Lucian-ming/smart-fans/artifacts/mechanical_joint_review.md

# 实物模块—PCB—三件罩壳联合审计

**结论：不能确认现有完整罩壳能容纳并正常连接全部清单实物；当前仅裸板/局部几何合格，禁止把它作为满载装配通过或直接量产依据。** 本次只读生产源与产物，新增审计脚本/数据/本报告，没有修改两生成器。2026-11-04。

## 1. 证据与复算边界

- 实物依据：[用户清单](<../docs/hardware/user_modules.md>)，不是凭网络同名模块补齐尺寸。已读关联[引脚表](<../docs/hardware/pinmap.md>)、[BOM](<../docs/hardware/bom.md>)、[旧外壳文档](<../docs/mechanical/casing-design.md>)、[旧装配规范](<../mechanical/drawings/assembly_spec.md>)。
- 当前真值：[PCB生成器](<../tools/build_perfect_revB_v3.py>)、[机械生成器](<../tools/build_authentic_smartfan_cad.py>)、[实际PCB](<../hardware/kicad/fan_ctrl_revB.kicad_pcb>)及三个最新STL。未导入/执行生产生成器。
- [只读审计脚本](<audit_mechanical_joint.py>)通过sexpdata解析实际PCB全部47器件并断言其坐标与生成器一致；trimesh独立读取三件STL、射线净空及支架旋转半径。已成功运行，exit 0仅表示审计计算完成，**不是装配PASS**。[完整数值及SHA256](<mechanical_joint_review_data.json>)。
- 坐标均为壳体装配坐标：PCB局部坐标+（2,2），主板底Z6.5、顶Z8.1。STL下壳Z0..9、盖Z8.1..32；支架仍局部坐标Z0..24，没有定义其在整机上的刚体变换。
- [下壳](<../mechanical/stl/print/SmartFan_Piece1_Base_Enclosure.stl>)24.369847394cm³、[盖](<../mechanical/stl/print/SmartFan_Piece3_Removable_Lid.stl>)27.979158745cm³、[支架](<../mechanical/stl/print/SmartFan_Piece2_Fan_Gimbal_Bracket.stl>)16.621909456cm³，合计68.970915595cm³；均水密。**拓扑和材积不证明内部实物配合。**

## 2. 已确认的规格/设计矛盾（优先解决）

1. **TB6612供电与资产清单不一致**：清单写VM12V、VCC5V，而实际J_TB_R pin1=+5V，pin2=+3.3V；C_VM也在+5V。它可能是另一套低压130方案，但不能声称满足用户当前12V描述。先确认电机铭牌和驱动板型号，不能仅依据“130”推定额定电压。
2. **连续舵机不等于位置舵机**：清单明确MG90S 360°连续旋转、PWM控制速度；旧引脚表却宣称0°~90°位置扫风。当前没有位置反馈、限位或滑环证据；依定时正反转不能保证长期角度边界，可能绞线。必须选择位置型或补反馈/限位方案。
3. **12025备选不适用当前支架**：当前只有20.4×15.4的130腔、3mm出轴孔、84×30支架，没有12025四孔框架。旧六件规范中的12025支架不属于当前三件，不能混用。
4. **USB不在后壳开口附近**：BluePill双排座中心(49.5,42)，按53.3×22.8居中名义包络，板Y15.35..68.65、X38.1..60.9。后板缘距内后壁13.75mm；后USB孔中心(49.5,1,8)，高范围Z4.75..11.25。主板顶已Z8.1，上面还有排母、子板、USB座。没有连接器相对板缘位置、堆叠高度、USB延长线/面板座证据，不能把该孔称为可插拔的真实USB通道。
5. **舵机与BluePill投影重叠**：舵机槽X37.9..61.1、Y28.7..41.3，几乎完全覆盖上述BluePill板宽，Y也在其板上。只有上下分层可能避碰；当前未给舵机安装耳→底部/轴顶及BluePill最高元件Z，故不能确认无干涉。槽切到Z24只是切削体，不是舵机只下探到24的证据。
6. **按钮15mm高度没有确定装配基准**：要求直插排母的子模块PCB底一般高于主板顶，不能无依据令其等于Z8.1。当前1.35mm露出仅是在模块底恰好Z8.1且竖直轴、孔中心这一条件下成立。

## 3. 插座、模块包络与净空逐项

|模块|有依据的尺寸/实际接口（壳坐标）|判定及缺少证据|
|---|---|---|
|BluePill|清单约53.3×22.8；2×20针，pitch2.54、排距15.24；实际座X41.88/57.12，Y42中心，沿Y跨48.26|针距/排距符合清单，但板边到首针、USB位置和堆叠高度未知。条件居中前角(60.9,68.65)盖内面Z22.428146，相对母板顶只剩14.328146mm给排母+子板+最高件；后部净高21.9mm。舵机重叠优先核查。|
|ASR-PRO|清单30×28×2.9、2×7P；实际座X72.88/88.12、Y27.5，排距15.24，沿Y针跨度15.24|清单未提供排距和首针到板边，30×28不证明15.24排距正确。若长边沿X居中则X65.5..95.5、距右内壁仅1.9mm；若沿Y则不同。中心盖内面Z30，名义净高21.9；2.9是否含最高元件/针头未知。SPK/MIC插座在右侧，须检查线插头与子板叠层。|
|PAJ7620|清单20×15、5针2.54；J_GESTURE中心(18,76)，1..5=3V3/GND/SCL/SDA/INT；窗中心也(18,76)|电气次序符合清单（以编号为序，不证明实物正反方向）。排针通常在模块边，不等于光学透镜中心；尚无针排→镜头偏移。只有20×15平面轮廓不足以证明镜头正对孔或不被壁遮光；没有支撑/固定点。|
|DHT11|3针，实际(17.5,57)，3V3/DATA/GND|尺寸/高度未知；该点盖内Z27.860630，净高19.760630。壳未为其设置专门通风/热隔离结构，封壳内部测温不等于环境温度；与降压/电机热源耦合需验证。|
|OLED|仅0.96英寸和4针，没有模块外形/玻璃/针排相对有效显示区尺寸；座(80.5,57)，GND/3V3/SCL/SDA|实际窗中心(80.5,64)，投影相差Y7mm；不能据同名尺寸认定有效区对正。需要模块定位支架、连线与安装角，详见下一节。|
|EC11|清单只有5P次序；座(73,84.5)，GND/3V3/SW/B/A；孔中心(73,88)|电气次序符合清单，轴与针排须实际Y偏移3.5mm才按中心投影对准；模块宽高、轴长/径、螺纹肩、螺母、旋钮帽均未知。|
|KEY1/2|用户只提供模块底→帽顶15mm；座(36/51.5,84.5)，GND/SIG/3V3；孔(36/51.5,86)|需要帽中心距排针1.5mm的实际偏移、帽径、行程和模块高度基准。清单允许2P/3P，但主板是3P，不能任意插2P而不核对顺序。|
|TB6612|仅双8P；实际X9.88/25.12、Y38，排距15.24、针跨度17.78|清单未给模块外形和排距；“SparkFun/CJMCU”注释不能证明用户变体一致。需实物针序/机械图，并解决5V/12V矛盾。|
|喇叭/咪头|8Ω2W不等于外形；SPK1(92,16.5)，MIC1(92,22)|咪头孔在(92,88)，不是插座正上方，必须线接并固定；无咪头支架。喇叭无腔体尺寸、固定仓和专用导音口，不能核容纳或声学性能。|
|NTC/DS18B20备选|清单写兼容3P|当前未见专用该位号插座；J_DHT11是数字DATA和3V3/GND，不能自动认作NTC模拟输入。选定后核针序/电路/固件。|

### DC与线插拔

- DC1实际封装原点(17,10)，后壁圆孔中心X17、Z10、直径8.2；**X一致不证明接口轴高一致**。PCB用手写3个圆焊盘，且“标准模型引用”没有模型实际装配尺寸证据；须核DC-005实际脚位、轴高、插头肩部外径、伸出/缩入量。
- XH插座SPK1/MIC1中心仅相距5.5mm；针排各跨2.54，最近相邻针间2.96mm。塑壳宽、锁扣和拔插手指空间未建模，不能依据焊盘不碰就判插座不碰。MOTO1与SERVO1等同理。BOM的SERVO弯针与footprint Vertical亦未自洽。
- 盖闭合后模块垂直拔出路径会被盖阻挡，这通常允许“先拆盖再拔模块”，但仍须验证已插线、线束弯曲半径、盖提起行程、四颗长螺钉工具通道；现有裸板扫掠不能覆盖这些。
- 两排母仅用标准PinHeader模型引用、原点/居中针排也不同于标准库的首针原点习惯；不能用当前3D引用当完整实物封装。没有可复用的精确实物STEP装配。

## 4. 25°坡面与竖直安装不是同一种方向

- 主坡外面z=31−tan25°(y−55)，2mm为法向厚度。OLED窗中心Z26.803231；EC11孔中心Z15.611847；孔沿13.731074mm是塑料孔沿，不是OLED模块到旋钮帽的距离。
- OLED窗按坡面法向切削，若显示模块水平直插，显示面并不平行窗面；若显示板跟随25°坡面，直排针无法无转接直接垂直插母板。必须选择倾斜安装支架+软线/转接，或提供弯针详细几何。窗口宽28、面内高16.5不代表任意0.96英寸模块全外形能穿过。
- EC11孔轴按坡面法向倾斜25°，而水平子板上的旋钮轴可能竖直。穿过法向2mm壁时斜孔上下边横向漂移约2sin25°=0.845mm，不能只拿孔9mm与轴径比较；轴、套筒、螺母面和旋钮下缘必须做实体干涉。其竖直轴若正好穿外面中心，内层中心投影并不相同。
- 按钮孔已改竖直、局部坡面中心Z21.75。假设帽顶水平Z23.1，仅孔中心露出1.35；对半径r的平帽，其两侧露出范围为1.35±r·tan25°。例如**仅用于说明、不是实物尺寸**若r=3.5mm，范围约−0.282..2.982mm，不能宣称整帽都露出1.2..1.5mm。必须给帽径、肩部、行程与想采用的露出量定义。

## 5. 支架与旋转运动包络

- 独立读取支架网格，以十字槽中心局部(42,15)为假设转轴：打印件本体全转最大半径44.598206mm、回转直径89.196412mm。若（仍是假设）轴恰在顶槽中心(49.5,35)，360°XY包络为X4.901794..94.098206、Y−9.598206..79.598206；会越过壳后缘约9.60mm。**越过投影不直接等于碰撞**，须结合真实轴顶Z与壳、USB/DC插线位置。
- MG90S输出轴通常不应无证据假定在壳体几何中心，当前未给轴偏心、舵盘厚度、齿数/花键与锁螺钉；没有支架整机Z与角度变换，故无法做真实旋转碰撞测试。
- 上述半径只含打印件，不含电机、扇叶、护网、导线和旋钮。未给扇叶直径、轴伸出和旋转平面，不可宣称安全无干涉；也没有手指防护罩与动态载荷验证。
- 当前电机仓截面20.4×15.4、切削深25，出轴中心局部(42,27,15)、孔3mm；“130”只是系列外形称呼，不证明端盖、接线片、轴长相符。十字槽残底0.5mm、无强度定级，且电机夹持/止退方案未完成。

## 6. 最少需要用户补充的六组问题

可用**实物正反/侧面带尺照片 + 商家准确链接**一次性答复；无需逐个手抄全部尺寸。只有链接而变体不明仍需量关键尺寸。

1. **最终动力方案**：到底130还是12025？电机额定电压、机身和轴伸出、扇叶直径/护网尺寸；MG90S是可定位角度型还是已确认360连续型，是否接受更换位置型或增加反馈？
2. **所有直插子板的实际针排基准**：BluePill、ASR-PRO、TB6612的准确型号/正反面针序、板长宽、排距、首针距板边；母座型号/插合后子板底到主板顶高度（一次侧面照片可覆盖多个）。ASR的2.9mm是否为全高？
3. **OLED、EC11、PAJ的正侧面**：针排到屏有效区中心/编码器轴/光学镜头中心的XY偏移；模块外形和最高件；OLED希望贴25°坡面还是水平直插；EC11轴径/轴长、螺纹肩与旋钮帽直径/高。
4. **两个按钮**：2P还是3P及针序，模块长宽、帽直径/中心到针排距离、行程；15mm的两测量端点照片，插好后模块底实际Z。确认露出要求针对中心还是全帽最低边。
5. **声学和环境模块**：喇叭腔体长宽高/出线口、咪头直径长与安装方式、DHT11模块尺寸；是否允许外壳增加通风/导音和固定结构。NTC/DS18B20是否真的本次装入？
6. **外部连接与舵机基准**：USB型号/插头外壳尺寸、是否接受面板延长线；DC座准确实物；MG90S安装耳孔距、耳平面到底/轴顶、输出轴相对壳的位置、舵盘形状与外径。线束插头和余量可用插好后的照片标注。

## 7. 后续工程门禁（非本次修改授权）

先冻结实物变体和安装方向 → 建真实模块/插合连接器包络及安装基准 → 修正母座位置/电源方案和机械固定点 → 满载闭盖碰撞、装入/拔出扫掠、舵机全工作角运动与线束扫掠 → 再重新检查70cm³、最小壁厚/强度、PCB电气DRC和实物样装。不能用继续缩壳或假设典型尺寸来跳过尺寸确认。

旧文档仍描述双件66.61cm³、OLED Y60/EC11 Y86或六件12025方案，与当前三件不一致；BOM尾部还残留“All Parts Stocked”而顶部否认已验证现货。应在下一次获授权修改时同步纠正，不作为本次装配证据。
