Lucian-ming/smart-fans/docs/02-architecture.md

# 系统架构

> 版本：v0.5（电脑 12025 机箱风扇 + MG90S 舵机 + ASR-PRO 免唤醒语音 + PAJ7620 手势 + EC11 连续调速 + 蓝板主控） · 2026-11-03

---

## 1. 总体电气框图

```
                       ┌─────────────────────────────────────────┐
                       │          12V 2A DC 供电适配器            │
                       └───────────────────┬─────────────────────┘
                                           │ 12V
                 ┌─────────────────────────┴────────────────────────┐
                 │ 12V                                              │ 12V (持续供电)
                 ▼                                                  ▼
     ┌───────────────────────┐                         ┌─────────────────────────┐
     │ XL1509-5.0 贴片 DCDC   │                         │ 12025 电脑机箱风扇      │
     │ 12V → 5V @ 2.0A 峰值  │                         │ (Pin1: GND, Pin2: 12V)  │
     └───────────┬───────────┘                         └────────────▲────────────┘
                 │ 5V                                               │
         ┌───────┴───────────────────────┐                          │
         ▼                               ▼                          │
┌──────────────────┐           ┌──────────────────┐                 │
│ ASR-PRO 离线语音  │           │ AMS1117-3.3 LDO  │                 │
│ + 8Ω 2W 腔体扬声器│           │ 5V → 3.3V @ 1.0A │                 │
└────────┬─────────┘           └─────────┬────────┘                 │
         │ UART2 (115200)                │ 3.3V                     │
         │                               ├──────────────────────────┼──────────────┐
         ▼                               ▼                          ▼              ▼
┌──────────────────────────────────────────────────────────────────────────────────┐
│                   STM32F103C8T6 最小系统核心板（蓝板插座形式）                    │
│                                                                                  │
│   PA0 (TIM2_CH1)  ──▶ 25.0 kHz 高频静音 PWM (Pin4: 控制 0%~100% 占空比)           │
│   PA8 (TIM1_CH1)  ◀── FG 测速脉冲输入捕获 (Pin3: 4.7k 上拉，测量真实 RPM / 堵转) │
│   PA1 (GPIO_OD)   ◀─▶ DS18B20 单总线数字测温 (4.7k 上拉)                          │
│   PB8 (TIM4_CH3)  ──▶ MG90S 舵机 50Hz PWM 控制 (45° / 90° 自动扫风与平滑摆动)    │
│   PB6 (I2C1_SCL)  ──▶ 0.96" OLED (0x3C) + PAJ7620U2 手势模块 (0x73)              │
│   PB7 (I2C1_SDA)  ◀─▶ 共用 I2C1 硬件总线 (板载 4.7kΩ 上拉)                       │
│   PA4 (EXTI4)     ◀── PAJ7620U2 中断信号 (低电平触发唤醒)                        │
│   PA6 / PA7       ◀── EC11 旋转编码器 A/B 相 (TIM3 硬件正交解码，无级调速)       │
│   PB12 (GPIO)     ◀── 旋钮中键按压：电源开关 (Power On/Off)                      │
│   PB13 (GPIO)     ◀── 独立按键 1：模式切换（手动无级 ↔ 自动温控）                │
│   PB15 (GPIO)     ◀── 独立按键 2：摇头控制（停止 / 45° 扫风 / 90° 扫风）         │
│   PB0  (GPIO)     ◀── 独立按键 3：辅助功能（提示音静音 / 定时关机）              │
│   PB14 (GPIO)     ──▶ 蜂鸣器驱动 (S8050 NPN 放大，短嘀确认与连续故障报警)        │
│   PA9 / PA10      ◀─▶ 调试串口 USART1 (115200 日志打印与上位机)                  │
└──────────────────────────────────────────────────────────────────────────────────┘
```

---

## 2. 软件运行模式与状态转移机

```
                        ┌──────────────┐
       ┌───────────────▶│     IDLE     │◀──────────────┐
       │                │  (关机休眠)   │               │
       │  关机手势/按键  └──────┬───────┘ 关机指令/手势 │
       │                        │                       │
       │           开机指令/手势/│旋钮按压               │
       │                        ▼                       │
       │                ┌──────────────┐                │
       │        ┌──────▶│    MANUAL    │◀──────┐        │
       │        │       │  (手动无级)  │       │        │
       │        │       └──────┬───────┘       │        │
       │  切手动 │              │ 切自动        │ 切手动 │
       │  指令/按键            ▼ 指令/按键     │ 指令/按键
       │        │       ┌──────────────┐       │        │
       │        └───────│  AUTO_TEMP   │───────┘        │
       │                │  (智能温控)  │                │
       │                └──────┬───────┘                │
       │                       │                        │
       │                       │ FG 连续 3s 无脉冲      │
       │                       ▼ (堵转故障)              │
       │                ┌──────────────┐                │
       └────────────────┤    FAULT     ├────────────────┘
                        │ (停机断电告警)│
                        └──────────────┘
```

### 微光时钟防烧屏状态机：
- 在 `MANUAL` 或 `AUTO_TEMP` 下正常运行：
  - 界面显示：当前温度、PWM%、FG 实时转速、工作模式、摇头状态；
  - 计时器检测到持续 30 秒无任何用户操作（旋钮、按键、手势、语音），自动进入 **微光时钟模式**：
    - 调用 SSD1306 `SetContrast(0x05)` 调至最低对比度微光；
    - 屏幕刷新频率降为 1 Hz，仅居中显示大数字时钟与环境温度；
  - 一旦触发任何操作（手势/语音/按键），在 20ms 内恢复全功能高亮仪表盘。
