Lucian-ming/smart-fans/docs/hardware/pinmap.md

# 引脚分配与外设映射表 (Rev B4)

> 版本：v4.0（STM32F103 蓝板主控 + TB6612FNG 130直流电机驱动 + MG90S 舵机 + ASR-PRO 免唤醒语音 + PAJ7620 手势 + EC11 编码器 + 2 个带帽大按键 + 0.96" OLED + DHT11 温湿度）
> 主板规格：**95.0 × 95.0 mm（R=3.0 mm 圆角，85.0 × 85.0 mm M3 安装孔距，嘉立创免费券合规）**
> 主控方案：**STM32F103C8T6 最小系统核心板（双排 2.54 排母直插，USB 朝北/后）**
> 外设分配原则：**定时器零冲突，硬件正交编码器 (TIM3)、舵机 50Hz PWM (TIM4)、130 电机 25kHz PWM (TIM2)、ASR-PRO 语音 (USART2)、I2C1 总线 (PB6/PB7) 各占独立硬件资源，零插接短路风险**。

---

## 1. 完整引脚分配映射表

| 功能模块 | 信号标识 | 核心板引脚 | 硬件复用特性 | 方向 | 电气特征与外围电路说明 |
| :--- | :--- | :--- | :--- | :--- | :--- |
| **130 电机调速** | `TB_PWMA` | **PA0** | TIM2_CH1 | 输出 | 25.0 kHz 高频静音 PWM 驱动 TB6612 PWMA 引脚 |
| **130 电机转向 1** | `TB_AIN1` | **PA1** | GPIO | 输出 | 控制电机正反转/制动 |
| **130 电机转向 2** | `TB_AIN2` | **PA5** | GPIO | 输出 | 控制电机正反转/制动 |
| **TB6612 使能** | `TB_STBY` | **PB0** | GPIO | 输出 | 高电平工作，板载 10kΩ 下拉电阻保证上电静止 |
| **左右摇头舵机** | `SERVO_PWM` | **PB8** | TIM4_CH3 | 输出 | 50 Hz 伺服舵机脉冲（0.5~2.5ms 占空比） |
| **OLED/手势时钟** | `I2C1_SCL` | **PB6** | I2C1_SCL | 输出 | 0.96" OLED (0x3C) 与 PAJ7620U2 (0x73) 共用，板载 4.7kΩ 上拉 |
| **OLED/手势数据** | `I2C1_SDA` | **PB7** | I2C1_SDA | 双向 | 共用 I2C1 总线，板载 4.7kΩ 上拉至 3.3V |
| **手势中断检测** | `GEST_INT` | **PA4** | EXTI4 (GPIO) | 输入 | PAJ7620U2 开漏中断输入，下降沿触发 |
| **EC11 旋转编码器** | `ENC_A` | **PA6** | TIM3_CH1 | 输入 | 硬件正交编码器模式 A 相 |
| **EC11 旋转编码器** | `ENC_B` | **PA7** | TIM3_CH2 | 输入 | 硬件正交编码器模式 B 相 |
| **旋钮按键(已弃用)** | `ENC_SW` | **PB12** | - | 留空 | Rev B4 采用无按键 5 脚编码器，PB12 严格未启用且悬空 |
| **大按键 1（电源）** | `KEY1_SIG` | **PB13** | GPIO (Pull-Up)| 输入 | 独立大按键 1：风扇启停 / 唤醒 |
| **大按键 2（摇头/模式）** | `KEY2_SIG` | **PB14** | GPIO (Pull-Up)| 输入 | 独立大按键 2：短按控制摇头，长按切换模式（手动/自动温控） |
| **有源蜂鸣器驱动** | `BUZZER_CTRL`| **PB15** | GPIO | 输出 | 经 1kΩ 限流电阻驱动 2N3904 NPN 三极管，并联 1N4148 续流保护 |
| **DHT11 温湿度** | `DHT11_DATA` | **PB9** | GPIO (OD) | 双向 | DHT11 单总线数据通信，板载 4.7kΩ 上拉至 3.3V |
| **离线语音发送** | `VOICE_TX` | **PA2** | USART2_TX | 输出 | 发送控制应答给 ASR-PRO 触发语音播报 (115200 8N1) |
| **离线语音接收** | `VOICE_RX` | **PA3** | USART2_RX | 输入 | 接收 ASR-PRO 识别到的免唤醒词条字符串 (115200 8N1) |
| **调试串口 TX** | `DEBUG_TX` | **PA9** | USART1_TX | 输出 | 固件调试日志打印 (115200 8N1) |
| **调试串口 RX** | `DEBUG_RX` | **PA10** | USART1_RX | 输入 | 串口命令交互 |
| **板载心跳 LED** | `LED_STATUS` | **PC13** | GPIO | 输出 | 蓝板板载 LED，低电平点亮，系统运行心跳指示 |

---

## 2. 定时器与外设分配无冲突审查

- **TIM2 (通用定时器)**：专职于 `PA0` 产生 **25.0 kHz** 标准高频 PWM 驱动 130 电机，无音频啸叫。
- **TIM3 (通用定时器)**：专职于硬件正交编码器解码模式 (`PA6`/`PA7`)，硬件自动增减计数器，旋钮调速零延迟。
- **TIM4 (通用定时器)**：专职于 `PB8` 产生 **50 Hz (周期 20ms)** 标准脉冲，驱动 MG90S 舵机 0°~90° 平滑扫风。
- **I2C1**：`PB6`/`PB7` 挂载 OLED (`0x3C`) 与 PAJ7620U2 (`0x73`)，从机地址完全隔离，板载独立 4.7kΩ 上拉电阻。
- **USART2**：专职于 `PA2`/`PA3` 与 ASR-PRO 离线语音芯片全双工通信。
