Lucian-ming/smart-fans/docs/hardware/power-budget.md

# 功耗预算与 200 元成本控制方案

> 版本：v0.4（12V 4-Pin 电脑机箱风扇 + MG90S 舵机 + ASR-PRO 2W 语音播报 + 蓝板主控）
> 报销限额：**≤ 200.00 元人民币**（本案测算总物料与加工成本约为 150 ~ 160 元）

---

## 1. 电气功耗预算表（最严苛工况）

各电压域负载与瞬态峰值分析（确保降压电路温升适度、不跌落复位）：

### 12 V 域（外部输入适配器 12V / 2A）
| 负载单元 | 额定工作电流 | 启动/峰值电流 | 说明 |
| :--- | :--- | :--- | :--- |
| 12025 PWM 机箱风扇 | 0.20 A | 0.45 A（启转瞬态） | 12V 标称约 2.4W，PWM 25kHz 调速，直接取自 12V 稳压总线 |
| XL1509-5.0 降压输入 | 0.28 A | 0.65 A（舵机+喇叭齐发） | 按 82% 转换效率由 5V 域折算至 12V 侧 |
| **12V 域总计** | **~0.48 A** | **~1.10 A** | **选用 12V 2A（24W）适配器，具备近 1 倍功率余量** |

### 5 V 域（由 XL1509-5.0 开关稳压提供，最大能力 2.0A）
| 负载单元 | 典型工作电流 | 瞬态峰值电流 | 说明 |
| :--- | :--- | :--- | :--- |
| ASR-PRO 语音核心板 | 30 mA | 60 mA | 内部离线 NPU 算力功耗 |
| 8Ω 2W 腔体扬声器 | 150 mA | 450 mA | 播放高分贝应答语音时的瞬态脉冲，需配 220µF 储能电解 |
| MG90S 金属齿轮舵机 | 100 mA | 350 mA | 左右往复摆动与转向负载峰值 |
| AMS1117-3.3 输入 | 70 mA | 90 mA | 供应 3.3V 逻辑域 |
| **5V 域总计** | **~0.35 A** | **~0.95 A** | **XL1509 额定 2A 连续能力完全胜任，温升 < 25℃** |

### 3.3 V 域（由 AMS1117-3.3 SOT-223 提供，额定 800mA ~ 1A）
| 负载单元 | 典型工作电流 | 瞬态峰值电流 | 说明 |
| :--- | :--- | :--- | :--- |
| STM32 核心板 @72MHz | 36 mA | 45 mA | 核心时钟与各定时器全开 |
| 0.96" I2C OLED | 18 mA | 25 mA | 128×64 满屏白色点阵 |
| PAJ7620U2 手势传感器 | 10 mA | 15 mA | 红外发射管与光学引擎工作 |
| DS18B20 温度传感器 | 1.0 mA | 1.5 mA | 12 位温度转换时 |
| 蜂鸣器驱动基极 | 3 mA | 5 mA | S8050 基极偏置限流 |
| **3.3V 域总计** | **~68 mA** | **~92 mA** | **AMS1117 压差 1.7V，功耗仅 0.15W，SOT-223 几乎无温升** |

---

## 2. 200 元预算分配与采购核算清单

| 类别 | 采购项目 | 规格型号 / 推荐渠道 | 数量 | 预估单价 (元) | 报销分类依据 |
| :--- | :--- | :--- | :--- | :--- | :--- |
| **电子主板** | STM32 蓝板核心板 | STM32F103C8T6（淘宝/立创） | 1 块 | 9.00 | 主控套件 |
| **电子主板** | PCB 定制打样 | 嘉立创双层板（每月免费券抵扣） | 5 片 | 0.00（含运费约 10） | PCB 板卡加工 |
| **板载器件** | 贴片 DCDC + LDO | XL1509-5.0 + AMS1117 + 电感二极管 | 1 套 | 6.00 | 电子元件 |
| **板载器件** | 接插件与阻容 | DC005、4P 风扇座、排母、EC11 旋钮 | 1 套 | 8.50 | 电子元件 |
| **核心模块** | 离线语音套件 | ASR-PRO 模块 + 8Ω 2W 腔体小喇叭 | 1 套 | 16.00 | 传感器/语音模块 |
| **核心模块** | 手势识别小板 | PAJ7620U2 原相红外手势模块 | 1 块 | 18.00 | 传感器模块 |
| **核心模块** | OLED 液晶屏 | 0.96 寸 I2C 12864 蓝光/白光屏 | 1 块 | 8.50 | 显示器件 |
| **核心模块** | 数字温度传感器 | DS18B20 直插 TO-92（或引出探头） | 1 只 | 2.50 | 传感器器件 |
| **执行机构** | 电脑机箱风扇 | 12025 12V 4-Pin PWM 风扇（利民/工控）| 1 个 | 18.00 | 风扇电机 |
| **执行机构** | 摆头舵机 | MG90S 金属齿轮 9g 舵机 | 1 个 | 11.00 | 机械执行器 |
| **外设电源** | 供电适配器 | 12V 2A DC 5.5×2.1 电源适配器 | 1 个 | 13.00 | 配套电源 |
| **外壳加工** | 3D 外壳代打 | 嘉立创三维猴 / 淘宝代打（8000 树脂/PETG）| 1 套 | 40.00 | 结构件外协 |
| **螺丝辅料** | 装配螺丝螺母 | M3×30（固定风扇）+ M2 自攻螺丝包 | 1 套 | 4.00 | 机械五金 |
| **总计预估** | — | — | — | **~156.50 元** | **总费用在 200 元内有约 43 元结余** |
