Lucian-ming/smart-fans/docs/hardware/user_modules.md

# 用户实物模块与传感器资产清单 (User Hardware & Sensor Inventory)

> **记录时间**：2026-11-04  
> **文档说明**：本文档专门用于归档与跟踪用户明确持有、已购及指定的实物模块、传感器与人机交互部件。底板 PCB、3D 外壳及固件引脚分配均以此清单规格为物理与电气基准。

---

## 一、传感器模块 (Sensors)

| 序号 | 传感器名称 | 具体型号 / 规格 | 物理尺寸 / 引脚定义 | 接口类型与电气特性 | 作用与装配要求 |
| :---: | :--- | :--- | :--- | :--- | :--- |
| **1** | **手势识别传感器** | **PAJ7620 / PAJ7620U2** 红外手势模块 | **20 × 15 mm**<br>5-Pin (2.54mm 排针直插):<br>`VCC, GND, SCL, SDA, INT` | I2C 通信 (`0x73`)<br>+ 外部下降沿中断 (`PA4`)，3.3V 供电 | 识别 9 种非接触光学手势（上下调速、左右摇头、推拉开关）；传感器镜头需探出 3D 外壳仰角面板，不可遮挡 |
| **2** | **温湿度传感器** | **DHT11** 温湿度传感器模块 | 3-Pin (2.54mm 排针直插):<br>`VCC, DATA, GND` | 单总线通信 (`PB9`)，板载 4.7kΩ 上拉电阻，3.3V/5V 供电 | 采集环境温度与湿度，支撑智能闭环温控（自动启停/变速）；置于主板独立插座，感知外部气温 |
| **3** | **备用温度传感器** | **热敏电阻传感器 (NTC) / DS18B20** | 3-Pin 兼容直插焊盘 | 单总线 / 模拟量接口 | 作为温控备选方案记录在案 |
| **4** | **旋钮传感器/输入** | **EC11** 360° 旋转编码器 | 5-Pin (2.54mm 接口):<br>`GND, 3V3, SW, B, A` | 正交编码器 A/B 相 (`PA6/PA7` TIM3 硬件解码) + 中键开关 (`PB12`) | 顺时针/逆时针无级平滑风速调节（0%~100% PWM）；轴体穿出外壳面板，配合铝合金旋钮帽 |

---

## 二、人机交互与控制核心模块 (HMI & Core Modules)

| 序号 | 模块名称 | 具体型号 / 规格 | 物理尺寸 / 引脚定义 | 接口类型与供电 | 作用与装配要求 |
| :---: | :--- | :--- | :--- | :--- | :--- |
| **5** | **主控核心板** | **STM32F103C8T6 最小系统板 (BluePill 蓝板)** | 标称约 53.3 × 22.8 mm<br>双排 20P ($2 \times 20\text{P}$，间距 2.54mm，排间距 15.24mm) | 直插主板双排母；双 3.3V/5V/GND 电源冗余通道 | 整机主控中枢，USB-C/Micro 接口朝后，免去 QFP48 密脚手工焊接 |
| **6** | **显示屏幕** | **0.96 寸 I2C OLED 显示屏** | 4-Pin (2.54mm 弯针/直插):<br>`GND, VCC, SCL, SDA` | I2C 通信 (`0x3C`)，与 PAJ7620 共用 PB6/PB7 总线，3.3V 供电 | 分辨率 128×64，实时显示温度、转速、挡位、摇头状态与微光时钟；屏幕窗口露出于外壳 25° 仰角面板 |
| **7** | **离线语音识别板** | **ASR-PRO 核心开发板 (带喇叭咪头款)** | **30 × 28 × 2.9 mm**<br>双排 7P（共 14 针脚，间距 2.54mm） | UART 串口全双工通信 (`USART2`, `PA2/PA3`)；5V 供电 | 离线免唤醒语音识别词条直接响应，外接扬声器播报应答；板载直插母座固定 |
| **8** | **扬声器与咪头** | **8Ω 2W 腔体扬声器 + 高敏驻极体咪头** | 喇叭 XH2.54-2P 插头<br>咪头 XH2.54-2P 插头 | 语音模块专用音频推挽输出 / 差分偏置输入 | 语音指令采集与语音播报播放 |
| **9** | **独立控制大按键** | **带帽轻触大按键 (KEY1 / KEY2)** | 3-Pin / 2-Pin 直插排母 | GPIO 下拉按压输入 (`PB13`, `PB14`)，低电平有效 | KEY1 为风扇总电源启停；KEY2 短按控制摇头、长按切换模式；键帽贯穿前面板开孔 |

---

## 三、执行机构与电机驱动 (Actuators & Drivers)

| 序号 | 模块名称 | 具体型号 / 规格 | 物理接口 / 引脚定义 | 电气特性 | 作用说明 |
| :---: | :--- | :--- | :--- | :--- | :--- |
| **10** | **电机驱动模块** | **TB6612FNG 双路直流驱动模块** | 双排 8P 直插排母 (16 针脚):<br>控制排 (PWMA, AIN1, AIN2, STBY 等)<br>动力排 (VM, VCC, GND, AO1, AO2 等) | VM 供电接 12V 动力轨，5V 逻辑供电；高频 25.0kHz PWM 静音驱动 (`PA0`) | 驱动 130 直流吹风电机，具备硬件正反转与制动能力 |
| **11** | **摇头伺服机构** | **MG90S 金属齿轮舵机 (360° 连续旋转款)** | 3-Pin 防呆插针 (2.54mm):<br>`GND, +5V, PWM` | 50 Hz 伺服脉冲 (`PB8` TIM4_CH3)；注意 360° 舵机通过 PWM 占空比控制正反转速度与方向 | 带动风扇风头做左右扫风摆动 |
| **12** | **主风扇动力源** | **130 直流微型电机 (或 12025 机箱风扇)** | XH2.54-2P 压线母端 / 4-Pin 接口 | 12V 动力直驱 | 吹风风道主动力源 |

---

## 四、关联映射与代码索引

- **硬件引脚对应表**：[pinmap.md](file:///d:/smart_fans/docs/hardware/pinmap.md)
- **立创物料采购与母座料号**：[bom.md](file:///d:/smart_fans/docs/hardware/bom.md)
- **固件底层宏定义**：[pins.h](file:///d:/smart_fans/firmware/src/config/pins.h)
- **PCB 母座直插封装**：[fan_ctrl_revB.kicad_pcb](file:///d:/smart_fans/hardware/kicad/fan_ctrl_revB.kicad_pcb)
