Lucian-ming/smart-fans/docs/mechanical/casing-design.md

# 智能风扇 3D 外壳与机械结构设计方案 (Mechanical & Casing Design)

> 版本：Rev B4 · 日期：2026-11-04
> 目标工件：**立式桌面台扇**（底座 + 25° 舒适仰角前面板 + MG90S 舵机摆头立柱 + 130 直流电机扇叶支架）
> 成本控制：**严格限制总重量在 85 ~ 100g 以内**，确保嘉立创三维猴 / 淘宝 3D 打印（8000 树脂/PETG）满足 **≤70.00 cm³ 免费打样券** 或代打费用在 **35 ~ 42 元** 之间，严守 200 元总预算红线。

---

## 一、机械整体装配架构 (Exploded View Concept)

```
                     ┌───────────────────────────────┐
                     │   130 直流电机 + 3叶/4叶扇叶   │  (轴径 2.0 mm)
                     └───────────────┬───────────────┘
                                     │ 紧配合压入
                                     ▼
                     ┌───────────────────────────────┐
                     │ Piece 2: 130电机云台支架      │  (84×30×24 mm, 实测 23.13 cm³)
                     └───────────────┬───────────────┘
                                     │ 底部压配 MG90S 舵盘十字槽 (左右 0°~90° 自动摆头)
                                     ▼
                     ┌───────────────────────────────┐
                     │ MG90S 金属齿轮 9g 舵机        │
                     └───────────────┬───────────────┘
                                     │ 嵌入式安装并锁固于顶板沉槽
 ┌───────────────────────────────────┴───────────────────────────────────┐
 │ Piece 1: 底座主壳体 (99 mm × 99 mm × 32 mm，实测 43.48 cm³)           │
 │                                                                       │
 │ • 内部底面：4 根 M3 铜柱/自攻定位柱 (对齐 85×85 mm PCB 的 4 孔)         │
 │ • 内部净高：30.0 mm (地板 2.0 mm + 柱高 4.5 mm + PCB 1.6 mm + 22 mm)  │
 │ • 后侧开孔：DC-005 电源插孔 (φ8.2 mm) + Micro-USB 调试口 (11×6.5 mm)   │
 │ • 顶板结构：MG90S 舵机安装槽 (23.2×12.6 mm) + 走线穿线口 + 固定螺丝孔  │
 │ • 前置面板：25° 舒适操作仰角 (有效采光及交互面积 > 5,800 mm²)          │
 │    - 0.96" OLED 视口开窗 (28.0 mm × 16.5 mm, 中心 X=80.5, Y=60.0)    │
 │    - PAJ7620U2 手势传感器圆孔 (φ10.0 mm, 中心 X=18.0, Y=76.0)        │
 │    - KEY1 电源微动按键孔 (φ7.0 mm, 中心 X=36.0, Y=86.0)               │
 │    - KEY2 摇头/模式按键孔 (φ7.0 mm, 中心 X=51.5, Y=86.0)              │
 │    - EC11 旋转编码器轴孔 (φ9.0 mm, 中心 X=73.0, Y=86.0)              │
 │    - 麦克风拾音微孔 (φ2.5 mm, 中心 X=92.0, Y=88.0)                   │
 └───────────────────────────────────┬───────────────────────────────────┘
                                     │ 4x M3×8 沉头自攻螺丝紧固
                                     ▼
                     ┌───────────────────────────────┐
                     │ 95.0 × 95.0 mm Rev B4 主控板   │  (安装孔中心距严格 85.0 mm)
                     └───────────────────────────────┘
```

---

## 二、关键配合尺寸与设计参数（精确对齐 PCB Rev B4）

### 1. PCB 安装孔与底座配合
- **主板外形**：95.0 mm × 95.0 mm（倒圆角 R=3.0 mm，嘉立创免费券 ≤100×100mm 合规）；
- **底座外形尺寸**：99.0 mm × 99.0 mm × 32.0 mm（严格满足三维猴 ≤100×100×100mm 免费券）；
- **底座内腔尺寸**：95.8 mm × 95.8 mm × 30.0 mm（单边留 0.40 mm 装配容差，PCB 顺畅滑入且不晃动）；
- **4 根定位支撑柱坐标**（中心距严格匹配 **85.0 mm × 85.0 mm**，对齐 PCB 四孔）：
  - 支撑柱中心坐标：`(7.0, 7.0)`, `(92.0, 7.0)`, `(7.0, 92.0)`, `(92.0, 92.0)`；
  - 螺柱外径：φ6.4 mm，高度 4.5 mm（将 PCB 垫高，避让背面过孔与引脚焊点）；
  - 螺孔内径：φ2.6 mm（适配 M3 自攻螺丝紧固）。

### 2. 25° 舒适仰角前面板开孔定位
底座前端采用 25° 斜切面（倾斜面总面积 5,836.8 mm²），所有切削圆柱体法向量严格设置为 `[-25.0, 0, 0]`，确保在倾斜面板上切出**正圆形开孔**（无 22mm 倾斜长槽）：
- **0.96" OLED 观察窗**：
  - 显示视口尺寸：`28.0 mm (W) × 16.5 mm (H)`，中心坐标 `(80.5, 60.0)`；
  - 与 PCB 上的 OLED 插座 (`Y=55.0 mm`) 空间投影完全对齐；
  - 与下方的 EC11 编码器开孔 (`Y=86.0 mm`) 保持 **17.35 mm 实体塑料隔离壁**，杜绝孔位贯通合并。
- **PAJ7620U2 手势光学开孔**：
  - 孔径：`φ10.0 mm` 圆形通孔，中心坐标 `(18.0, 76.0)`，正对手势感应芯片透镜。
- **独立大按键开孔**：
  - 2 个圆形按键通孔：`φ7.0 mm`，分别对应 KEY1（中心 `(36.0, 86.0)`，电源启停）与 KEY2（中心 `(51.5, 86.0)`，摇头/长按切模式）。
- **EC11 旋转编码器开孔**：
  - 穿轴孔径：`φ9.0 mm` 圆孔，中心坐标 `(73.0, 86.0)`，旋钮轴转动顺畅无干涉。
- **驻极体麦克风孔**：
  - 孔径：`φ2.5 mm`，中心坐标 `(92.0, 88.0)`，正对语音识别模块驻极体拾音咪头。

### 3. 动力与摇头机构
- **MG90S 舵机固定**：
  - 顶板腔体尺寸：`23.2 mm × 12.6 mm × 12.0 mm`，中心 `(49.5, 35.0)`，带 `10.0 × 5.0 mm` 走线槽与 2 颗 M2.5 螺丝孔（孔距 28mm）；
- **130 电机与扇叶支架 (Piece 2)**：
  - 外形尺寸：`84.0 mm × 30.0 mm × 24.0 mm`；
  - 130 直流电机安装仓：`20.4 mm × 15.4 mm × 25.0 mm` + φ3.0 mm 出轴孔；
  - 底部压配 MG90S 舵盘十字槽（`18.0 × 4.8 mm` 与 `4.8 × 18.0 mm` 十字相交，深 3.5 mm）。

---

## 三、三维猴免费券极致优化（双件实测数据）

| 零件编号 | 零件名称 | 核心设计规格 | 实测体积 (cm³) | Bounding Box (mm) | 判定 |
| :--- | :--- | :--- | :---: | :---: | :---: |
| **Piece 1** | 底座主壳体 | 99×99×32mm，内腔 95.8×95.8×30，85mm 孔距柱，25° 斜面板含 6 独立正圆孔 | **43.48** | 99.0 × 99.0 × 32.0 | ✅ PASS (≤100) |
| **Piece 2** | 云台与电机架 | 84×30×24mm，130 电机仓，底部十字舵盘槽，气动减重翅 | **23.13** | 84.0 × 30.0 × 24.0 | ✅ PASS (≤100) |
| **合计** | **双件打印套装** | **水密 2-Manifold，0 bad edges，0 normal flips** | **66.61** | **严格 ≤ 70.00 cm³** | ✅ **免费券 0 元兑现** |

> [!TIP]
> 双件合并体积为 **66.61 cm³**（严格低于 70.00 cm³ 嘉立创免费打样券额度上限），直接上传 `D:\下载\SmartFan_Sanweihou_3D_Print_Kit_2026-11-04.zip` 即可免费打样，完美守住 200 元整机预算红线！
