Lucian-ming/smart-fans/artifacts/report_pack/pack/00_先读我.md

# 智能风扇项目 · 电子工艺实习总结报告素材包

> 生成日期：2026-11-11　│　对应工程：`D:\smart_fans`　│　模板：`电子工艺实习总结报告模板.docx`

---

## 一、这个包是什么

按学院模板的五节结构，把项目里**已经存在、可核对**的成果整理成可直接摘抄的文字、表格和图片；同时把**没有做的事**单独标出来，避免报告写出无法自证的结论。

包内所有数字都能在工程里找到出处（文件路径见 `06_源文件索引.md`）。

**一句话现状：**
设计链（需求 → 选型 → 原理图 → PCB → Gerber → BOM → 下单 → 固件 → 外壳 STL → 独立审计）已经闭环到"可制造文件"级别；**实物焊装、通电实测、实物照片尚未完成**；开题报告中的**无线手势遥控端未实现**。

---

## 二、材料分级（每个章节文件都用这个标记）

| 标记 | 含义 | 报告里怎么写 |
|---|---|---|
| **A** | 有文件、有数据、可复算 | 直接写，可给数字，可标"经检查/经核对" |
| **B** | 设计值、计算值、条件仿真、厂商资料 | 必须写"设计值/仿真值/按手册"，不能写成实测 |
| **C** | 尚未完成 | 只能写"计划/下一步/受条件限制未完成" |

---

## 三、关键数字速查

| 项目 | 数值 | 级别 |
|---|---|---|
| 主控 | STM32F103C8T6 最小系统板（蓝板），72MHz，64KB Flash / 20KB SRAM | A |
| 固件规模 | 5,283 行；`smart_fan.bin` 35,948 B（Flash 54.8%）；RAM 3,504 B（17.5%）；46 项断言通过 | A |
| 主板 | 95×95 mm，双层，R3 圆角，M3 孔距 85×85 mm；48 元件 / 173 焊盘 / 2,729 段走线 / 81 过孔 | A |
| 供电 | 单 5V 输入 4.75–5.25V；F1 3A 快断；AO4409 P-MOS 防反接；AMS1117-3.3（实购 TLV1117LV33） | A |
| 执行 | TB6612FNG 驱动 130 直流电机；MG90S 360° 连续舵机摇头 | A |
| 交互 | 2 只按键 + EC11 编码器 + PAJ7620 手势（9 种）+ ASR-PRO 离线语音（20+ 命令词） | A |
| 调速 | 手动 40% 起调、±10%/步；自动 5 段（<24℃ 停 / 24–26℃ 30% / 26–28℃ 50% / 28–30℃ 75% / >30℃ 100%） | A |
| 摇头 | 50Hz PWM，1500µs 停，1.3–1.7ms 调速；档位半周期 2.4 / 2.2 / 2.0 / 1.8 / 1.5 s | A（角度为时间近似，未标定，B/C） |
| 显示 | 0.96″ OLED 128×64，I2C 0x3C；待机 10 s 熄屏 | A |
| 外壳 | 下壳 99×99×9 + 可拆盖 99×99×23.9 + 支架 84×30×24，25° 斜面，合计 68.97 cm³ | A（装配未闭环，C） |
| 成本 | 立创订单 SO2611058255（2026-11-05）：订单总额 **146.69 元**（商品 157.69，运费 9.00） | A |
| 设计检查 | KiCad 10.0.7 ERC 0 违规；DRC 0 违规 / 0 未连接 / 0 原理图一致性差异；Gerber 独立审计通过 | A |

---

## 四、文件树

```
00_先读我.md                     ← 本文件
01_模板对照与写作指引.md          ← 哪一节用哪些素材、建议字数
02_口径与风险清单.md              ← 14 条必须统一的口径（写之前先看）
03_报告正文素材/
   1_题目任务与技术指标.md
   2_元器件测试.md
   3-1_工作原理.md
   3-2_原理图与仿真.md
   3-3_电路印制板图.md
   4-1_实验过程及图片说明.md
   4-2_知识学习进程.md
   4-3_调试方法.md
   4-4_产品操作说明.md
   4-5_芯片介绍及典型应用.md
   5_总结建议体会.md
04_表格数据/
   BOM_44项.csv / 表3-1_引脚分配.csv / 表1-1_技术指标对照.csv
   表4-3_分块上电检查.csv / 表4-6_调试命令.csv
   元件测试记录表.csv（空表）/ 功能测试记录表.csv（空表）
   报告表格.xlsx（多工作表，可直接插表）
05_图片素材/  fig01–fig09 + 图注索引.md
06_源文件索引/  README.md + BOM + Gerber + KiCad 源文件
```

---

## 五、建议使用顺序

1. **先读 `02_口径与风险清单.md`**，把 14 条口径跟队友对齐（尤其 12V/5V、无线指标、外壳装配）。
2. 按 `01_模板对照与写作指引.md` 的分节映射，从 `03_报告正文素材/` 复制段落。
3. 图从 `05_图片素材/` 取，图注直接抄 `图注索引.md`。
4. 表从 `04_表格数据/报告表格.xlsx` 取，格式统一成三线表。
5. 交付前对照 `02` 里的"不要写"清单做一遍自查。

---

## 六、三条铁律

1. **不写没有做过的实测**：本包没有万用表读数、示波器波形、实物照片；凡"实测/测得"必须等真做完再写。
2. **不引用 12V 旧资料当现行方案**：`hardware/SIMULATION_REPORT.md`、`hardware/SCHEMATIC_DESIGN.md`、`docs/assembly/soldering-guide.md`、`docs/hardware/power-budget.md` 都是 12V 时代文件；只能作为"方案演进"素材，不能作为最终电路依据。
3. **不声称无线指标达成**：开题的第④条（3 m / 100 条 / 95%）在当前单板方案中没有对应实现，只能写"未实现/后续工作"。
