Lucian-ming/smart-fans/artifacts/report_pack/pack/01_模板对照与写作指引.md

# 模板对照与写作指引

模板文件：`电子工艺实习总结报告模板.docx`（A4，上下页边距 2.54 cm、左右 1.9 cm）
结构：**封面** + **一个 9 行 1 列表格**，表格即五节正文大纲。

---

## 一、封面

| 项 | 内容 |
|---|---|
| 标题 | 电子工艺实习总结报告（模板已设 22pt 粗体居中，不改） |
| 学院 | 电气自动化与信息工程学院 |
| 专业 | （按实际填） |
| 题目名称 | 电子工艺实习 |
| 班级 / 学号 / 姓名 | 按实际填 |
| 日期 | 2026 年 11 月 |

> 报告正文的"题目"（第 1 节）建议写：**基于离线语音与手势交互的温控智能风扇设计**。这与开题报告一致，也与实际实现的主线一致（无线部分见 `02_口径与风险清单.md` 第 2 条）。

---

## 二、五节映射表

| 模板节 | 本包文件 | 建议字数 | 必备图/表 | 完成度 |
|---|---|---|---|---|
| 1 自主实习题目、任务要求、技术指标 | `03_报告正文素材/1_题目任务与技术指标.md` | 800–1200 | 表 1-1 指标对照、表 1-2 方案调整 | 可写 |
| 2 元器件测试 | `2_元器件测试.md` + `04/元件测试记录表.csv` | 800–1500 | 表 2-1 测试判据、表 2-2 已核对项 | 部分（需补实测） |
| 3 项目设计内容 1 工作原理 | `3-1_工作原理.md` | 1500–2500 | 图 1 系统框图、图 2 电源拓扑、图 3 状态机、表 3-1 温控曲线 | 可写 |
| 3 项目设计内容 2 电路原理图与仿真图 | `3-2_原理图与仿真.md` | 1000–1800 | 图 9 原理图、图 4 条件仿真 | 可写（仿真为条件仿真） |
| 3 项目设计内容 3 电路印制板图 | `3-3_印制板设计.md` | 800–1500 | 图 7 布局、图 8 3D、表 3-2 板参数 | 可写 |
| 4 焊装、测试分析及产品操作说明 1 实验过程及图片说明（≥3 图） | `4-1_实验过程及图片说明.md` | 1000–2000 | 图 5 外壳、图 6 面板、图 8 3D + **补拍照片** | 需补拍 |
| 4 …2 项目相关知识学习进程 | `4-2_知识学习进程.md` | 800–1500 | 表 4-1 知识点 | 可写 |
| 4 …3 调试方法 | `4-3_调试方法.md` | 1000–1800 | 表 4-2 故障树、表 4-3 CLI 命令 | 可写（未实机验证） |
| 4 …4 产品操作说明 | `4-4_产品操作说明.md` | 800–1200 | 表 4-4 语音口令、表 4-5 手势 | 可写 |
| 4 …5 相关芯片介绍及典型应用图 | `4-5_芯片介绍与典型应用.md` | 1500–2500 | 表 4-6 芯片清单 + datasheet 典型图 | 可写 |
| 5 总结、建议、体会 | `5_总结建议体会.md` | 800–1200 | — | 可写 |

---

## 三、排版建议

- **图**：宽 12–14 cm 居中；图注在图下，格式"图 1 智能风扇系统总体框图"，正文必须提到"如图 1 所示"。
- **表**：三线表；表题在表上，"表 1-1 技术指标对照"。
- **编号**：按节编号（图 1、图 2 …），不要与模板节号混用。
- **代码/命令**：用等宽字体，不贴长代码；只贴关键片段（状态机、温控曲线、I2C 解锁）。
- **页数**：这类报告常见 12–20 页；设计内容（第 3 节）应占一半以上。

---

## 四、图文对应关系（避免图文不符）

| 要说明的事 | 用哪张图 | 说明重点 |
|---|---|---|
| 系统怎么组成 | 图 1 | 四条交互路径 + 两条电源轨 |
| 电怎么走 | 图 2 | 5V 单输入、保险、防反接、LDO、跳帽隔离 |
| 软件怎么跑 | 图 3 | 四状态、六类事件 |
| 为什么这样选参数 | 图 4 | 供电最低 4.15V、I2C 上升时间随电容/上拉变化 |
| 外壳长什么样 | 图 5、图 6 | 三件、25° 斜面、开孔位置 |
| PCB 长什么样 | 图 7、图 8 | 95×95、分区、接口位置 |
| 电路怎么连 | 图 9 | 网络标号式原理图（阅读方式见 3-2 第 2 节） |

---

## 五、最容易被追问的三处，提前准备

1. **"为什么开题是两块 ESP32 无线，报告只有一块板？"**
   → 见 `02` 第 2 条，正面写"方案调整 + 未完成项"，不要含糊。
2. **"摇头角度怎么保证 0–90°？"**
   → 连续舵机无位置反馈，只能是"时间近似 + 回中软刹车"；写清限制，别写"精确 90°"。
3. **"实测数据呢？"**
   → 如果确实没测，就在第 2、4 节写"测试方案与判据已制定，实测受仪器条件限制尚未完成"，并给出计划。**不要编数**。
