Lucian-ming/smart-fans/artifacts/report_pack/pack/03_报告正文素材/1_题目任务与技术指标.md

# 1 自主实习题目、任务要求、技术指标

> 本节完成度：**可写**（指标状态需按表如实标注）

## 1.1 自主实习题目

**基于离线语音与手势交互的温控智能风扇设计**

设计一台立式桌面智能风扇：以 STM32F103C8T6 为主控，支持按键、旋转编码器、手势、离线语音四种交互方式；根据环境温度自动调速；舵机带动机头往复扫风；OLED 显示温度、档位、模式与状态；整机由 3D 打印外壳承载，单 5V 供电。

## 1.2 任务要求

1. 完成需求分析、方案选型与系统框图，给出供电、主控、执行、交互、显示的完整方案。
2. 完成原理图设计与 PCB 设计，输出 Gerber、BOM、坐标文件，板级检查（ERC/DRC/制造审计）通过。
3. 完成嵌入式固件：状态机、调速、温控、扫风、显示、按键/编码器/手势/语音驱动与调试命令。
4. 完成外壳结构设计与 3D 打印文件，控制材料体积在打印券限额内。
5. 完成元器件采购、焊接、分块上电与整机联调（受条件限制，实物环节尚未完成，见第 4 节）。
6. 撰写总结报告，给出测试数据、问题分析与改进方向。

## 1.3 技术指标

**表 1-1 技术指标与完成状态对照**

| 序号 | 指标（开题） | 设计/实现值 | 状态 | 依据 |
|---|---|---|---|---|
| ① | 三种以上控制方式，支持启停/三档/摇头/模式 | 四种：按键、EC11、手势、离线语音；启停、无级调速（10%/步）、摇头、手动/自动双模式 | **达成**（无线手势除外） | 固件 `fan_fsm.c` / `main.c` |
| ② | 离线语音 ≥6 条，1 m 内每条 20 次识别率 ≥90% | 20+ 命令词、双唤醒词；识别率未实测 | **功能达成，指标未测** | `firmware/asr_pro/` |
| ③ | 手势 ≥4 种，识别率 ≥90%，有防重复 | 9 种映射，200 ms 防重复；识别率未实测 | **功能达成，指标未测** | `paj7620.c` |
| ④ | 3 m 内 100 条指令正确率 ≥95%，状态回传与去重 | 无无线链路 | **未实现** | — |
| ⑤ | 识别到动作 ≤1 s | 语音/手势→动作链路为事件驱动，设计目标 <200 ms；未实测 | **未实测** | 主循环 20 ms 节拍 |
| ⑥ | ≥3 个温度区间回差调速，手动可保持 | 5 段：<24℃ 停、24–26℃ 30%、26–28℃ 50%、28–30℃ 75%、>30℃ 100%；手动调速强制退出自动 | **达成**（设计） | `fan_fsm_update_auto_temp()` |
| ⑦ | OLED 显示温度/档位/模式/状态，连续 1 h 不死机 | OLED 显示已实现；1 h 老化未做 | **部分** | `ssd1306.c` |
| ⑧ | 两端原理图/PCB/焊装/程序/测试/报告 | 单端原理图、PCB、固件、审计完成；焊装与实测未完成 | **部分** | 本包 |

> 写报告时的口径：①②③⑥ 写"实现"，④ 写"未实现（方案调整，见 1.4）"，⑤⑦⑧ 写"部分完成/待实测"。不要笼统写"全部达标"。

## 1.4 方案调整说明（开题 → 实现）

**表 1-2 方案调整对照**

| 项目 | 开题方案 | 最终方案 | 调整原因 |
|---|---|---|---|
| 架构 | 手势遥控端 + 风扇执行端，双 ESP32-C3，ESP-NOW | 单块 STM32F103 主板，手势传感器上板 | 单板即可覆盖语音+手势+按键三类交互；避免无线配对、重发、去重带来的调试风险与工期 |
| 风扇 | 12025 4-Pin PWM 风扇（25 kHz + FG 测速） | 130 直流电机 + TB6612FNG | 手头器件与成本；4-Pin 风扇的 FG 堵转检测需额外捕获与判据 |
| 测温 | DS18B20 | DHT11（温度+湿度） | 器件到货情况；单总线协议相近 |
| 扫风 | SG90 位置舵机 0–90° | MG90S 360° 连续舵机 + 定时换向 | 手头舵机为连续旋转型；用时间近似扇面并加回中软刹车 |
| 电源 | 12V 输入 + XL1509 降压 + AMS1117 | 单 5V 输入 + AO4409 防反接 + AMS1117/TLV1117 | 去掉一级降压，减少失效点；风扇、舵机、语音模块本身均为 5V 器件 |
| 交互 | 语音 + 无线手势 + 按键 | 语音 + 板载手势 + 按键 + 编码器 | 见架构行 |

> 这段建议配一张"方案演进"小表或时间线，老师通常很看重"为什么改"。

## 1.5 成本

**表 1-3 成本构成（立创订单 SO2611058255，2026-11-05）**

| 项 | 金额 |
|---|---|
| 商品金额 | 157.69 元 |
| 运费 | 9.00 元 |
| **订单总额** | **146.69 元**（另有店铺优惠抵扣，详见订单 PDF） |
| 预算 | 180 元（可报销上限 200 元） |

说明：订单覆盖阻容、芯片、二极管/三极管、蜂鸣器、接插件、电机座等 24 行商品；Phoenix 输入端子、保险丝座、部分排母/跳帽与 3D 打印材料未计入，实际成本略高于订单金额。

## 1.6 本节可直接用的开头段

> 本次自主实习的题目是"基于离线语音与手势交互的温控智能风扇设计"。选择该题目的出发点是：风扇是典型的小型机电一体化产品，既包含电源、驱动、传感、人机交互等硬件内容，又包含状态机、闭环控制、通信协议等软件内容，适合作为电子工艺实习的综合载体。设计目标是做出"能演示、能拆解、能讲清原理"的桌面样机，因此在方案上优先保证单板可靠性与可调试性，最终形成以 STM32F103 为核心、单 5V 供电、四种交互方式并存的整机方案。
