Lucian-ming/smart-fans/artifacts/report_pack/pack/03_报告正文素材/2_元器件测试.md

# 2 元器件测试

> 本节完成度：**部分**。设计侧核对（BOM、封装、引脚序、模块尺寸）已完成；**实物电参数测量与照片尚未完成**，需按 2.5 补做。

## 2.1 测试目的与项目

元器件测试分四类：

| 类别 | 目的 | 手段 |
|---|---|---|
| A 到货核对 | 型号、封装、数量、极性、丝印与 BOM 一致 | 目视 + 放大镜 + 立创订单/规格书比对 |
| B 电参数 | 阻值、容值、二极管压降、三极管 hFE、稳压输出 | 万用表 / 可调电源 / 示波器 |
| C 模块功能 | 模块能否单独工作、地址/针序是否正确 | 最小系统 + 串口/逻辑分析仪 |
| D 装配适配 | 模块外形、针距、排距、安装孔与 PCB 是否匹配 | 卡尺 + PCB 实物比对 |

## 2.2 已完成的核对（A/D 类，可写）

**表 2-1 关键器件核对结果**

| 器件 | 设计值/型号 | 核对内容 | 结论 |
|---|---|---|---|
| 主控 | STM32F103C8T6 蓝板 | 双排 20P、2.54 mm、排距 15.24 mm、约 53.3×22.8 mm；USB 朝板后 | 与 PCB 母座一致 |
| 3.3V LDO | AMS1117-3.3（BOM）/ TLV1117LV33（实购） | SOT-223 封装、引脚 1=GND 2=VOUT 3=VIN（Tab=VOUT） | 两种封装兼容，PCB 按 TLV1117LV 出图 |
| 电机驱动 | TB6612FNG 模块 | 双排 8P、排距 15 mm、VM/VCC/GND/AIN/BIN/PWM/STBY | 与母座一致；清单标 VM=12V 与 5V 方案冲突，需按实物核对 |
| 舵机 | MG90S 360° 连续旋转 | 3P：棕/黑 GND、红 5V、橙/黄 PWM | 与 SERVO1 一致 |
| 语音模块 | ASR-PRO 30×28×2.9 mm | 双排 7P（BOM 按 8P 设计，**存在 7P/8P 不一致**） | 需以实物针数为准，上电前必须核对 |
| 手势模块 | PAJ7620U2 20×15 mm 5P | 3V3/GND/SCL/SDA/INT，I2C 地址 0x73 | 与 J_GESTURE 一致 |
| OLED | 0.96″ 128×64 4P | 两种针序：GND-VDD-SCK-SDA / VCC-GND-SCL-SDA | **接反会烧屏**，上电前必测 |
| 温湿度 | DHT11 3P | 两种针序：S/+/- 与 +/-/S | 必须核对丝印 |
| 编码器 | EC11 5P（上 2 + 下 3，组距 21 mm） | 上：VCC/GND；下：A/C(GND)/B；无按压开关 | 与 J_ENC 一致；PB12 因此留空 |
| 蜂鸣器 | TMB12A05 5V 有源 | 12×9.5 mm、脚距 7.6 mm | 与 BZ1 一致 |
| 电容 | 100 µF/25V、220 µF/16V、10 µF、100 nF | 耐压、纹波电流、体积 | Rubycon ZLH 220 µF：540 mA rms @105℃/100 kHz，阻抗 0.094 Ω，高度 ≤12.5 mm |
| 保险 | Littelfuse 0451003.MRL 3A 快断 | 3A 是**过流保护**，不是 3A 恒流限流 | 需按启动 I²t 复核 |
| 输入端子 | Phoenix 1729128 MKDSN 1,5/2-5,08 | 5.08 mm 间距、2P、壳高约 10 mm | 库存与实物待核 |

**表 2-2 模块尺寸实测记录（用于结构核对）**

| 模块 | 标称/实测 | 用途 |
|---|---|---|
| 蓝板 | 53.3×22.8 mm，排距 15.24 mm | 母座间距、壳内净高 |
| ASR-PRO | 30×28×2.9 mm，排距 25.40 mm（用户确认） | 右侧双排母 |
| PAJ7620 | 20×15 mm，5P | 面板 φ10 开孔对位 |
| OLED | 0.96″，4P，针排中心 (78.5, 26.5) | 面板 28×16.5 开孔 |
| EC11 | 5P，组距 21 mm，轴径/轴长待测 | 面板 φ9 开孔 |
| TB6612 | 双排 8P，排距 15 mm | 左侧双排母 |

## 2.3 测试判据（B/C 类，写完可直接当表 2-3）

**表 2-3 元器件测试判据**

| 器件 | 测试点 | 判据 | 不合格处理 |
|---|---|---|---|
| 电阻 1k/4.7k/10k | 两端 | ±1%（0805 厚膜） | 更换 |
| 电容 100 nF | 两端 | 10–200 nF（万用表电容档） | 更换 |
| 电解 100/220 µF | 正负极 | 标称 −20%/+20%，无鼓包 | 更换 |
| 二极管 1N4148W | A–K | 正向 0.55–0.75 V，反向不通 | 更换 |
| LED | A–K | 正向 1.8–3.2 V（按颜色） | 更换 |
| 三极管 2N3904 | B–E、B–C | hFE 200–300，两结正向 0.6–0.7 V | 更换 |
| AO4409 | D–S、G–S | 无短路；G 拉低时 D–S 导通（Rds(on) ≤12 mΩ @VGS=−4.5 V） | 更换 |
| LDO | VIN=5 V，空载 | VOUT=3.3±0.1 V；加载 100 mA 仍 ≥3.2 V | 更换/查焊 |
| 蜂鸣器 | 两端加 5 V | 响，电流 <40 mA | 更换 |
| 保险 | 两端 | 通（<1 Ω） | 更换 |
| OLED | I2C 扫描 | 地址 0x3C 应答 | 查针序/上拉 |
| PAJ7620 | I2C 扫描 | 地址 0x73 应答；挥手有 INT 下降沿 | 查供电/地址 |
| DHT11 | 单总线 | 读出温度 0–50℃、湿度 20–90%RH | 查上拉/时序 |
| ASR-PRO | UART 115200 | 唤醒后回传命令字；播放不破音 | 查跳帽/供电 |
| 舵机 | PWM 1500 µs | 停转；1300/1700 µs 正反转 | 查脉宽/供电 |
| 电机 | 5 V 空载 | 起转，电流 <0.3 A；堵转 <1 A（短时） | 查驱动/电源 |

## 2.4 与设计相关的"测试结论"（可直接写）

1. **LDO 选型**：AMS1117-3.3 属老式低压差器件，稳定性依赖输出电容 ESR；最终改用 TLV1117LV33（低压差、原厂稳定性要求明确），PCB 与 ERC/DRC 均按后者复核。
2. **I2C 上拉**：主板 4.7 kΩ，模块自带 4.7 kΩ 时并联为 2.35 kΩ；按条件仿真，50 pF 总线电容下上升时间 66–199 ns，均满足快速模式 300 ns；800 pF 时 4.7 kΩ 超标（见 3-2 节）。
3. **蜂鸣器**：有源蜂鸣器为感性负载，必须并 1N4148W 续流；RevA 仿真中无二极管时反峰达 782.9 V，加钳位后 5.75 V（历史数据，仅说明必要性）。
4. **电解电容**：220 µF/16V 选 Rubycon ZLH，105℃/100 kHz 下纹波电流 540 mA rms，满足 25 kHz PWM 下的母线纹波需求（按手册，未实测温升）。

## 2.5 必须补做的实测（C 类）

按下面顺序做，每步留照片与读数：

1. 到货清点：所有元件平铺拍照，标注位号（对应 BOM 44 项）。
2. 阻容/二极管/三极管抽测：每种至少 3 只，记录实测值。
3. LDO 空载/加载：5 V 输入，测 3.3 V 输出与纹波（示波器 20 MHz 带宽限制）。
4. 模块单独上电：OLED 显示测试图、PAJ 串口打印手势、DHT11 串口打印温湿度、ASR 串口回显。
5. 舵机/电机：限流 0.5 A 下测空载电流、正反转、堵转电流（≤2 s）。
6. 填写 `04_表格数据/元件测试记录表.csv`，并把照片放进 `05_图片素材/`（命名 `p_元件_01.jpg`）。

## 2.6 写作提示

- 第 2 节不要写成"元件清单复述"，重点是**判据 + 异常处理 + 与设计的关联**。
- 没有实测数据时，写"测试方案与判据已制定，实测受仪器条件限制尚未完成"，比编造数字安全得多。
- 若只做了部分实测，就按"已测/未测"分两栏写，别用"全部合格"。
