Lucian-ming/smart-fans/artifacts/report_pack/pack/03_报告正文素材/3-2_原理图与仿真.md

# 3-2 电路原理图与仿真

> 对应模板：**三、项目设计内容 → 2、电路原理图与仿真图**（约 800–1200 字，配图 4、图 9）

## 3.2.1 原理图的组织方式

Rev B4 主板原理图共 **44 个符号、168 个引脚**（137 个导线连接 + 31 个 NC 标记），按功能分区绘制：左上电源与保护、中上主控母座、左侧电机驱动与舵机、右侧语音模块、下侧按键/编码器/传感器/显示接口。

需要提前说明一点：**本图采用"网络标号"连接方式**——每个模块的引脚旁标注网络名（如 `TB_PWMA`、`SERVO_PWM`、`I2C1_SCL`），同名标号即同一网络，而不是用长导线把各模块连起来。这样做的原因是整机网络多、跨区连接多（例如 3.3 V 要供 6 个模块），标号式比走线式更易读、更易改版，也是 KiCad 工程中常见的分层画法。**读图时按"找同名标号"的方式看即可**。

## 3.2.2 关键电路分析

### （1）输入保护

- **J_PWR**：Phoenix 1729128（MKDSN 1,5/2-5,08），5.08 mm 间距螺钉端子，允许导线 0.14–1.5 mm²，额定 10 A，远大于本机 2 A 需求；选它是因为插拔可靠、可现场接线。
- **F1**：Littelfuse 0451003.MRL，3 A 快断贴片保险丝。选 3 A 而不是 2 A，是给电机启动/堵转的浪涌留余量；它保护的是"持续过流与短路"，不是精确限流。
- **Q_PWR**：AO4409（P 沟道 MOSFET，−30 V 耐压，Rds(on) ≤12 mΩ @VGS=−4.5 V）。源极接输入、漏极接 +5 V 轨、栅极经 10 kΩ 下拉到地。正接时 VGS≈−5 V 完全导通，压降约 20–40 mV；反接时体二极管方向正确但栅极电压使沟道关断，输出被切断。相比肖特基串联方案，2 A 下少损耗约 0.7–1 W。

### （2）3.3 V 稳压

U3 原设计 AMS1117-3.3（SOT-223，1 A），实装 TLV1117LV33（同为 SOT-223、引脚兼容）。输入端 10 µF + 100 nF，输出端 10 µF + 100 nF。输出给 OLED、PAJ7620、DHT11、EC11、TB6612 的 VCC，总电流约 92 mA（峰值估算），余量充足。

> 注意：**蓝板自己的 3V3 输出保持 NC，不与母板 3.3 V 并联**，否则两路 LDO 会互相倒灌。

### （3）电机驱动

TB6612FNG 模块（双排 8P 母座）只用 A 通道：

- `PWMA` ← PA0（TIM2_CH1，25 kHz）；
- `AIN1/AIN2` ← PA1/PA5，负责正反转；
- `STBY` ← PB0，10 kΩ 下拉保证上电默认关断；
- `VM` 接 +5 V 动力轨，`VCC` 接 +3.3 V 逻辑轨；
- `AO1/AO2` → XH-2.5 电机座（MOTO1）。

**B 通道全部 NC**，为后续加第二路电机留位。电机两端**没有**并续流二极管——TB6612 内部已有续流二极管，外并反而增加结电容。

### （4）舵机接口

`SERVO1` 为 3P 排针（GND / +5 V / PWM），PWM 来自 PB8（TIM4_CH3，50 Hz，0.5–2.5 ms）。舵机是感性负载且启动电流可达 1 A，因此**直接取自 +5 V 动力轨**，不经过任何逻辑电源；同时在接头附近放 100 µF 电解吸收换向浪涌。

### （5）I2C 总线

PB6/PB7 开漏输出，主板 4.7 kΩ 上拉到 3.3 V；OLED 模块与 PAJ7620 模块自带上拉，并联后约 2.35 kΩ。总线电容估算 50–100 pF，快速模式（400 kHz）上升时间 66–300 ns，满足要求（详见 3.2.3 仿真）。

固件还实现了 **I2C 总线解锁**：从机在传输中被复位时可能把 SDA 拉低，此时主机发 9 个 SCL 脉冲直到 SDA 释放，再发 STOP——这是 I2C 设计指南推荐的标准恢复流程，实测中解决过 OLED 热插拔后总线卡死的问题。

### （6）单总线与按键

DHT11 数据线 PB9，4.7 kΩ 上拉；时序要求 µs 级，用 `delay_us.c` 的 DWT 周期计数实现。EC11 的 A/B 相接 PA6/PA7，用 TIM3 编码器模式硬件解码；C 脚接地，**5 脚 EC11 无按压开关，PB12 因此留空**（代码里保留了 KNOB_MODE 分支，但硬件未装）。

### （7）蜂鸣器与语音

BZ1 为 5 V 有源蜂鸣器，2N3904（hFE 200–300）低边驱动，基极 1 kΩ 限流，**线圈并 1N4148W 续流**。ASR-PRO 通过三只跳帽（JP_ASR 供电、JP_ASR_TX、JP_ASR_RX）与主板相连，UART2 115200；跳帽的作用是"拔掉即隔离"，方便单独给语音模块烧录与排查。

## 3.2.3 仿真与条件分析

### （1）供电回路（图 4a）

用集总模型对"适配器 + 线缆 + 保险丝 + P-MOS"做 2 A 负载下的直流压降扫描，变量为输入电压（4.75/5.0/5.25 V）与回路总阻（0.05/0.15/0.30 Ω，分别对应短粗线、普通杜邦线、细长线）：

- R=0.05 Ω：4.65–5.15 V，全部高于 TB6612 的 VM 下限 4.5 V；
- R=0.15 Ω：4.45–4.95 V，4.75 V 输入时跌到 4.45 V，**低于下限**；
- R=0.30 Ω：4.15–4.65 V，三种输入里两种低于下限。

结论：**2 A 峰值下，线阻必须控制在 0.15 Ω 以内（建议 ≤0.05 Ω）**，即用 20 AWG 以上短线直接焊/压接，不要用长杜邦线给电机供电。18 组条件里有 6 组（3 种输入/线阻组合 × 2 种滤波电容）低于 4.5 V，这也是"5 V/2 A"只能算待验证目标、不能算额定值的原因。

### （2）I2C 上升时间（图 4b）

对 18 组（总线电容 50–800 pF × 上拉 4.7 k/2.35 k/1.57 k）做 RC 上升时间计算：

| 总线电容 | 4.7 kΩ | 2.35 kΩ | 1.57 kΩ |
|---|---|---|---|
| 50 pF | 199 ns | 99 ns | 66 ns |
| 200 pF | 约 800 ns | 约 400 ns | 约 270 ns |
| 800 pF | >1000 ns（超标） | 约 1600 ns（超标） | 约 1080 ns（超标） |

结论：**标准模式（1000 ns）有 4 组超标、快速模式（300 ns）有 12 组超标**，全部集中在 400 pF 以上；本机总线短、只挂两个模块，50–100 pF 下余量充足。若以后加长排线或挂第三个 I2C 器件，应把上拉降到 2.2 kΩ 并复核。

### （3）历史方案仿真（仅作方法说明，不要当本机结论）

RevA（12 V + XL1509）阶段做过完整的 LTspice 瞬态仿真：负载阶跃跌落 207.4 mV、母线最低 4.793 V、纹波 36.2 mVpp；蜂鸣器无续流二极管时反峰 782.9 V、加 1N4148W 后钳位到 5.75 V；风扇 PWM 上升沿 620.4 ns；1-Wire 复位脉冲 480 µs；I2C 上升沿 517 ns。

这些数据**属于已废弃的 12 V 方案**，只能用来讲"为什么要加续流二极管""为什么要测纹波"，**不能写成本机实测或本机仿真结果**。本机（5 V）目前只有上面的条件分析，没有整机瞬态仿真。

## 3.2.4 电气规则检查（ERC）

原理图在 KiCad 10 中通过 ERC：**违规 0 项**。为使 ERC 可运行，忽略了 4 类与设计意图相关的检查：`single_global_label`（单端全局标号，本图大量使用）、`four_way_junction`（四路节点）、`simulation_model_issue`（部分符号无仿真模型）、`footprint_filter`（封装过滤不匹配）。

> 写报告时的表述："ERC 通过（0 违规）；按设计意图忽略了 4 类与网络标号画法相关的检查项"。**不要**写"ERC 全绿、无任何忽略"。

## 3.2.5 本节写作提示

- 原理图（图 9）建议放在本节末尾或附录，正文用图 1 框图 + 表 3-1 引脚表讲连接，读者更容易懂。
- 每个电路都按"器件参数 → 为什么选它 → 有什么代价"三段式写，例如 P-MOS 的压降与成本、3 A 保险与浪涌的取舍。
- 仿真部分要区分"条件分析（本机）"与"历史仿真（RevA）"，这是最容易被追问的地方。
