Lucian-ming/smart-fans/artifacts/report_pack/pack/03_报告正文素材/3-3_电路印制板图.md

# 3-3 电路印制板图

> 对应模板：**三、项目设计内容 → 3、电路印制板图**（约 800–1100 字，配图 7、图 8）

## 3.3.1 板级参数

**表 3-2 主板参数**

| 项 | 参数 |
|---|---|
| 外形 | 95 × 95 mm，四角 R3 圆角 |
| 层数 | 2 层（F.Cu / B.Cu），板厚 1.6 mm，1 oz 铜 |
| 安装 | 4 × M3 孔，孔距 85 × 85 mm（中心 (5,5)(90,5)(5,90)(90,90)） |
| 元件/焊盘 | 48 元件 / 173 焊盘（含跳帽、测试点、NC 位） |
| 网络/走线 | 33 网络 / 2729 段走线 / 81 过孔 |
| 钻孔 | 208 孔（含安装孔、过孔） |
| 工艺 | 双层板常规工艺（工艺参数以打样厂默认能力为准）；设计最小净距 0.300 mm |

## 3.3.2 布局

**图 7 PCB 布局图（顶视）**、**图 8 PCB 3D 渲染** 给出实际效果。布局按"功率在左、逻辑在中、交互在边"分区：

1. **左上：电源入口区**。J_PWR 端子靠板边，F1、Q_PWR、C1/C3 依次排布，输入回路最短；LDO 放在电源区与主控之间，3.3 V 走线短。
2. **中部：主控区**。蓝板双排 20P 母座跨在板中央，USB 朝板后（北），两侧留出跳线空间；调试口与跳帽靠板边布置，方便插拔调试器。
3. **左侧：执行区**。TB6612 母座与 XH-2.5 电机座、SERVO1 集中布置，电机大电流回路不进入板中央；舵机接口靠近板边，方便出线。
4. **右侧：语音区**。ASR-PRO 双排母座（排距 25.4 mm）与三只跳帽、喇叭座；语音模块的麦克风走线远离电机 PWM。
5. **下侧：交互区**。KEY1/KEY2、EC11、DHT11 插座沿板边排列，对应面板开孔位置（OLED 在右上、手势在左上）。

这样分区的两个目的：一是**功率回流路径短**，电机电流不穿过逻辑地；二是**装配时每个模块都能单独插拔**，不需要拆整板。

## 3.3.3 布线

- 电源：+5 V 主干走 2.0 mm，电机支路 1.0 mm，3.3 V 走 0.5 mm；输入与电机回路尽量走顶层，底层用地平面兜底。
- 地：双面铺铜，整板共 81 个过孔（含地缝合孔与信号换层孔）；模拟/数字不刻意分割，但电机地与逻辑地在电源入口处单点汇合。
- 信号：I2C 走 0.25 mm 并等长，远离 PWM；DHT11 单总线 0.25 mm，长度 <50 mm；编码器 A/B 并行走线。
- 过孔：信号孔 0.3/0.6 mm，电源孔 0.5/1.0 mm；过孔不放在焊盘上（避免吸锡）。
- 丝印：48 个位号全部可读，接口旁标注针序（如 `SDA/SCL/VCC/GND`），板边标注板名 "STM32 SMART FAN CONTROLLER – REV B4" 与 "5V prototype"。

## 3.3.4 制造审计结果

打样前用独立脚本对 Gerber/钻孔/阻焊/焊膏做了 14 项检查，**全部通过**（`final_fabrication_audit.json`，passed=true）：

| 检查项 | 结果 |
|---|---|
| F.Cu 对象数 | 2006 |
| 非地焊盘 | 134 |
| 最小覆铜间隙 | 0.300 mm（欧氏 0.298073 mm） |
| 短路 / 净距违规 / 断网 | 0 / 0 / 0 |
| 板边铜距 | 0.99997 mm |
| PTH 孔数 / 最小孔壁 | 211 / 0.308 mm |
| 阻焊桥（正/背） | 0.570 / 0.702 mm |
| 盖油孔余量 | 0.105 / 0.414 mm |
| 焊膏面积 | 71.823 mm² |
| 丝印位号 | 48 个 |

同时，KiCad 原生 DRC 与"原理图- PCB 一致性"检查均为 **0 违规、0 未连接**；ERC 见 3-2 节。需要说明的是：这些是**裸板工程验证**，不等于整机装配或量产签核（`Audit_Report.md` 原话）。

## 3.3.5 一次真实的 DFM 问题（建议写进报告，很加分）

首版净距检查报了 **39 处 0.236–0.239 mm** 的违规，全部卡在 0.24 mm 阈值边缘。逐条看坐标后发现不是布线错误，而是**圆弧近似误差**：KiCad 默认用 10 边形逼近圆，焊盘/过孔的圆弧被切成多边形后，顶点处到相邻走线的欧氏距离比真实圆弧短了约 3 µm。把圆近似段数从 10 改到 64 后重新生成 Gerber，39 处全部归零，最小净距回到 0.300 mm。

> 这段可以写成"从'以为布错了'到'发现是工具近似误差'"的小故事，体现排查方法：先看坐标分布 → 再怀疑几何近似 → 改参数复验。

## 3.3.6 已知不足

1. **没有测试点**：调试时只能探模块引脚，建议下一版在 5 V/3.3 V/GND/PWM 上各加一个 φ1.5 mm 测试点。
2. **无 ESD 保护**：面板按键与编码器直接进 MCU，干燥环境触摸可能有静电风险，可加 TVS/RC。
3. **电机回路与逻辑同板**：虽然分区，但 130 电机换向噪声仍可能耦合到 DHT11 单总线，实测时若读数异常，优先查地回流与去耦。
4. **丝印字符偏小**：部分位号 0.8 mm 高，打印后辨识度一般，下一版统一 1.0 mm。

## 3.3.7 本节写作提示

- 先给参数表（表 3-2），再讲布局思路（为什么这么摆），再讲布线规则，最后给审计数据与不足，结构清晰。
- 图 7 与图 8 二选一为主图，另一张放附录；图注注明"顶视图"。
- "39 处净距"的故事不要省略，它是整份报告里最能体现工程能力的细节之一。
