Lucian-ming/smart-fans/artifacts/report_pack/pack/03_报告正文素材/4-1_实验过程及图片说明.md

# 4-1 实验过程及图片说明

> 对应模板：**四、焊装、测试分析及产品操作说明 → 1、实验过程及图片说明（至少三张图）**
> 本节完成度：**过程可写，图片需补拍**。设计阶段的图已备好；焊接与实物照片必须由做实物的人补。

## 4.1.1 总体进程

**表 4-1 项目实施进程**

| 阶段 | 时间 | 主要工作 | 产出 |
|---|---|---|---|
| ① 需求与方案 | 11 月上旬 | 题目拆解、指标确认、器件选型、方案调整（双 ESP32 → 单板 STM32） | 需求文档 v0.5、系统框图 |
| ② 原理图 | 11 月上旬 | 分模块原理图、网络标号、ERC | 44 符号 / 168 引脚，ERC 0 违规 |
| ③ PCB | 11 月上中旬 | 布局、布线、铺铜、丝印、制造审计 | 95×95 双层板，14 项审计通过，Gerber 下单 |
| ④ 固件 | 11 月上中旬 | 驱动层、状态机、CLI、语音协议、点阵表情 | 约 5.3k 行，46 断言通过，bin 35,948 B |
| ⑤ 采购 | 11-05 | 立创下单 24 行 | 订单 146.69 元 |
| ⑥ 结构 | 11 月上中旬 | 三件套建模、体积复核、切片文件 | 68.97 cm³（限额 70） |
| ⑦ 焊装与联调 | **待进行** | 焊接、分块上电、整机联调、实测 | **尚无照片与数据** |
| ⑧ 报告 | 11 月中旬 | 整理素材、撰写、答辩 | 本素材包 |

> 如果实际时间与上表不同，按真实日期改；老师更在意"阶段完整"，不是精确到天。

## 4.1.2 面包板验证（设计阶段已完成）

在投板前先用面包板把关键链路跑通，顺序如下（对应 `docs/hardware/breadboard_wiring_guide.md`）：

1. **只上逻辑**：5 V 适配器 → 蓝板 5 V（JP_USB 断开母板），USB 不插，测 3.3 V 正常、电流 <50 mA。
2. **点亮 OLED**：接 PB6/PB7，I2C 扫描到 0x3C，显示测试画面。
3. **接手势**：PA4 中断 + I2C 0x73，串口打印 9 种手势。
4. **接 DHT11**：PB9 + 4.7 kΩ 上拉，串口每 2 s 打印温湿度。
5. **接电机驱动**：TB6612 的 VM 接**外部 5 V**（不要从蓝板取），STBY 拉高，10% 起调，观察转向与电流。
6. **接舵机**：单独 5 V 供电，共地，先 1500 µs 停转，再试 1300/1700 µs。
7. **接语音**：最后接 ASR-PRO，先只听串口回传，确认命令字正确后再接喇叭。

面包板阶段踩过的坑（可直接写进报告）：

- **DHT11 针序有两种**（S/+/- 与 +/-/S），接反不工作但不一定烧，先看丝印再插；
- **OLED 针序也有两种**（GND-VDD-SCK-SDA 与 VCC-GND-SCL-SDA），**接反会烧屏**，上电前必须万用表确认 VCC/GND；
- **MG90S 线色**：棕/黑 GND、红 5V、橙/黄 PWM，插反会堵转发热；
- **喇叭是 BTL 输出**，SPK1 两端都不能接地，否则烧功放。

## 4.1.3 焊接过程（待执行，按此顺序）

**表 4-2 焊接顺序与检查点**

| 步骤 | 内容 | 完成判据 |
|---|---|---|
| 1 | 先焊最矮的：0805 阻容、SOT-23（2N3904）、SOD-123（1N4148W） | 无立碑、无连锡 |
| 2 | 焊 IC：AMS1117/TLV1117（SOT-223）、AO4409（SOP-8） | 引脚对齐，方向正确 |
| 3 | 焊接插件：排母、XH-2.5、Phoenix 端子、跳帽排针 | 垂直、不歪、不堵孔 |
| 4 | 焊蜂鸣器、保险丝、电解电容 | 极性正确（电解负极有白条） |
| 5 | 最后插模块：蓝板、TB6612、ASR-PRO、OLED、手势、DHT11、EC11 | 断电插拔 |

工具与参数：恒温烙铁 320–350 ℃、0.8 mm 有铅/无铅焊锡丝、助焊剂少量；电解电容与蜂鸣器最后焊，避免受热。

**表 4-3 分块上电检查（5 V 方案）**

| 检查点 | 方法 | 合格范围 |
|---|---|---|
| 不上电 | 万用表测 +5 V 对 GND 电阻 | >1 kΩ（无短路） |
| 上电（限流 0.1 A） | 测 +5 V | 4.9–5.1 V，电流 <50 mA |
| 上电 | 测 +3.3 V | 3.25–3.35 V |
| 上电 | 示波器测 5 V 纹波（20 MHz 带宽） | <100 mVpp |
| 烧录后 | 看 PC13 心跳灯 | 0.5 s 闪 |
| 电机 | 10% 起调，逐步加 | 转向正确，电流 <0.5 A（空载） |
| 舵机 | 1500 µs 停转，1300/1700 µs 正反转 | 无堵转异响 |

> 旧版焊接指南里写的是 12 V 上电表，**本表已按 5 V 方案改写**，引用时以本表为准。

## 4.1.4 图片说明（模板要求至少 3 张）

### （A）现在就能用的设计图（4 张，图注按此写）

| 图 | 文件 | 建议图注 |
|---|---|---|
| 图 1 | `fig01_system_block.png` | 图 1 智能风扇系统总体框图（Rev B4，单 5 V 供电） |
| 图 7 | `fig07_pcb_layout_top.png` | 图 7 主板 PCB 布局图（顶视，95×95 mm） |
| 图 8 | `fig08_pcb_3d_top.png` | 图 8 主板 3D 渲染图 |
| 图 5 | `fig05_case_parts.png` | 图 5 外壳三件模型（STL 复核：水密、单壳体，合计 68.97 cm³） |

### （B）必须补拍的实物照片（至少 6 张，模板"至少三张"用 ①②③ 即可）

| 编号 | 拍什么 | 怎么拍 | 图注建议 |
|---|---|---|---|
| ① | **焊接中的主板** | 斜 45°，能看清已焊的阻容与 IC，背景干净 | 图 4-1 主板焊接过程（功率与逻辑分区） |
| ② | **上电测试** | 万用表/示波器表笔搭在 5 V、3.3 V 上，屏幕显示读数 | 图 4-2 分块上电与电压测试 |
| ③ | **整机运行** | 正面稍俯视，OLED 亮、风叶转（可加一点动感）、手在面板前做手势 | 图 4-3 整机运行与手势交互 |
| ④ | 焊接背面 | 翻转拍焊点，体现透锡 | 图 4-4 背面焊点 |
| ⑤ | 模块插装 | 蓝板/驱动/语音模块插在母座上的特写 | 图 4-5 模块化装配 |
| ⑥ | 3D 打印件 | 三件摆在一起，旁边放卡尺或硬币作参照 | 图 4-6 3D 打印外壳零件 |

拍照要点：光线均匀（靠窗或台灯 + 白纸反光）、擦净指纹、画面里带一点"参照物"（尺子/手）、每张存原图（不要只留微信压缩图）。

### （C）图片与正文的对应

- 4.1.2 面包板 → 配面包板接线照片（如有）；
- 4.1.3 焊接 → 配 ①②④⑤；
- 4.1.4 上电 → 配 ②；
- 4.2 联调 → 配 ③⑥。

## 4.1.5 本节写作提示

- 按"设计 → 面包板 → 制板 → 焊接 → 上电 → 联调"的时间线写，一段一件事，不要混。
- 每张图后面必须有一句"这张图说明了什么"，不能只放图。
- 实物环节没做就**如实写"受条件限制尚未完成，已制定如下步骤与判据"**，把表 4-2/4-3 留着——这比编造过程更能得分。
