Lucian-ming/smart-fans/artifacts/report_pack/pack/03_报告正文素材/4-2_知识学习进程.md

# 4-2 项目相关知识学习进程

> 对应模板：**四、焊装、测试分析及产品操作说明 → 2、项目相关知识学习进程**（约 800–1200 字）

## 4.2.1 学习路径总览

项目开始前，组内对 STM32、PCB 设计、离线语音、3D 打印都只有零散概念。整个学习过程按"用到什么学什么、学完立刻做出来验证"推进，形成下面的主线：

```
电子工艺基础（焊接/万用表/示波器）
   ↓
电源与保护（LDO、P-MOS、保险丝、去耦）
   ↓
STM32 最小系统 + HAL（GPIO/定时器/串口/I2C）
   ↓
执行器（H 桥、PWM 调速、舵机脉宽）
   ↓
传感器（I2C 手势、单总线温湿度、正交编码器）
   ↓
系统设计（状态机、事件队列、CLI 调试）
   ↓
PCB 设计（KiCad、布局布线、ERC/DRC、Gerber、DFM）
   ↓
结构与语音（3D 建模/打印、天问 Block、UART 协议）
```

## 4.2.2 分主题学习记录

**表 4-4 知识学习与产出对照**

| 主题 | 关键知识点 | 学习方式 | 产出/证据 | 难点 |
|---|---|---|---|---|
| 电源与保护 | LDO 压差与功耗、P-MOS 防反接、保险丝 I²t、去耦电容 | 规格书 + 应用笔记 + 条件仿真 | 电源链路图（图 2）、条件仿真（图 4） | 分清算术压降与瞬态跌落；理解"3 A 保险不是 3 A 限流" |
| STM32 HAL | 时钟树、GPIO 模式、TIM PWM/编码器/输入捕获、USART、I2C | 官方例程 + 自制驱动 | `firmware/src/drivers/` 11 个驱动 | 定时器通道与引脚复用冲突；开漏与上拉配置 |
| 电机驱动 | H 桥原理、PWM 频率选择、死区、续流、堵转 | TB6612 数据手册 | `motor.c`、25 kHz 调速 | 高频啸叫与开关损耗的折中 |
| 舵机 | 50 Hz 脉宽、连续舵机与位置舵机的区别、死区、kickstart | 实测 + 资料 | `servo.c`、5 档扫风 | 连续舵机没有角度反馈，"90°"只能靠时间近似 |
| I2C | 开漏、上拉、地址、时钟拉伸、总线死锁与 9 脉冲恢复 | 协议规范 + 逻辑分析仪 | `i2c_bus.c`、OLED/手势双设备 | 热插拔后 SDA 被拉低导致总线卡死 |
| 单总线 | DHT11 时序（18 ms 起始、40 bit）、µs 延时 | 数据手册 + 示波器 | `dht11.c`、`delay_us.c` | 中断干扰时序；上拉阻值影响边沿 |
| 编码器 | 正交解码、消抖、方向判断 | TIM3 编码器模式 | `encoder.c` | 机械抖动导致多计/反向 |
| 状态机 | 状态/事件/转移、纯逻辑与驱动分离、可单测 | 重构现有代码 | `fan_fsm.c`、46 断言 | 手动/自动优先级与"强制退出自动"的边界 |
| PCB 设计 | 布局分区、线宽与载流、铺铜、丝印、DRC/DFM | KiCad 官方文档 + 打样厂工艺能力 | 95×95 双层板、14 项审计 | 圆弧近似导致的"假违规"（见 3.3.5） |
| 3D 建模与打印 | 壁厚、公差、悬垂、体积估算、打印券限额 | 建模软件 + 切片软件 | 三件套 68.97 cm³ | 装配关系（USB 孔、舵机槽、按键高度）反复调 |
| 离线语音 | 天问 Block 图形化、命令词、UART 协议、ACK | 官方教程 + 实测 | `智能语音风扇.hd`、20+ 命令词 | 唤醒词误触发；串口电平与跳帽隔离 |
| 点阵显示 | MAX7219 级联、亮度、字模 | 数据手册 | 8 种"眼睛"表情 | 5 V 供电电流与 ASR 板载 LDO 能力 |
| 调试方法 | 串口 CLI、分段上电、二分定位、记录复现步骤 | 实践 | `cli_test.c`、调试记录 | 无仪器时只能用"替换法/对比法" |

## 4.2.3 三个"学会了"的具体例子

1. **从"能亮"到"知道为什么亮"**：最初点 OLED 只是照抄例程，后来为了排查热插拔死机，去读了 I2C 规范里的总线恢复流程，自己写了 9 个 SCL 脉冲的解锁函数，才真正理解开漏总线与从机状态机。
2. **从"照着画"到"按规则画"**：PCB 第一版只追求"连上"，第二版开始按载流选线宽（2 A 主干 2 mm）、按回流路径分区（电机地不穿逻辑地）、按工艺留阻焊桥，制造审计才全部通过。
3. **从"功能实现"到"可测试"**：把状态机抽成不依赖硬件的纯逻辑后，可以在 PC 上跑 46 个断言，改一行逻辑立刻知道有没有破坏原行为——这是本项目收获最大的工程方法。

## 4.2.4 学习中的教训

- **先看针序再上电**：OLED、DHT11、舵机都有两种以上针序，接反轻则不工作、重则烧模块。
- **模块要单独验证**：整机不工作时，先证明每个模块单独是好的，再查连接，效率高得多。
- **文档要跟着改**：项目中期出现过"文档写 12 V、板子做 5 V"的混乱，后来规定"改方案必须当天改文档"，否则报告阶段会非常痛苦。
- **不要迷信工具输出**：39 处净距违规最后证明是圆弧近似误差，工具报错也要自己判断。

## 4.2.5 本节写作提示

- 用表格列"主题—知识点—产出"，再用 2–3 个小故事展开，比通篇抒情有效。
- 每个主题尽量挂一个"证据"（文件名、图号、数据），显得是真的做过。
- 可以写"还没学会/没做完"的部分（如射频、无线协议），反而显得诚实。
