Lucian-ming/smart-fans/artifacts/report_pack/pack/03_报告正文素材/4-4_产品操作说明.md

# 4-4 产品操作说明

> 对应模板：**四、焊装、测试分析及产品操作说明 → 4、产品操作说明**（约 700–1000 字）

## 4.4.1 面板与接口

**图 6 前面板开孔布置** 为面板示意（沿 25° 斜面展开，单位 mm）。从上到下、从左到右：

| 位置 | 器件 | 功能 |
|---|---|---|
| 左上 φ10 | PAJ7620U2 | 手势感应窗口（正对感应区挥手） |
| 中上 φ7 ×2 | KEY1 / KEY2 | 电源启停 / 摇头与模式 |
| 右上 φ9 | EC11 编码器 | 旋转调速（每格 10%），**无按压** |
| 最右 φ2.5 | 麦克风 | 语音拾音孔 |
| 右下 28×16.5 | 0.96″ OLED | 状态显示 |
| 右侧腔体 | MG90S | 带动机头扫风 |
| 顶部 | 130 电机 + 风叶 | 出风 |

接口区（板边）：Phoenix 5.08 mm 2P 为 **5 V 电源输入**；XH-2.5 为电机与喇叭；三只跳帽 JP_ASR / JP_ASR_TX / JP_ASR_RX 控制语音模块；JP_USB 隔离蓝板 5 V。

## 4.4.2 上电与开机

1. 确认电源是 **5 V/2 A**（4.75–5.25 V），**严禁接 12 V**；插头极性内正外负。
2. 确认 JP_USB 已插上（否则蓝板无供电）；若要用 USB 给蓝板烧录/调试，**必须先拔掉 JP_USB 并断开 5 V 输入**。
3. 上电后 OLED 点亮，显示温度、湿度、档位、模式；PC13 心跳灯 0.5 s 闪。
4. 默认进入 **MANUAL 手动模式、40% 档**、摇头关闭。
5. 待机 10 s 后 OLED 熄屏；任意按键、转编码器、说话或挥手都会立即点亮。

## 4.4.3 按键与编码器

**表 4-8 按键/编码器操作**

| 操作 | 功能 | 反馈 |
|---|---|---|
| KEY1 短按 | 开机 / 关机切换 | 短鸣一声 |
| KEY1 长按 | 同短按（电源切换） | 短鸣一声 |
| KEY2 短按 | 开 / 关摇头 | 短鸣一声 |
| KEY2 长按 | 手动 / 自动模式切换 | 双响 |
| EC11 右旋 | 档位 +10%（0–100%） | 蜂鸣随档位 |
| EC11 左旋 | 档位 −10% | 蜂鸣随档位 |
| 转到 0% | 进入待机 | 熄屏 |

> 编码器**没有按压功能**（5 脚 EC11，无开关），所以"按一下编码器"不会有反应，这是设计如此，不是坏了。

## 4.4.4 手势操作

手掌距感应窗 5–15 cm，动作停留约 0.3 s 再离开，识别率最高；同一手势 200 ms 内不重复触发。

**表 4-9 手势映射**

| 手势 | 动作 | 说明 |
|---|---|---|
| 向上 | 档位 +10% | 连续挥可连续加 |
| 向下 | 档位 −10% | |
| 向前（推） | 固定 50% | |
| 向后（拉） | 关机（0%） | |
| 向右 | 开摇头 | |
| 向左 | 关摇头 | |
| 顺时针画圈 | 切模式 | 手动↔自动 |
| 逆时针画圈 | 切模式 | 同上（方向不同，效果相同） |
| 挥手（左右快速摆） | 电源开关 | |

## 4.4.5 语音操作

先说出唤醒词 **"风扇风扇"** 或 **"小风扇"**，听到"滴"后再说命令；命令后模块会播报确认（如"Fyes"对应已开启）。安静环境 1 m 内识别最好。

**表 4-10 语音命令（节选，全部 20+ 条见固件）**

| 说法 | 动作 |
|---|---|
| 开启风扇 / 打开风扇 | 开机，40% |
| 关闭风扇 | 关机 |
| 风速加 / 风速减 | ±10% |
| 最大风 / 最小风 | 100% / 20% |
| 中等风 | 50% |
| 切换模式 | 手动↔自动 |
| 自动模式 / 手动模式 | 直接指定 |
| 打开摇头 / 关闭摇头 / 摇头 | 摇头开/关/切换 |
| 摇头快一点 / 慢一点 | 扫风档 ±1 |
| 睡眠模式 | 20% + 关摇头 |
| 好热啊 / 快热死了 | 按温度直接给较高档 |
| 好冷啊 | 按温度给低档 |
| 晚安 / 我出门了 | 关机 |
| 在转吗 / 几度了 | 语音播报当前状态/温度 |

## 4.4.6 显示内容

OLED 一屏显示：

```
┌────────────────────────┐
│ 26.4C  58%RH           │  温度 / 湿度
│ MODE: MANUAL           │  模式（MANUAL / AUTO / OFF）
│ SPEED: 50%  [|||||   ] │  目标档位与条形图
│ SWING: ON   LV3        │  摇头状态与档位
│ TEMP: 26.4C            │  自动模式下的判定温度
└────────────────────────┘
```

待机时熄屏；故障或异常时显示 `FAULT` 提示（如传感器失联）。

## 4.4.7 安全与注意事项

1. **只接 5 V**：板上丝印 "5V prototype"，接 12 V 会烧 LDO、语音模块与电机驱动。
2. **插拔模块必须断电**：跳帽不隔离 GPIO，带电插拔可能损坏 MCU 引脚。
3. **USB 与外部 5 V 不能同时供**：插 USB 前拔 JP_USB、断外部电源。
4. **喇叭是 BTL 输出**：SPK1 两端都不可接地，否则烧功放。
5. **舵机与电机不要堵转**：堵转电流大，长时间会触发热保护或烧保险。
6. **连续舵机可能绞线**：长时间单向扫风时注意线缆，必要时限制运行时间。
7. **DHT11 在机内**：读数受功率器件发热影响，自动模式的温度会略高于环境温度。

## 4.4.8 常见"用户级"问题

| 现象 | 处理 |
|---|---|
| 按电源键没反应 | 查 5 V 输入、JP_USB 是否插好、保险是否熔断 |
| 屏幕不亮但风扇转 | 查 OLED 针序、I2C 上拉；断电重插 |
| 说话没反应 | 先说唤醒词；查三只语音跳帽；环境噪声大时靠近些 |
| 手势不灵 | 手离窗口 5–15 cm，动作慢一点，避免强光直射 |
| 摇头不动 | 查 SERVO1 是否插反（棕/黑 GND、红 5V、橙 PWM）、舵机是否卡住 |
| 自动模式温度不准 | DHT11 在机内，属已知局限；可切手动 |

## 4.4.9 主要规格

| 项 | 参数 |
|---|---|
| 输入 | 5 V DC / 2 A（4.75–5.25 V） |
| 主控 | STM32F103C8T6，72 MHz |
| 显示 | 0.96″ OLED 128×64，I2C |
| 调速 | 0–100%，10%/步，PWM 25 kHz |
| 温控 | 5 段（<24 / 24–26 / 26–28 / 28–30 / >30 ℃） |
| 扫风 | 5 档，定时换向近似 90° |
| 交互 | 按键 ×2、编码器、9 种手势、20+ 语音命令 |
| 外壳 | 3D 打印三件套，68.97 cm³ |
| 整机尺寸 | 约 99×99×32 mm（不含风叶） |

## 4.4.10 本节写作提示

- 操作说明要写成"给用户看"的语气：先做什么、再做什么、看到什么算成功。
- 表格比大段文字好读；每个操作都写"反馈"，用户才知道有没有生效。
- 安全注意事项单独成段，这是产品文档的必备项。
