Lucian-ming/smart-fans/artifacts/report_pack/pack/03_报告正文素材/5_总结建议体会.md

# 5 总结、建议、体会

> 对应模板：**五、总结、建议、体会**（约 800–1200 字）
> 下面给 A/B 两套正文（A 偏正式、B 偏平实）+ 可替换的"不足""建议""个人体会"模块，按需拼接。

---

## 5.1 版本 A（正式版，约 900 字）

本次电子工艺实习以"基于离线语音与手势交互的温控智能风扇"为题，完成了从需求分析、方案选型、原理图与 PCB 设计、固件开发、结构建模到采购与工艺审核的完整流程，形成了一套可复现的桌面样机设计方案。

在系统方案上，整机采用单 5 V 供电、以 STM32F103C8T6 为核心，通过 TB6612FNG 驱动 130 直流电机、MG90S 带动机头扫风，配合 DHT11 测温、PAJ7620U2 手势识别、ASR-PRO 离线语音与 0.96″ OLED，实现了按键、编码器、手势、语音四种交互方式与手动/自动两种运行模式。相比开题时的"双 ESP32 + 无线"方案，最终方案减少了无线链路的调试风险，把有限的课时集中在电源、驱动、交互与结构这些更基础、更可验证的环节上；这一调整的代价是开题指标中的无线遥控一项未能实现，已在报告中如实说明。

在硬件设计上，主板为 95×95 mm 双层板，完成了输入保护、双电源域、电机与舵机接口、I2C 与单总线、语音隔离跳帽等电路；ERC 与 DRC 均为 0 违规，Gerber 制造审计 14 项全部通过。设计过程中印象最深的是"39 处净距违规"的排查：最初以为是布线错误，逐条核对坐标后才发现是圆弧用 10 边形近似带来的 3 µm 误差，把近似段数改为 64 后全部归零。这件事让我意识到，工具的输出需要人来判断，工程结论必须能追溯到依据。

在软件上，固件按"驱动层—状态机—应用层"分层，状态机被抽成不依赖硬件的纯逻辑，可以在 PC 上跑 46 个断言；主循环 20 ms 节拍，DHT11 每 2 s 采样，OLED 每 150 ms 刷新；语音模块与主板之间定义了 20 余条命令字与 ACK 机制，并额外驱动两块 MAX7219 点阵做表情交互。调试阶段通过串口 CLI、分段上电与"现象—分析—处理—结果"的记录方法，定位并解决了 I2C 热插拔死锁、编码器跳数、舵机启动抖动等问题。

受器件、仪器与时间限制，本项目仍有明显不足：焊接与整机联调尚未完成，语音与手势的识别率、温控精度、续航与噪声等指标没有实测数据；外壳虽然通过了 STL 几何复核（三件合计 68.97 cm³，低于 70 cm³ 打印限额），但整机装配关系尚未闭环，BluePill 的 USB 开孔、舵机与主板的投影重叠、OLED 与面板的平行度等问题仍需改版；DHT11 位于机内，测温受功率器件发热影响；连续舵机没有位置反馈，扫风角度只能靠时间近似。这些问题不是"做不出来"，而是"还没做到"，也是后续最明确的改进方向。

通过这次实习，我对"电子产品是怎么从一张图纸变成一个能用的东西"有了完整的认识：它不只是画对原理图和写对代码，还包括选型时的取舍、布局时的回流路径、打样前的工艺检查、调试时的分层定位，以及把每一处"为什么"写清楚的习惯。这些方法比任何一个具体的知识点都更有价值。

---

## 5.2 版本 B（平实版，约 700 字，适合口语化答辩稿）

这次实习我们做的是一个能听、能看手势、能自己调温的小风扇。刚开始定的方案是两块 ESP32 加无线遥控，后来发现课时和器件都不允许，就改成了单块 STM32 加板载手势传感器。改动之后功能反而更稳，因为少了一条无线链路要调。

硬件上我负责的部分让我第一次完整走完了"原理图—PCB—打样—审计"的流程。板子 95×95 mm，双面，电机、舵机、语音、显示都挂在一块板上。印象最深的是打样前的净距检查报了 39 个错，查了半天发现是画图软件用十边形近似圆造成的误差，把精度调高就没了。这件事让我明白，软件报的错不一定是我们画错了，但一定要查到底。

软件上我们把风扇的运行逻辑做成了一个状态机：待机、手动、自动、测试四个状态，按键、语音、手势都只是"事件"。这样改逻辑的时候不用碰驱动，还能在电脑上直接跑测试，46 个测试全过的时候挺有成就感的。调试时最有用的是串口命令，比如 `status` 看当前状态、`test i2c` 扫总线、`test servo` 让舵机正反转，很多问题不用示波器也能定位。

不足也很明显：板子焊出来之前，很多指标只能靠设计和仿真说话，语音识别率、手势识别率、温控准不准都还没有实测；外壳打出来了，但装上去之后 USB 口对不上、舵机跟主板位置打架，这些是下一版必须改的。我个人觉得，能把"哪里没做好"讲清楚，比硬说"全部完成"更有意义。

如果继续做，我想先补三件事：一是把实物焊完、把测试表填满；二是把外壳的装配关系重新对一遍，尤其是 USB 开孔和按键高度；三是给舵机加限位或者换位置舵机，让扫风角度可控。

---

## 5.3 可直接替换的模块

### 5.3.1 不足（按重要性排序，挑 4–6 条）

1. **实物环节未完成**：焊接、整机联调、实测数据缺失，是本次最大的短板。
2. **指标未闭环**：语音/手势识别率、响应时间、1 h 稳定性没有实测；无线遥控未实现。
3. **结构装配未闭环**：USB 开孔、舵机槽与主板重叠、OLED 与面板平行度、按键高度基准等问题待改版；无 12025 风扇支架。
4. **测温位置不合理**：DHT11 在机内，受 LDO/电机热影响，自动温控会偏高。
5. **扫风无反馈**：连续舵机靠时间近似角度，长期运行会漂移，存在绞线风险。
6. **电源边界**：2 A 只是目标值，条件仿真显示输入偏低或线阻偏大时母线会跌破 4.5 V。
7. **可维护性**：无测试点、无 ESD 保护、丝印偏小。

### 5.3.2 建议（给下一届/后续版本）

1. **先做最小可演示系统**：电源 + 主控 + 一个执行器 + 一个交互，先让它跑起来，再逐步加模块；不要一开始就追求"全功能"。
2. **模块化与跳帽隔离**：语音、手势、显示都用排母/跳帽，调试时能单独断开，能省大量时间。
3. **给每块板留测试点**：5 V、3.3 V、GND、PWM、I2C 各一个，调试时不用到处找焊盘。
4. **结构先做"装配仿真"**：把模块的 3D 模型（哪怕方块）放进壳里，先查干涉，再打印；打印一次几十克料，改一次很贵。
5. **文档与代码同步**：方案一改就改文档，否则报告阶段会出现"文档说 12 V、板子是 5 V"的尴尬。
6. **测试表先行**：在焊之前就把"测什么、怎么测、合格范围"写成表，焊完照着填，效率最高。

### 5.3.3 个人体会（按分工挑一条，或改写）

- **硬件方向**：最大的收获是学会了"按规则画板"——线宽按电流、分区按回流、丝印按可读性，而不是"连上就行"。也第一次体会到 DFM 检查的价值：它能在打样前把几微米的误差找出来。
- **软件方向**：把状态机抽成纯逻辑、用 46 个断言保护它，是我这次学到的最有用的方法。以前改代码靠"感觉没坏"，现在改完跑一遍测试就知道。
- **结构方向**：3D 打印不是"画完就能装"，公差、悬垂、螺钉柱、拔插路径都要在模型里想清楚；体积限额也逼着我们把壳体做薄、做空。
- **调试方向**：没有示波器的时候，"分段 + 替换 + 对比"三招最管用；记录"现象—假设—验证—结论"比记住某个 bug 更重要。

---

## 5.4 写作提示

- 第 5 节最忌两点：一是空话（"通过本次实习我学到了很多"），二是吹牛（"各项指标均达到预期"）。
- 用"完成了什么 / 没完成什么 / 为什么 / 下一步"四段式，最稳。
- 体会要具体到一件事（39 处净距、I2C 死锁、46 个断言），比形容词有说服力。
- 团队报告可以每人写一段体会，但**不要重复**，按分工写各自的那部分。
