Lucian-ming/smart-fans/artifacts/asr_development_dimensions_review.md

# ASRPRO开发板V1.1：尺寸与直插坐标补证

来源：[新开发板规格书](<E:/桌面/原理图/ASRPRO开发板规格书V1.1.pdf>)、[用户引脚示意截图](<E:/图片/Screenshots/屏幕截图 2026-11-04 163520.png>)。只读审查，没有修改主生成器。

## 已取得证据

- PDF页3/4开发板外形30×28mm，表2公差±0.2mm，用户也确认30×28。
- 页5电源3.6V最小、5V典型、5.5V最大；表2要求供电能力>500mA；播音典型70mA，NOTE2最大250mA。不能把250mA当整机电源余量。
- 页8：3V3是内部LDO输出，电流不超过10mA。母板该针保持NC，禁止作为主系统3.3V源或并联另一LDO。
- 页7/8明确16脚编号及UART1复用：PA2=TX1，PA3=RX1。
- 页6尺寸图OCR读到2.54mm及8个等距孔，孔中心图像相邻约49pixel；不依赖旧2×7假设。
- 图中另有25.60mm、23.70mm、28.0±0.05mm、0.90mm、6.10mm、5.50mm、2.20mm、PCB1.20±0.05mm等标注。**本模型不能看图，无法可靠关联尺寸线端点，不能仅按OCR把25.60或23.70任取为两排中心距。**

[PDF正文提取](<D:/smart_fans/artifacts/user_module_sources/asr_development_spec.txt>)、[页6图](<D:/smart_fans/artifacts/user_module_sources/asr_spec_dimensions.png>)、[OCR词框](<D:/smart_fans/artifacts/user_module_sources/asr_spec_ocr.json>)。

`read_image`实际返回：`model "gpt-6-astra" does not declare image input; switch to an image-capable model to read images`。因此未声称视觉核实。旋转OCR未成功识别竖向尺寸，未拿其乱码作证。

## 顶视引脚表与参数化坐标

以下方向采用用户引脚示意图：两列从图上到下，左侧顶为GND，全局pin1；右侧顶为PA4，全局pin16。这是示意图顶视，**实物插接面对齐/USB朝向尚未完成**。坐标定义X向右、Y向下，原点取16针包络中心，两排中心距S未知；单排节距2.54mm。不能当成已可投产固定坐标表。

| 行 | Y/mm | 左列X=-S/2：全局脚/功能/母板网 | 右列X=+S/2：全局脚/功能/母板网 |
|---|---:|---|---|
| 1 | -8.89 | 1 GND / GND | 16 PA4 / NC |
| 2 | -6.35 | 2 5V / +5V_ASR | 15 GND / GND |
| 3 | -3.81 | 3 PB5 TX0 / NC | 14 3V3 / NC |
| 4 | -1.27 | 4 PB6 RX0 / NC | 13 PA0 / NC |
| 5 | +1.27 | 5 PA2 TX1 / MCU_RX | 12 PA1 / NC |
| 6 | +3.81 | 6 PA3 RX1 / MCU_TX | 11 PC4 / NC |
| 7 | +6.35 | 7 PA5 TX2 / NC | 10 SPKL− / SPK− |
| 8 | +8.89 | 8 PA6 RX2 / NC | 9 SPKL+ / SPK+ |

若每个母座局部编号均自顶向下1..8，左座对应全局1..8、右座对应全局16..9。前一板载CH340图中P1编号方向相反（P1.8=GND，P1.1=PA6），故不能把“左座local1”与旧PDF的“P1.1”混用。功能网络映射优先于文档不同编号惯例。

## 版本一致性仍需确认

新规格书第9/10页用**外置STC-LINK**给开发板供电和下载；不能仅凭“开发板”一词就认定它和此前2022-10-10板载CH340/USB-C原理图是同一实物版本。用户截图OCR内容是开发板引脚复用示意图，不是含尺标/USB朝向的实物测量照片。因此此前Q1/D2反灌分析仍只适用于那份板载CH340图，尚未证实可以完整移植到新规格书板。

## 未通过门禁

1. 两排中心距S与尺寸线的对应关系，以及直插实物一致性；请用户直接读出尺寸图对应值或测量两排中心距。
2. 实物顶视Pin1与USB/麦克风方向；新资料未建立USB朝向。
3. 母座塑壳外宽、板底器件净空、插入高度、孔径与选定母座规格。

本轮未修改ASR左右组件，原因是S仍缺可靠确认。电气映射和2.54mm行坐标已足够让父代理在S/方向确认后建两个1×8母座，但不应拿未知值填空生成生产文件。
