Lucian-ming/smart-fans/artifacts/asr_jumper_relocation_review.md

# ASR三跳帽移位检查

## 最终状态（取代下文初始5mm步距）

父代理明确保留原独立6×8mm操作区测试，因此最终三座均X29，首针Y分别 **50.8 / 59.0 / 67.2mm**，第二针各+2.54mm；中心步距8.2mm。未修改或降低ASR测试约束。

实跑 `test_asr_interface_ast.py`、`test_revb_exact_parts_ast.py`、`test_ec23_interface_ast.py` 均exit0。ASR四负例拒绝、元件测试5项通过、EC四负例拒绝。ASR受影响座间最小铜距 **3.960mm**；包含每座内部两针时最小铜距 **0.840mm**。独立操作区互相留0.2mm间隙，与其他pad无交叠；与已知核心板框横向净距仍≥4.07mm。TB实际板框仍未定，未冒称整机机械签核。

精确元件测试网号完整性仅由 `{1..35}-{23}` 更新为 `{1..35}-{23,32}`，额外断言ENC_SW不存在；其余ID完整性没有取消。

## 以下为此前初始5mm步距检查历史

2026-11-04：按父代理指定仅移动[生成器](<D:/smart_fans/tools/build_perfect_revB_v3.py>)内三座，针号、电气身份、2.54mm针距均不变：

| 座 | 第一针XY mm | 第二针XY mm | 网络1→2 |
|---|---|---|---|
| JP_ASR | 29,54 | 29,56.54 | +5V→+5V_ASR |
| JP_ASR_TX | 29,59 | 29,61.54 | VOICE_TX→ASR_RX1 |
| JP_ASR_RX | 29,64 | 29,66.54 | VOICE_RX→ASR_TX1 |

AST及Shapely真实圆铜/矩形SMD逐pad复核：包括同座与相邻座的最小铜间距 **0.760mm**（JP_ASR.2→JP_ASR_TX.1），满足≥0.25mm。尚无新路由检查，不可据此批准旧走线。

已核实核心板板框为X36.07..58.93、Y13.33..66.67mm；每座以x±3、y−2..y+6定义的6×8mm候选操作区，与核心板框最小距离 **4.07mm**。

TB当前已知针列x8/23、y27.11..44.89；模块真实板框尺寸仍未证实，不能把pin bounds冒称body bounds。三JP第一针最低Y54，不在TB针列范围内，但不等于板体证明。

## 现有可达性测试失败解释

[ASR接口测试](<D:/smart_fans/tools/test_asr_interface_ast.py>)电气与铜间距断言通过，失败于原第67行独立6×8mm操作区不得覆盖其他pad断言：
- JP_ASR区域覆盖JP_ASR_TX.1；
- JP_ASR_TX区域覆盖JP_ASR.2与JP_ASR_RX.1；
- JP_ASR_RX区域覆盖JP_ASR_TX.2。

没有覆盖非JP焊盘。5mm同列中心间距本身不会给每个跳帽8mm高独立空区。应明确选择共享侧向操作区，或加大间距，不可静默删断言伪报可达性通过。父代理已收到此条件差异，本轮尚未修改此测试。
