Lucian-ming/smart-fans/artifacts/core_header_mapping.md

# 用户核心板40脚非镜像映射审计

只读计算，不修改生产生成器。PcbDoc的125pad记录完整解析；Nets6为空，逻辑信号来自本地原理图PDF，不宣称提取原生网表。

## 顶视变换
`X母板 = 47.5 - 0.0254*(Y_Altium - 6022)`
`Y母板 = 40.0 - 0.0254*(X_Altium - 18541)`
Altium单位mil/Y向上；母板mm/Y向下。矩阵[[0,-s],[-s,0]]，s=.0254，det=-.00064516，AᵀA=s²I：坐标约定翻转加刚体旋转，无物理镜像。
P4→J_MCU_L中心(39.88,40)，P3→J_MCU_R中心(55.12,40)；两排dy=24.13-(pin-1)*2.54；pin1在Y64.13，pin20在Y15.87。保留pin号/net，仅反转旧dy，必须重新布线。
USB原点(19442,6022)mil→(47.5,17.1146)mm，靠低Y。板框X17491..19591/Y5572..6472mil→母板X36.07..58.93/Y13.33..66.67，22.86×53.34mm。USB原点不是插口边缘，不代表外壳适配。
旧P4左/P3右且pin1向上pin20向下方案符号面积同号，是镜像，尽管pitch及排距正确。

## 40脚表
|核心板|脚|PDF信号|母板座|X mm|Y mm|dx|dy mm|运行时net快照|
|---|---:|---|---|---:|---:|---:|---:|---|
|P4|1|VCC3V3|J_MCU_L|39.88|64.13|0|24.13|NC|
|P4|2|GND|J_MCU_L|39.88|61.59|0|21.59|GND|
|P4|3|5V|J_MCU_L|39.88|59.05|0|19.05|+5V_MCU|
|P4|4|PB9|J_MCU_L|39.88|56.51|0|16.51|DHT11_DATA|
|P4|5|PB8|J_MCU_L|39.88|53.97|0|13.97|SERVO_PWM|
|P4|6|PB7|J_MCU_L|39.88|51.43|0|11.43|I2C1_SDA|
|P4|7|PB6|J_MCU_L|39.88|48.89|0|8.89|I2C1_SCL|
|P4|8|PB5|J_MCU_L|39.88|46.35|0|6.35|NC|
|P4|9|PB4|J_MCU_L|39.88|43.81|0|3.81|NC|
|P4|10|PB3|J_MCU_L|39.88|41.27|0|1.27|NC|
|P4|11|PA15|J_MCU_L|39.88|38.73|0|-1.27|NC|
|P4|12|PA12|J_MCU_L|39.88|36.19|0|-3.81|NC|
|P4|13|PA11|J_MCU_L|39.88|33.65|0|-6.35|NC|
|P4|14|PA10|J_MCU_L|39.88|31.11|0|-8.89|NC|
|P4|15|PA9|J_MCU_L|39.88|28.57|0|-11.43|NC|
|P4|16|PA8|J_MCU_L|39.88|26.03|0|-13.97|NC|
|P4|17|PB15|J_MCU_L|39.88|23.49|0|-16.51|BUZZER_CTRL|
|P4|18|PB14|J_MCU_L|39.88|20.95|0|-19.05|KEY2_SIG|
|P4|19|PB13|J_MCU_L|39.88|18.41|0|-21.59|KEY1_SIG|
|P4|20|PB12|J_MCU_L|39.88|15.87|0|-24.13|NC|
|P3|1|VBAT|J_MCU_R|55.12|64.13|0|24.13|NC|
|P3|2|PC13|J_MCU_R|55.12|61.59|0|21.59|NC|
|P3|3|PC14|J_MCU_R|55.12|59.05|0|19.05|NC|
|P3|4|PC15|J_MCU_R|55.12|56.51|0|16.51|NC|
|P3|5|PA0|J_MCU_R|55.12|53.97|0|13.97|TB_PWMA|
|P3|6|PA1|J_MCU_R|55.12|51.43|0|11.43|TB_AIN1|
|P3|7|PA2|J_MCU_R|55.12|48.89|0|8.89|VOICE_TX|
|P3|8|PA3|J_MCU_R|55.12|46.35|0|6.35|VOICE_RX|
|P3|9|PA4|J_MCU_R|55.12|43.81|0|3.81|GEST_INT|
|P3|10|PA5|J_MCU_R|55.12|41.27|0|1.27|TB_AIN2|
|P3|11|PA6|J_MCU_R|55.12|38.73|0|-1.27|ENC_A|
|P3|12|PA7|J_MCU_R|55.12|36.19|0|-3.81|ENC_B|
|P3|13|PB0|J_MCU_R|55.12|33.65|0|-6.35|TB_STBY|
|P3|14|PB1|J_MCU_R|55.12|31.11|0|-8.89|NC|
|P3|15|PB10|J_MCU_R|55.12|28.57|0|-11.43|NC|
|P3|16|PB11|J_MCU_R|55.12|26.03|0|-13.97|NC|
|P3|17|NRST|J_MCU_R|55.12|23.49|0|-16.51|NC|
|P3|18|VCC3V3|J_MCU_R|55.12|20.95|0|-19.05|NC|
|P3|19|GND|J_MCU_R|55.12|18.41|0|-21.59|GND|
|P3|20|GND|J_MCU_R|55.12|15.87|0|-24.13|GND|

## 验证边界
- 40脚坐标、2.54节距、15.24排距、正交性、USB低Y通过；旧镜像负例拒绝。主脚本位置不匹配数：0（运行时快照，非产物放行）。
- 核心板元件面向上，排针向下插母板顶面排母，不翻板。
- P3.20=GND非5V，已据本地PDF正式接GND；P4.1/P3.18为核心板3V3输出需隔离母板LDO；单5V入口P4.3。
- 未证明USB防反灌、负载能力或完整装配。
- [源解析](<D:/smart_fans/artifacts/read_core_altium.py>) / [原始记录](<D:/smart_fans/artifacts/core_altium_records.json>) / [测试](<D:/smart_fans/tools/test_core_header_mapping.py>) / [40脚JSON](<D:/smart_fans/artifacts/core_header_mapping.json>)
