Lucian-ming/smart-fans/artifacts/ec23_coordinate_evidence.md

# 江协2+3编码器：第二轮孔位取证（2026-11-04）

## 更新：用户实测已取代以下图像估测历史

2026-11-04 18:19父代理转达用户实测：组中心距 **21mm**；上2针从左 **VCC/GND**，下3针从左 **A/C/B**。当前据此落图，不再使用21.7mm图像推算或旧针序未知结论。

已修改[生成器](<D:/smart_fans/tools/build_perfect_revB_v3.py>)仅EC相关：J_ENC原点(71,82.5)；上排±1.27,Y=-21，下排-2.54/0/+2.54,Y=0；五脚网络3V3/GND/ENC_A/GND/ENC_B。MCU PB12设NC，ENC_SW网络删除；原错误1x5母座料号撤除。未改其它模块、未全板重建。

[AST接口测试](<D:/smart_fans/tools/test_ec23_interface_ast.py>)实跑通过，四个针序/坐标负例全拒绝；与其他元件焊盘最小净距5.2360mm。结果在[测试JSON](<D:/smart_fans/artifacts/ec23_interface_test.json>)。这一结果只检查当前焊盘，不是新布线DRC或装配签核。

### 模块板体条件风险

EC若按约24mm宽居中、Y跨越两组座估计，投影约X59..83、Y59..87；此为保守条件区而非精确板框。OLED排针中心(78.5,55)，若其约27mm板身向+Y延伸，会与EC投影重叠；现有资料没有证明模块安装方向和离板高度，不宣称一定干涉或一定无干涉。

更直接的可达性风险：JP_ASR(62,69/71.54)、JP_ASR_TX(70,69/71.54)、JP_ASR_RX(78,69/71.54)均位于上述EC条件投影内。三帽都要求USB前拔掉，需核板下净高、拔帽可达性，或由总布局将三帽移出EC投影。未擅自扩大修改范围。

以下保留为实测之前的取证历史，不再作为当前21mm/ACB设计的未知项。

## 公开原生工程

实读[PID电机控制底板_江协科技同款](https://oshwhub.com/id_shift/pid-dian-ji-kong-zhi-_-zai-xian)，HTTP200。页面作者称依据江协开源原理图复刻底板，并非江协原始模块CAD。公开内嵌数据项目UUID `6af32f99ba774cdfa2778fb8da9a823b`，`public=true`，`origin=pro`，`attachments=[]`，`version_documents=[]`。正文显示“未生成预览图，请在编辑器重新保存一次”“暂无BOM”，3D及附件无数据。没有获得可直接下载的原生封装或孔坐标，亦没有访问私有数据、借用用户登录态或绕过权限。

浏览器新独立页工具因schema强制nativeWindowHandle/processId与new-tab冲突报INVALID_ARGUMENTS，未开页面；以上来自公开HTTP静态内容而非操作用户会话。

## 本地说明图片测量

源：[旋转编码器模块使用说明](<E:/桌面/原理图/11-旋转编码器/旋转编码器模块使用说明.png>)。已有[裁剪脚本](<D:/smart_fans/artifacts/prepare_module_ocr.py>)取原图 `(200,2680,600,3240)` 再等比3倍；[测量区域](<D:/smart_fans/artifacts/user_module_sources/ec_0.png>)为1200×1680像素。已有完整OCR只检出24mm，没有第二轴数字。原说明明确标注“手工测量有误差，请以实物为准”。未做人工视觉核验，模型不能读取图像输入。

[只读测量脚本](<D:/smart_fans/artifacts/measure_ec23_image.py>)用OpenCV在五个OCR候选孔邻域提取亮色内边界。阈值150/200/230变化较大，不能当精密CAD测量。稳定候选如下，单位为放大后的像素：

| 孔位置 | 中心X | 中心Y | 备注 |
|---|---:|---:|---|
| 上左VCC | 约451 | 约378 | 亮区分裂，中心至少约±10px不确定 |
| 上右GND | 566.5 | 375.0 | 阈值150内边界71×72px |
| 下左 | 388.0 | 1380.5 | 内边界74×73px |
| 下中 | 507.0 | 1381.5 | 内边界70×71px |
| 下右 | 623.0 | 1384.0 | 内边界66×66px |

下排相邻像素节距119与116，平均117.5。**假设**该排实际为2.54mm且XY没有透视/非等比失真，则比例46.26px/mm；上下排平均中心距离1005.5px，对应约21.74mm；上排中心X509左右，下排中心X506左右，接近居中。上排两孔约115.5px，按同尺度约2.50mm，与用户接受2.50/2.54的0.04mm差相符，但不是实际2.50mm的证明。

此假设下局部候选坐标（不是生产批准坐标）：以3P中孔为(0,0)，图像X右/Y下：下排(-2.54,0),(0,0),(+2.54,0)；上VCC约(-1.21,-21.7)，上GND约(+1.29,-21.7)。为便于母座对称设计可约化成上排±1.27，但不得将约化描述成CAD读数。

## 不确定性与采用边界

1. 24mm标注两端没有定位，不能将它直接绑定PCB宽或两组间距。
2. 图像阈值中心误差可达0.2mm；上下孔图像直径不完全一致，下排两节距差2.6%，可能是像素、照片/透视或不同孔形所致。单此比例差外推21.7mm就约0.55mm，远大于用户接受的0.04mm两针节距差。
3. 不能从这张图证明正交投影。21.7mm只属候选布局，不是有保证的21.5、21.59或22mm。原生CAD、卡尺组间距或实际试插至少需要一项才能批准刚性双母座同时直插。
4. 图像只可靠定位上排VCC左/GND右；下排A/B/C的物理左右顺序仍需清晰丝印确认，文字“A、B、C(GND)”列举不自动等于图像从左到右。
5. 若必须先出可试装样板，应将此项明确列为几何假设并采用经制造验证的调整/槽孔方案，而非称精确封装已核验；用户坚持直插不等于许可把未知尺寸填成已知。

结论：第二轮得到有依据的约21.7mm组间距与近居中2+3候选几何，尚未得到原生封装。没有修改生成器、生产PCB或采购文件。
