Lucian-ming/smart-fans/artifacts/oled_asr_layout_conditions.md

# OLED / ASR 首次打样安装约定

## 最新实施状态（替代下方历史未实施方案）
父会话明确授权按设计安装约定落地，而非声称已证实实物方向。现已修改ASR两排座Y=44.0、排距25.4及针序不变；OLED针排中心(78.5,26.5)，屏体必须朝-Y，母板顶视左到右SDA/SCL/VCC/GND，pin1/GND在右。对应pin1..4绝对XY为(82.31,26.5)/(79.77,26.5)/(77.23,26.5)/(74.69,26.5)。PCB全局坐标需再加主生成器原点偏移。

屏体到负Y边必须<=26.5mm减板边余量，到正Y边必须<3.5mm减与ASR装配余量；这些为安装限制，不是实物尺寸测量结论。ASR名义Y30..58，EC名义Y59..87，两者名义间隙1mm。OLED未知另一轴尺寸、FPC、玻璃/焊点突出及公差仍须试装。实物丝印针序未核不得上电；不满足条件需返工，不宣称量产或完整装配签核。屏幕需配合180度固件显示方向。

[test_oled_installation_ast.py](../tools/test_oled_installation_ast.py)正例及3负例通过；[test_asr_interface_ast.py](../tools/test_asr_interface_ast.py)回归正例及4负例通过，ASR板体访问包络改为随座中心计算。未修改JP/EC/TB/路由/丝印函数，逐针功能标签交父代理统一添加；未全build。

## 历史评估（坐标28已被26.5替代）

## 本轮结论
仅凭已有资料不能确定OLED四针B板排针位于哪条边，以及显示面朝上时从左到右的物理针序。IIC原理图仅证明J1逻辑1=GND、2=VCC、3=SCL、4=SDA，不能用于推断物理左右。结构PDF全部轮廓文字，已提取OCR仅稳健读出PCB长27.3mm、玻璃长26.70mm、P2.54等；完整板框、pin1与板框偏移未确证。不得据此擅自将OLED左右接线反转。没有修改ASR/OLED主源、JP、EC、TB或路由。

## 条件方案
父建议ASR中心(78.5,44)，以用户已确认30x28板外框且排针中心与板中心一致为假设，包络X63.5..93.5/Y30..58；EC暂定包络X59..83/Y59..87，因此二者名义Y间隙1mm。这不包括尺寸公差、插拔及接口突出部分。

OLED排针中心可候选(78.5,28)，但只有同时满足以下条件才可实施：
1. 安装后屏幕模块板体向负Y延伸，且排针线至负Y边距离不超过28mm；向正Y伸出量需小于2mm减装配余量，才能与ASR的Y30边避让。
2. 若从排针至负Y边为27mm，名义板边在Y1。若实际27.3mm为此方向长度且针线近端边，边缘会更接近主板，不能把“27.3 PCB长”直接套作该距离。
3. OLED显示面朝上时的针序、pin1位置必须由实物/结构图明确。如果确实由原放置绕Z轴转180度，当前左到右GND/VCC/SCL/SDA会变成SDA/SCL/VCC/GND。保持脚号网络功能不变，将对应pad X偏移取反即可；不得只改注释或只翻显示画面。
4. 屏幕转180度还需固件显示方向配合；SSD1306类可通过SEG/COM扫描方向配置，但控制器具体实现应核固件。
5. 如有玻璃、FPC、焊点、排针塑壳突出，仍需计入真实包络。

## 为什么未单独移动ASR
当前OLED header在Y55。ASR若先移到Y44，板体占Y30..58，会把现有OLED针排纳入ASR投影；在OLED方向未确认前单独执行此移动反而新增明确风险。因此两者应一次性联动修改并重新验证，不先落地半个方案。

## 最小待确认信息
用户从显示面正视，报告四针在屏幕上方还是下方、从左至右的丝印顺序，以及排针中心线到板体两侧边的距离（沿屏幕上下方向）。若母板仍需独立精确直插，清楚照片或测量优于按“通用0.96”猜测。

参考已有证据：[用户模块审计](user_module_source_review.md)、[结构PDF提取](user_module_sources/pdf_0.json)、[OLED原理图提取](user_module_sources/pdf_1.json)。本报告为条件几何，不是碰撞验收通过。
