Lucian-ming/smart-fans/artifacts/remaining_module_release_review.md

# TB6612 / EC11剩余PCB接口放行审计

2026-11-04，只读当前[主生成器](<D:/smart_fans/tools/build_perfect_revB_v3.py>)和用户本地资料；未修改主文件、ASR或生产产物。**结论：TB控制排的先前候选错序已不见于当前代码；TB直插排距/朝向仍无证据，EC接口形态仍不匹配且按压输出未证实，不宜直接冻结为“现有模块可直插”的生产板。**

## 1. 资料边界与独立核对方法

- TB目录只有[芯片PDF](<E:/桌面/原理图/9-TB6612电机驱动/TB6612FNG.pdf>)和[模块说明PNG](<E:/桌面/原理图/9-TB6612电机驱动/电机驱动模块使用说明.png>)；EC目录只有[模块说明PNG](<E:/桌面/原理图/11-旋转编码器/旋转编码器模块使用说明.png>)，无对应模块PCB源码/矢量机械图。
- 独立读取PDF前6页；pypdf报告若干“wrong pointing object”xref警告但成功恢复页文字。页3/5给出明确供电及逻辑参数，不能用芯片SSOP24尺寸替代模块两排孔距。
- 独立读取已有[原图OCR](<D:/smart_fans/artifacts/user_module_sources/ocr.json>)和[旋转OCR](<D:/smart_fans/artifacts/user_module_sources/ocr_rotated.json>)，没有把[既有结论报告](<D:/smart_fans/artifacts/user_module_source_review.md>)当原始针序证据。当前模型不能视觉读取图片，未假称人工辨清每一针或寸线。OCR的错误字符/空间对应不确定性保留。

## 2. TB6612：当前候选针序已对齐，缺的是物理证据

当前[控制排定义](<D:/smart_fans/tools/build_perfect_revB_v3.py#L247-L260>)，从母板低Y到高Y：

|位置|候选模块功能（OCR）|当前母板net|判断|
|---:|---|---|---|
|1|PWMA|TB_PWMA|一致候选|
|2|AIN2|TB_AIN2|一致候选，已不是AIN1|
|3|AIN1|TB_AIN1|一致候选|
|4|STBY|TB_STBY|一致候选|
|5|BIN1|GND|B通道不用，输入固定低|
|6|BIN2|GND|B通道不用，输入固定低|
|7|PWMB|GND|B通道不用，输入固定低|
|8|GND|GND|一致候选|

[动力排定义](<D:/smart_fans/tools/build_perfect_revB_v3.py#L263-L276>)为VM、VCC、GND、AO1、AO2、BO2、BO1、GND，对应+5V、+3.3V、GND、TB_AO1、TB_AO2、NC、NC、GND。OCR下6位支持此候选，顶部VM/VCC未充分稳定识别，不能称八位逐脚全部确认。

当前两排中心X=7.88/23.12，相隔**15.24mm**，每排中心Y=36，孔距2.54，pin1Y27.11、pin8Y44.89，端到端17.78mm。源PNG没有可采信的排间距数值；也没有严格绑定“同一顶视朝向下两排哪个端为pin1”。**即便八个名字正确，排距错误会插不进，左右/上下翻转会把VM/VCC送到错误位置甚至GND。**目前不能断言一定错，也不能批准直插。

供电不是本次新阻断：芯片PDF页3 VCC 2.7–5.5V、VM 2.5–13.5V；页5 VIH≥0.7VCC。当前VCC3.3V合理；不要为了模块“5V”字样把VCC升5V（VIH最低3.5V不保证3.3V MCU可靠驱动）。模块OCR正文VM4.5–10V，VM5V落在范围内，但此事实不证明130电机额定电压/堵转电流。

## 3. EC11：现有单排5P与资料2P+3P候选冲突

当前[J_ENC](<D:/smart_fans/tools/build_perfect_revB_v3.py#L493-L504>)是单排5P P2.54，Y82.5、X65.92/68.46/71/73.54/76.08，顺序**GND、3V3、ENC_SW、ENC_B、ENC_A**。这是假定带独立按压输出的单排接口。

但原始OCR接口文字是`VCC()C (V) GND`及`3P0号的出口；A ... B ... C(GND)`；尺寸图再次出现`VCC 0 0 GND`和下一行3个孔。旋转OCR也读到`VCC 0 0 GND`。**支持“2针电源+另3针A/B/C公共地”，不支持现有单排5针，更没有读到SW独立输出。**“未读到SW”不等于器件物理上绝无按压开关，但当前设计不能依赖其存在。

精确风险：
1. 若实物确为2P+3P分组，现有1×5排母不能直接插入，不是只需翻转顺序。
2. C标为GND，不应当作第三路按压输出；若线束把C接ENC_SW，按键输入会常低且实际按压功能不存在/不可用。
3. A/B互换通常只改变方向，固件可修；电源/GND/公共端错接则不是固件问题。
4. OCR写额定DC5V，缺输出上拉/电路图；现用3.3V是否正常、若5V供电A/B是否上拉到5V均未证明。不要仅凭EC11系列名认定可直接接MCU。
5. 唯一较稳定尺寸24mm不能确定轴向或排针相对位置；不能拿它算任意排距。

## 4. 最小用户问题（仅两组，足以决定PCB接口）

**TB：**“请量两排针中心线间距是否15.24mm，并拍/抄元件面朝上时两列从同一端开始的8个丝印；请标出VM和PWMA所在端。”可用卡尺测两排同侧针边缘距离（等直径时等于中心距）；不是板外宽。若不量，选择线束连接而非直插，需明确授权变更装配方式。

**EC：**“你的实物是单排5针GND/+ /SW/B/A，还是2针VCC/GND加另3针A/B/C？请给正反面清晰照片或逐针抄字；旋钮能否按下、按压是否有独立SW端？如果要直插，再量孔距及两组相对位置。”若实物只有A/B/C且没有可引出的SW，需要选择取消编码器按压功能/用现有独立按键代替，而非伪造SW网络。3.3V供电可用性应以对应模块电路或低压实测确认。

## 5. 冻结条件

- TB：确认15.24排距、2.54单排pitch与顶视两列同端针序，或明确改用带线序表的线束接口。
- EC：确认实际接口分组及SW有无后更改母座；若线束方案，明确A/B/C与电源端点映射，C接地，SW功能另定。
- 本次不要求重复确认ASR；不扩展到机械外壳。没有把缺证判成必错，也没有用几何DRC通过替代模块接口匹配。
