Lucian-ming/smart-fans/docs/00-roadmap.md

# 开发实施路线图

> 版本：v0.4 · 预算目标：≤ 200 元 · 周期：硬件打样先行，软件/机械并行

| 阶段 | 核心任务与交付物 | 状态 | 关键依赖与输出 |
| :--- | :--- | :--- | :--- |
| **1. 需求与选型** | 技术栈、引脚表、功耗与 200 元成本预算清单 | ✅ **已完成** | `docs/01-requirements.md`、`docs/hardware/pinmap.md` |
| **2. 原理图设计** | 嘉立创EDA 专业版改板：XL1509 降压 + 蓝板插座 + 4P风扇座 + 模块插座 | 🚀 **当前步** | 生成原理图与网表，导出 BOM 检查 |
| **3. PCB 布局布线**| 底座结构限高 25mm，电容与大电流铜皮 ≥ 1.5mm，DRC 0 错误 | 待进行 | 导出 Gerber 与坐标，使用嘉立创免费券投板 |
| **4. 器件采购** | 淘宝/立创一键购买：蓝板、12025风扇、MG90S、ASR-PRO、手势模块 | 待进行 | 采购总额控制在 110~120 元 |
| **5. 焊接与上电** | 先焊 DCDC 测 5V/3.3V 正常，再插核心板与模块，避免烧件 | 待进行 | 首板通电自检通过 |
| **6. 3D 外壳建模与代打**| 基于参考 1 STL 改动：前面板挖 OLED/手势/旋钮孔，轻量化 < 120g 送三维猴 | 待进行 | 打印费控制在 35~45 元 |
| **7. 固件分层开发** | PlatformIO + HAL：PWM调速、FG捕获、DS18B20、ASR-PRO、PAJ7620、OLED | 待进行 | 软硬件最小闭环打通 |
| **8. 整机总装联调** | 装入 3D 外壳，安装 12025 风扇与 MG90S 舵机连杆，老化运行测试 | 待进行 | 交付物完整验收 |
