Lucian-ming/smart-fans/artifacts/simulation_review/tlv1117lv_footprint_evidence.md

# TI TLV1117LV33DCYR 精确封装与采购核对

2026-11-04；只读核对，不修改生成器或交付物。

## 来源
- TI原厂 https://www.ti.com/lit/ds/symlink/tlv1117lv.pdf ，SBVS160C，PDF第22页 PACKAGE OUTLINE、第23页 EXAMPLE BOARD LAYOUT，DCY0004A/4214843/C 05/2026。
- 立创 https://item.szlcsc.com/16257.html 实际页面明确品牌TI、订货型号TLV1117LV33DCYR、商品编号C15578、SOT-223编带。未读取实时库存数量，不声称现货。
- 搜索还返回C48937499同名型号，但品牌JSMSEMI，不能作为TI原厂型号的替代采购证据。

## 原点与方向
原厂P23图为小引脚朝左、tab朝右。PyMuPDF提取真实PDF矢量轮廓，不依靠截图像素估测：小pad中心X=257.1355pt；tab中心X=355.7812pt；PKG中心轴X=306.4583pt，恰为两排中点；三小pad中心Y=202.8819/242/281.1181pt。图比例17.0079pt/mm。转换到当前U3小引脚朝+Y、pin1在-X朝向后，封装原点就是两排中点，无需额外bodycenter偏置。

推荐以原封装中心(0,0)，单位mm：

```python
pads = [
    ('1', -2.3,  2.9, 'GND',   0.95, 2.15),
    ('2',  0.0,  2.9, '+3.3V', 0.95, 2.15),
    ('3',  2.3,  2.9, '+5V',   0.95, 2.15),
    ('2',  0.0, -2.9, '+3.3V', 3.25, 2.15),
]
```

铜焊盘圆角R0.05。若生成器仍输出rect，它是推荐焊盘外包矩形，略增四角铜面积；不能宣称弧形逐点一致，仍须整板间距复验。机械封装图把tab标4，但电气Pin Functions是OUT2/Tab，因此保留重复编号2且同网，原理图只一份电气pin2。

## 机械包络和可焊覆盖
原厂P22：本体沿三针排列方向6.3..6.7mm，横跨引脚方向本体3.3..3.7mm，包含引脚总跨度6.7..7.3mm，高度<=1.8mm；小脚宽0.66..0.84mm、tab宽2.9..3.1mm，节距2.3mm，接触脚长0.75mm MIN。

新小铜宽.95相对最大脚宽.84，每边名义额外.055mm；tab铜宽3.25相对最大脚宽3.1，每边名义额外.075mm。焊盘沿Y的范围分别[1.825,3.975]和[-3.975,-1.825]，覆盖原厂推荐焊脚区域；最大引脚外包跨度7.3mm即±3.65，铜外缘±3.975留出.325mm名义toe伸出。这里是标称中心对齐几何说明，不是贴装公差链或工艺认证；以TI已发布land pattern作为设计依据。

## 使用边界
原厂允许零负载且0Ω ESR陶瓷，名义输出电容至少1uF、考虑直流偏压/温度/老化后的有效值>0.5uF。换LDO不自动证明现电容具体型号偏压曲线已核。VIN推荐最高5.5V、绝对最大6V；OUT>IN反流不限，仍需约束USB/单侧上电。现无测试仪器，不应在文档中把上电/纹波/温升验收写成已完成。
