Lucian-ming/smart-fans/references/04_szu_smart_fan/SOURCE.md

# 深圳大学智能风扇控制系统 (Reference 4)

- **项目链接**：[立创开源硬件平台 - 智能语音风扇](https://oshwhub.com/ivy1999/zhi-neng-yu-yin-feng-shan)
- **作者**：ivy1999（深圳大学团队）
- **开源协议**：GPL 3.0
- **主控芯片**：STM32F103C8T6

---

## 1. 核心架构与功能特点

1. **主控与传感器**：
   - 采用 STM32F103C8T6 单片机，外设包含 DS18B20 数字测温模块与 ADC 电池电压采样分压网络。
2. **语音方案**：
   - 采用 **SNR8016** 系列离线语音芯片（高性价比一体化语音识别芯片），通过串口接收命令字。
3. **电源与电池检测**：
   - 设计了便携式锂电池供电与电源管理回路，ADC 引脚用于实时监控电池/输入端电压，防止电池过放，并在电压不足时提示报警。
4. **控制与通信**：
   - 蓝牙模块（HC-05 / JDY）无线遥控与状态回传。

---

## 2. 对本项目的参考价值

1. **电压检测与保护电路**：
   - 本项目引脚规划中预留了 `VBAT_SENSE`（PA5 / ADC12_IN5），该工程的电阻分压（10k + 3.3k）网络与低通滤波电容设计可直接参考。
2. **多源控制冲突仲裁**：
   - 当语音口令、按键和无线遥控并发触发时，该工程在软件中实现了优先级队列与去抖机制，避免风扇状态跳变。
