Lucian-ming/smart-fans/mechanical/concept_20261109/README.md

# 智能风扇外壳雏形 01

仅供外观和布局讨论，不能直接作为装配已验证的生产打印文件。

- 107×107mm平面外形，最高42mm，前侧25°斜面。壁厚名义2mm。
- 保持95×95mm母板，XY偏置6mm，四安装孔85mm孔距，板底Z7mm。PCB尺寸依据现有设计，安装高度为本雏形假设。
- 底座/顶盖两件。OLED移至后部水平区，不再用旧前面板孔位；按键有局部水平凸台；旋钮和手势窗口为待实物定位的占位孔。
- 后侧仅留电源线矩形出口，不冒称适配已购地博端子；不保留旧圆形DC口。
- 风扇头支架、舵机安装仓暂缓，不生成虚假的通用安装孔。
- 顶盖目前只有定位边，无最终锁盖螺丝/卡扣，不能把它当可靠固定结构。螺柱试孔为2.4mm设计值，需根据螺丝/材料试样再定。
- STL已各自落地Z=0，预览爆炸图则恢复装配坐标。网格检查与材料体积见geometry_check.json；水密不等于防水，不等于装配无干涉。
- 模块高度、按钮露出、屏面偏移、旋钮轴心、USB位置、线束弯曲空间尚未实测。当前窗口不代表最终孔径。25°形态保留，但孔位后续允许改变。
- 70cm³是此前材料预算目标，本版以实际报告数值为准，不为追预算削薄未知承重结构。

下一版：根据模块实物锁定开孔，补锁盖结构、通风与扬声器布局，进行元件包络干涉校核，然后才输出最终打印建议。
