Lucian-ming/smart-fans/artifacts/asr_power_path_followup.md

# ASR直插方案：USB与P1.7电源通路续审

用户已明确仍要直接插母板，不接受线束。原报告线束建议已被否决；必须根据实测排距/朝向建立两个1×8直插座。尺寸由父代理向用户索取，本轮不改设计。

## PDF直接重建

```text
USB VBUS → D2 SS14(1=A,2=K) → 板内5V → Q1(2=S,3=D) → VOUT → P1.7
                                │                     │
                            CH340K.7              8002A.6
                                                      │
                                               R3 4.7Ω→ASR VIN5V
Q1.1 Gate → R9 47kΩ → GND
Q1.1 Gate → R10 330Ω → Q2.3
Q2.1 → R11 3.3kΩ → RTS；Q2.2 → DTR
Q1体二极管：VOUT(D) → 板内5V(S)
```

来源：[用户原理图PDF](<E:/桌面/原理图/ASR-PRO语音模块资料/ASR-PRO语音模块资料/ASR-PRO开发板原理图（板载CH340）.pdf>)、[文字/网络坐标](<D:/smart_fans/artifacts/user_module_sources/asr_pdf.json>)。

Q1图示型号`LP2301`，BOM库描述`AO3401A P道沟 X13A15 SOT-23`，未给完整厂牌型号。G/S/D和体二极管结论基于本PDF符号和网表，不等于实装器件丝印已核实。

复核PDF矢量：PyMuPDF get_drawings() 第1页seq684为Q1.3右端，seq685为Q1.1下端，seq686为Q1.2左端；seq690体/源连接左端。seq700体二极管三角尖向左，seq702阴极竖线x609.3926；seq703右端接pin3，seq704左端接pin2，故阳极为VOUT、阴极为5V。D2 seq260三角尖向右，与PID201左/PID202右及VBUS/5V网络一致。嵌入网络亦证实PIQ102/PIU207/PID202同网，PIQ103/PIP107/PIU306同网。

## 电压和反向供电

1. USB供电时P1.7为VBUS扣除D2及Q1压降，**不是精确5.000V稳压输出**；下载控制可切断Q1。未从静态图量化最低电压/最大电流。
2. 母板5V经JP_ASR给P1.7时，VOUT约为母板5V减接点/线阻压降；它会经Q1体二极管给板内5V和CH340反向供电。Gate被R9下拉后Q1也可能导通，MOS沟道导通时双向。这是确定存在的路径。
3. D2方向阻断板内5V直接正向回灌USB VBUS，但不能据此推断USB数据线、其他IO、实物不同版本均零漏流。
4. 外供VOUT绕过Q1的下游断电功能，因此JP_ASR闭合时下载自动电源循环可能失效，USB下载前拔JP有明确必要性。

## 对“单电源跳帽+3V3 NC”的判断

母板5V→可拔JP_ASR→P1.7，使用USB前拔JP，P2.6 3V3保持NC：**可作为待测试的人工互斥供电安排，不能单凭这些签核全状态安全。**

已知剩余问题：拔JP只切主5V，不切UART。USB使ASR上电而主板掉电时，ASR TX可能经主控RX的输入保护结构向母板注入电流；母板先上电而ASR掉电时反向也可能发生。现有资料没有证明两端输入具备Ioff/断电容限。把3V3 NC不会消除此路径。UART1可避开CH340占用UART0的数据冲突，但不能消除跨电源域反灌。

最低限度的可审计方案是增加TX/RX可断跳帽：下载前断开JP_ASR及两路UART，保留共地，再插USB；恢复运行前拔USB再恢复跳帽。更稳健的方案是合适的掉电高阻/Ioff缓冲隔离器件，必须按两端电源域正确供电。普通串联电阻只能限流，不等于隔离，需依据器件注入电流额定值计算和实测。只保留单电源JP时，必须明确禁止哪些供电状态，并考虑上下电先后瞬态，不能称自动安全。

## 仍缺的证据

- 实物Q1完整型号/方向与本图一致性，厂家P1.7外供5V许可。
- 主控/ASR各UART脚断电耐受与注入电流规格；USB/JP切换及下载状态实测。
- 5V峰值负载、扬声器播放与电机舵机同时动作压降、电源预算。
- 真实16针排距、针距、Pin1方向和板外形/USB位置。

本轮只确定图纸拓扑及具体风险，不把未知当安全，不给未经测量的5V电流承诺。相关初审：[ASR针序审计](<D:/smart_fans/artifacts/asr_user_source_review.md>)。
