Lucian-ming/smart-fans/artifacts/revb_boot_sequence_review.md

# 启动时序与固件覆盖范围复审

## 已读取的事实（非仿真通过）
- [主程序](<D:/smart_fans/firmware/src/main.c#L27-L56>)只初始化HAL、时钟、GPIO和UART1并翻转PC13；PWM、电机、温度、OLED、语音、手势和应用状态机均为TODO。
- [GPIO初始化](<D:/smart_fans/firmware/src/main.c#L96-L122>)不初始化TB6612的STBY/PWMA/AIN或舵机PWM。因此不能把自拟仿真激励说成现有固件的真实输出波形。
- [主程序:112](<D:/smart_fans/firmware/src/main.c#L112>)引用BTN_Pin；已搜索本工程可见C/H文件和[构建配置](<D:/smart_fans/firmware/platformio.ini#L22-L27>)，未找到该宏定义。此为潜在编译阻断；尚未实际编译完整HAL工程，不虚构编译器报错。
- [针脚配置](<D:/smart_fans/firmware/src/config/pins.h#L20-L21>)仍把PB12定义为编码器按键；新2+3模块没有该信号。GPIO当前配置为上拉输入可以避免该输入裸浮，但不代表按压功能存在。

## 仿真必须包含的状态
1. MCU处于复位/未启动：不可假设STBY、方向和PWM已被软件主动拉低，应检查真实板载下拉和模块输入条件。
2. 母板供电而MCU的JP_USB断开、核心板未由USB供电：检查外设输出/母板上拉是否通过GPIO寄生供电。
3. MCU独立USB供电而母板未供电：检查输出高电平是否反供外设电源。
4. ASR独立Type-C烧录：按设计断开供电/TX/RX三跳帽；误插状态需单独作为风险情景，不能宣称已硬件自动隔离。
5. 正常启动/掉电：3.3V母板LDO与核心板自身LDO时序独立，需针对接口逐一核实Ioff或注入电流限制。

## 当前结论
没有完整业务固件可用于整机功能联合仿真。可以进行硬件电源、接口及假设激励下的条件仿真，但必须与真实固件执行、实际电机/舵机动作测试分开。此轮没有修改固件，也没有烧录任何设备。
