Lucian-ming/smart-fans/artifacts/revb_simulation_plan.md

# RevB 单5V：补充审核与仿真计划

2026-11-04 19:02：用户确认先暂停新版投板。原六份交付保持冻结；工程发布评审状态改为 paused_pending_electrical_review_and_simulation，现发布器应拒绝再次发布。

## 基线与证据
- PCB SHA256：c9cb106cdc48e9b3e44ff9b6d379062e31b24f2d6fec1b29f22d64fc3b3264a1。
- SCH SHA256：ae4bb467b5398b3d5482221e21dfbe591e0b5d7721703dc5707e78e901f56ada。
- 静态验收摘要 SHA256：3c1d064490453981ba7c45d7ad66307f2ddb22cda44774fc9173b4765f1da48c；14项通过不等于电路仿真通过。

## 独立复审
由独立代理追踪最终PCB/原理图网络，不只重复生成器自定义预期值：电源保护和针序、实际采购厂商身份、稳压器电容稳定性/最小负载/功耗、3.3V/5V接口、USB和未供电GPIO反供、TB6612驱动条件。原厂资料不足记为未证实。

## 仿真分层与计划工况
| 项目 | 方法及工况 | 不能据此宣称的事项 |
|---|---|---|
| 反接PMOS | 优先真实AO4409模型；正常启动、反接、断电、负载侧残压；核查模型引脚及体二极管方向 | 模型未包含的热失效、板级短路安全、全部批次参数 |
| 供电压降 | 电源容差、线缆/接插件/保险/PCB电阻参数扫描；负载组合从轻载到2A设计目标及超目标情景 | 假设负载不等于实测电机启动/堵转电流；假设铜厚/孔壁不等于实测 |
| 瞬态供电 | 电容容量公差、ESR、MLCC偏压衰减和负载阶跃；输入源上升/跌落；保留波形与数值 | 理想电源不能代表实际适配器；参数未知不得给整板通过 |
| 3.3V稳压 | 核实实际厂商与模型；按原厂输出电容/ESR范围测试；无模型则只做明确标注的上下界分析 | 理想3.3V源无法证明环路稳定性、负载瞬态或热保护 |
| 接口时序 | 模块及MCU不同上电组合、跳帽状态、电平阈值/绝对额定值；有可信I/O模型才求注入电流 | 理想逻辑/二极管钳位仅作风险示范，不代表芯片Ioff或绝对安全 |
| 负对照 | 保留已知错误模型/接线或过大源阻抗等用例，证明流程能报错；区分求解收敛与电路合格 | 求解器exit0不等于设计通过 |

## 每次结果必需内容
求解器版本、模型来源/哈希/引脚顺序、网表及参数、假设和非覆盖项、原始日志与波形、关键数值及来源明确的判据。不得以自拟理想模型的通过覆盖未知负载、原生ERC/DRC或机械适配。

## 放行条件
发现的确定缺陷修复后必须重建并重新运行静态检查；变更后的旧哈希及旧仿真不得复用。补充报告需分别列出：已验证、仅条件成立时通过、失败、仍需实测。用户未获得更新结论前继续暂停投板。
