Lucian-ming/smart-fans/artifacts/asr_dimensions.png

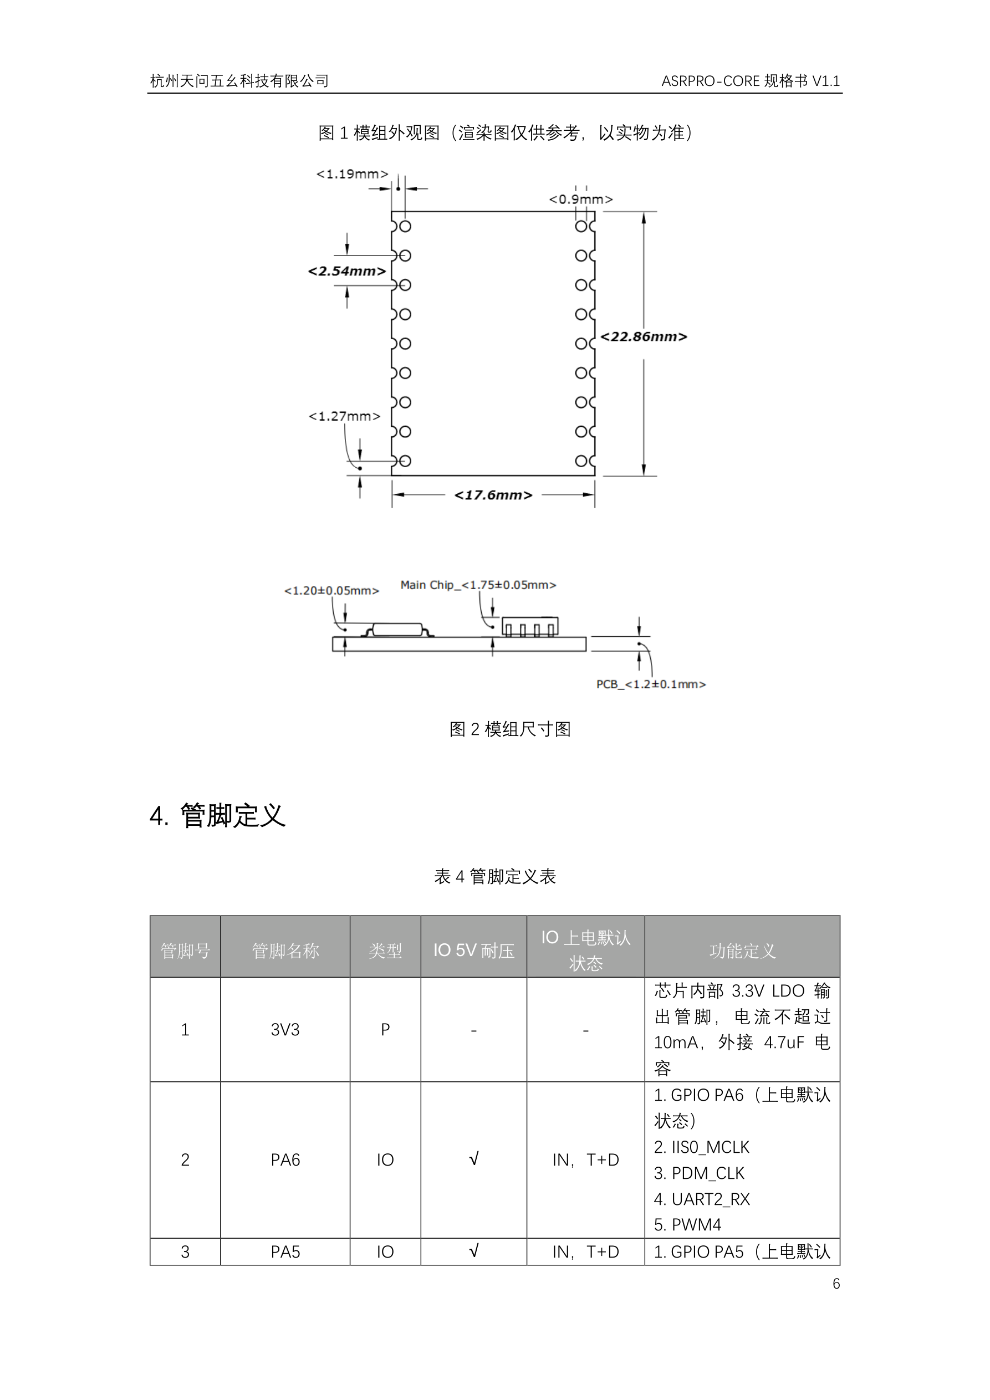
artifacts/asr_dimensions.png
