Lucian-ming/smart-fans/artifacts/core_dimensions.png

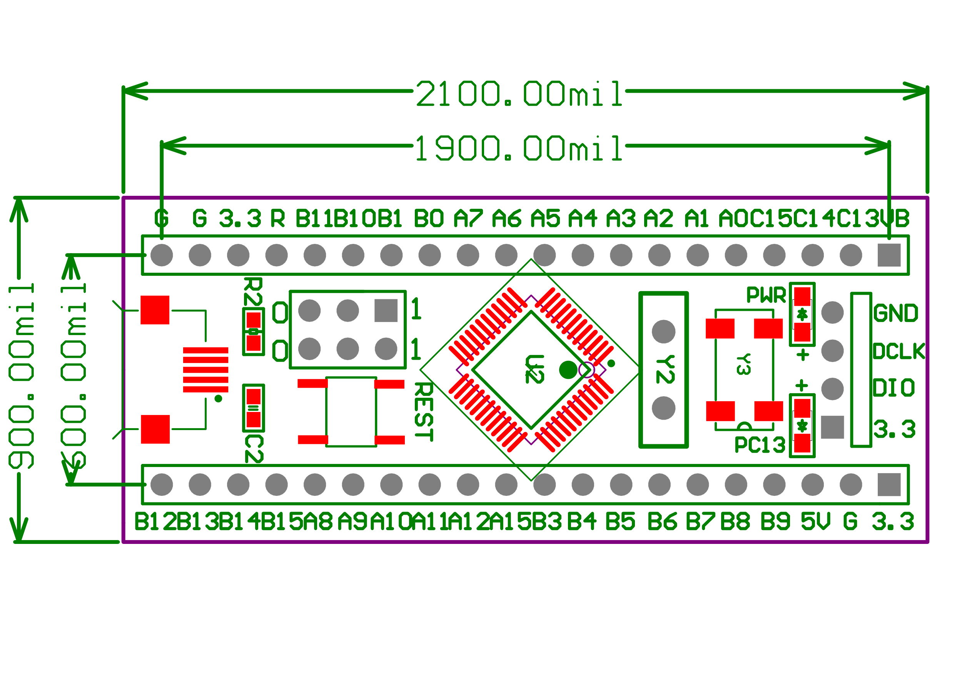
artifacts/core_dimensions.png
