Lucian-ming/smart-fans/artifacts/core_schematic.png

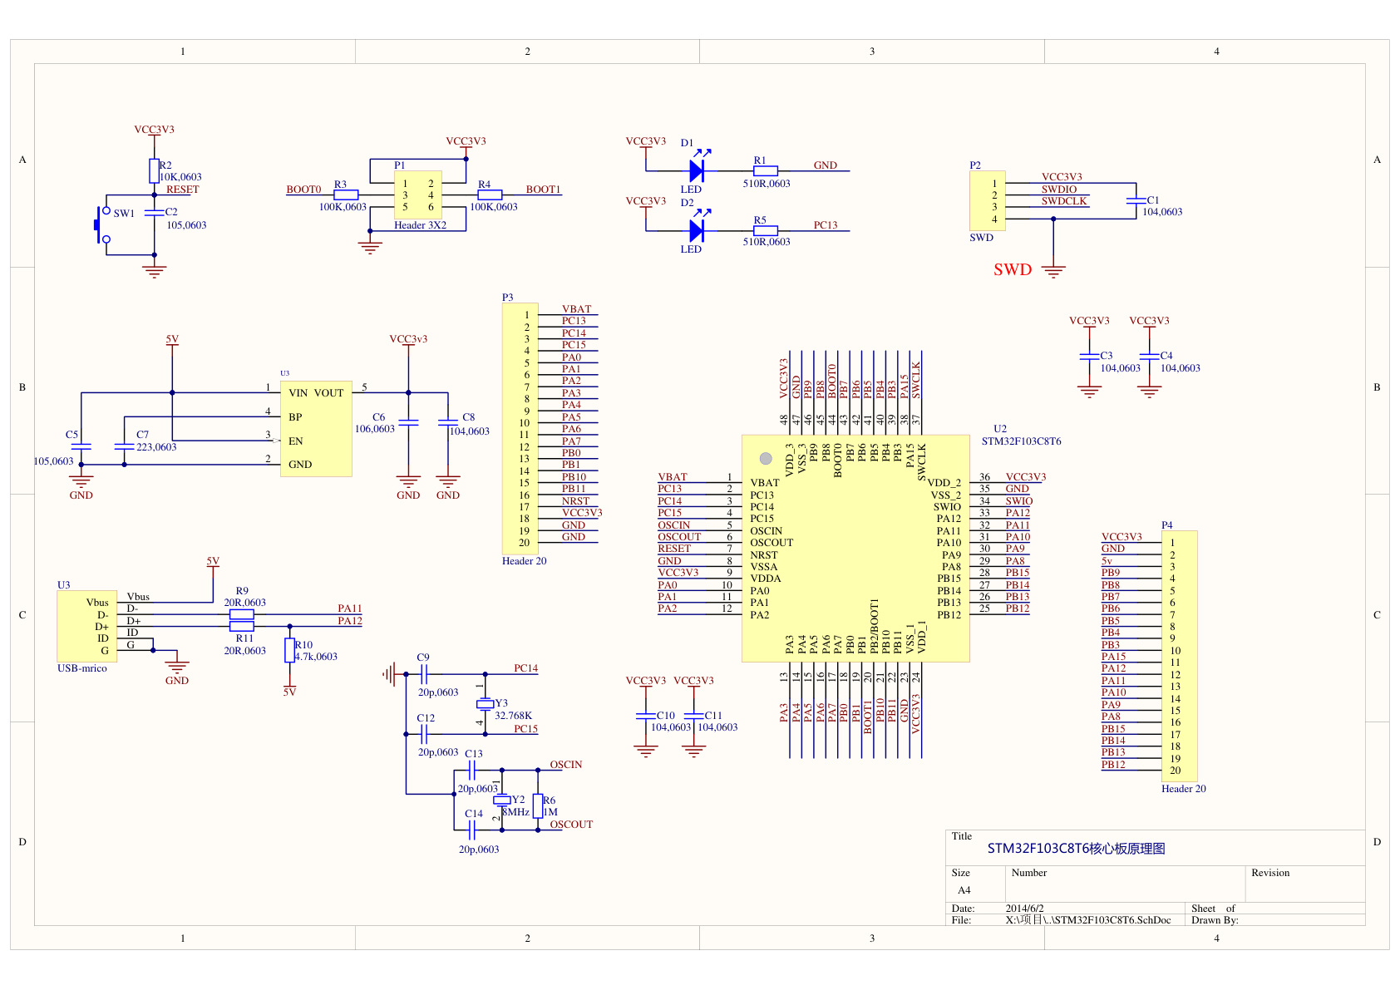
artifacts/core_schematic.png
