Lucian-ming/smart-fans/artifacts/procurement_review_20261104/AOS_SO8.png

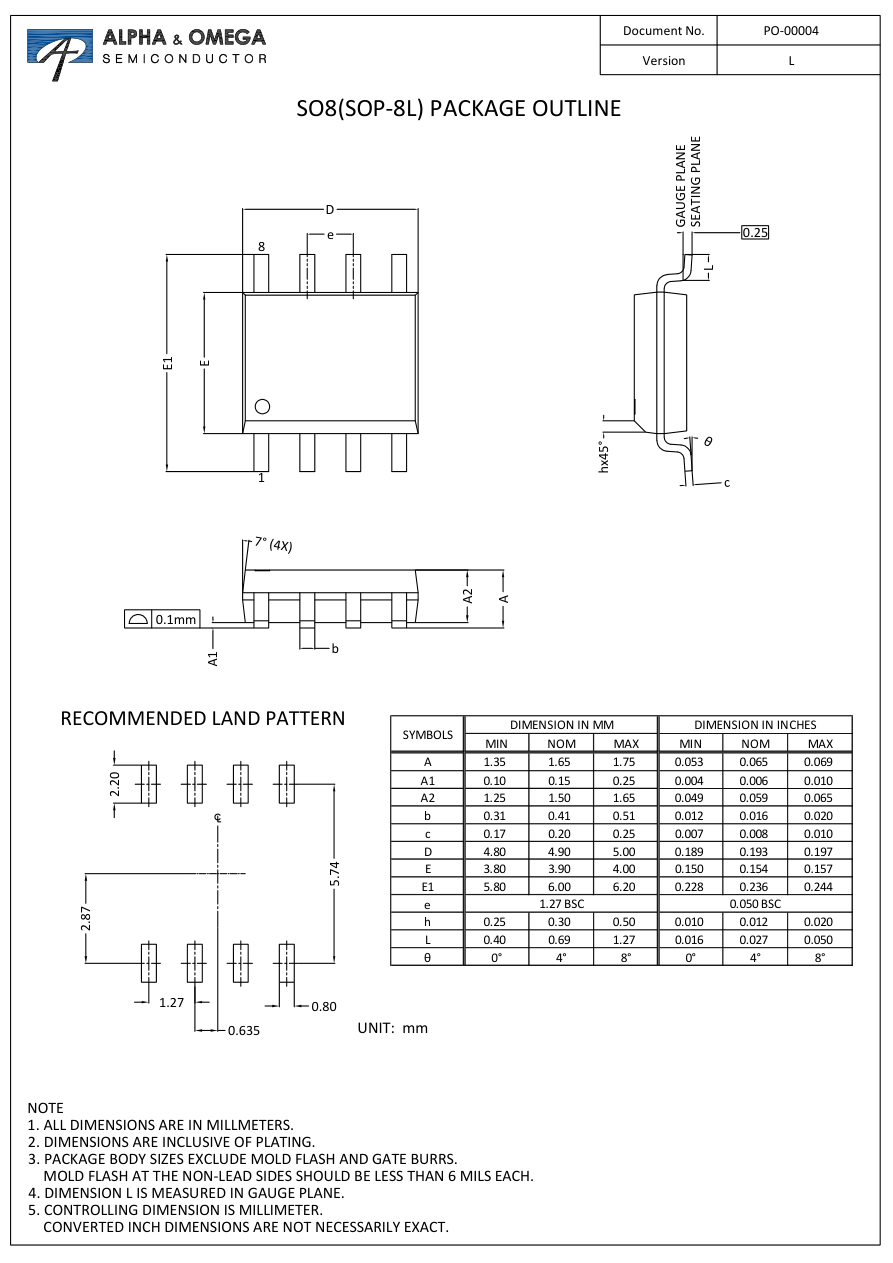
artifacts/procurement_review_20261104/AOS_SO8.png
