Lucian-ming/smart-fans/artifacts/procurement_review_20261104/female_2P.png

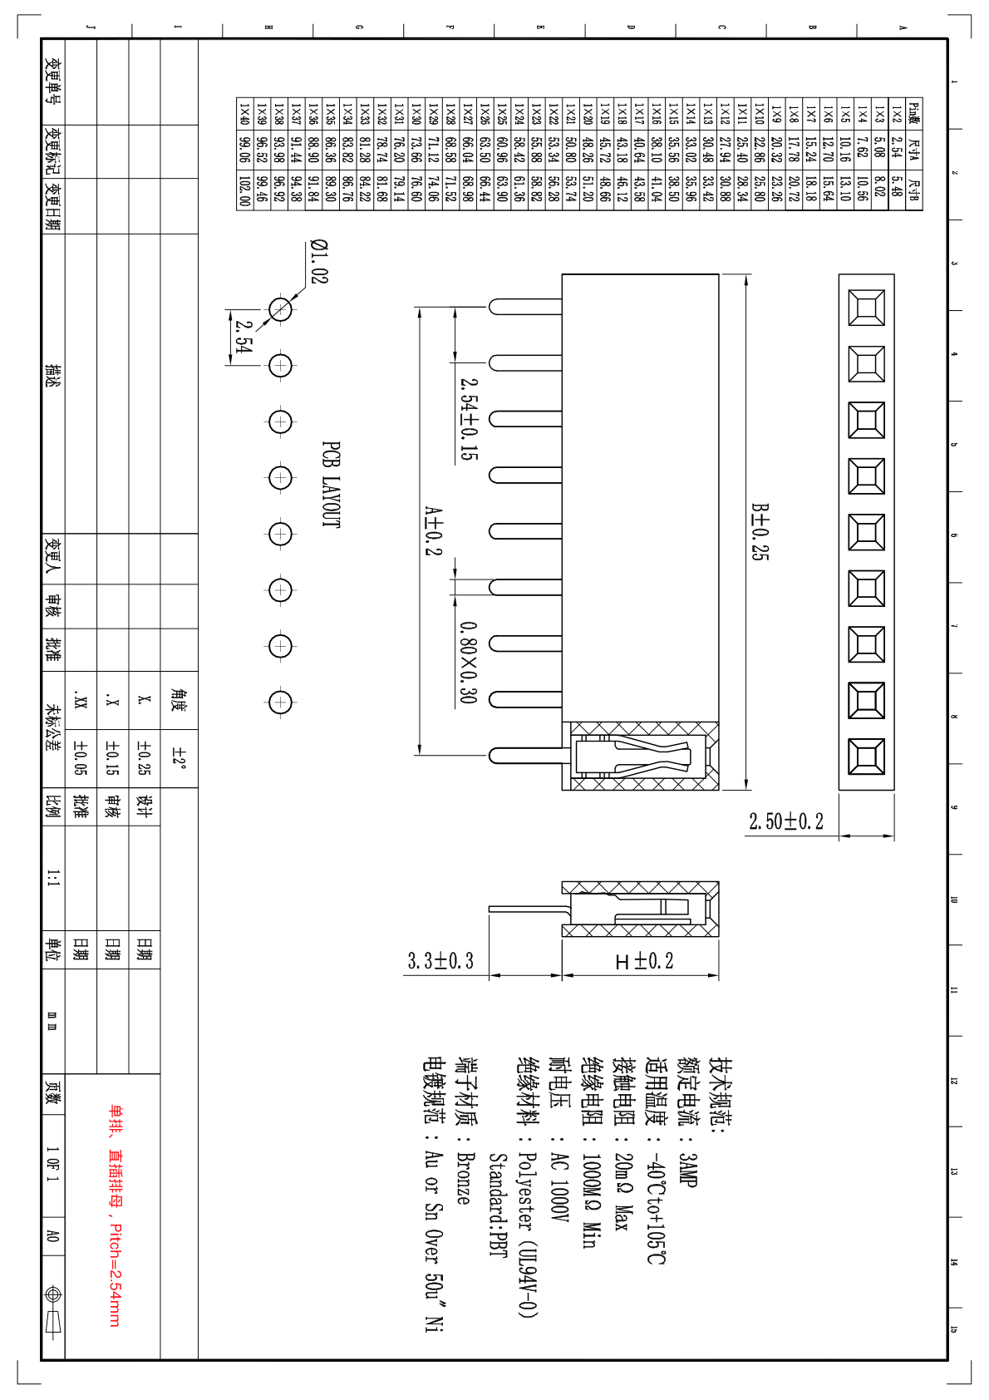
artifacts/procurement_review_20261104/female_2P.png
