Lucian-ming/smart-fans/artifacts/procurement_review_20261104/female_3P.png

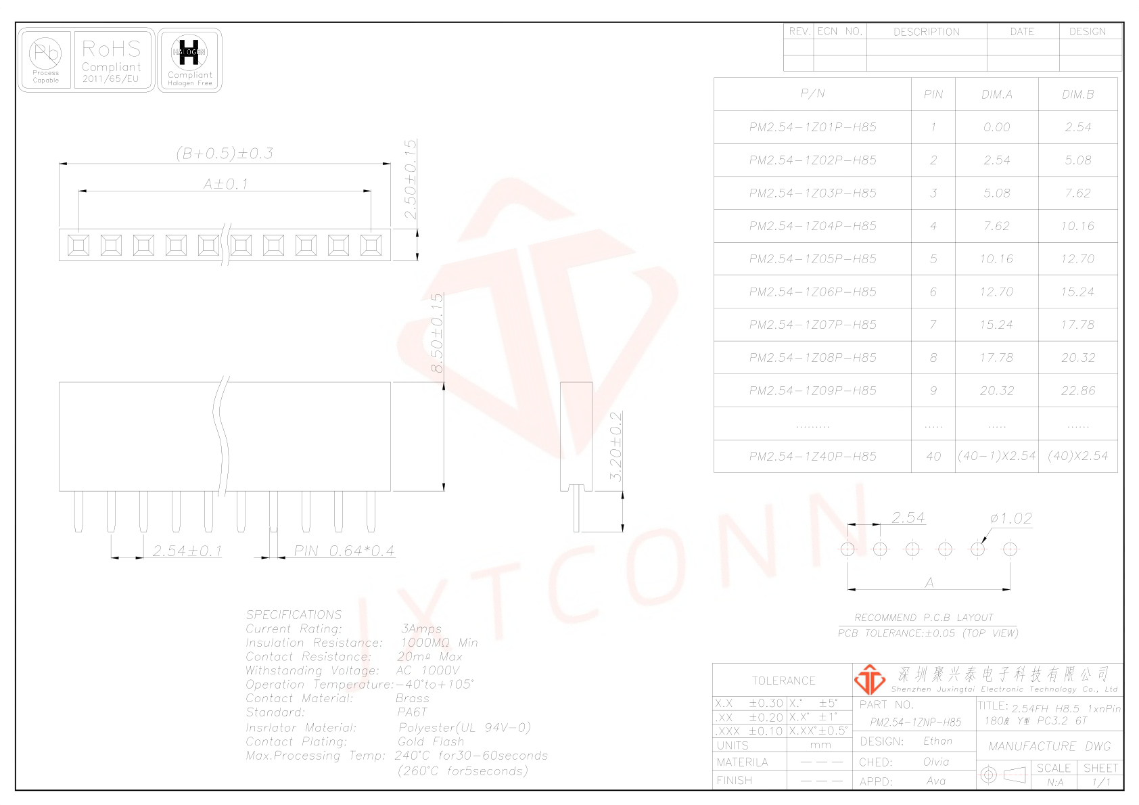
artifacts/procurement_review_20261104/female_3P.png
