Lucian-ming/smart-fans/artifacts/procurement_review_20261104/KF128_508.png

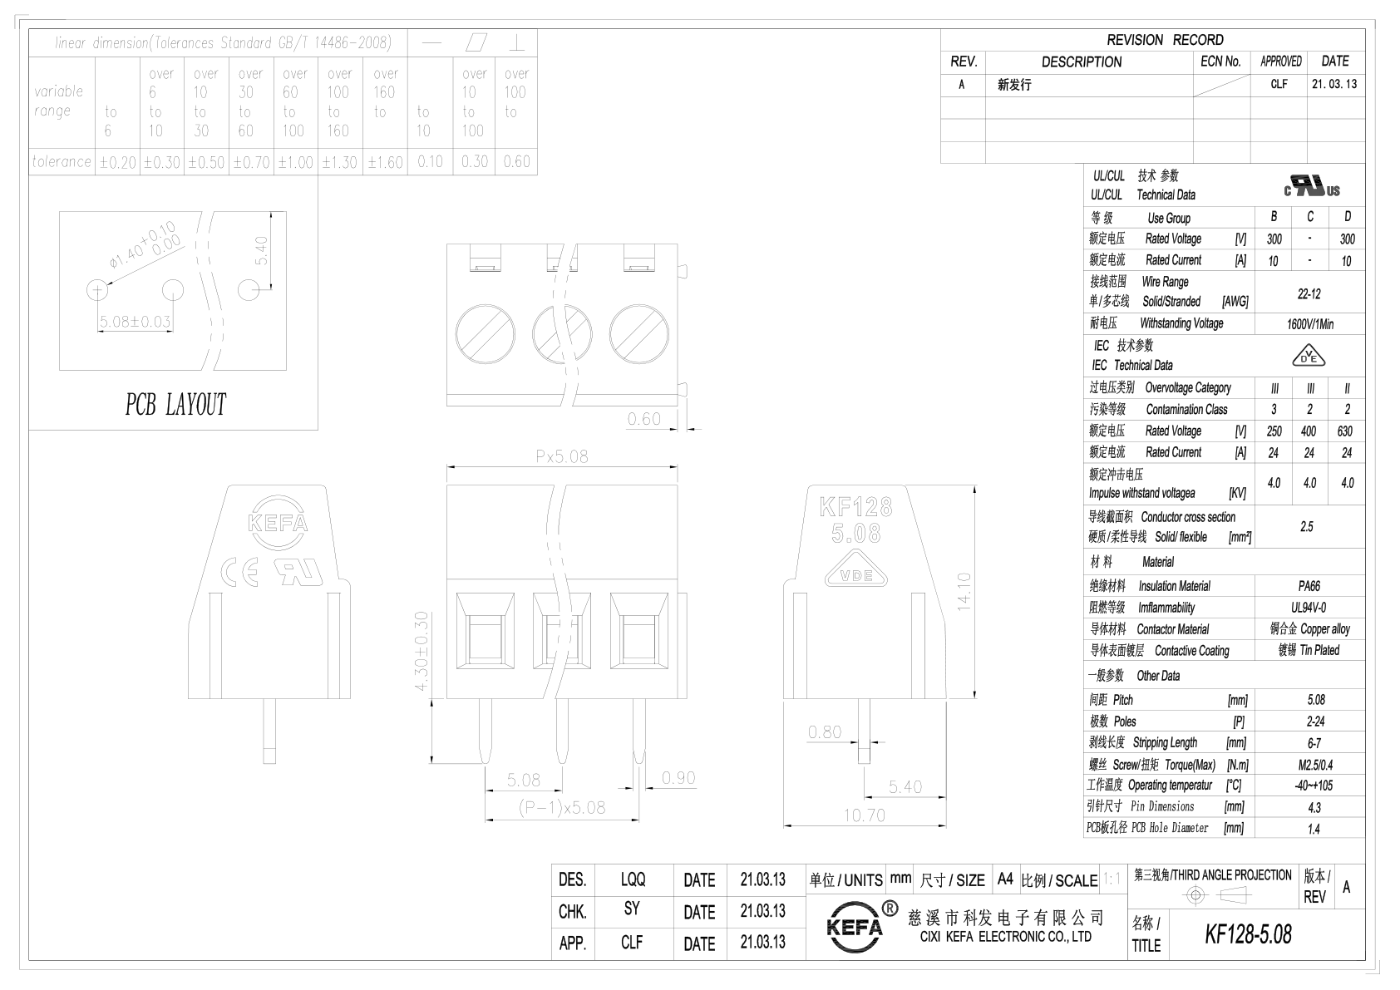
artifacts/procurement_review_20261104/KF128_508.png
