Lucian-ming/smart-fans/artifacts/procurement_review_20261104/mcu_20P.png

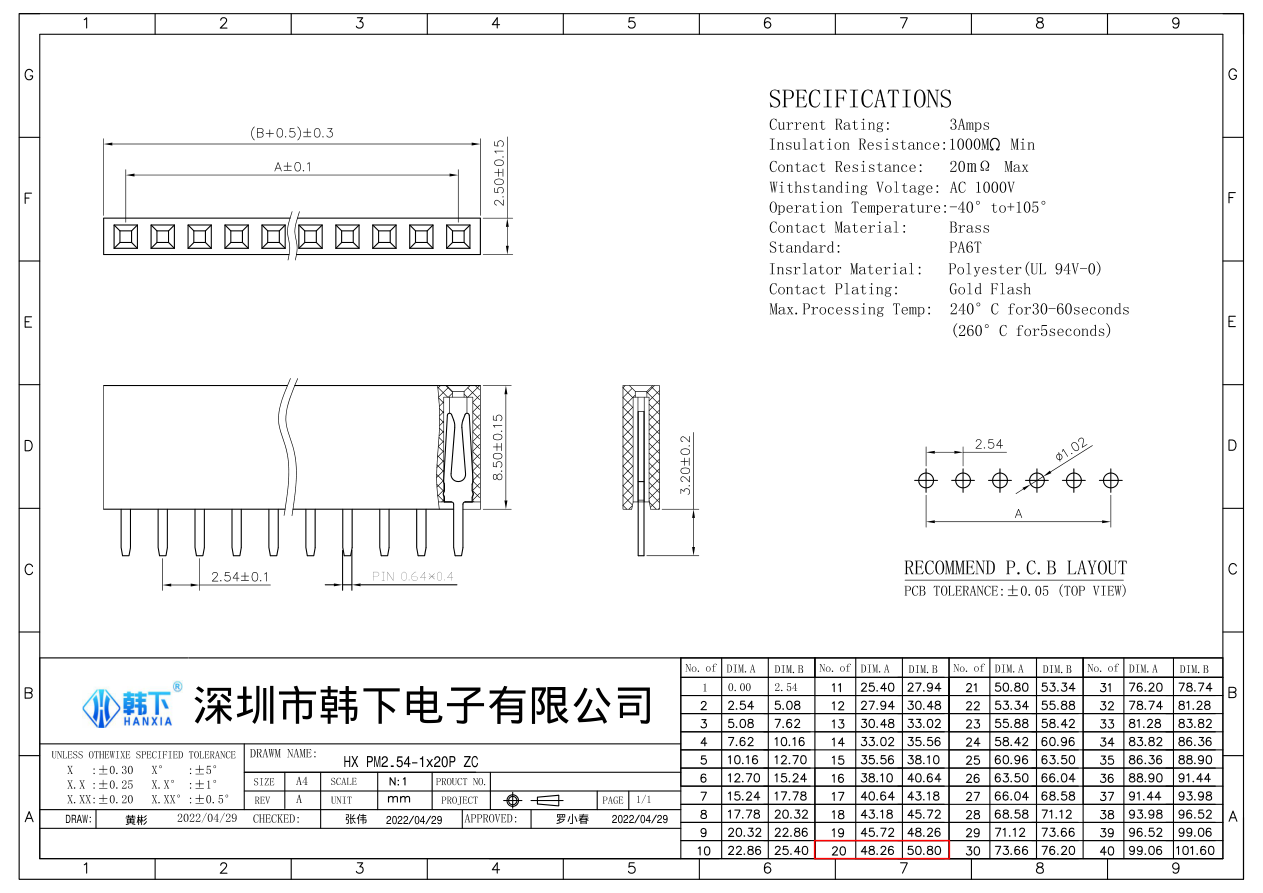
artifacts/procurement_review_20261104/mcu_20P.png
