Lucian-ming/smart-fans/artifacts/report_pack/figs/_prev_sch.png

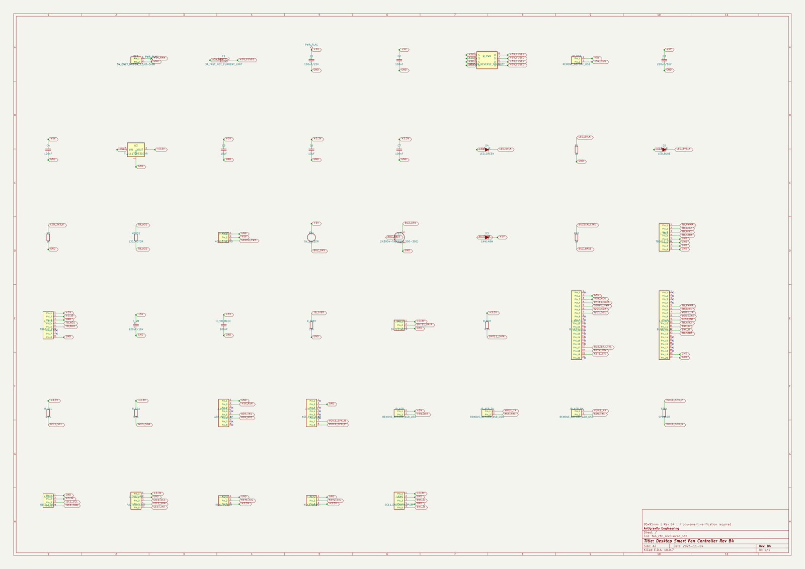
artifacts/report_pack/figs/_prev_sch.png
