Lucian-ming/smart-fans/artifacts/report_pack/figs/fig01_system_block.png

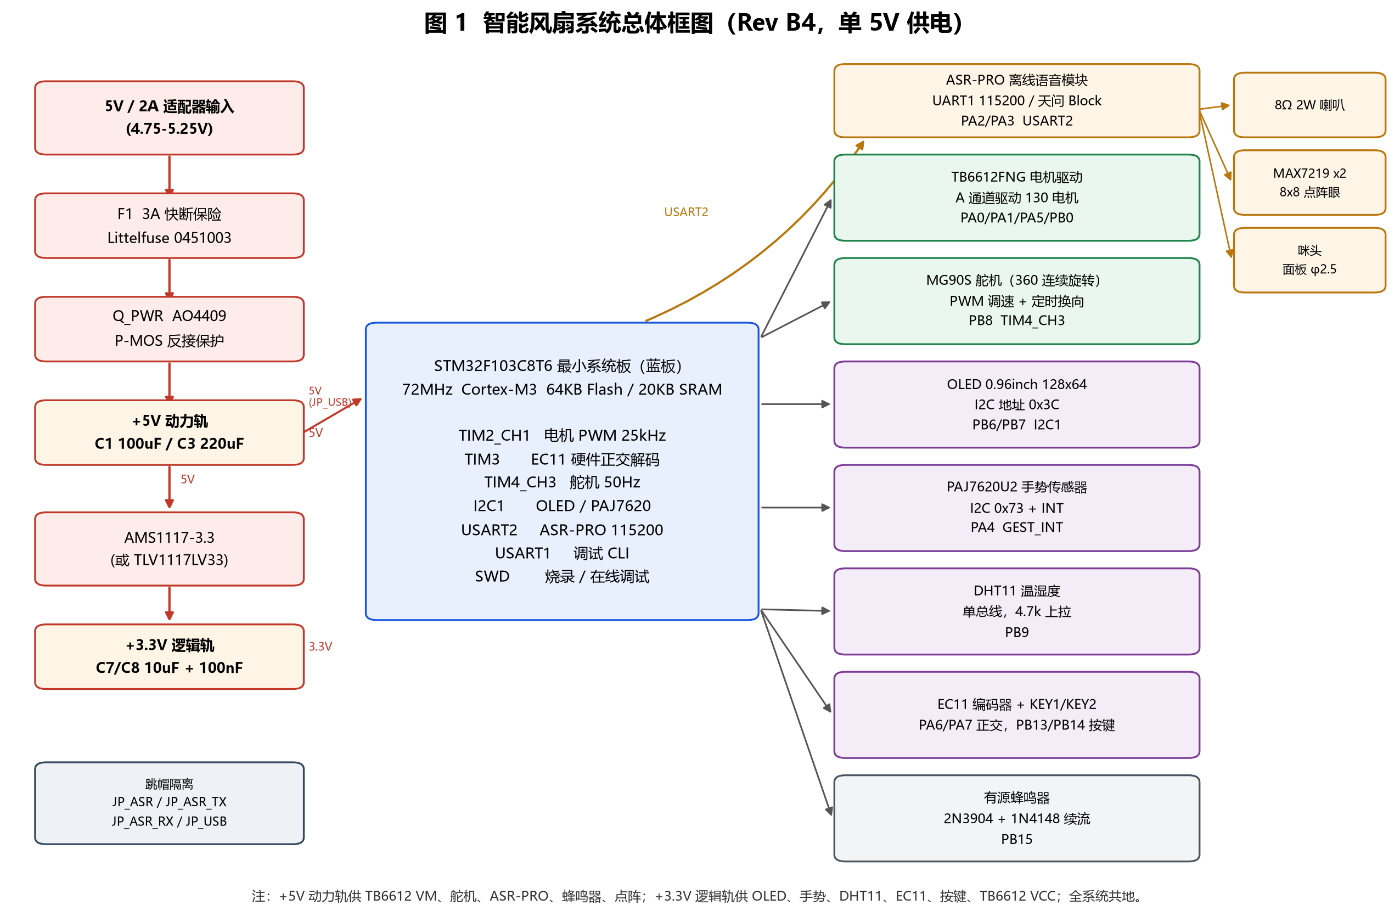
artifacts/report_pack/figs/fig01_system_block.png
