Lucian-ming/smart-fans/artifacts/report_pack/figs/fig02_power_chain.png

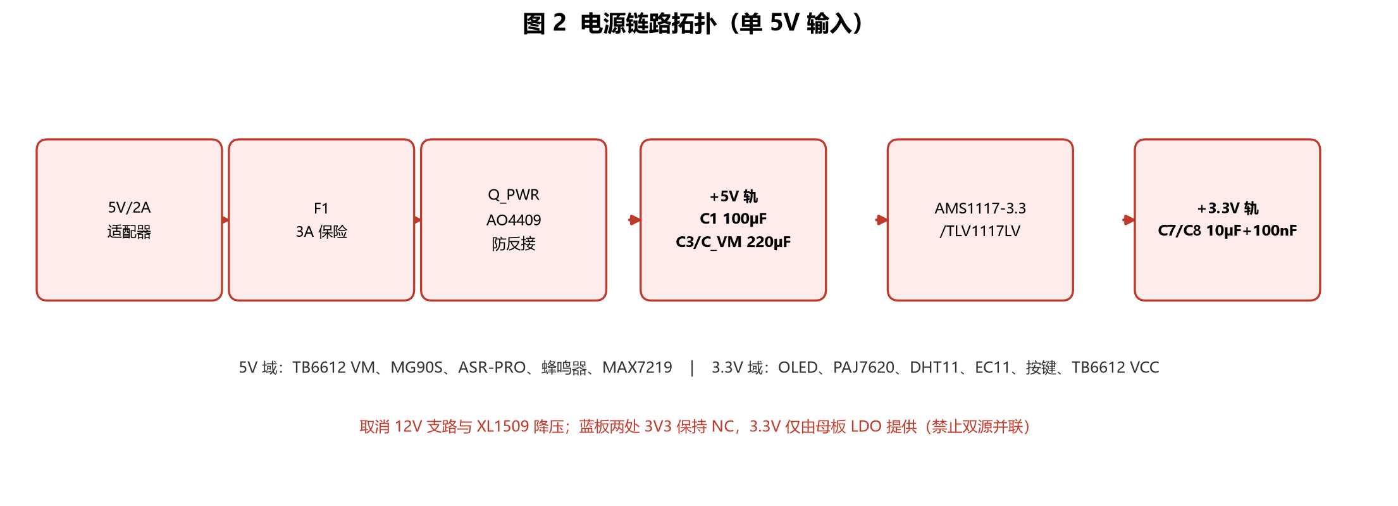
artifacts/report_pack/figs/fig02_power_chain.png
