Lucian-ming/smart-fans/artifacts/report_pack/figs/fig03_fsm.png

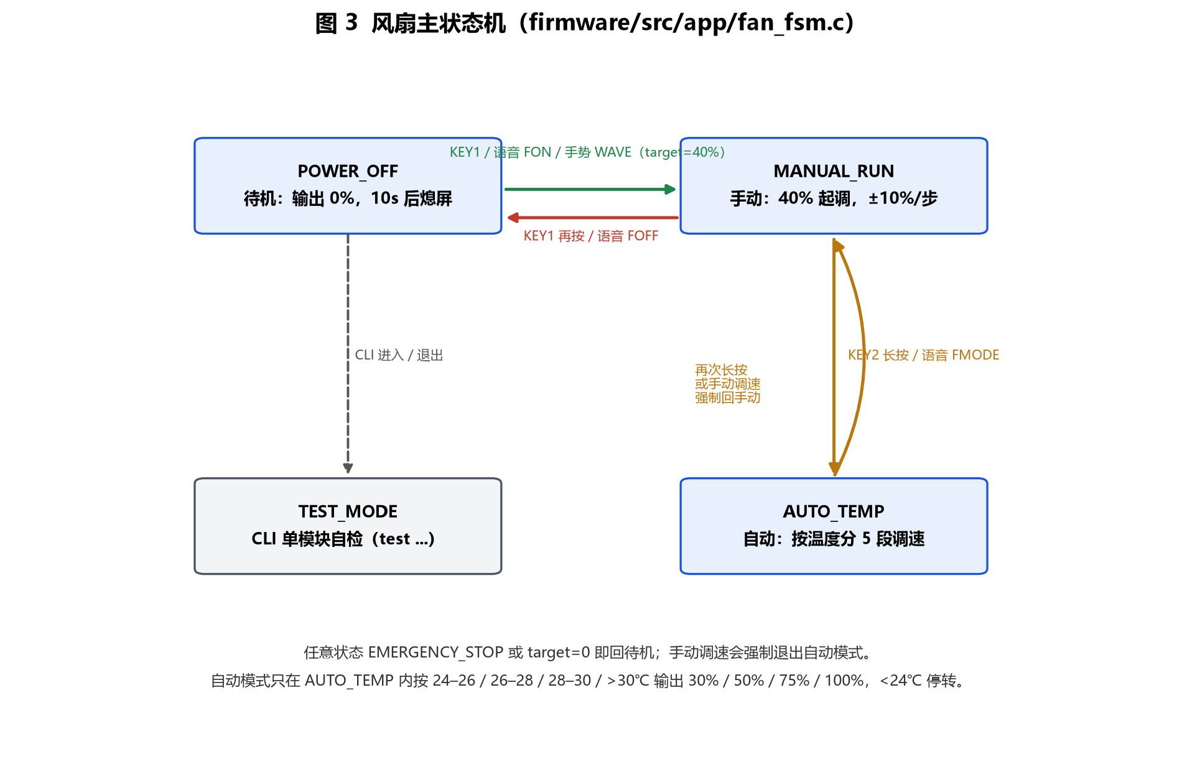
artifacts/report_pack/figs/fig03_fsm.png
