Lucian-ming/smart-fans/artifacts/report_pack/figs/fig04_conditional_sim.png

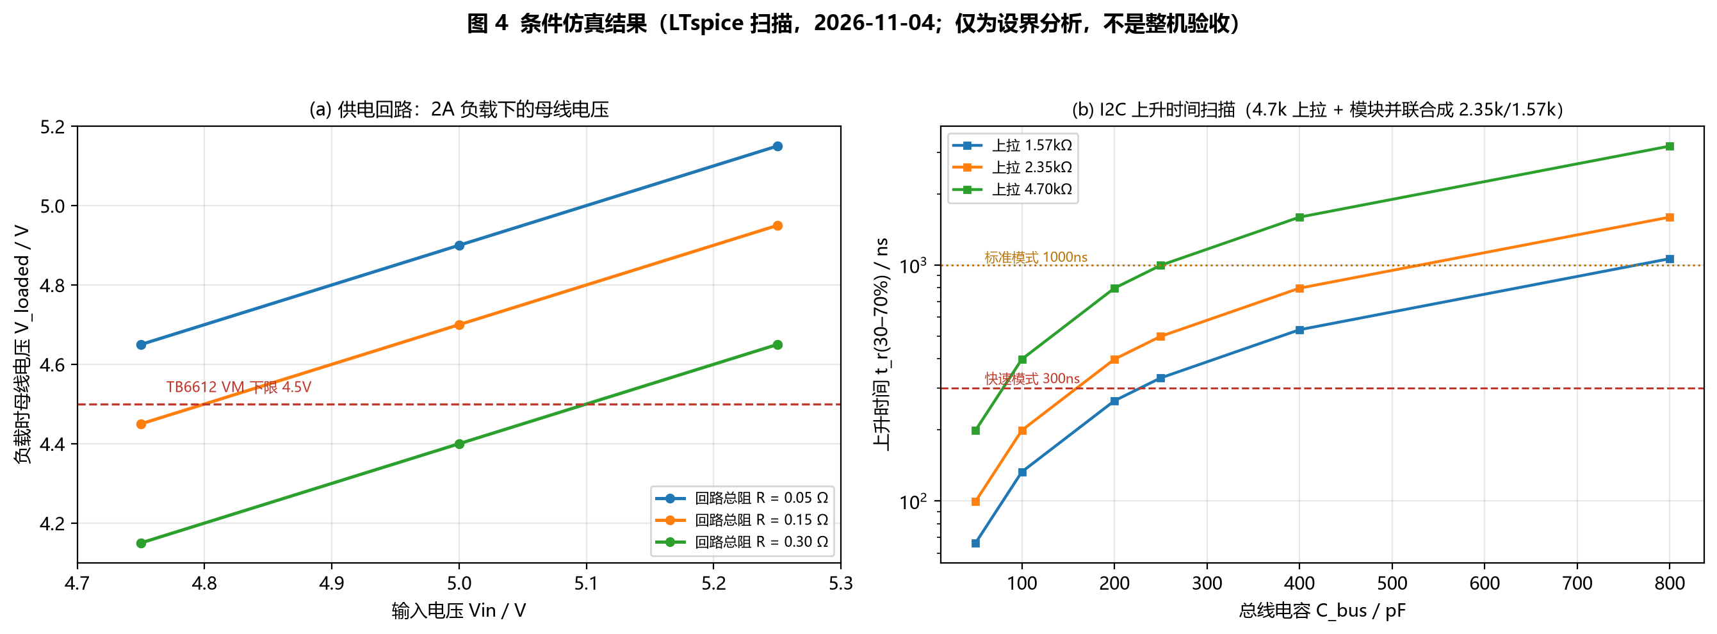
artifacts/report_pack/figs/fig04_conditional_sim.png
