Lucian-ming/smart-fans/artifacts/report_pack/figs/fig06_panel_layout.png

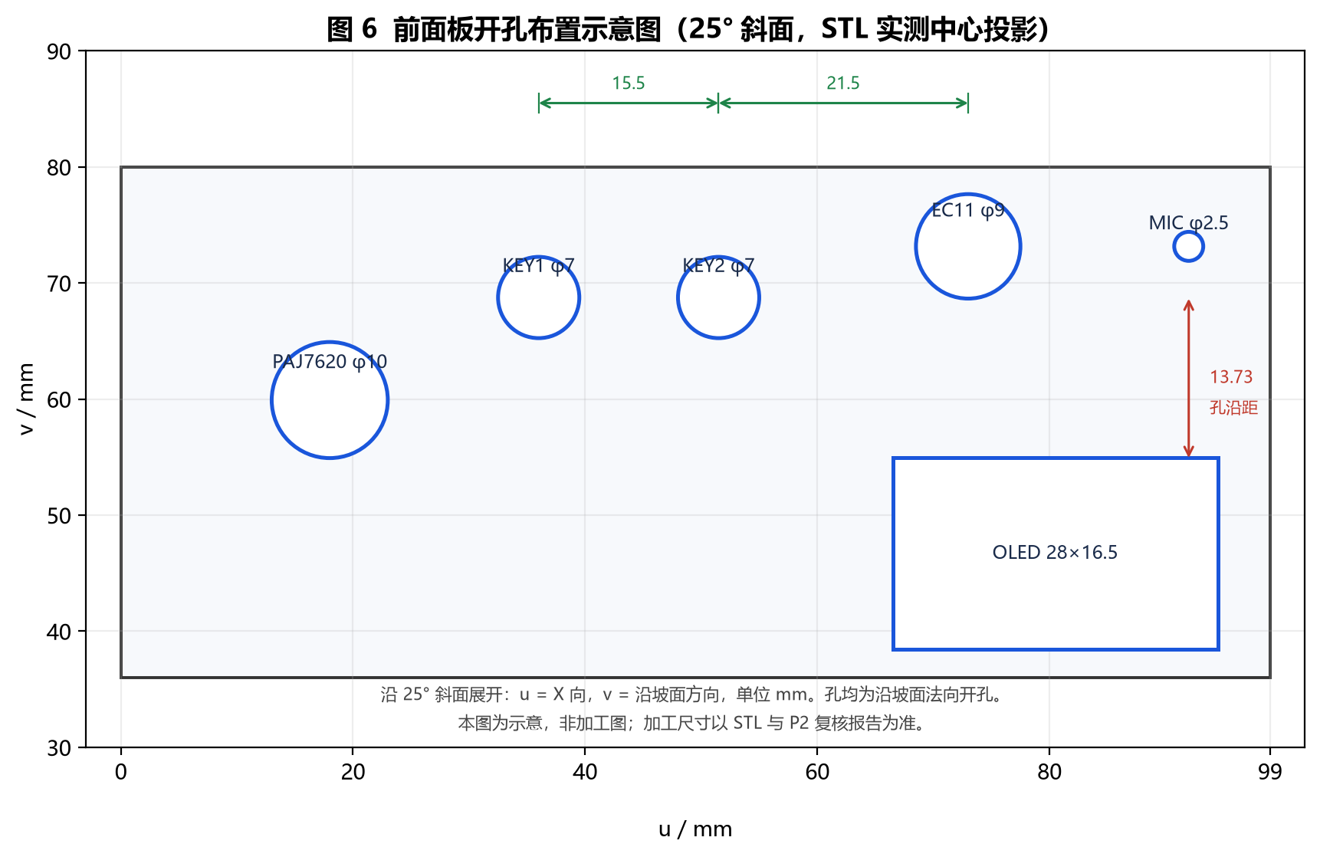
artifacts/report_pack/figs/fig06_panel_layout.png
