Lucian-ming/smart-fans/artifacts/report_pack/figs/pcb_3d_top.png

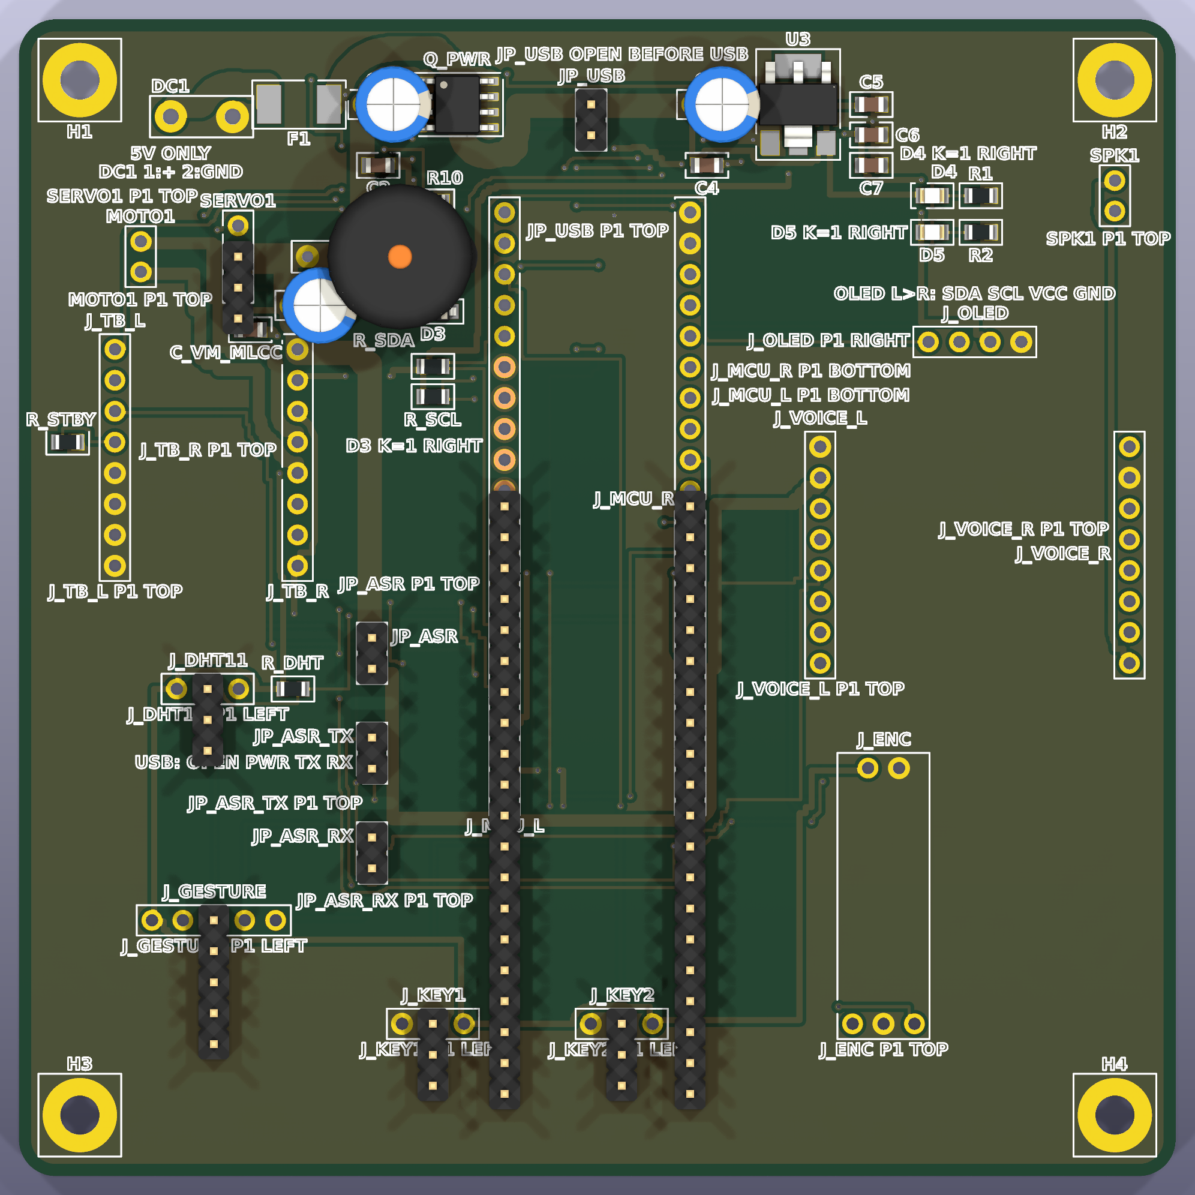
artifacts/report_pack/figs/pcb_3d_top.png
