Lucian-ming/smart-fans/artifacts/report_pack/pack/05_图片素材/fig07_pcb_layout_top.png

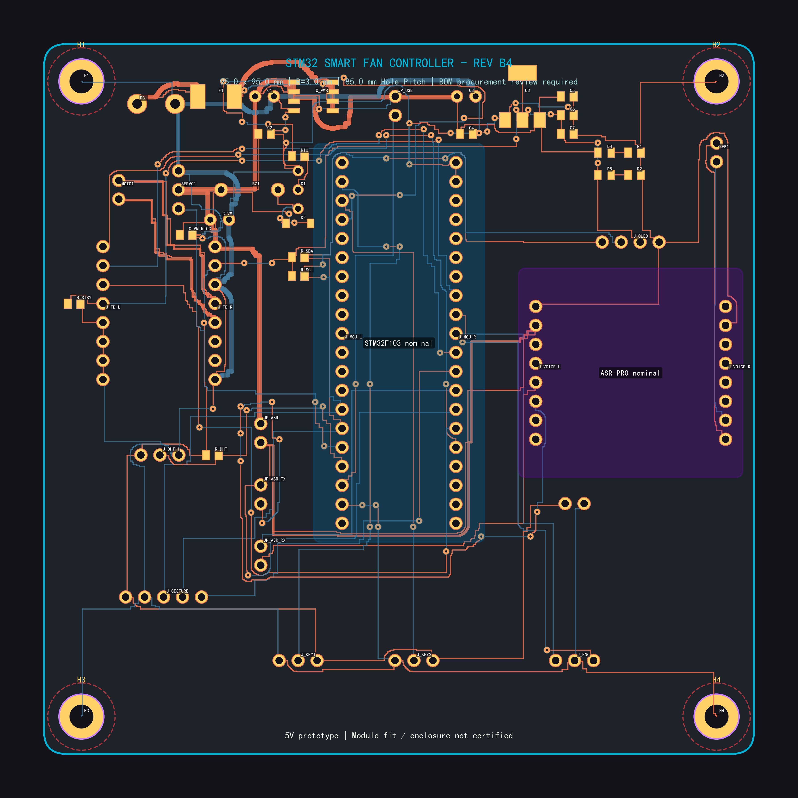
artifacts/report_pack/pack/05_图片素材/fig07_pcb_layout_top.png
