Lucian-ming/smart-fans/artifacts/user_module_sources/asr_spec_rotated.png

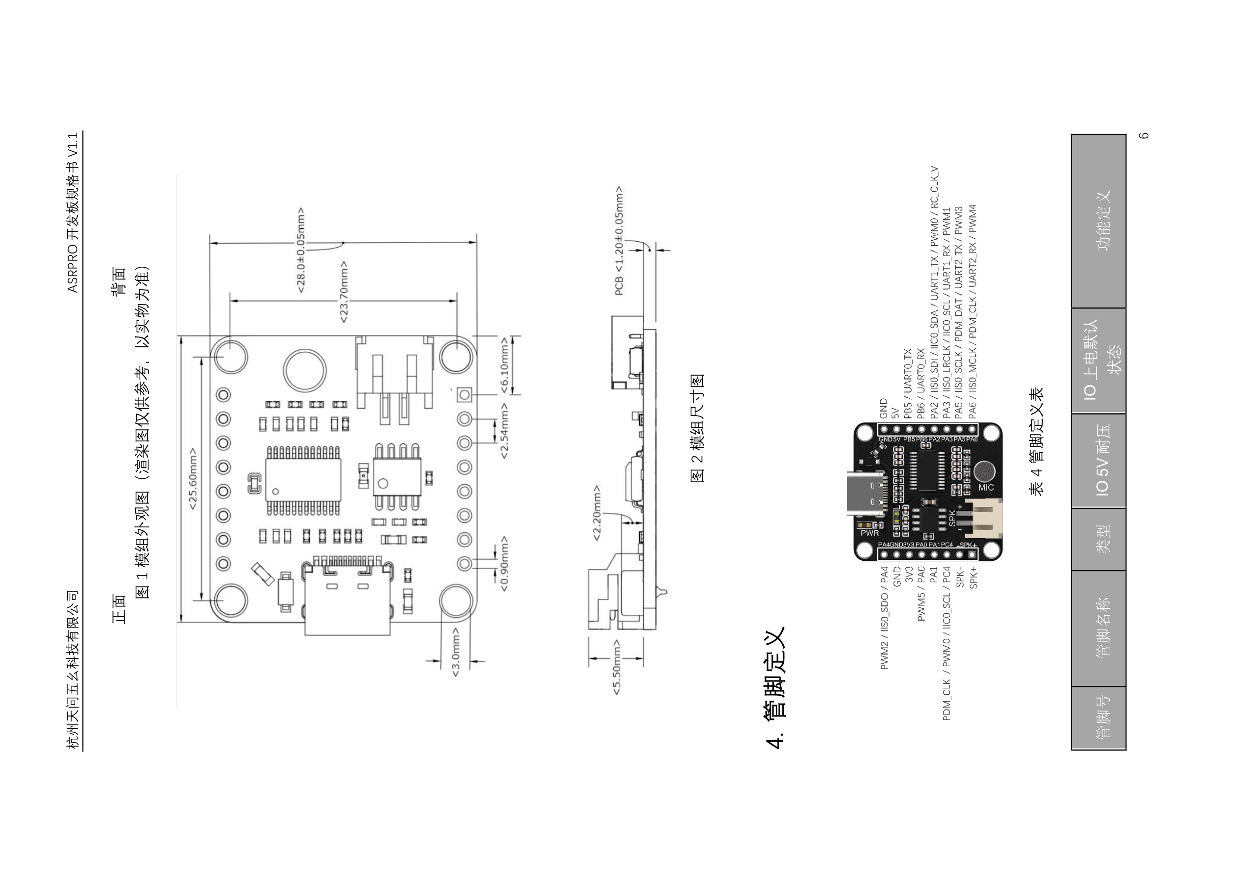
artifacts/user_module_sources/asr_spec_rotated.png
