Lucian-ming/smart-fans/artifacts/user_module_sources/ec_0.png

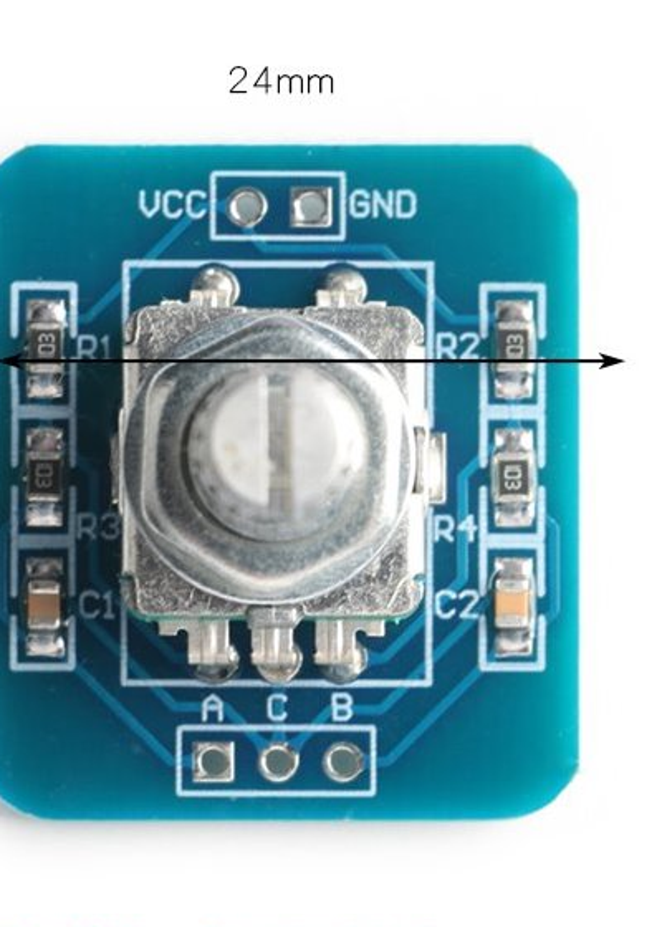
artifacts/user_module_sources/ec_0.png
