Lucian-ming/smart-fans/artifacts/user_module_sources/ec_90.png

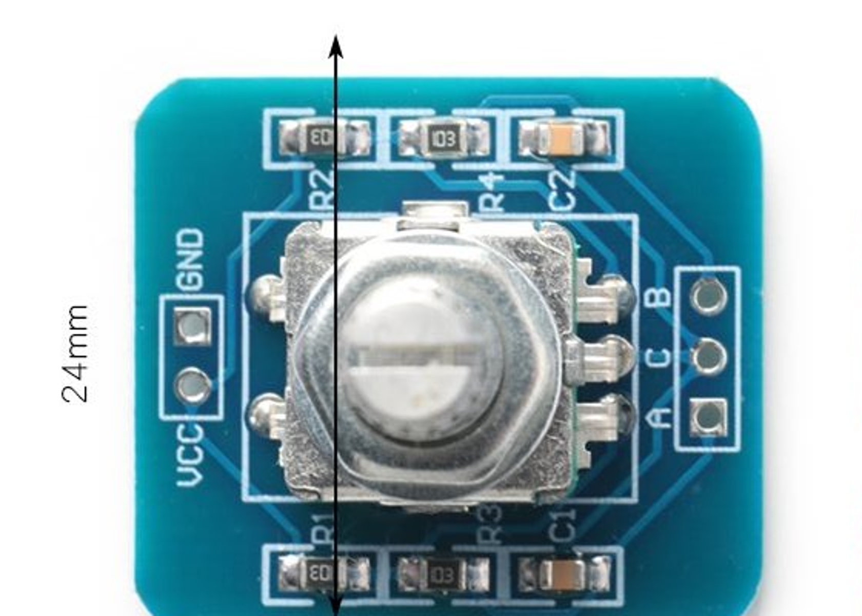
artifacts/user_module_sources/ec_90.png
