Lucian-ming/smart-fans/artifacts/user_module_sources/ec_180.png

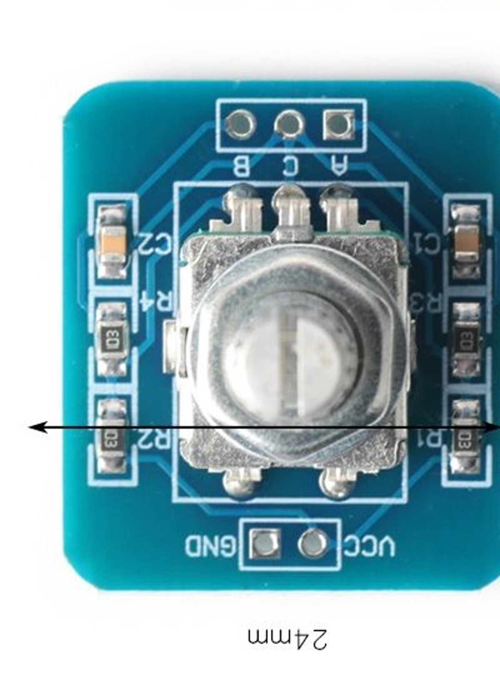
artifacts/user_module_sources/ec_180.png
