Lucian-ming/smart-fans/artifacts/user_module_sources/ec_270.png

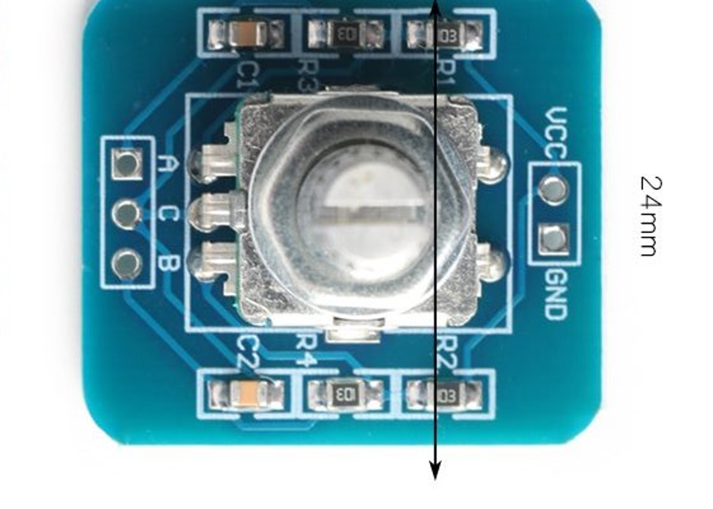
artifacts/user_module_sources/ec_270.png
