Lucian-ming/smart-fans/artifacts/user_module_sources/oled_0.png

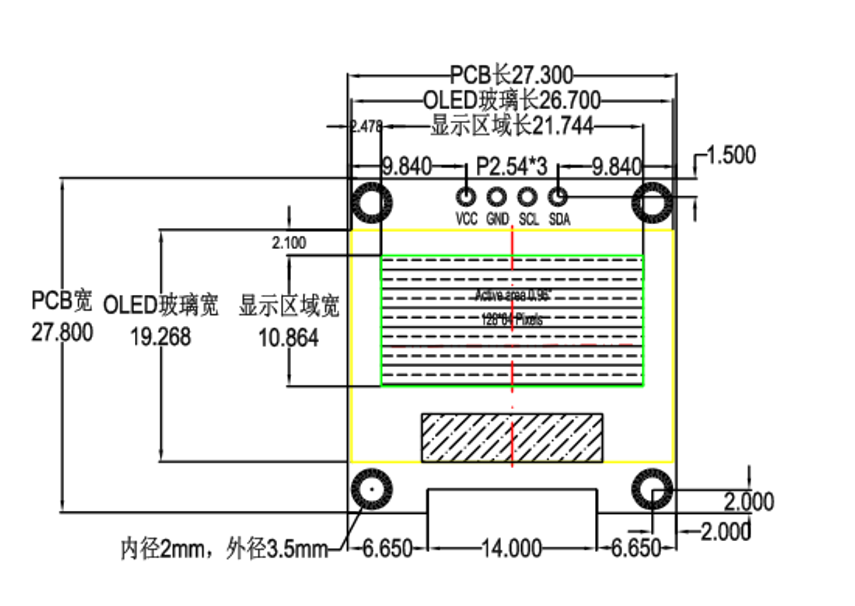
artifacts/user_module_sources/oled_0.png
