Lucian-ming/smart-fans/artifacts/user_module_sources/oled_90.png

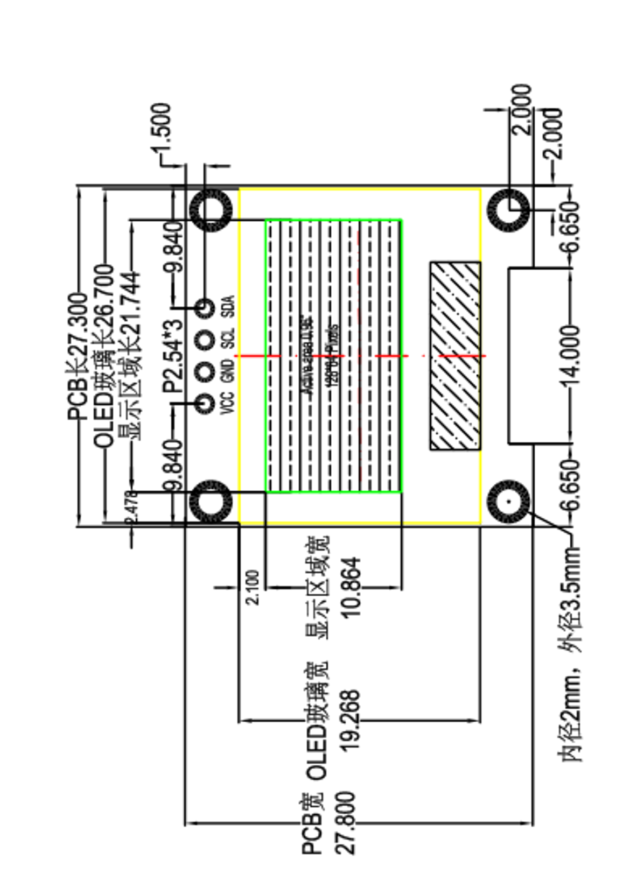
artifacts/user_module_sources/oled_90.png
