Lucian-ming/smart-fans/artifacts/user_module_sources/oled_180.png

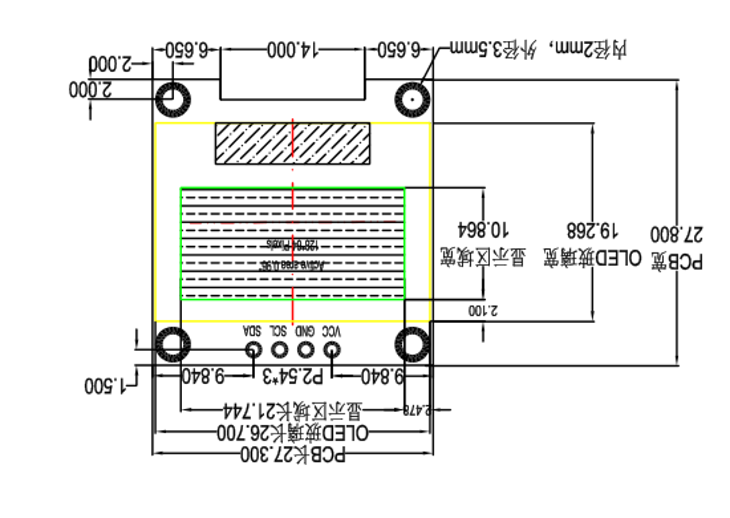
artifacts/user_module_sources/oled_180.png
