Lucian-ming/smart-fans/artifacts/user_module_sources/oled_270.png

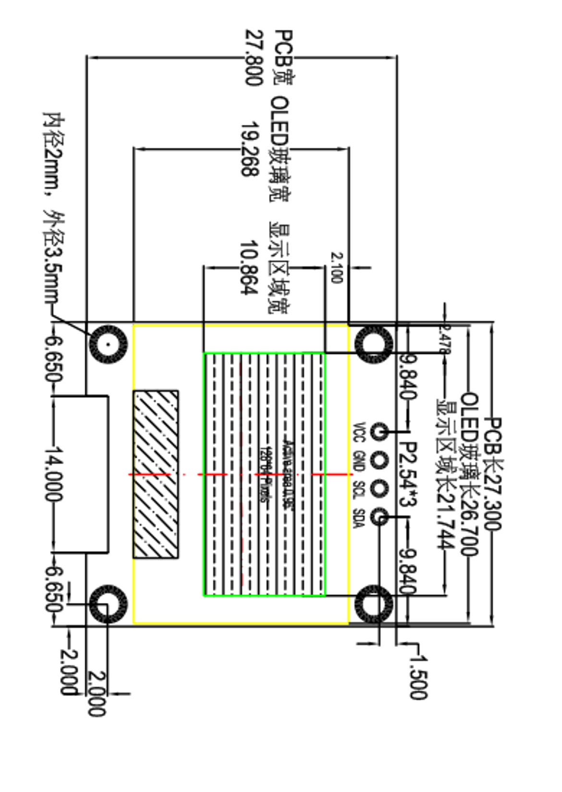
artifacts/user_module_sources/oled_270.png
