Lucian-ming/smart-fans/artifacts/user_module_sources/pdf_0.png

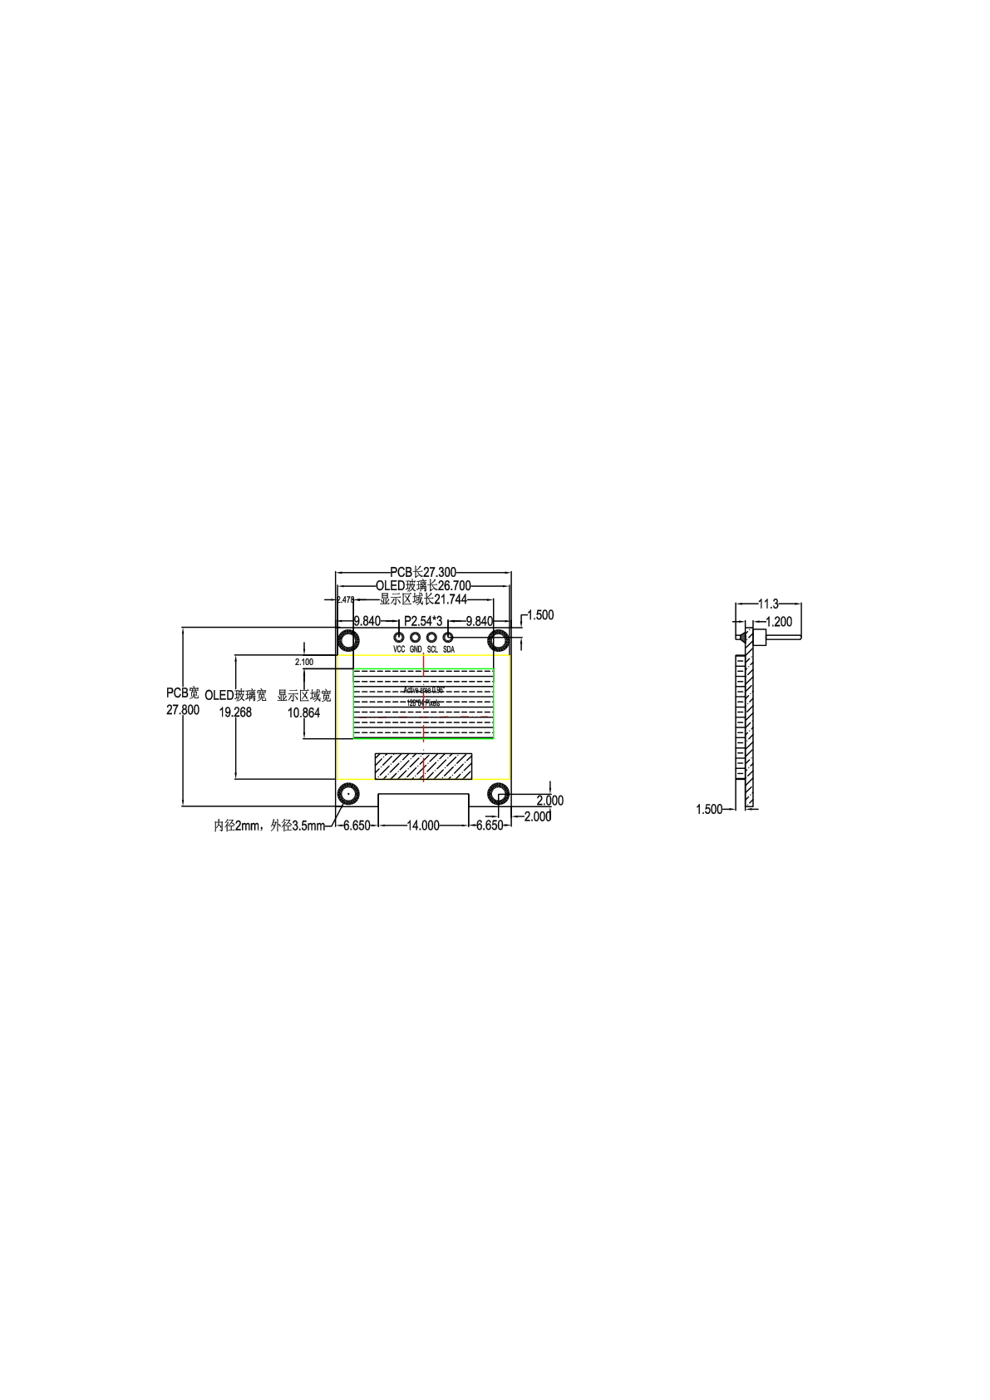
artifacts/user_module_sources/pdf_0.png
