Lucian-ming/smart-fans/artifacts/user_module_sources/pdf_1.png

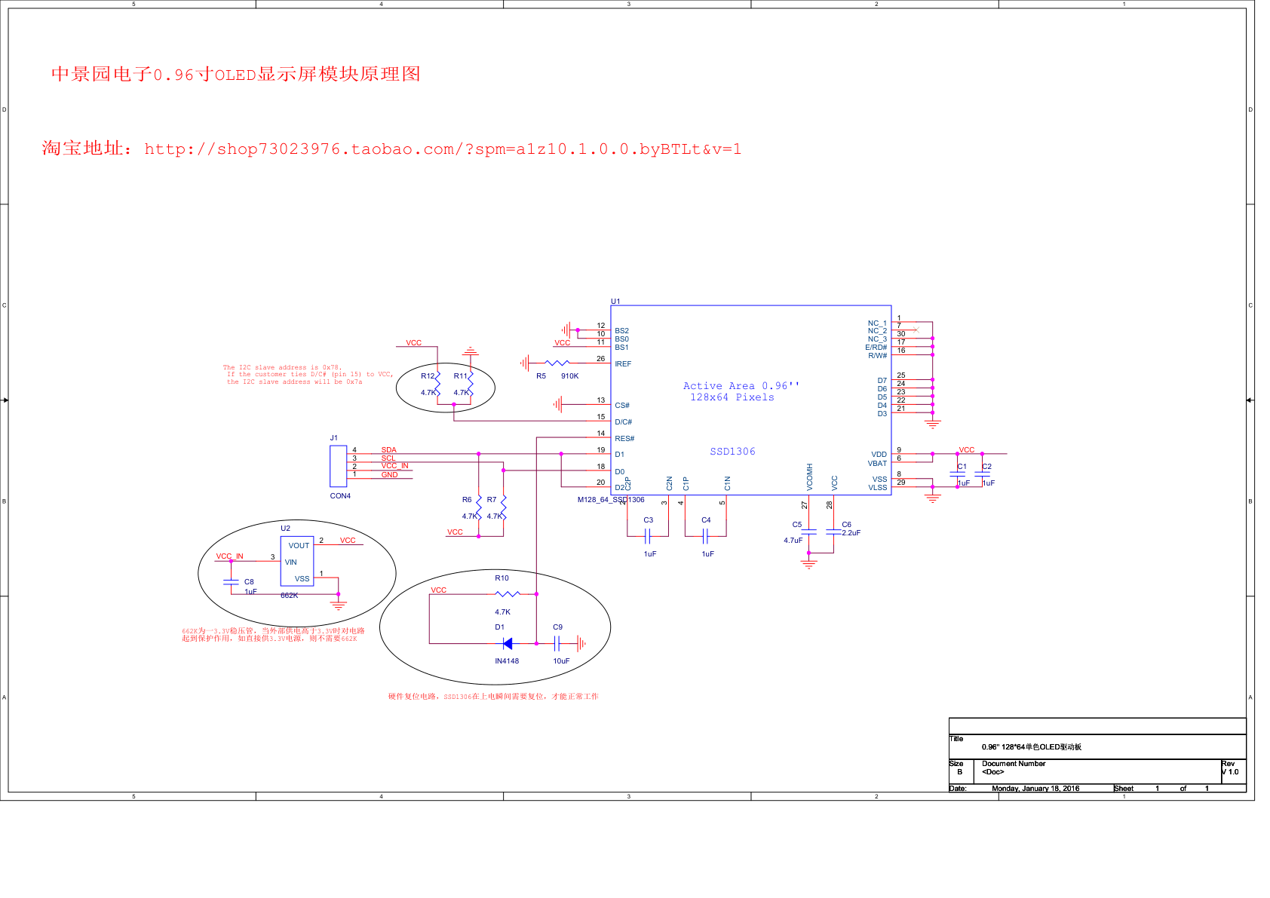
artifacts/user_module_sources/pdf_1.png
