Lucian-ming/smart-fans/artifacts/user_module_sources/tb_0.png

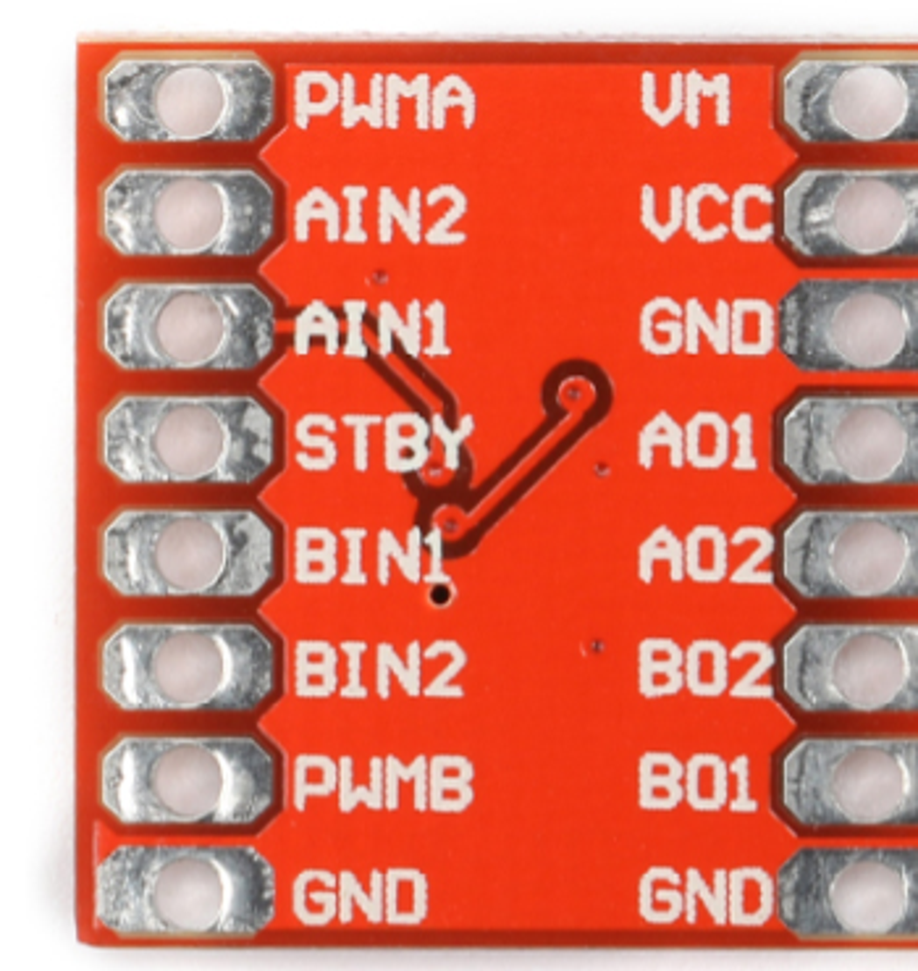
artifacts/user_module_sources/tb_0.png
