Lucian-ming/smart-fans/artifacts/user_module_sources/tb_90.png

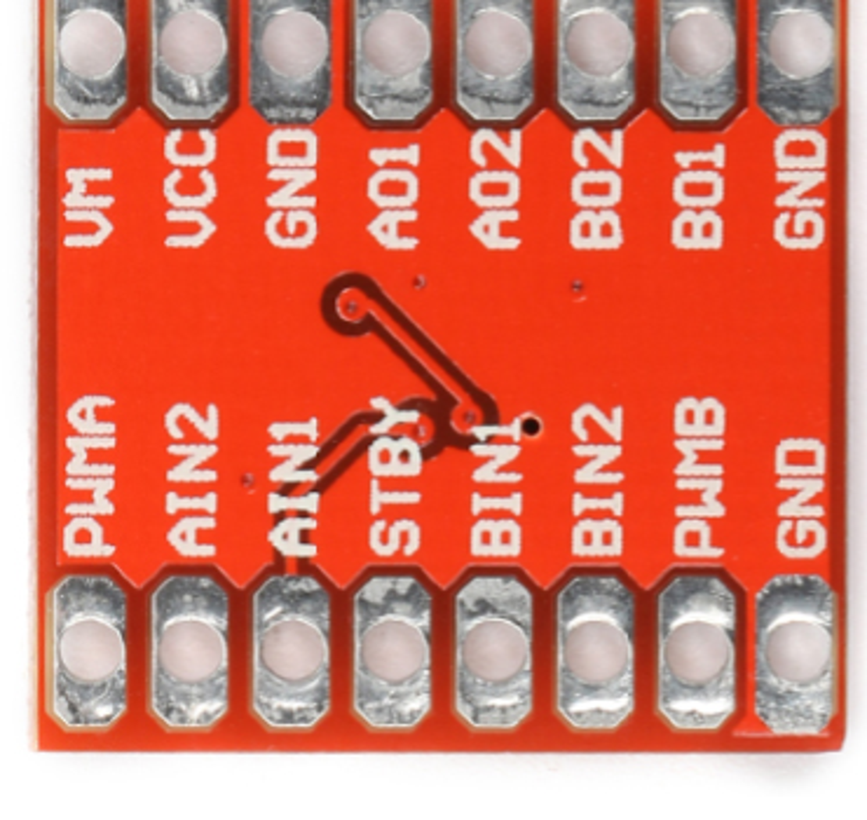
artifacts/user_module_sources/tb_90.png
