Lucian-ming/smart-fans/artifacts/user_module_sources/tb_180.png

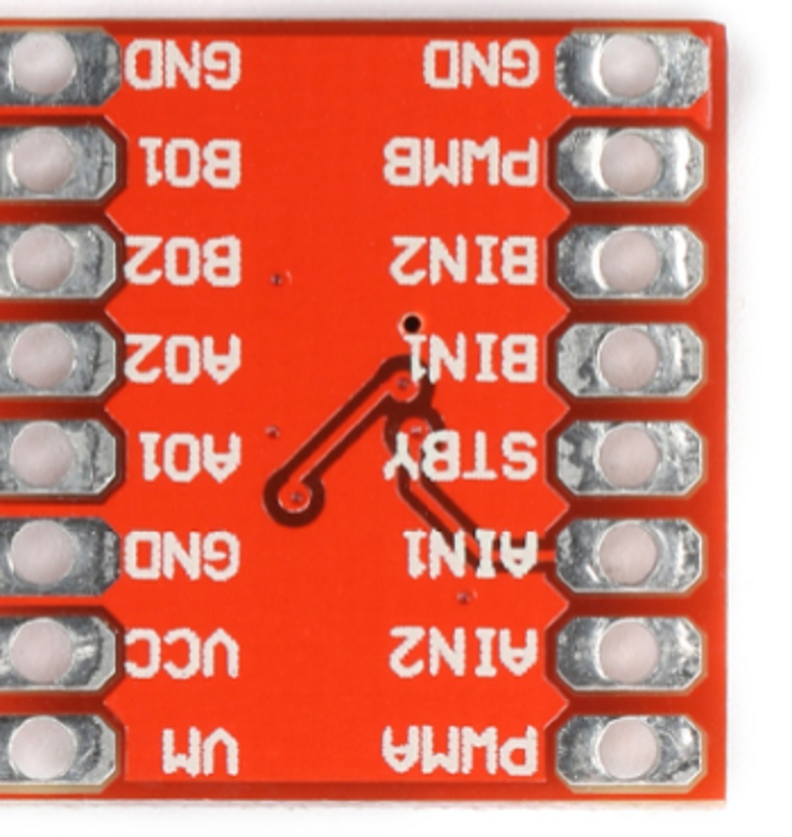
artifacts/user_module_sources/tb_180.png
