Lucian-ming/smart-fans/artifacts/user_module_sources/tb_270.png

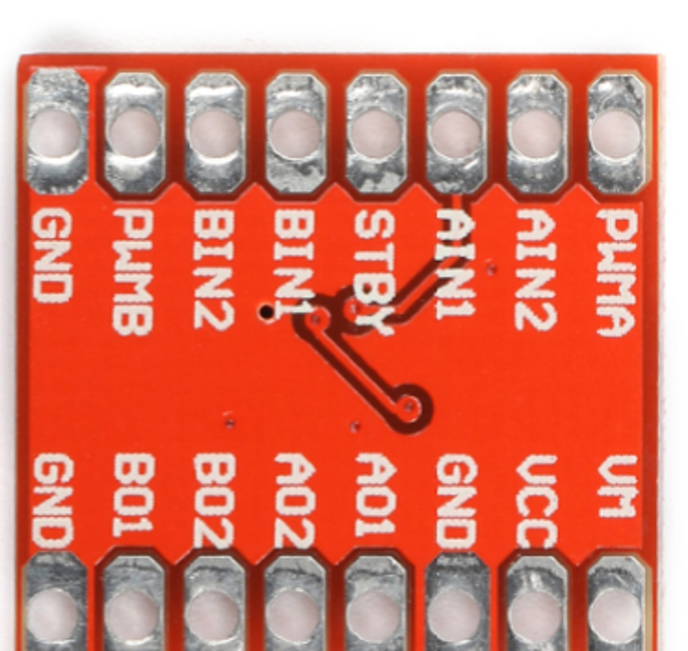
artifacts/user_module_sources/tb_270.png
