Lucian-ming/smart-fans/docs/hardware/sources/RZW-page1.png

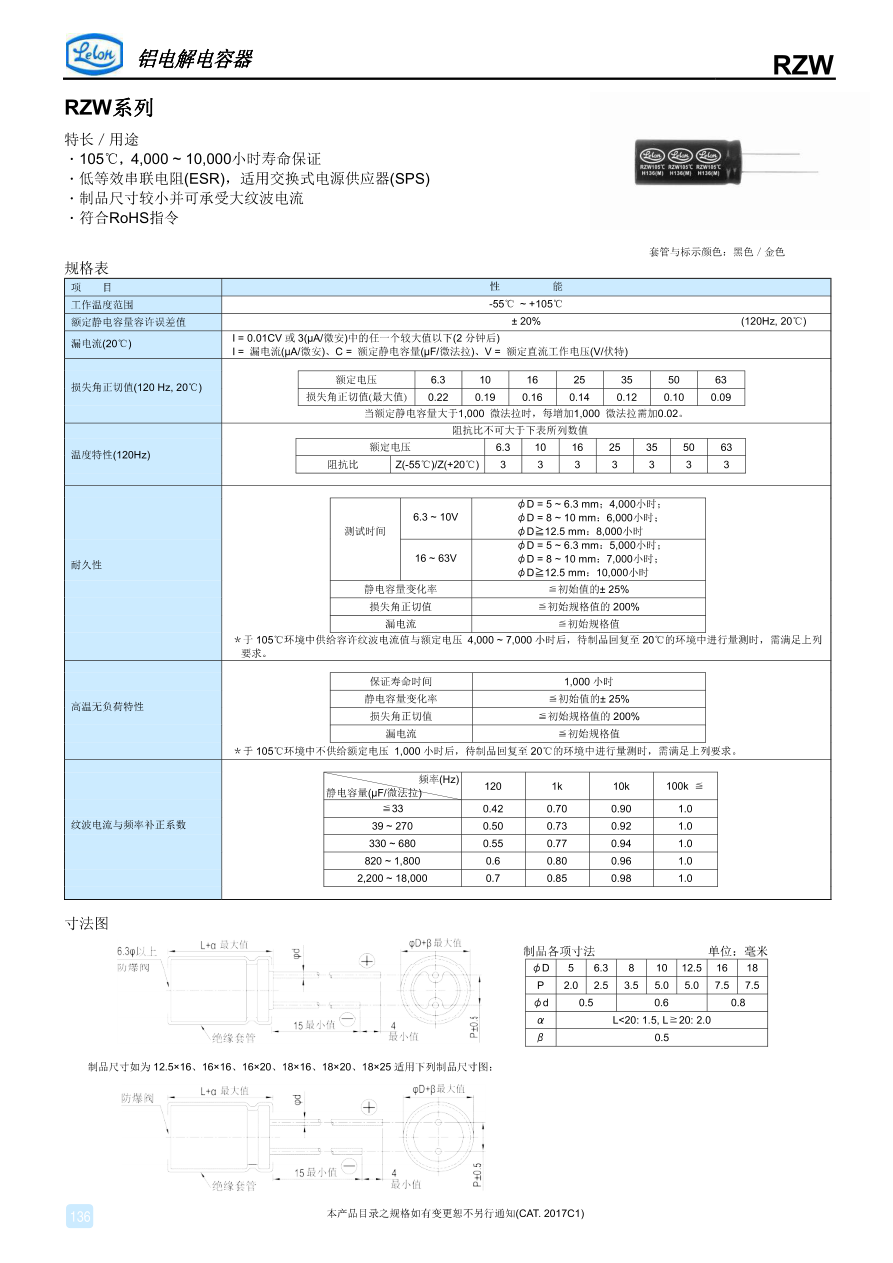
docs/hardware/sources/RZW-page1.png
