Lucian-ming/smart-fans/docs/hardware/sources/RZW-page2.png

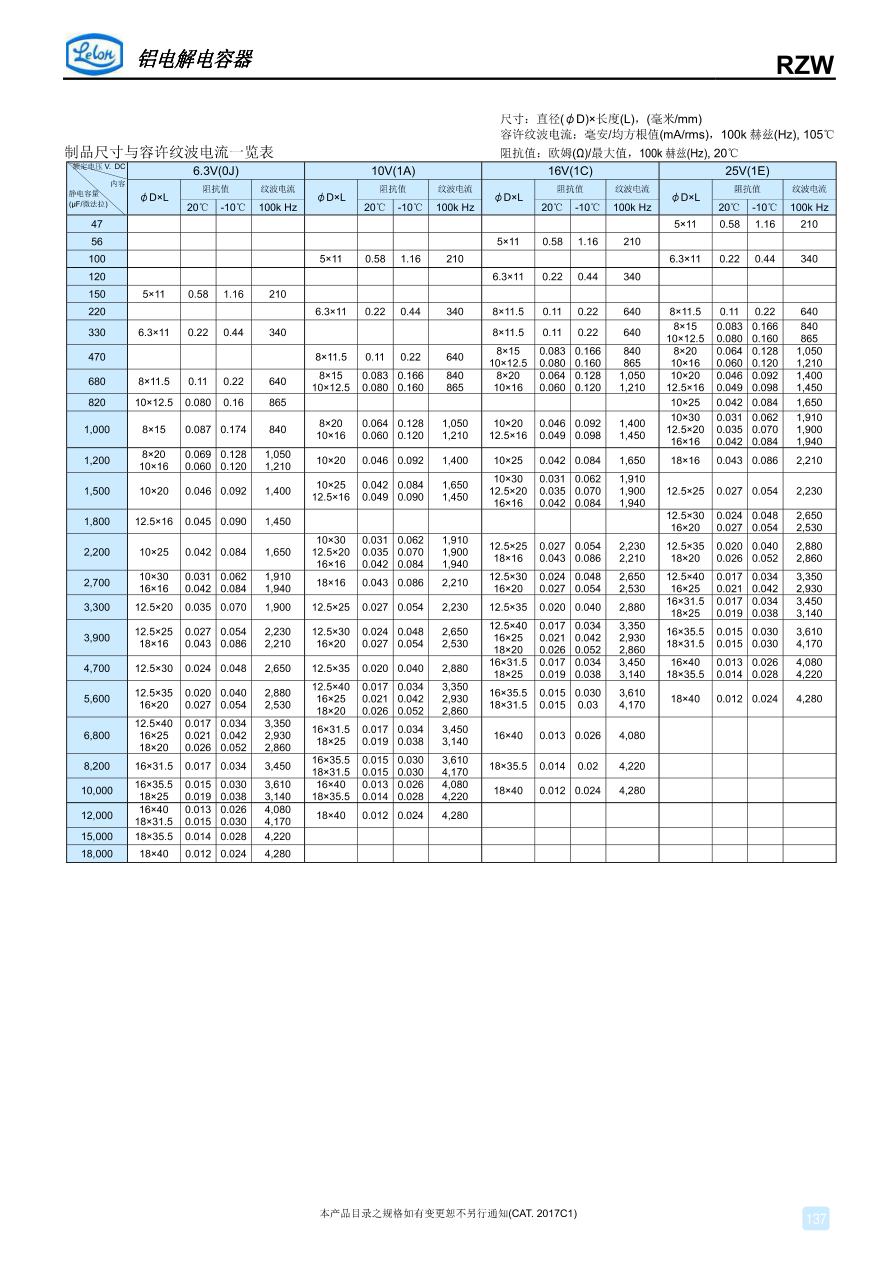
docs/hardware/sources/RZW-page2.png
