Lucian-ming/smart-fans/docs/hardware/sources/RZW-page3.png

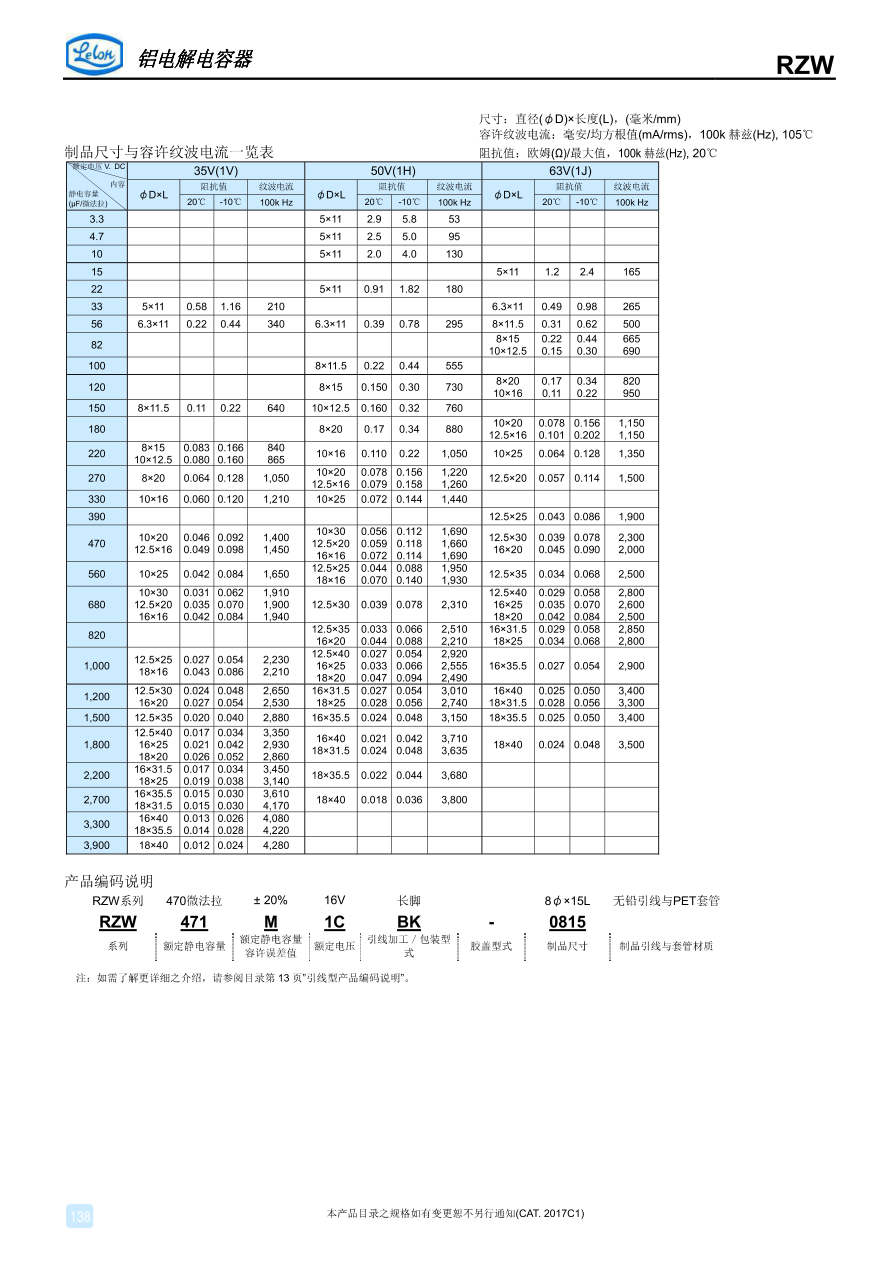
docs/hardware/sources/RZW-page3.png
