Lucian-ming/smart-fans/hardware/fan_ctrl_revB_layout.png

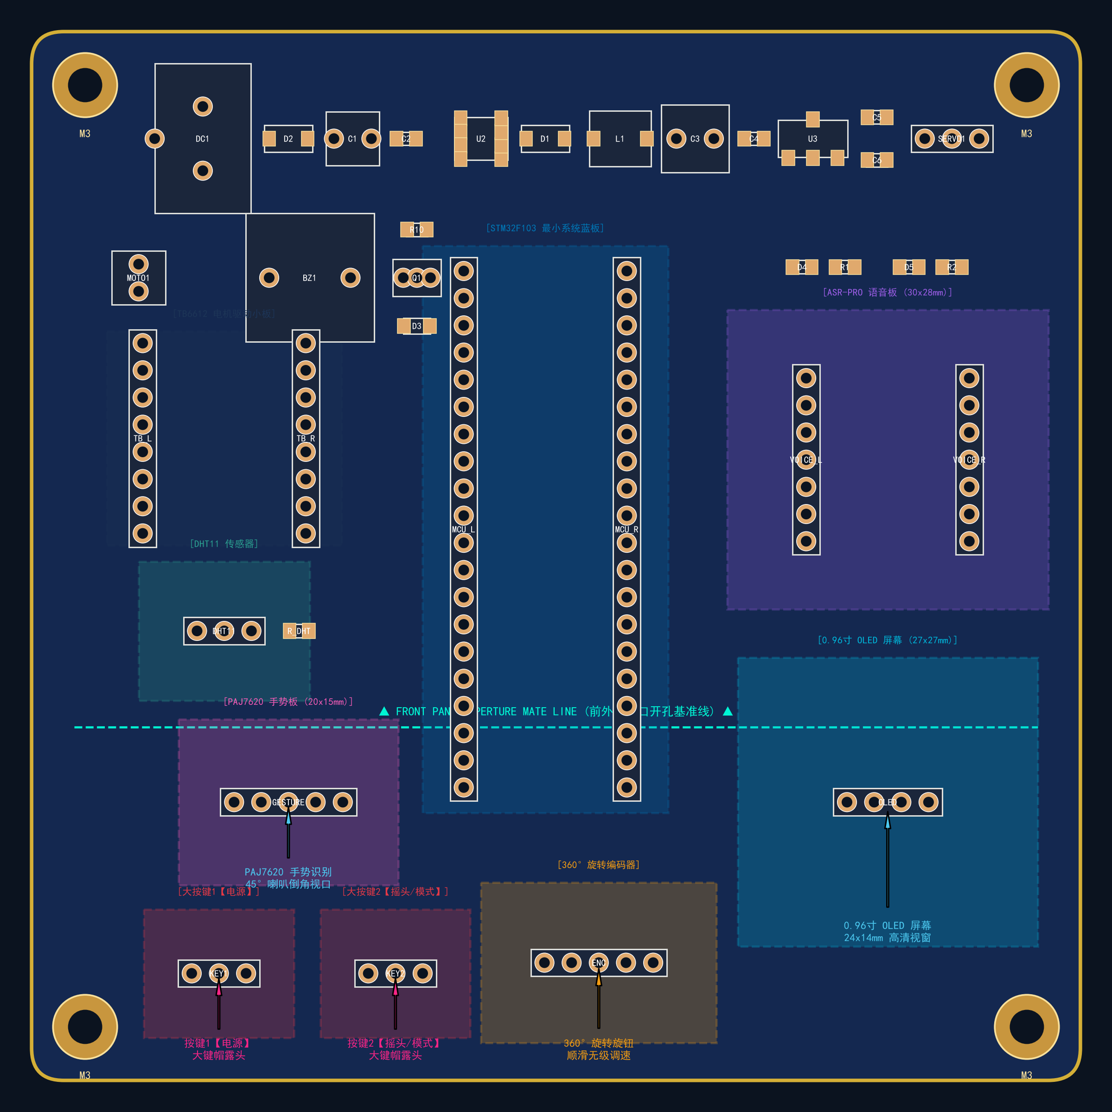
hardware/fan_ctrl_revB_layout.png
