Lucian-ming/smart-fans/hardware/ltspice/buzzer_flyback_waveforms.png

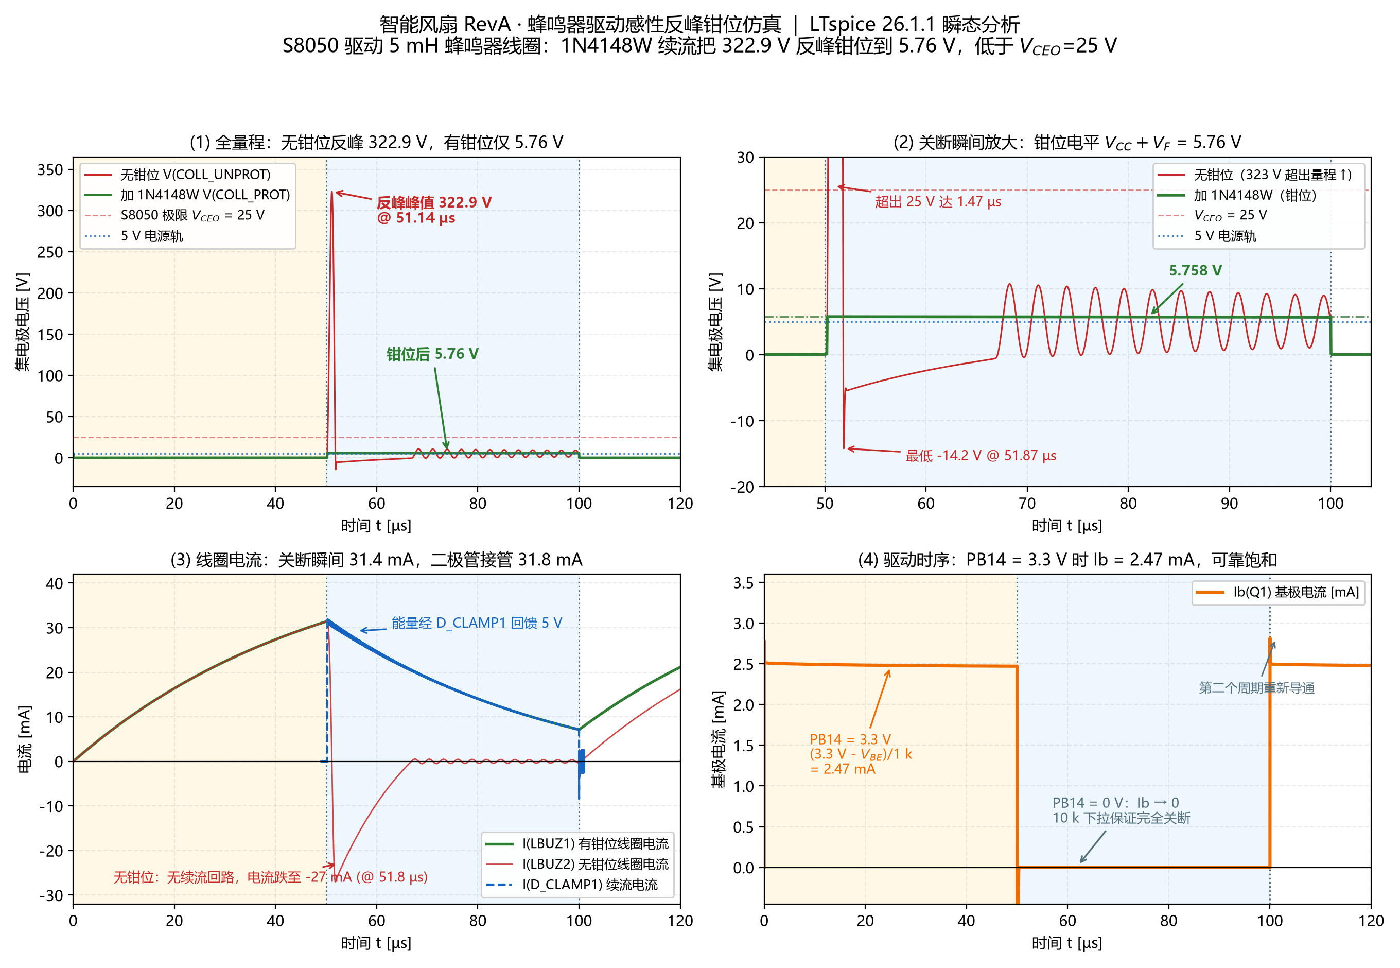
hardware/ltspice/buzzer_flyback_waveforms.png
