Lucian-ming/smart-fans/hardware/simulation/plot_05_ltspice_buzzer_flyback.png

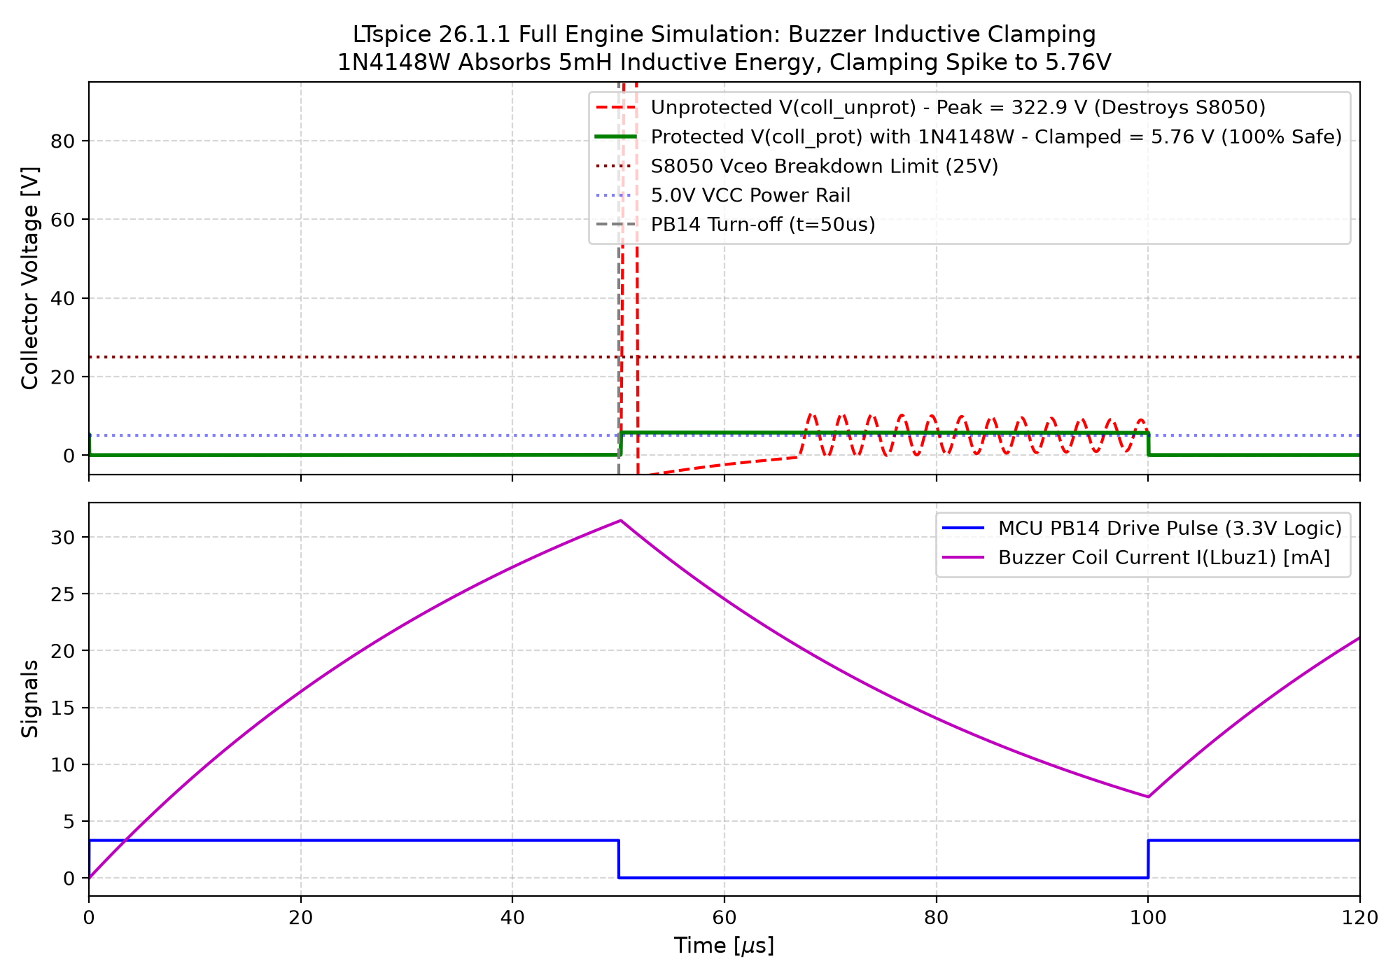
hardware/simulation/plot_05_ltspice_buzzer_flyback.png
