Lucian-ming/smart-fans/mechanical/concept_20261109/concept_preview.png

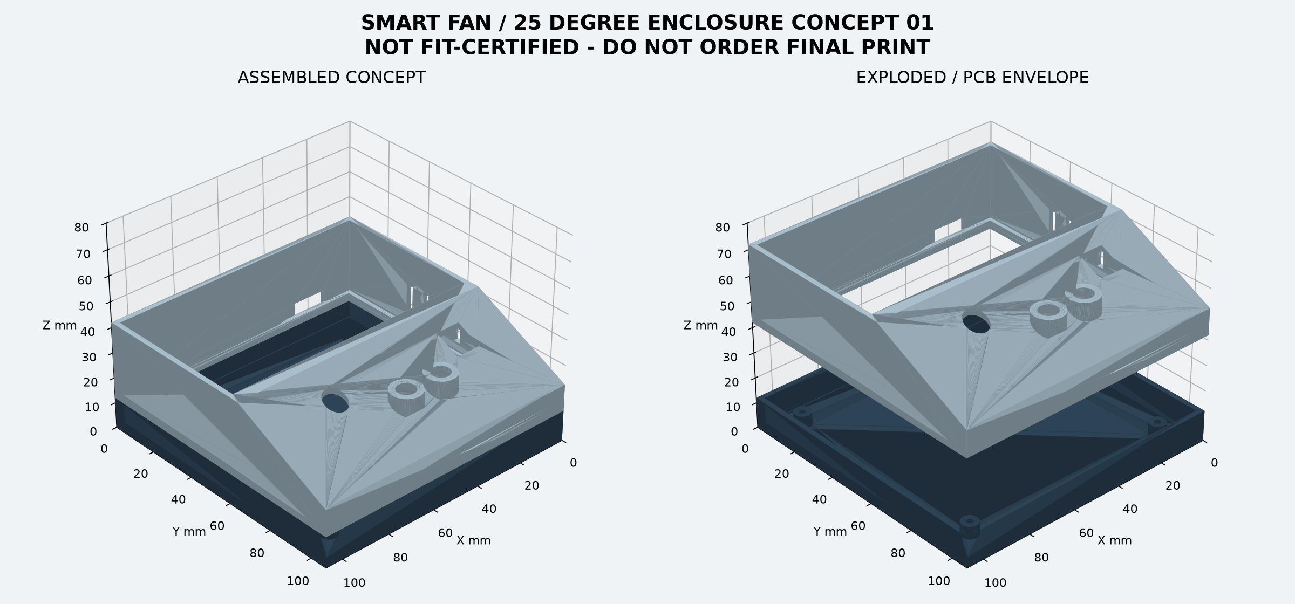
mechanical/concept_20261109/concept_preview.png
