Lucian-ming/smart-fans/mechanical/P2_mechanical_sections.png

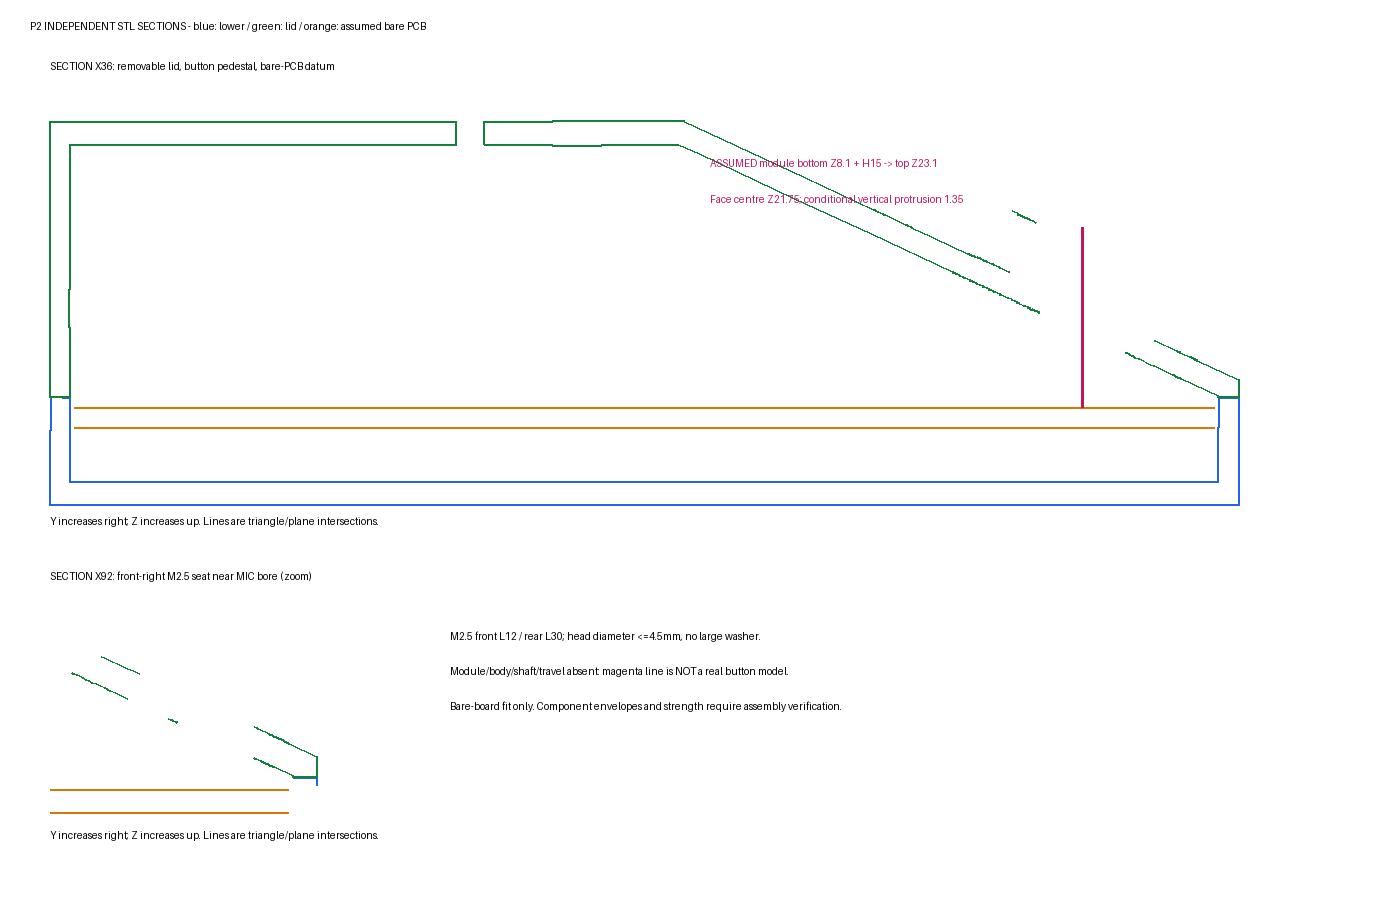
mechanical/P2_mechanical_sections.png
