Lucian-ming/smart-fans/tools/B3/piece1_front.png

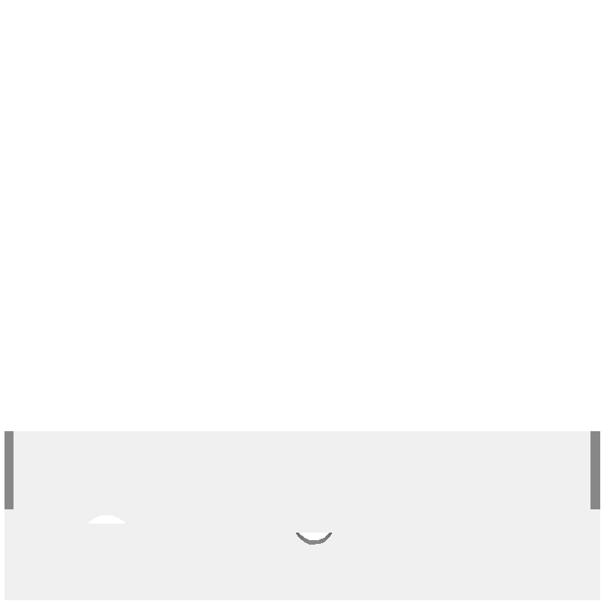
tools/B3/piece1_front.png
