Lucian-ming/smart-fans/tools/B3/piece1_top.png

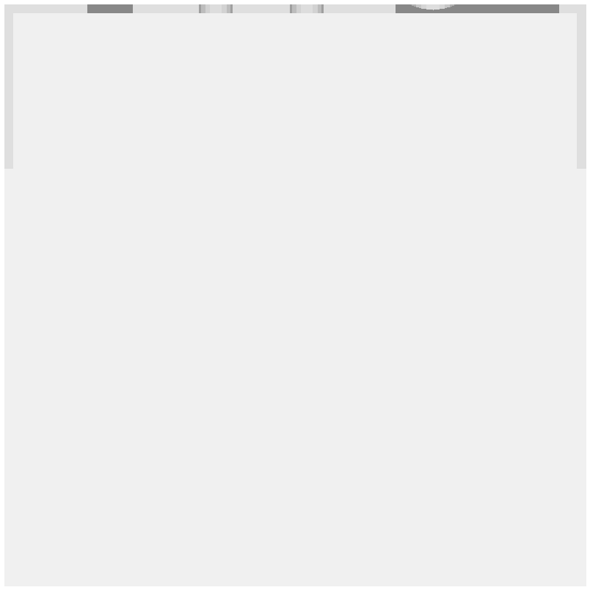
tools/B3/piece1_top.png
