Lucian-ming/smart-fans/tools/B3/zb_1.png

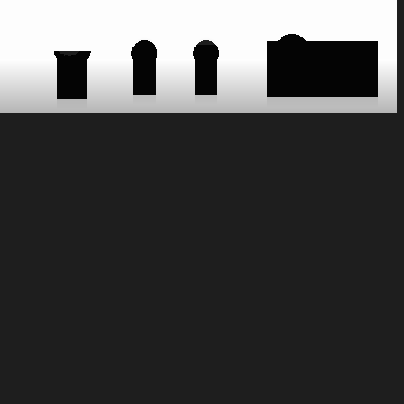
tools/B3/zb_1.png
