Lucian-ming/smart-fans/tools/B3/zb_2.png

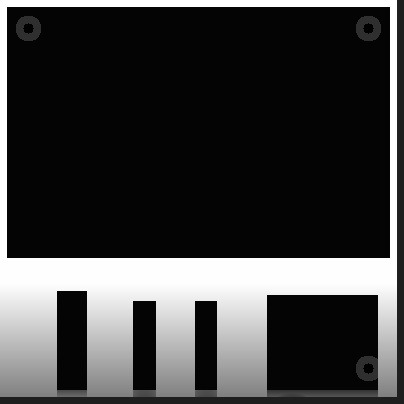
tools/B3/zb_2.png
