Lucian-ming/smart-fans/tools/B4_panel.png

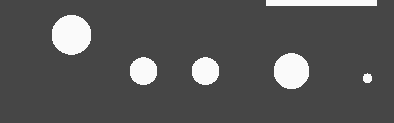
tools/B4_panel.png
