Lucian-ming/smart-fans/tools/B4_top.png

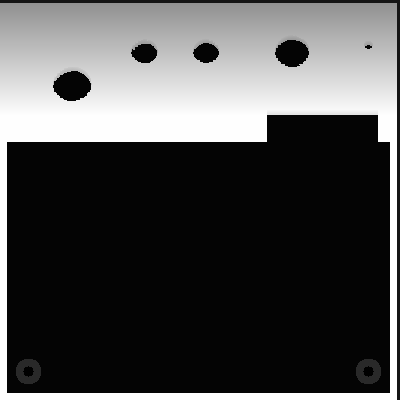
tools/B4_top.png
