Lucian-ming/smart-fans/tools/crop_front_left.png

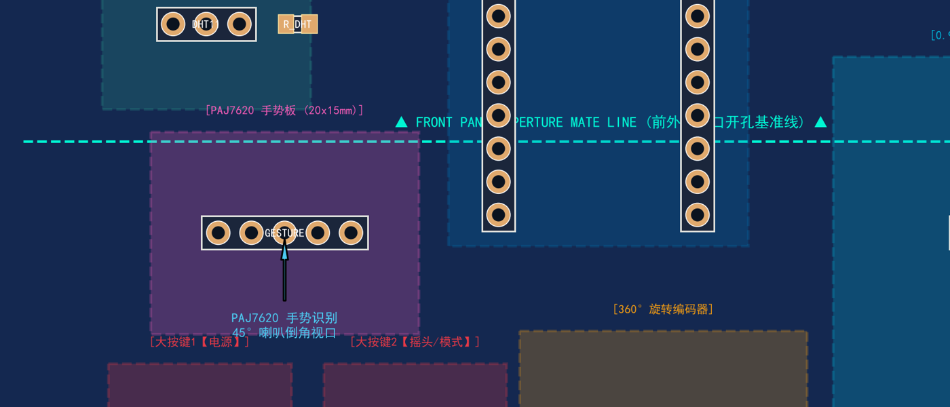
tools/crop_front_left.png
