Lucian-ming/smart-fans/tools/crop_front_right.png

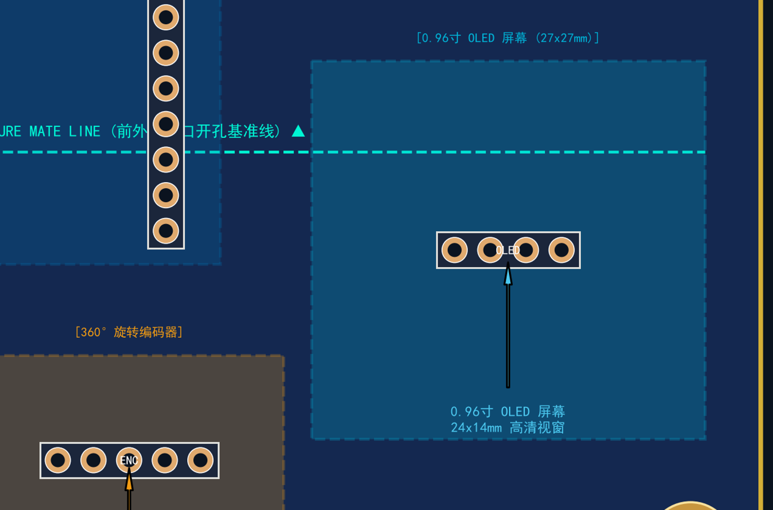
tools/crop_front_right.png
