Lucian-ming/smart-fans/tools/crop_paj_zone.png

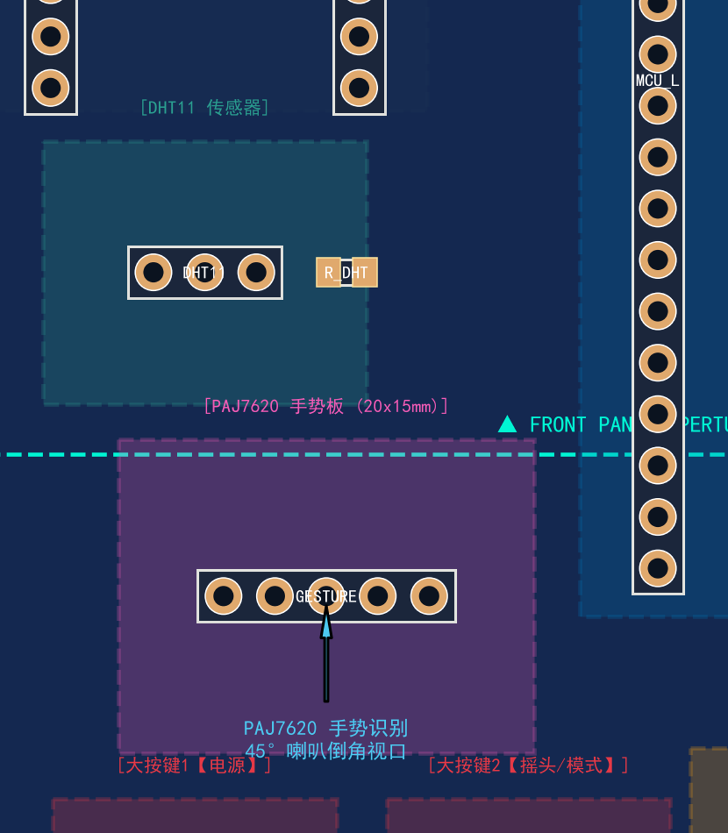
tools/crop_paj_zone.png
