Lucian-ming/smart-fans/tools/crop_top_left.png

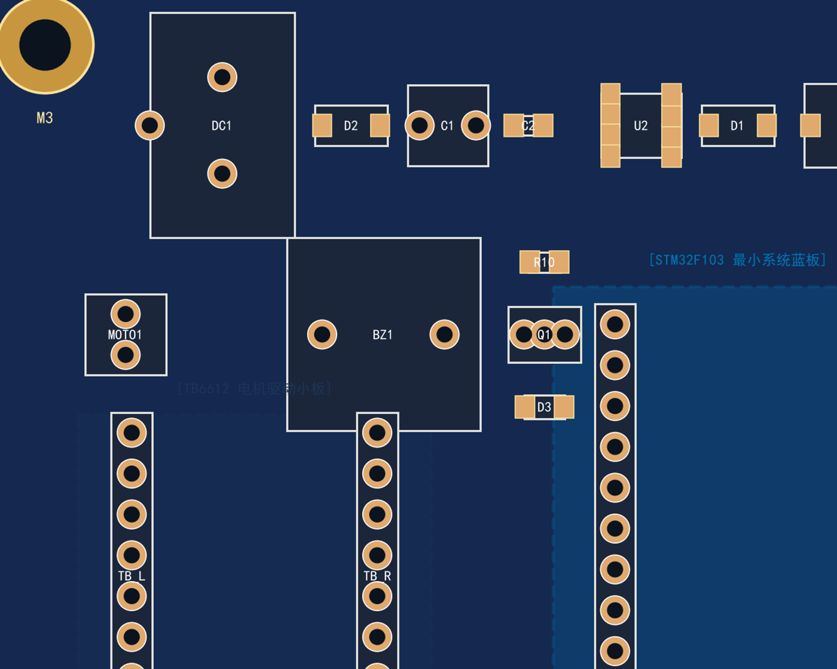
tools/crop_top_left.png
