Lucian-ming/smart-fans/artifacts/report_pack/pack/02_口径与风险清单.md

# 口径与风险清单（写报告前必须先对齐）

项目里存在多轮方案迭代，同一件事在不同文档里写法不同。下面 14 条是**已经核实过的冲突点**，每条给出：事实、影响、建议写法。

---

## 1. 电源：12V 方案已被 5V 方案取代

- **事实**：最终版是 **Rev B4 单 5V 输入**（4.75–5.25V）→ F1 3A 快断 → AO4409 P-MOS 防反接 → +5V 轨 → AMS1117-3.3 供 3.3V；**取消 12V 支路和 XL1509 降压**。主板上丝印也写着 "5V prototype"。
- **旧文件（只能当演进素材）**：`hardware/SIMULATION_REPORT.md`（顶部自述"历史 RevA 资料，不适用于当前单 5V"）、`hardware/SCHEMATIC_DESIGN.md`（RevA 12V 原理图规范）、`docs/assembly/soldering-guide.md`（上电表仍写 12V）、`docs/hardware/power-budget.md`（12V 预算）。
- **报告写法**：正文只写 5V；如需体现迭代，用一小段"方案演进"说明为什么去掉 12V（减少一级降压、降低失效点、风扇与舵机本身 5V 器件）。
- **绝对不要**：把 12V 的仿真数据（纹波 36.2mVpp、跌落 207.4mV 等）写成当前电路的实测/仿真结论。

## 2. 开题是"双 ESP32 + 无线"，实现是"单板 STM32"

- **事实**：开题报告（2026-11，第 3 组）原方案为手势遥控端 + 风扇执行端，两端 ESP32-C3、ESP-NOW 无线。仓库实现为**单块 STM32F103 主板**，手势传感器 PAJ7620 直接装在面板上（有线 I2C），**没有 ESP32、没有无线链路**。
- **影响**：开题 8 条指标里的第④条（3 m / 100 条 / 正确率 ≥95% / 状态回传去重）**没有对应实现**；第⑤条（≤1 s）也没有系统级实测。
- **报告写法**：在第 1 节单列"方案调整说明"，写清调整原因（课时与器件条件、单板即可覆盖语音+手势+按键三种交互、避免无线调试风险），并在指标表里把④标为"未实现（后续工作）"。**不要**在摘要或总结里写"完成了无线手势遥控"。

## 3. 外壳：几何合格 ≠ 装配通过

- **事实**：三件 STL 独立复核全部通过（水密、单壳体、无坏边，合计 68.97 cm³ < 70 cm³）；但 `artifacts/mechanical_joint_review.md` 的结论是：**"不能确认现有完整罩壳能容纳并正常连接全部清单实物；仅裸板/局部几何合格，禁止作为满载装配通过或量产依据"**，`assembly_release = false`。
- **已列出的未闭环点**：BluePill 的 USB 与后壳孔不对位；舵机槽与 BluePill 投影重叠；按键 15 mm 高度没有装配基准；OLED 窗中心与模块座在 Y 向差 7 mm（直插模块屏面不平行 25° 窗）；DHT11 在壳内测温不等于环境温度；喇叭与咪头插座仅距 5.5 mm；无 12025 风扇支架（当前只有 130 电机腔）。
- **报告写法**：外壳一节写"结构设计与打印件几何复核通过；整机装配关系尚在迭代，未做满载装配验证"。
- **绝对不要**：写"外壳装配验证通过""整机结构已完成"。

## 4. 原理图源文件在 KiCad 10 里打不开

- **事实**：`hardware/kicad/fan_ctrl_revB.kicad_sch` 用 `kicad-cli 10.0.7` 导出时报"加载原理图失败"（文件括号平衡、无截断，原因未定位）。同一设计的另一份副本 `artifacts/native_pcb_review/candidate_tlv1117/fan_ctrl_revB.kicad_sch` 可以正常打开、导出，并且是**通过 ERC/DRC 的那一份**。本包已把它复制为 `06_源文件索引/fan_ctrl_revB_TLV1117_working.kicad_sch`。
- **报告写法**：附图和"原理图文件"用可打开的副本；如老师要源文件，交这份。
- **建议**：后续用 KiCad 打开副本另存，覆盖回 `hardware/kicad/`，并在仓库里留一条修复记录。

## 5. 原理图是"网络标号式"，不是传统连线式

- **事实**：Rev B4 原理图为程序生成，44 个符号、168 个引脚（137 条导线 + 31 个 NC），**大量连接靠全局网络标号（label）表达**，不是教科书那种一根根画线的图。直接插进报告会显得"散"。
- **建议写法**：正文用**图 1 系统框图 + 表 3-1 引脚分配**讲连接关系；原理图（图 9）作为"完整网络连接依据"放在 3-2 节或附录，并加一句"本图采用网络标号连接方式，同名标号即同一网络"。
- **如果要传统连线图**：需要重绘（约 1–2 天工作量），本次未做。

## 6. 没有任何实物照片和实测数据

- **事实**：仓库里 `*.jpg/*.jpeg/*.heic` 数量为 0；`docs/logs/` 只有模板没有记录；审计报告明确写"用户无测量仪器，建议借设备或委托上电检查"。
- **影响**：模板第 4 节要求"实验过程及图片说明（至少三张图）"，**目前凑不出来**。
- **必须做**：见 `03_报告正文素材/4-1_实验过程及图片说明.md` 末尾的补拍清单（至少 3 张，建议 6 张）和补测清单。
- **过渡方案**：先用本包的设计图/渲染图占位，并在图注里写清"设计图/渲染图"，等实物照片到位再替换。

## 7. 连续舵机没有位置反馈，"0–90°"是时间近似

- **事实**：MG90S 是 **360° 连续旋转**舵机，PWM 控制的是**转速与方向**，不是角度；固件用"单向运行时间"限制扇面（默认半周期 2000 ms，档位 1–5 对应 2400/2200/2000/1800/1500 ms），换向前 120 ms 回中软刹车，启动前加 14 µs kickstart。
- **风险**：长时间运行会有累积角度漂移；没有限位开关/滑环，**可能绞线**。
- **报告写法**："采用定时换向近似 90° 扇面，实测角度未标定；后续可加限位或位置反馈"。不要写"精确 0–90°""角度闭环"。

## 8. DHT11 装在壳内，测的是机内温度

- **事实**：DHT11 插座在主板 (17.5, 57)，位于壳内；外壳没有为它设计通风/热隔离通道，而旁边就是 LDO、电机驱动和电机。
- **影响**：自动温控的"环境温度"会偏高、响应偏慢。
- **报告写法**：在"不足与改进"里写"温湿度传感器位于机内，受功率器件热影响，后续应移到进风口或加导风隔离"。

## 9. 电源 2A 能力没有实测，条件仿真已暴露边界

- **事实**：5V/2A 是**待验证目标**，不是额定值；`conditional_simulation_results.json` 用集总模型扫了 18 组供电回路：Vin=4.75 V、回路总阻 0.30 Ω、2 A 负载时母线最低约 **4.15 V**，低于 TB6612 的 VM 下限 4.5 V；18 组里有 6 组低于 4.5 V。
- **报告写法**：写"按 2 A 峰值估算，输入偏低或线阻偏大时母线可能跌破 4.5 V，需用短粗线并实测启动/堵转电流"。这是很好的"分析能力"素材，不要藏。
- **不要**：写"电源余量充足，实测 2 A 稳定"。

## 10. 需求文档与固件实现的差异

| 项 | 需求 v0.5（2026-11-03） | 实现 |
|---|---|---|
| 待机显示 | 30 s 无操作进微光时钟（对比度 0x05） | **10 s 熄屏**，无微光时钟 |
| 温控 | 26℃→25% 起转、32℃→100%，0.5℃ 滞回、≤10%/s 限幅 | **5 段**：<24 停 / 24–26 30% / 26–28 50% / 28–30 75% / >30 100% |
| 风扇 | 12025 4-Pin PWM + FG 测速，堵转判 FAULT | **130 直流电机 + TB6612**，无 FG、无堵转检测 |
| 测温 | DS18B20 | **DHT11**（含湿度） |
| 按键 | PB12 电源 / PB13 模式 / PB15 摇头 / PB0 静音 | KEY1 电源 / KEY2 短按摇头、长按切模式；编码器调速 |
| 扫风 | 0–90° | 定时近似（见第 7 条） |

- **报告写法**：用"需求 → 实现"对照表体现迭代，并说明原因（器件到货、成本、课时）。**同一份报告里只保留一套数字**，不要前面写 26/32℃、后面写 24/30℃。

## 11. BOM 44 项、PCB 48 元件、订单 24 行、LDO 换了型号

- **事实**：
  - 设计 BOM：**44 行**（`docs/hardware/bom.md`，不含价格）。
  - PCB：**48 个元件 / 173 个焊盘**（含跳帽、测试点、NC 位）。
  - 立创订单 SO2611058255：**24 行商品**，覆盖大部分阻容/芯片/接插件；端子、保险丝座、部分排母/跳帽需另行核对。
  - LDO：BOM 写 **AMS1117-3.3（C6186）**，实际下单是 **TLV1117LV33DCY（C42431859）**，PCB 与 ERC/DRC 用的是 TLV1117LV 版本。
- **报告写法**：BOM 表照抄 44 项；正文写"3.3V 稳压采用 TLV1117LV33（原设计 AMS1117-3.3，因原厂稳定性与压差考虑替换）"；成本按订单 146.69 元写，并注明"不含未下单的端子/结构件/3D 打印"。

## 12. 预算有四个数，选一个口径

| 数字 | 出处 | 含义 |
|---|---|---|
| 158 元 | `docs/01-requirements.md` | 早期物料估算 |
| 156.5 元 | `docs/hardware/power-budget.md` | 12V 方案物料估算 |
| 180 / 200 元 | 开题报告 | 预算 / 可报销上限 |
| **146.69 元** | 立创订单 SO2611058255 | **实际下单金额（含运费 9 元；商品 157.69 元，另有优惠）** |

- **报告写法**：写"实际下单 146.69 元，低于 180 元预算"，不要混用 158/156.5。

## 13. 结构件有三套版本，别混引

| 版本 | 内容 | 能否引用 |
|---|---|---|
| 六件套（`mechanical/drawings/assembly_spec.md`） | P01A 底座 110×110×28、P01B 前面板、P01C 顶盖、P02 摇臂、P03 12025 支架、P04 底板，约 108 g | 仅作"早期方案" |
| 两件套（`mechanical/concept_20261109/`） | 107×107 mm、最高 42 mm，**仅外观讨论，不可作生产文件** | 仅作概念图 |
| **三件套（最终）** | 下壳 + 可拆盖 + 风扇/舵机支架，合计 68.97 cm³ | **报告以这套为准** |

## 14. 语音/手势指标没有实测识别率

- **事实**：语音 20+ 命令词、9 种手势映射都在固件里实现并有单元测试；但"1 m 内 20 次识别率 ≥90%""手势 ≥90%""识别到动作 ≤1 s"**没有任何实测记录**。
- **报告写法**：写"功能已实现；识别率与响应时间需按表 4-7 的方法实测"，把测试方法写清楚（距离、次数、环境噪声、统计口径），这本身就是加分项。
