Lucian-ming/smart-fans/references/BOM_毕设-智能语音风扇.xlsx

ID | Name | Designator | Footprint | Quantity | Manufacturer Part | Manufacturer | Supplier | Supplier Part
1 | STM32F103C8T6 | U1 | LQFP-48_L7.0-W7.0-P0.50-LS9.0-BL | 1 | STM32F103C8T6 | ST(意法半导体) | LCSC | C8734
2 | 10K | BOOT2,BOOT1,R1,R11,R12,R17,R26,R27,R28,R29,R30,R31,R13,R7 | R0805 | 14
3 | 8MHz | X1 | CRYSTAL-SMD_L11.5-W4.8-LS12.7 | 1 | X49SM8MSD2SC | YXC(扬兴晶振) | LCSC | C12674
4 | 100nF | C6,C7,C8,C9,C11,C12,C22,C17,C19 | C0805 | 9
5 | HDR-M_2.54_1x4P | DSTM1,DASR1 | HDR-TH_4P-P2.54-V-M | 2 |  |  |  | C492403
6 | 22Ω | R2,R3 | R0805 | 2
7 | 10uF | C4,C16,C18,C13 | C0805 | 4
8 | Key_SMD_3.6x6.1x2.5 | RST1 | Key_SMD_3.6x6.1x2.5 | 1
9 | 0.96OLED模块_4P | OLED1 | 0.96OLED_4P | 1
10 | ASRPRO | MCU1 | ASRPRO | 1
11 | HDR-M_2.54_1x2P | SPK1 | HDR-TH_2P-P2.54-V-M-1 | 1 | B-2100S02P-A110 | Ckmtw(灿科盟) | LCSC | C124375
12 | GMI4522P-2C-60db | MIC1 | MIC-TH_BD4.5-P1.60-D0.40-L-FD | 1 | GMI4522P-2C-60db | INGHAi(赢海) | LCSC | C233320
13 | 10K | R4,R5,R8,R9 | R0402 | 4
14 | 100K | R10 | R0603 | 1
15 | MF58 104F3950 | R14 | RES-TH_BD2.5-L4.7-P8.70-D0.5 | 1 | MF58 104F3950 | 时恒 | LCSC | C123399
16 | AO3400A | Q1 | SOT-23-3_L2.9-W1.6-P1.90-LS2.8-BR | 1 | AO3400A | AOS | LCSC | C20917
17 | XH-2PA | U2,U3 | CONN-TH_XH-2A | 2 | XH-2PA | ZHOURI(洲日) | LCSC | C5258883
18 | 10 | R15 | R0805 | 1
19 | 12k | R16 | R0805 | 1
20 | JDY-31 | BLUETOOTH1 | HC-05 PCB | 1
21 | CR1220-2 | B1 | BAT-SMD_CR1220-2 | 1 | CR1220-2 | QJ | LCSC | C70381
22 | LL4148 | D1,D2 | LL-34_L3.4-W1.5-RD | 2 | LL4148 | YONGYUTAI(永裕泰) | LCSC | C2891733
23 | 10pF | C5,C10 | C0805 | 2
24 | 20pF | C3,C2 | C0805 | 2
25 | 10nF | C1 | C0805 | 1
26 | 32.768kHz | X2 | OSC-TH_BD2.0-P0.70-D0.3 | 1 | X206032768KGA2SC | YXC(扬兴晶振) | LCSC | C13712
27 | LED_0603-G | LED3 | LED_0603 | 1
28 | LED_0603-R | LED4,LED1 | LED_0603 | 2
29 | LED_0603-B | LED5 | LED_0603 | 1
30 | 舵机接口 | U6 | 舵机 | 1
31 | S8050_SOT_NPN | Q2 | S8050_SOT-23 | 1
32 | D_1N4007 | D5 | SMA_1N4007 | 1
33 | TS-1101-B-W_C500065 | KEY1 | KEY-SMD_2P-L6.0-W3.6-P7.4-LS8.0-L | 1 |  | XKB Connection(中国星坤) | LCSC | C500065
34 | TS-1101-B-W | KEY2,KEY3 | KEY-SMD_2P-L6.0-W3.6-P7.4-LS8.0-L | 2 | TS-1101-B-W | XKB Connection(中国星坤) | LCSC | C500065
35 | {Manufacturer Part!} | U4 | SOT_223 | 1
36 | M3 | H1,H2,H3,H4 | m3 125x300 | 4
37 | 100nF | C20,C15 | c0805 | 2
38 | 1K | R20 | R0805 | 1
39 | 3K | R19 | R0805 | 1
40 | 1nF | C23 | c0805 | 1
41 | SS24 | D4,D3 | SMA_L4.4-W2.6-LS5.0-RD | 2 | SS24 | 晶导微电子 | LCSC | C115726
42 | 47uh | L1 | IND-SMD_L7.4-W6.6 | 1 | CKST0603-4.7uH/M | CENKER(岑科) | LCSC
43 | XL1509-ADJ | U5 | SOIC-8_L5.0-W4.0-P1.27-LS6.0-BL | 1 | XL1509-ADJ | UMW(广东友台半导体) | LCSC | C2681227
44 | 100uF | C21,C14 | CAP-SMD_BD8.0-L8.3-W8.3-FD | 2 | 25SVPF100M | PANASONIC(松下) | LCSC | C136279
45 | DC-005_2.5 | DC1 | DC-005_2.5 | 1
46 | SS-12D10L5 | SW2 | SW-TH_SS-12D10L5 | 1 | SS-12D10L5 | XKB Connectivity(中国星坤) | LCSC | C319012
47 | 100K | R21,R6 | R0805 | 2
