Lucian-ming/smart-fans/artifacts/report_pack/pack/04_表格数据/报告表格.xlsx

Sheet: 表1-1 技术指标
序号 | 指标（开题） | 设计/实现值 | 状态 | 依据
① | 三种以上控制方式，支持启停/三档/摇头/模式 | 四种：按键、EC11、手势、离线语音；启停、10%/步调速、摇头、手动/自动 | 达成（无线手势除外） | fan_fsm.c / main.c
② | 离线语音≥6条，1m内每条20次识别率≥90% | 20+命令词、双唤醒词；识别率未实测 | 功能达成，指标未测 | firmware/asr_pro/
③ | 手势≥4种，识别率≥90%，有防重复 | 9种映射，200ms防重复；识别率未实测 | 功能达成，指标未测 | paj7620.c
④ | 3m内100条指令正确率≥95%，状态回传与去重 | 无无线链路 | 未实现 | —
⑤ | 识别到动作≤1s | 事件驱动，设计目标<200ms；未实测 | 未实测 | 主循环20ms节拍
⑥ | ≥3个温度区间回差调速，手动可保持 | 5段：<24℃停/24-26℃30%/26-28℃50%/28-30℃75%/>30℃100% | 达成（设计） | fan_fsm_update_auto_temp()
⑦ | OLED显示温度/档位/模式/状态，连续1h不死机 | 显示已实现；1h老化未做 | 部分 | ssd1306.c
⑧ | 两端原理图/PCB/焊装/程序/测试/报告 | 单端原理图、PCB、固件、审计完成；焊装与实测未完成 | 部分 | 本包

Sheet: 表3-1 引脚分配
引脚 | 网络 | 外设/模式 | 说明
PA0 | TB_PWMA | TIM2_CH1 PWM 25kHz | 电机调速，占空比0-100%
PA1 | TB_AIN1 | GPIO推挽 | 方向1
PA5 | TB_AIN2 | GPIO推挽 | 方向2
PB0 | TB_STBY | GPIO推挽（10k下拉） | 驱动使能，默认关断
PB8 | SERVO_PWM | TIM4_CH3 PWM 50Hz | 舵机0.5-2.5ms脉宽
PB6 | I2C1_SCL | I2C1开漏+4.7k上拉 | OLED 0x3C、PAJ7620 0x73
PB7 | I2C1_SDA | I2C1开漏+4.7k上拉 | 同上
PA4 | GEST_INT | EXTI下降沿 | 手势中断
PA6 | ENC_A | TIM3编码器模式 | 硬件正交解码
PA7 | ENC_B | TIM3编码器模式 | 硬件正交解码
PB12 | — | 留空 | 5脚EC11无按压开关，严格未启用
PB13 | KEY1 | GPIO上拉+消抖 | 电源启停
PB14 | KEY2 | GPIO上拉+消抖 | 短按摇头/长按切模式
PB15 | BUZZER | GPIO→2N3904 | 有源蜂鸣器，1N4148续流
PB9 | DHT11 | 单总线（4.7k上拉） | 每2s读一次
PA2 | VOICE_TX | USART2 115200 | 与ASR-PRO通信
PA3 | VOICE_RX | USART2 115200 | 与ASR-PRO通信
PA9 | DBG_TX | USART1 115200 | 调试CLI
PA10 | DBG_RX | USART1 115200 | 调试CLI
PC13 | LED | GPIO | 心跳/状态指示
SWDIO/SWCLK | — | SWD | 烧录与在线调试

Sheet: 表4-3 上电检查
检查点 | 方法 | 合格范围 | 实测 | 结论
不上电 | 万用表测+5V对GND电阻 | >1kΩ（无短路）
上电（限流0.1A） | 测+5V | 4.9-5.1V，电流<50mA
上电 | 测+3.3V | 3.25-3.35V
上电 | 示波器测5V纹波（20MHz带宽） | <100mVpp
烧录后 | 看PC13心跳灯 | 0.5s闪
电机 | 10%起调逐步加 | 转向正确，空载电流<0.5A
舵机 | 1500µs停转，1300/1700µs正反转 | 无堵转异响

Sheet: 表4-6 调试命令
命令 | 作用
help | 列出所有命令
status | 打印状态机状态、占空比、温湿度、模式、摇头
safe | 立即停机（PWM=0、舵机回中、STBY拉低）
test led | 心跳灯闪烁
test buz | 蜂鸣器响一声
test key | 打印按键事件（短按/长按）
test enc | 打印编码器计数与方向
test dht | 读一次温湿度并打印原始字节
test i2c | 扫描I2C总线，打印在线地址
test oled | 显示测试画面
test gest | 打印手势事件与INT计数
test voice | 打印语音模块命令字
test motor | 按10%步进扫一遍占空比
test servo | 正转/停/反转各2s
servo_cal | ±200µs校准舵机死区（掉电保存）

Sheet: BOM 44项
序号 | 位号 | 数量 | 规格 | 封装 | 立创编号 | 型号 | 厂商 | 说明
1 | BZ1 | 1 | 5V_BUZZER | Buzzer_Beeper:Buzzer_12x9.5RM7.6 | C96093 | TMB12A05 | Huaneng | 5V 有源提示蜂鸣器
2 | C1 | 1 | 100uF/25V | Capacitor_THT:CP_Radial_D6.3mm_P2.50mm | C134665 | RZW101M1EBK-0611 | Lelon | 受保护5V储能电解
3 | C2 | 1 | 100nF | Capacitor_SMD:C_0805_2012Metric | C49678 | 0805B104K500NT | FH | 受保护5V 高频去耦电容
4 | C3 | 1 | 220uF/16V | Capacitor_THT:CP_Radial_D6.3mm_P2.50mm | C338177 | 16ZLH220MEFC6.3X11 | Rubycon | 5V 输出滤波电解
5 | C4 | 1 | 100nF | Capacitor_SMD:C_0805_2012Metric | C49678 | 0805B104K500NT | FH | 5V 输出高频去耦
6 | C5 | 1 | 10uF | Capacitor_SMD:C_0805_2012Metric | C15849 | 0805B106K160NT | FH | 3.3V 输入去耦 (直连5V)
7 | C6 | 1 | 10uF | Capacitor_SMD:C_0805_2012Metric | C15849 | 0805B106K160NT | FH | 3.3V 输出滤波
8 | C7 | 1 | 100nF | Capacitor_SMD:C_0805_2012Metric | C49678 | 0805B104K500NT | FH | 3.3V 输出高频去耦
9 | C_VM | 1 | 220uF/16V | Capacitor_THT:CP_Radial_D6.3mm_P2.50mm | C338177 | 16ZLH220MEFC6.3X11 | Rubycon | TB6612 VM电机就近储能电解
10 | C_VM_MLCC | 1 | 100nF | Capacitor_SMD:C_0805_2012Metric | C49678 | 0805B104K500NT | FH | TB6612 VM就近去耦
11 | D3 | 1 | 1N4148W | SmartFan:D_SOD-123_R180 | C81598 | 1N4148W | ST | 蜂鸣器反向钳位二极管
12 | D4 | 1 | LED_GREEN | LED_SMD:LED_0805_2012Metric | C2292 | KT-0805YG | KENTO | 5V 供电指示灯
13 | D5 | 1 | LED_BLUE | LED_SMD:LED_0805_2012Metric | C2293 | KT-0805B | KENTO | 3.3V 逻辑指示灯
14 | DC1 | 1 | 5V_ONLY_MKDSN_1,5/2-5.08 | SmartFan:Phoenix_1729128_MKDSN_1x02_P5.08mm |  | 1729128 | Phoenix Contact | 唯一稳压5V输入; 1=+5V 2=GND; 禁接12V; 1729128 MKDSN 1,5/2-5,08; 壳10.16x8.15板上高10mm; 壳相对针排偏置待核; 库存未核
15 | F1 | 1 | 3A_FAST_NOT_CURRENT_LIMIT | Fuse:Fuse_Littelfuse-NANO2-451_453 |  | 0451003.MRL | Littelfuse | 3A快断保险; 不是3A硬限流; 整板连续目标<=2A须热测/启动I2t验证; 库存未核
16 | JP_ASR | 1 | REMOVE_BEFORE_ASR_USB | Connector_PinHeader_2.54mm:PinHeader_1x02_P2.54mm_Vertical |  | M20-9990245 + M7566-05 | Harwin | ASR供电隔离跳帽; USB前与TX/RX三帽一起拔掉; 非自动电源隔离
17 | JP_ASR_RX | 1 | REMOVE_BEFORE_ASR_USB | Connector_PinHeader_2.54mm:PinHeader_1x02_P2.54mm_Vertical |  | M20-9990245 + M7566-05 | Harwin | ASR TX1(PA2)到MCU RX隔离; USB前拔帽
18 | JP_ASR_TX | 1 | REMOVE_BEFORE_ASR_USB | Connector_PinHeader_2.54mm:PinHeader_1x02_P2.54mm_Vertical |  | M20-9990245 + M7566-05 | Harwin | MCU TX到ASR RX1(PA3)隔离; USB前拔帽
19 | JP_USB | 1 | REMOVE_BEFORE_USB | Connector_PinHeader_2.54mm:PinHeader_1x02_P2.54mm_Vertical |  | M20-9990245 + M7566-05 | Harwin | 2.54跳帽供蓝板; 任何USB插入前必须拔帽; USB不能供母板; 两边电源独立开启后才接信号; 不允许单侧带电
20 | J_DHT11 | 1 | DHT11_SOCK | Connector_PinHeader_2.54mm:PinHeader_1x03_P2.54mm_Vertical | C2718487 | 2.54-1*3P母 | BOOMELE | DHT11 温湿度传感器母座
21 | J_ENC | 1 | EC11_ENCODER_2P_3P | SmartFan:EC11_Module_2P_3P_Row21mm |  | 2.54-1x2P + 1x3P female sockets | Generic | 用户实测2+3编码器: 上1=3V3/2=GND, 下3=A/4=C(GND)/5=B; 组距21mm; 无SW
22 | J_GESTURE | 1 | PAJ7620_GEST | Connector_PinHeader_2.54mm:PinHeader_1x05_P2.54mm_Vertical | C50950 | 2.54-1*5P母 | BOOMELE | PAJ7620 手势识别母座
23 | J_KEY1 | 1 | KEY1_POWER | Connector_PinHeader_2.54mm:PinHeader_1x03_P2.54mm_Vertical | C2718487 | 2.54-1*3P母 | BOOMELE | 按键1【电源开关】直插母座
24 | J_KEY2 | 1 | KEY2_SWING | Connector_PinHeader_2.54mm:PinHeader_1x03_P2.54mm_Vertical | C2718487 | 2.54-1*3P母 | BOOMELE | 按键2【摇头模式】直插母座
25 | J_MCU_L | 1 | BLUEPILL_L | Connector_PinHeader_2.54mm:PinHeader_1x20_P2.54mm_Vertical | C50984 | 2.54-1*20P母 | BOOMELE | STM32 核心板P4左排母 (本地PcbDoc/PDF核验; 1=3V3隔离, 2=GND, 3=5V; pin20端朝低Y)
26 | J_MCU_R | 1 | BLUEPILL_R | Connector_PinHeader_2.54mm:PinHeader_1x20_P2.54mm_Vertical | C50984 | 2.54-1*20P母 | BOOMELE | STM32 核心板P3右排母 (本地PcbDoc/PDF核验; 1=VBAT, 18=3V3隔离, 19/20=GND; pin20端朝低Y)
27 | J_OLED | 1 | OLED_12864 | Connector_PinSocket_2.54mm:PinSocket_1x04_P2.54mm_Vertical | C2718488 | 2.54-1*4P母 | BOOMELE | OLED安装要求:屏体朝-Y; 顶视左到右SDA/SCL/VCC/GND; 实物核序前禁止上电
28 | J_TB_L | 1 | TB6612_CTRL | Connector_PinSocket_2.54mm:PinSocket_1x08_P2.54mm_Vertical | C27438 | 2.54-1*8P母 | BOOMELE | TB6612 控制排母
29 | J_TB_R | 1 | TB6612_PWR | Connector_PinSocket_2.54mm:PinSocket_1x08_P2.54mm_Vertical | C27438 | 2.54-1*8P母 | BOOMELE | TB6612 动力排母
30 | J_VOICE_L | 1 | ASR_PRO_L_8P | Connector_PinSocket_2.54mm:PinSocket_1x08_P2.54mm_Vertical |  | 1x08 female P2.54 (verify procurement) | TBD | ASR左8P母座; 顶=GND; 用户确认排距25.40; UART1固件必配; 料号待采购核验
31 | J_VOICE_R | 1 | ASR_PRO_R_8P | Connector_PinSocket_2.54mm:PinSocket_1x08_P2.54mm_Vertical |  | 1x08 female P2.54 (verify procurement) | TBD | ASR右8P母座; 顶=PA4/底=SPK+; 3V3输出隔离; 料号待采购核验
32 | MOTO1 | 1 | 130_MOTOR | SmartFan:ZHOURI_XH-2PA_P2.50mm_Y | C5258883 | XH-2PA | ZHOURI | 直流电机接口 XH-2PA P2.50; 1.0mm孔为设计选取非厂家推荐; 针0.6+/-0.02mm
33 | Q1 | 1 | 2N3904-TA(RANGE:200-300) | SmartFan:TO-92_EBC_Wide_P2.54mm_Y_LeadFormed | C2081 | 2N3904-TA(RANGE:200-300) | JSCJ | NPN蜂鸣器驱动; 1=E 2=B 3=C; 宽脚成形P2.54mm非原厂直脚间距; 安装前核成形与方向
34 | Q_PWR | 1 | AO4409_REVERSE_POLARITY | Package_SO:SOIC-8_3.9x4.9mm_P1.27mm |  | AO4409 | Alpha & Omega Semiconductor | P-MOS反接保护: D=熔断后输入 S=5V负载 G=GND; 不隔离反向供电; 库存未核
35 | R1 | 1 | 1k | Resistor_SMD:R_0805_2012Metric | C17513 | 0805W8F1001T5E | UNI-ROYAL | 5V LED 限流电阻
36 | R10 | 1 | 1k | Resistor_SMD:R_0805_2012Metric | C17513 | 0805W8F1001T5E | UNI-ROYAL | 蜂鸣器基极限流电阻
37 | R2 | 1 | 1k | Resistor_SMD:R_0805_2012Metric | C17513 | 0805W8F1001T5E | UNI-ROYAL | 3.3V LED 限流电阻
38 | R_DHT | 1 | 4.7k | Resistor_SMD:R_0805_2012Metric | C17673 | 0805W8F4701T5E | UNI-ROYAL | DHT11 单总线上拉电阻
39 | R_SCL | 1 | 4.7k | Resistor_SMD:R_0805_2012Metric | C17673 | 0805W8F4701T5E | UNI-ROYAL | I2C1 SCL 上拉电阻
40 | R_SDA | 1 | 4.7k | Resistor_SMD:R_0805_2012Metric | C17673 | 0805W8F4701T5E | UNI-ROYAL | I2C1 SDA 上拉电阻
41 | R_STBY | 1 | 10k | Resistor_SMD:R_0805_2012Metric | C17414 | 0805W8F1002T5E | UNI-ROYAL | TB6612 STBY下拉电阻
42 | SERVO1 | 1 | MG90S_SERVO | Connector_PinHeader_2.54mm:PinHeader_1x03_P2.54mm_Vertical | C2718487 | 2.54-1*3P弯针 | BOOMELE | MG90S 舵机插针 (GND, 5V, PWM)
43 | SPK1 | 1 | SPEAKER | SmartFan:ZHOURI_XH-2PA_P2.50mm_Y | C5258883 | XH-2PA | ZHOURI | 喇叭接口 XH-2PA P2.50; 1.0mm孔为设计选取非厂家推荐; 针0.6+/-0.02mm
44 | U3 | 1 | AMS1117-3.3 | SmartFan:SOT-223-3_TabPin2_R90 | C6186 | AMS1117-3.3 | Advanced Monolithic Systems | 3.3V 稳压芯片 (1A)

Sheet: 元件测试记录
位号/器件 | 标称/型号 | 测试点 | 判据 | 实测值 | 结论 | 测试人/日期
R1/R2/R10 | 1kΩ | 电阻两端 | ±1%
R_DHT/R_SCL/R_SDA | 4.7kΩ | 电阻两端 | ±1%
R_STBY | 10kΩ | 电阻两端 | ±1%
C2/C4-C8 | 100nF | 电容两端 | 10-200nF
C1 | 100µF/25V | 正负极 | -20%/+20%，无鼓包
C3/C_VM | 220µF/16V | 正负极 | -20%/+20%，无鼓包
D1/D2 | LED | A-K | 正向1.8-3.2V
D3 | 1N4148W | A-K | 正向0.55-0.75V，反向不通
Q1 | 2N3904 | B-E/B-C | hFE 200-300
Q_PWR | AO4409 | D-S/G-S | 无短路，VGS=-5V时导通
U3 | TLV1117LV33 | VIN=5V空载 | VOUT=3.3±0.1V
BZ1 | TMB12A05 | 两端加5V | 响，电流<40mA
F1 | 0451003.MRL | 两端 | 通（<1Ω）
OLED | 0.96寸 | I2C扫描 | 地址0x3C应答
PAJ7620 | — | I2C扫描 | 地址0x73应答，挥手有INT
DHT11 | — | 单总线 | 温度0-50℃、湿度20-90%RH
ASR-PRO | — | UART 115200 | 回传命令字，播报不破音
MG90S | — | PWM 1500µs | 停转；1300/1700µs正反转
130电机 | — | 5V空载 | 起转，电流<0.3A

Sheet: 功能测试记录
编号 | 测试项 | 测试方法 | 判据 | 实测/现象 | 结论 | 备注
F01 | 电源电压 | 5V输入，万用表测5V/3.3V | 4.9-5.1V / 3.25-3.35V
F02 | 纹波 | 示波器20MHz带宽测5V | <100mVpp
F03 | 按键启停 | 按KEY1 | 开/关机，短鸣
F04 | 编码器调速 | 右旋10格 | 0→100%，每格10%
F05 | 手动模式保持 | 切手动后等待2min | 档位不被温控改变
F06 | 自动调速 | 加热/降温跨5个区间 | 按24/26/28/30℃切换档位
F07 | 摇头开关 | KEY2短按/手势左右 | 开/关，有短鸣
F08 | 摇头档位 | 语音“摇头快一点”5次 | 档位1-5循环
F09 | OLED显示 | 观察一屏内容 | 温度/湿度/模式/档位/摇头齐全
F10 | 待机熄屏 | 待机10s | 熄屏；任意操作点亮
F11 | 手势识别 | 每种手势20次 | 识别率≥90%，200ms不重复
F12 | 语音识别 | 1m，每条命令20次 | 识别率≥90%
F13 | 语音响应 | 秒表/示波器测唤醒到动作 | ≤1s
F14 | 点阵表情 | 观察8种表情 | 切换正常，无花屏
F15 | 连续运行 | 通电1h | 不死机、不复位
F16 | 温升 | 红外/热电偶测LDO、TB6612 | 无过热（<80℃）
