Lucian-ming/smart-fans/artifacts/report_pack/figs/fig05_case_parts.png

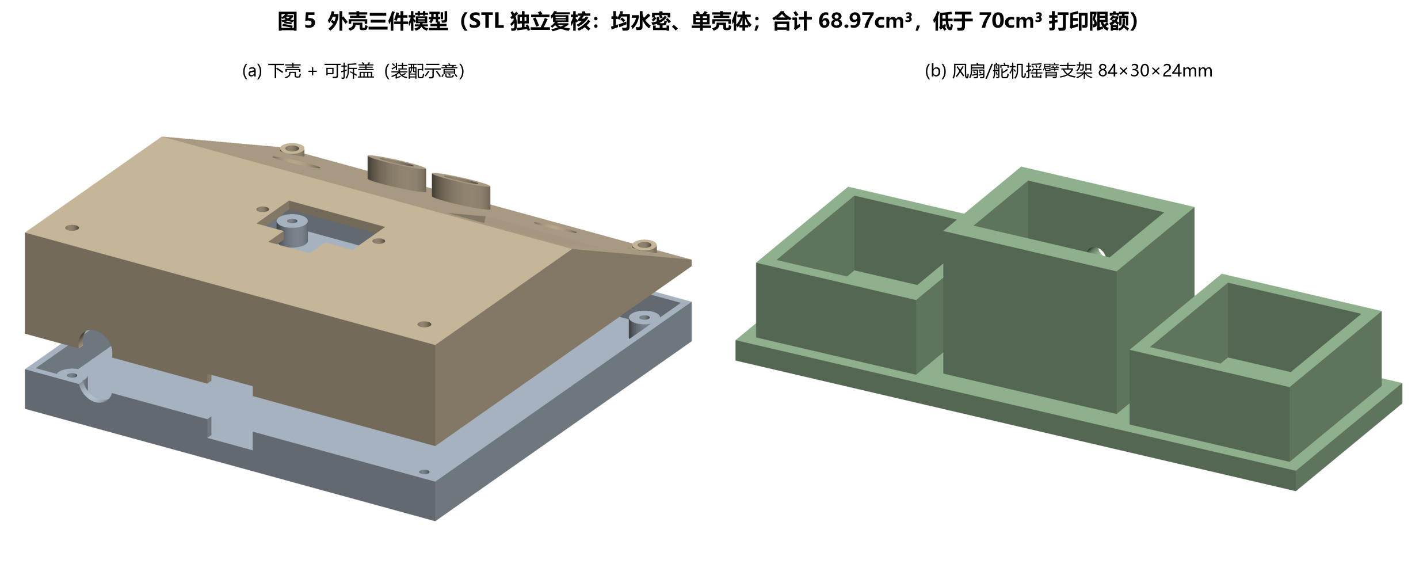
artifacts/report_pack/figs/fig05_case_parts.png
