Lucian-ming/smart-fans/mechanical/concept_20261109/Lid_CONCEPT.stl

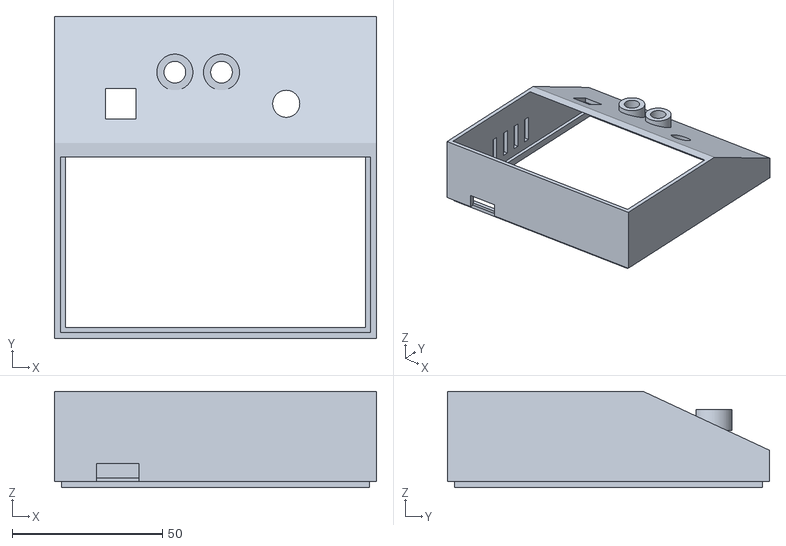
[picture p58: CAD file, 2026-11-11]
mechanical/concept_20261109/Lid_CONCEPT.stl
107.0 x 107.0 x 32.0
