Lucian-ming/smart-fans/mechanical/stl/print/SmartFan_Piece2_Fan_Gimbal_Bracket.stl

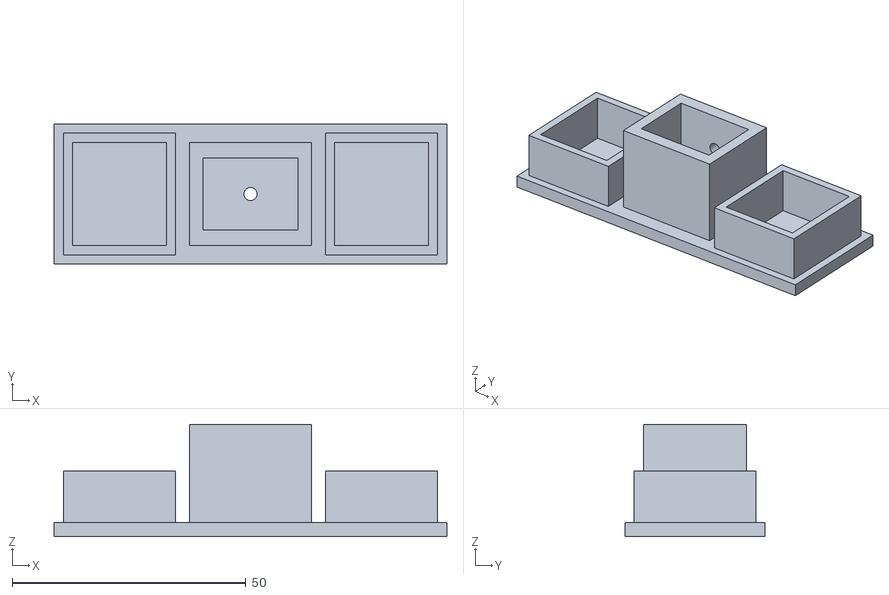
[picture p59: CAD file, 2026-11-11]
mechanical/stl/print/SmartFan_Piece2_Fan_Gimbal_Bracket.stl
84.0 x 30.0 x 24.0
