Lucian-ming/smart-fans/mechanical/stl/reference/底座.STL

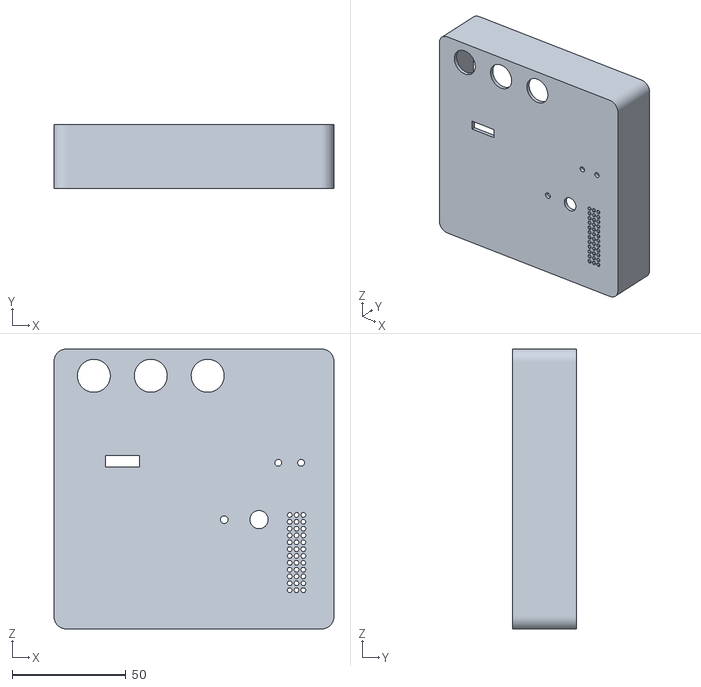
[picture p60: CAD file, 2026-11-11]
mechanical/stl/reference/底座.STL
123.0 x 28.0 x 123.0
