Lucian-ming/smart-fans/tools/B3/SmartFan_Piece2_Fan_Gimbal_Bracket.stl

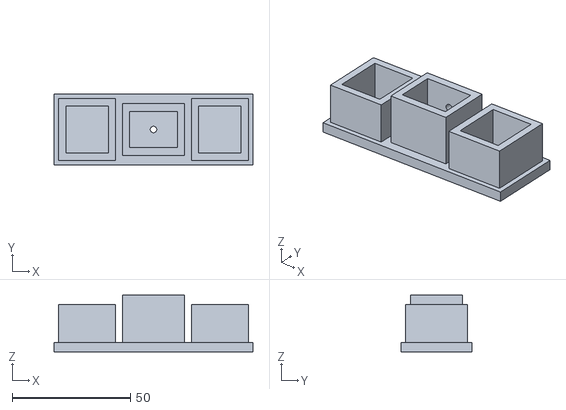
[picture p61: CAD file, 2026-11-11]
tools/B3/SmartFan_Piece2_Fan_Gimbal_Bracket.stl
84.0 x 30.0 x 24.0
