Lucian-ming/smart-fans/mechanical/concept_20261109/Base_CONCEPT.stl

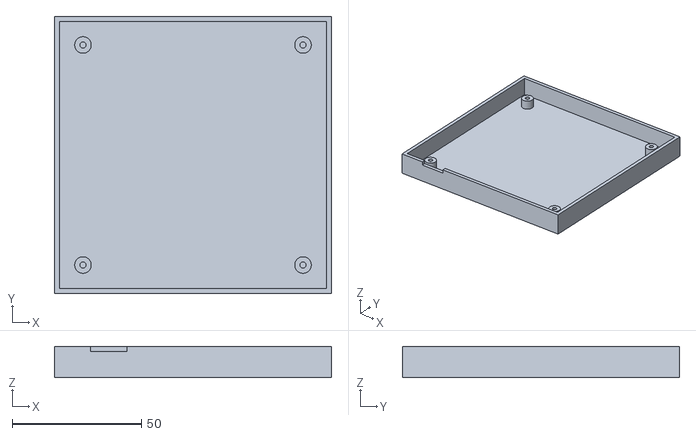
[picture p62: CAD file, 2026-11-11]
mechanical/concept_20261109/Base_CONCEPT.stl
107.0 x 107.0 x 12.0
