Lucian-ming/smart-fans/mechanical/stl/print/SmartFan_Piece3_Removable_Lid.stl

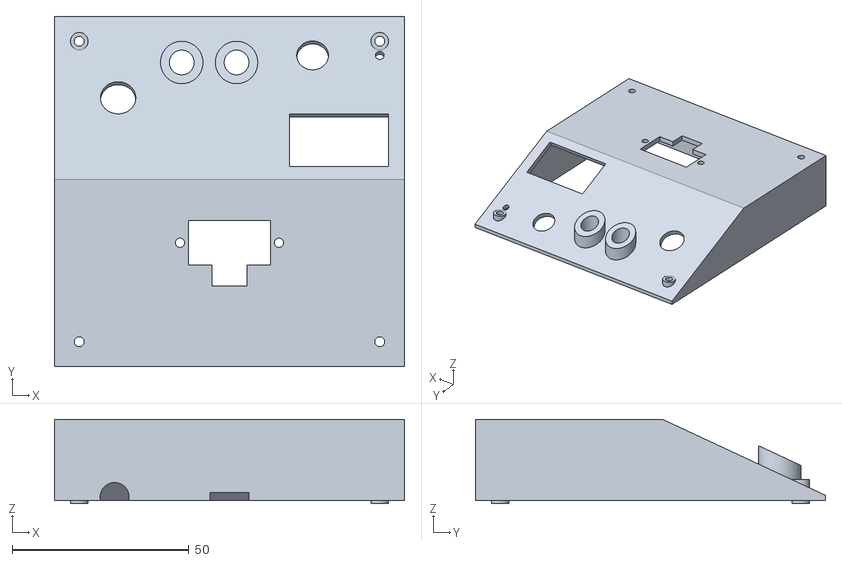
[picture p63: CAD file, 2026-11-11]
mechanical/stl/print/SmartFan_Piece3_Removable_Lid.stl
99.0 x 99.0 x 23.9
