Lucian-ming/smart-fans/mechanical/stl/reference/射灯支架.STL

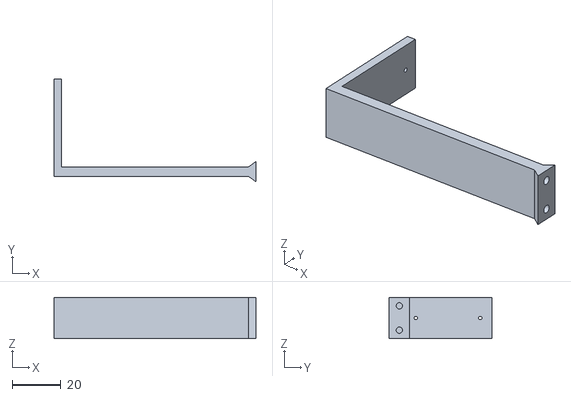
[picture p64: CAD file, 2026-11-11]
mechanical/stl/reference/射灯支架.STL
83.0 x 42.2 x 17.0
