Lucian-ming/smart-fans/tools/B3/SmartFan_Piece1_Base_Enclosure.stl

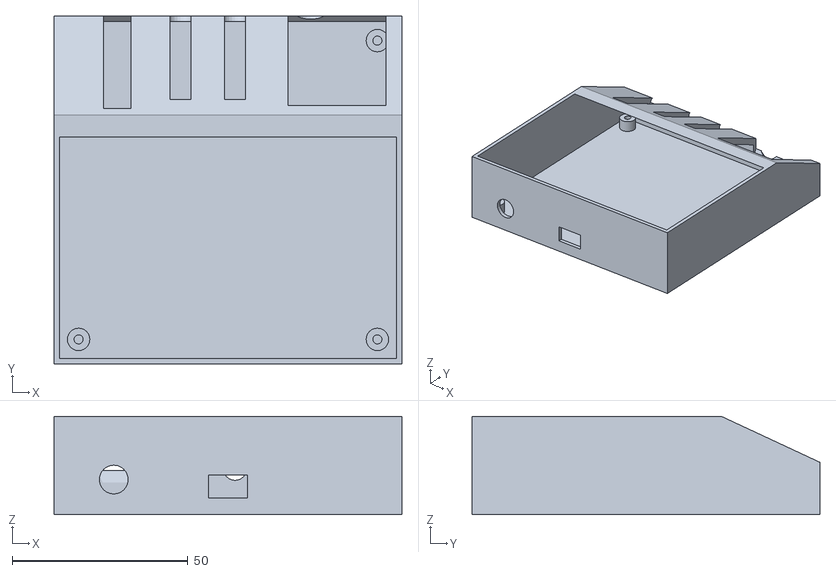
[picture p65: CAD file, 2026-11-11]
tools/B3/SmartFan_Piece1_Base_Enclosure.stl
99.0 x 99.0 x 28.0
