Lucian-ming/smart-fans/mechanical/stl/print/SmartFan_Piece1_Base_Enclosure.stl

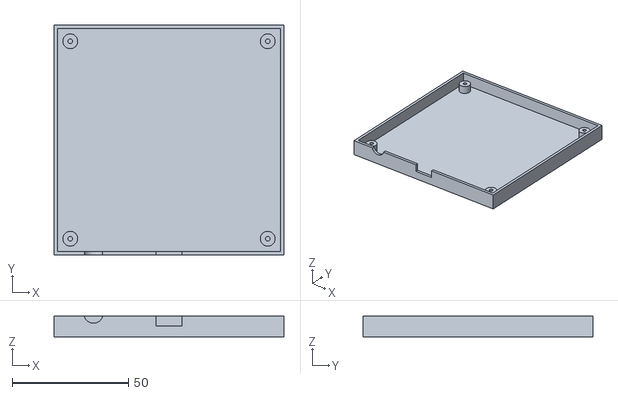
[picture p66: CAD file, 2026-11-11]
mechanical/stl/print/SmartFan_Piece1_Base_Enclosure.stl
99.0 x 99.0 x 9.00
