Lucian-ming/smart-fans/mechanical/stl/reference/箱盖.STL

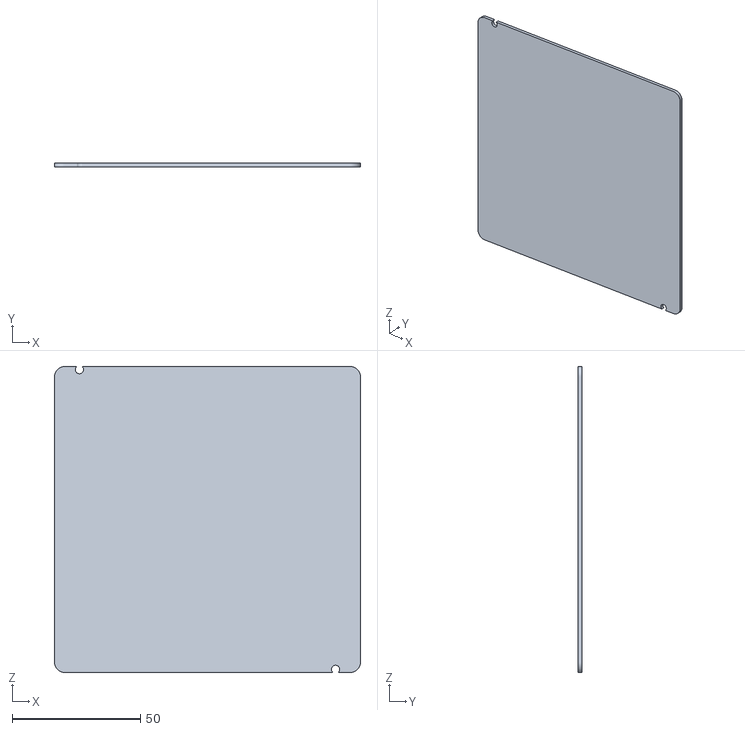
[picture p67: CAD file, 2026-11-11]
mechanical/stl/reference/箱盖.STL
119.5 x 1.50 x 119.5
