Lucian-ming/smart-fans/archive/outdated_revA_backup/Part1_Base_Assembly_Kit_100mm.stl

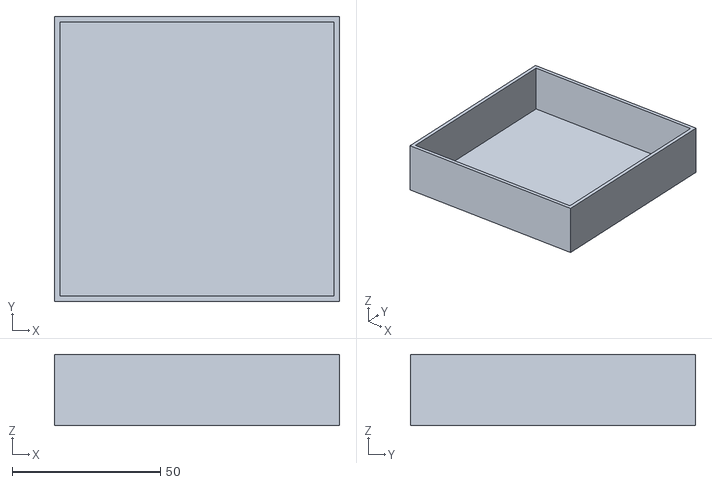
[picture p68: CAD file, 2026-11-11, an earlier design]
archive/outdated_revA_backup/Part1_Base_Assembly_Kit_100mm.stl
96.0 x 96.0 x 24.0
