Lucian-ming/smart-fans/archive/outdated_revA_backup/P01C_Top_Servo_Cover.stl

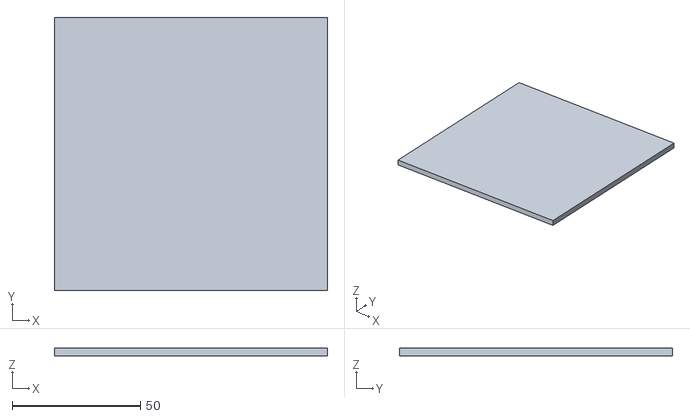
[picture p69: CAD file, 2026-11-11, an earlier design]
archive/outdated_revA_backup/P01C_Top_Servo_Cover.stl
106.4 x 106.4 x 3.00
