Lucian-ming/smart-fans/archive/outdated_revA_backup/P02_Servo_Pivot_Arm.stl

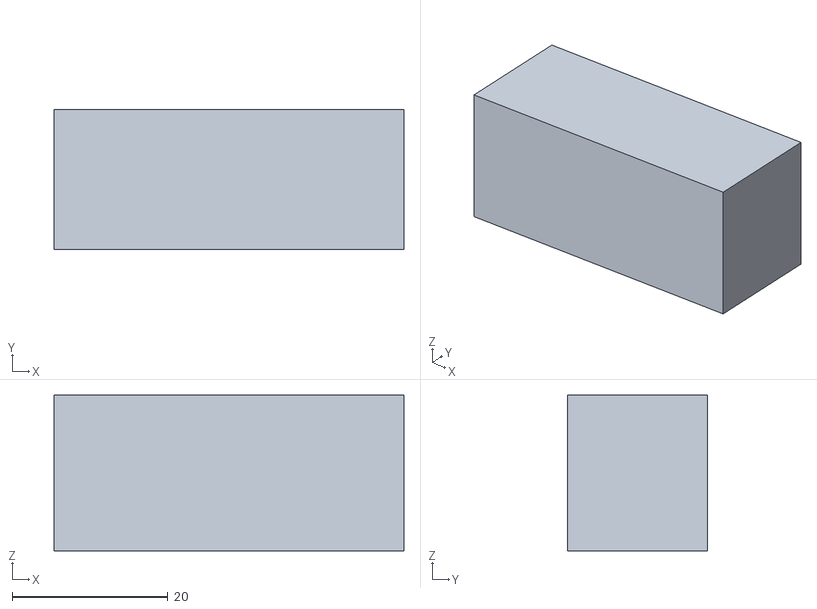
[picture p70: CAD file, 2026-11-11, an earlier design]
archive/outdated_revA_backup/P02_Servo_Pivot_Arm.stl
45.0 x 18.0 x 20.0
