Lucian-ming/smart-fans/(list of files, cad)

Other CAD files:
archive/outdated_revA_backup/P01A_Base_Bottom_Chassis.stl
archive/outdated_revA_backup/P01B_Front_Control_Panel.stl
archive/outdated_revA_backup/P01_Base_Enclosure.stl
archive/outdated_revA_backup/P03_Fan_Bracket_12025.stl
archive/outdated_revA_backup/P04_Bottom_Plate.stl
archive/outdated_revA_backup/Part2_Fan_Gimbal_Kit_100mm.stl
archive/outdated_revA_backup/SmartFan_Piece1_Base_Enclosure.stl
archive/outdated_revA_backup/SmartFan_Piece2_Fan_Gimbal_Bracket.stl
