Lucian-ming/smart-fans/artifacts/Order_SO2611058255_Soldering_Map.md

# 实购订单 SO2611058255：PCB焊接位号对照

日期：2026-11-09。依据[用户订单](<D:/下载/立创商城订单详情-SO2611058255.xls>)，只读转换后读取24项商品。适用[已交付TI版PCB](<D:/下载/RevB_5V_TI_NATIVE_20261104_202141/fan_ctrl_revB.kicad_pcb>)。**这是订单对应关系，不是所有国产替代件都已验证可直接替换的放行单。** 不要按旧BOM采购号判断袋内器件。数量为每块板用量，不是订单总数量。

## 焊接对照表

“待核”器件先分装到对应位号袋中，暂不焊接；特别是U3、电源MOS和端子。

|订单序号|实购物料编号|实际器件|对应PCB丝印位号|每板用量|说明|
|---|---|---|---|---:|---|
|1|C347462|UMW AO4409，SOP-8|Q_PWR|1|待核：不是原AOS；需确认S1/2/3、G4、D5/6/7/8及封装。1脚方向不能反|
|2|C17414|0805W8F1002T5E，10kΩ|R_STBY|1|0805，无极性；不是1k电阻|
|3|C49257|BOOMELE 1×3直公针，2.54mm|SERVO1|1|长针朝上，非母座；1=GND，2=5V，3=PWM|
|4|C41417332|hanxia HX PM2.54-1x20P ZC母座|J_MCU_L、J_MCU_R|2|插孔朝上；先用核心板校正两排平行再焊，核心板断电|
|5|C42431859|JXTCONN PM2.54-1Z03P-H85，3P母座|J_DHT11、J_KEY1、J_KEY2、J_ENC下排3孔|4|前三各1个，编码器下排1个；不是把3P塞入上排2孔|
|6|C2081|2N3904-TA(RANGE:200-300)|Q1|1|1=E，2=B，3=C；按原厂针序、PCB焊盘号核对。宽脚布局可能需成形，不能只看半圆轮廓|
|7|C5258883|ZHOURI XH-2PA，2.50mm|MOTO1、SPK1|2|板端插座，非电机/喇叭本体；先干插检查塑壳与邻件间隙|
|8|C54876667|SHOUHAN PZ2.54-1x2PZZ-L11.5，2P直公针|JP_USB、JP_ASR、JP_ASR_TX、JP_ASR_RX|4|长针朝上；还需4个跳帽，订单未见|
|9|C2293|KENTO KT-0805B，蓝色LED|D5|1|2=A接3.3V，1=K经R2到地；有极性|
|10|C17673|0805W8F4701T5E，4.7kΩ|R_DHT、R_SCL、R_SDA|3|0805，无极性|
|11|C5137488|FOJAN FCC0805X106K250FT，10µF/25V|C5、C6|2|待核：国产替代；0805无极性，但有效电容/DC偏压不能沿用三星曲线。与U3稳定性一起核|
|12|C476766|TORCH C0805B104K500NT，100nF/50V|C2、C4、C7、C_VM_MLCC|4|0805无极性；焊前核包装值104=100nF，不是106|
|13|C17513|0805W8F1001T5E，1kΩ|R1、R2、R10|3|0805，无极性|
|14|C27438|BOOMELE 1×8母座环保|J_TB_L、J_TB_R、J_VOICE_L、J_VOICE_R|4|插孔朝上；J_VOICE就是此8P母座，不是语音芯片|
|15|C96093|华能TMB12A05，5V有源蜂鸣器|BZ1|1|1=+5V，2=驱动负端；按“+”标记；先干插核脚距|
|16|C81598|ST先科1N4148W，SOD-123|D3|1|1=K阴极接5V，2=A阳极接BUZ_DRV；核阴极条纹，不能反|
|17|C2833300|KNSCHA 01EC1801，220µF/16V，D6.3×11|C3、C_VM|2|待核脚距、纹波/ESR；1=正极5V，2=负极GND；外壳负极条纹朝2脚|
|18|C50950|BOOMELE 1×5母座|J_GESTURE|1|插孔朝上；不是给EC11的连续5P座|
|19|C2292|KENTO KT-0805YG，黄绿LED|D4|1|2=A接5V，1=K经R1到地；有极性|
|20|C2994709|JDTfuse JFC2410-1300FS，3A快断2410|F1|1|待核封装焊端、分断能力与I²t；无极性，不得短接代替|
|21|C3018698|DORABO DB127V-5.08-2P-GN-S|DC1|1|待核：不是Phoenix1729128。相同5.08间距不保证针径/壳体匹配；当前PCB孔径1.3mm。不得强插、钻大成品镀铜孔|
|22|C134665|Lelon RZW101M1EBK-0611，100µF/25V|C1|1|1=正极5V，2=负极GND；注意与220µF分开|
|23|C52146079|TECH PUBLIC TPTLV1117LV33DCYR，SOT-223-3|U3|1|**暂勿焊接**：不是TI TLV1117LV33DCYR。必须重新确认1=GND、2及tab=OUT3.3V、3=IN5V、陶瓷输出电容稳定性及最低负载，不能以名字相似认定等效|
|24|C2718488|BOOMELE 1×4母座|J_OLED|1|插孔朝上；模块针序1GND、2VCC、3SCL、4SDA；安装方向按实物与焊盘编号核对|

## 订单缺少的装配件

- J_ENC上排两孔：**1个2P母座/板**，原建议JXTCONN PM2.54-1Z02P-H85 / C42431848，塑高8.5mm。该订单未见。不能把多余3P母座硬塞到2孔位置；不要未确认空间就切削母座。
- 四个JP各需一个**2.54mm跳帽**，共4个/板，原建议C100114。该订单未见。跳帽是套在针上的可拔件，不焊死。
- H1～H4是安装孔，不焊器件。功能模块、电机、舵机、扬声器和线端配套也不能由上表连接器替代。

## 焊接与检查顺序

1. 先按商品编号将料袋分组，区分1k/4.7k/10k、100nF/10µF、100µF/220µF。
2. 可先焊已核规格的低矮电阻及100nF电容，再焊LED/二极管。每种焊一只先检查。
3. 暂留U3、Q_PWR、F1、DC1及待核电容位，完成替代件审核再装。不要为了“焊满板子”先装未知电源芯片。
4. 连接器、蜂鸣器、电解等高件最后装；所有直插件先干插，核间距、孔径和壳体干涉。插拔模块必须断电。
5. 有极性器件按PCB焊盘号和器件手册确认，不凭屏幕图片左右或方焊盘猜正负。
6. 上电前检查焊桥和5V/3.3V对地电阻，先不装电机、舵机、ASR和其他模块。仅允许稳压5V输入，不能12V。没有万用表及合适保护电源时不要直接试上电。

## 来源与审核边界

订单已读出24个商品编号，但旧XLS打印分页会截断部分长型号；完整型号用商品编号检索补齐，不猜测被截断后缀。

- [UMW AO4409/C347462商品页](https://item.szlcsc.com/324122.html)：P沟道、SOP-8、列有4.5V栅压导通参数；不能替代完整引脚及机械审核。
- [DB127V端子/C3018698](https://item.szlcsc.com/3531576.html)
- [JFC2410保险丝/C2994709](https://item.szlcsc.com/3461406.html)
- [FOJAN 10µF/C5137488](https://item.szlcsc.com/5746990.html)
- [台舟LDO/C52146079](https://jlcpcb.com/partdetail/TPTLV1117LV33DCYR/C52146079)

替换品牌没有天然问题，但原TI稳定性证据、三星DC偏压曲线、AOS原厂参数及Phoenix尺寸**不能移植为新品牌验证结论**。本文件未修改PCB或旧BOM，未将待核器件标为电气合格。
