Lucian-ming/smart-fans/docs/hardware/breadboard_wiring_guide.md

# 桌面智能风扇原型机 —— 面包板逐模块接线指南 (Rev B4)

> **硬件基准**：STM32F103C8T6 最小系统核心板（BluePill）+ `fan_ctrl_revB` PCB 实际网络依据（`native_pin_nets.json`）  
> **固件状态**：全功能操作固件已就绪（包含 25kHz 超声频电机调速、360° 连续舵机调速、I2C 共享总线、ASR-PRO 语音交互、EC11 硬件正交编码器、消抖双按键、DHT11 温湿度、PAJ7620 手势识别与串口 CLI）  
> **文档用途**：指导在标准双轨面包板上进行实物原型搭建、连线自检与逐模块功能验证。

---

## 一、 面包板电源与接地总线规划（至关重要）

动力执行器件（130 直流电机、MG90S 舵机）以及 ASR-PRO 语音功放在运行瞬间会产生 **0.5A ~ 1.5A** 的瞬态峰值电流。  
> [!CAUTION]
> **绝对禁止从单片机 3.3V 引脚为电机或舵机供电！**  
> 必须准备一组外接独立 **5V 稳压电源（额定输出建议 ≥ 2A）**，并在面包板上实施“动力/逻辑分轨、全系统共地”布线：

```
                              【面包板双电源轨拓扑图】

  外部 5V 稳压电源 (≥2A) ──┬──> 面包板红色电源轨 (+5V 动力轨) ──> TB6612 (VM)
                           │                                   ──> MG90S 舵机 (红色线 5V)
                           │                                   ──> ASR-PRO 语音板 (5V)
                           │                                   ──> 有源蜂鸣器 (VCC 5V)
                           │
                           └──> STM32 核心板 5V 引脚 (供给核心板板载 3.3V LDO)
                                    │
                                    └──> STM32 3.3V 引脚 ──> 面包板黄色逻辑轨 (+3.3V)
                                                                 ──> 0.96" OLED (VCC)
                                                                 ──> PAJ7620 手势 (VCC，严禁接5V)
                                                                 ──> DHT11 传感器 (VCC)
                                                                 ──> EC11 编码器 (VCC)
                                                                 ──> TB6612 逻辑端 (VCC)

  系统公共地 (GND) ────────┴──> 面包板蓝色接地轨 (GND 总线) ───> 所有模块 GND 必须牢固连通共地！
```

---

## 二、 完整逐模块接线大表

| 模块名称 | 模块端物理引脚 / 丝印 | STM32 核心板引脚 / 电源轨 | 工作电平与特性 | 硬件网络依据 | 功能定义与接线说明 |
| :--- | :--- | :--- | :--- | :--- | :--- |
| **STM32 核心板**<br>(BluePill) | **5V** | 外部 5V 稳压电源 | 5V 稳压输入 | `J_MCU_L.3` (+5V_MCU) | 主板供电输入 |
| | **3.3V (3V3)** | 面包板 3.3V 逻辑轨 | 3.3V 稳压输出 | `J_MCU_R.18` (+3.3V) | 供各低功耗传感器与逻辑电平 |
| | **GND** | 面包板公共接地轨 | 0V | `J_MCU_L.2`, `J_MCU_R.19/20` | 所有地线必须连通 |
| **TB6612FNG 电机驱动** | **VM** | **外部 5V 动力轨** | 5V (大电流) | `J_TB_R.1` (+5V) | 电机功率主电源，**严禁接 3.3V** |
| | **VCC** | **面包板 3.3V 逻辑轨** | 3.3V 逻辑电平 | `J_TB_R.2` (+3.3V) | 与 STM32 3.3V 逻辑严格匹配 |
| | **GND** | **面包板公共接地轨** | 0V | `J_TB_L.5~8`, `J_TB_R.3` | 控制地与功率地共地 |
| | **PWMA** | 单片机 **PA0** | TIM2_CH1 (25kHz) | `J_TB_L.1` (TB_PWMA) | 风扇转速 PWM 调速 (超声频静音) |
| | **AIN1** | 单片机 **PA1** | GPIO 推挽输出 | `J_TB_L.3` (TB_AIN1) | 转向控制（正转=1） |
| | **AIN2** | 单片机 **PA5** | GPIO 推挽输出 | `J_TB_L.2` (TB_AIN2) | 转向控制（正转=0） |
| | **STBY** | 单片机 **PB0** | GPIO 推挽输出 | `J_TB_L.4` (TB_STBY) | 1=工作，0=待机高阻 (上电低电平保护) |
| | **AO1** | 130 直流电机 引线 1 | H 桥可逆功率输出 | `MOTO1.1` | 若旋转出风方向反了，对调两根线即可 |
| | **AO2** | 130 直流电机 引线 2 | H 桥可逆功率输出 | `MOTO1.2` | |
| | *BIN1/BIN2/PWMB*| **悬空不接** (NC) | B 通道留空 | - | 原型机仅使用 A 通道驱动风扇 |
| **MG90S 360° 舵机**<br>(连续旋转摇头) | **棕色 / 黑色线** | **面包板公共接地轨** | 0V | `SERVO1.1` (GND) | 舵机接地线 |
| | **红色线** | **外部 5V 动力轨** | 5V 动力电源 | `SERVO1.2` (+5V) | **严禁接 3.3V**，瞬态电流达 1A |
| | **橙色 / 黄色线** | 单片机 **PB8** | TIM4_CH3 (50Hz) | `SERVO1.3` (SERVO_PWM) | 停转时完全切断脉冲消除微蠕动 |
| **0.96" I2C OLED**<br>(SSD1306, 0x3C) | **GND** | **面包板公共接地轨** | 0V | `J_OLED.1` (GND) | 屏幕地线 |
| | **VCC** | **面包板 3.3V 逻辑轨** | 3.3V 供电 | `J_OLED.2` (+3.3V) | 推荐接入 3.3V |
| | **SCL (SCK)** | 单片机 **PB6** | I2C1 时钟线 | `J_OLED.3` (I2C1_SCL) | 与手势模块共用 PB6 |
| | **SDA** | 单片机 **PB7** | I2C1 数据线 | `J_OLED.4` (I2C1_SDA) | 与手势模块共用 PB7 |
| **PAJ7620U2 手势模块**<br>(9手势识别, 0x73) | **VCC** | **面包板 3.3V 逻辑轨** | 2.8V~3.3V 供电 | `J_GESTURE.1` (+3.3V) | **严禁接 5V**（芯片额定 3.3V） |
| | **GND** | **面包板公共接地轨** | 0V | `J_GESTURE.2` (GND) | 模块地线 |
| | **SCL** | 单片机 **PB6** | I2C1 时钟线 | `J_GESTURE.3` (I2C1_SCL) | 与 OLED 共用 PB6 |
| | **SDA** | 单片机 **PB7** | I2C1 数据线 | `J_GESTURE.4` (I2C1_SDA) | 与 OLED 共用 PB7 |
| | **INT** | 单片机 **PA4** | EXTI4 下降沿中断 | `J_GESTURE.5` (GEST_INT) | 手势唤醒中断引脚 |
| **DHT11 温湿度模块** | **VCC (+)** | **面包板 3.3V 逻辑轨** | 3.3V 供电 | `J_DHT11.1` (+3.3V) | 供电引脚 |
| | **DATA (OUT/S)**| 单片机 **PB9** | 单总线通信 | `J_DHT11.2` (DHT11_DATA) | 2秒周期采样 |
| | **GND (-)** | **面包板公共接地轨** | 0V | `J_DHT11.3` (GND) | 模块地线 |
| **EC11 旋转编码器模块**<br>(5脚规格: VCC, GND, A, B, C) | **A相 (CLK 或 A)** | 单片机 **PA6** | TIM3_CH1 编码器接口 | `J_ENC.3` (ENC_A) | 顺时针/逆时针步进调速 |
| | **B相 (DT 或 B)** | 单片机 **PA7** | TIM3_CH2 编码器接口 | `J_ENC.5` (ENC_B) | 正交解码 |
| | **C端 (或 SW / 按键)** | 单片机 **PB12** | GPIO 上拉输入 | `J_MCU_L.20` (PB12) | **旋钮下按按键：专职模式切换 (MANUAL <-> AUTO_TEMP)** |
| | **VCC (+)** | 面包板 3.3V 逻辑轨 | 3.3V | `J_ENC.1` (+3.3V) | 模块上拉供电 |
| | **GND (-)** | 面包板公共接地轨 | 0V | `J_ENC.2` (GND) | 模块地线 |
| **独立按键 KEY1**<br>(电源开关) | **引脚 1** | 单片机 **PB13** | GPIO 上拉输入 | `J_MCU_L.19` (KEY1_SIG) | **专职风扇电源开关 (ON <-> OFF)，按下瞬发无需双击** |
| | **引脚 2** | **面包板公共接地轨** | 0V | `J_KEY1.1` (GND) | 按下时拉低 |
| **独立按键 KEY2**<br>(摇头开关) | **引脚 1** | 单片机 **PB14** | GPIO 上拉输入 | `J_MCU_L.18` (KEY2_SIG) | **专职摇摆头开关 (SWING ON <-> OFF)，按下瞬发无需双击** |
| | **引脚 2** | **面包板公共接地轨** | 0V | `J_KEY2.1` (GND) | 按下时拉低 |
| **有源蜂鸣器模块** | **I/O (SIG/S)** | 单片机 **PB15** | GPIO 推挽输出 | `R10.1` -> `Q1` 基极 | 高电平发声，低电平静音 |
| | **VCC (+)** | **面包板 5V 或 3.3V** | 视蜂鸣器额定电压 | `BZ1.1` (+5V) | 工作电源 |
| | **GND (-)** | **面包板公共接地轨** | 0V | `Q1.1` (GND) | 地线 |
| **ASR-PRO 语音模块** | **5V (VCC)** | **外部 5V 动力轨** | 5V 供电 (>500mA) | `J_VOICE_L.2` (+5V_ASR) | **严禁接 3.3V**，功放峰值大 |
| | **GND** | **面包板公共接地轨** | 0V | `J_VOICE_L.1` (GND) | 模块地线 |
| | **TX (TX1)** | 单片机 **PA3** | USART2_RX | `JP_ASR_RX.2` -> `PA3` | 波特率 115200 8N1 |
| | **RX (RX1)** | 单片机 **PA2** | USART2_TX | `JP_ASR_TX.2` -> `PA2` | 单片机回传 ACK (`Fyes`/`Foff`) |
| | **SPK+ / SPK-** | 8Ω 1W~2W 喇叭两极 | 功放音频输出 | `VOICE_SPK_P / N` | 直连扬声器 |
| **USB-TTL 调试串口**<br>(CLI 控制台与日志) | **TXD** | 单片机 **PA10** (USART1_RX) | 串口接收 | `J_MCU_L.14` | PC 端发送测试调试指令 |
| | **RXD** | 单片机 **PA9** (USART1_TX) | 串口发送 | `J_MCU_L.15` | PC 端监控开机初始化与状态 |
| | **GND** | **面包板公共接地轨** | 0V | 共地 | 保证信号电平基准一致 |
| **ST-Link V2 调试器**<br>(烧录与在线调试) | **3.3V (TVCC)** | 蓝板 SWD 排针 **3.3V** | 参考电压 | - | 烧录时提供电压参考 |
| | **SWDIO** | 蓝板 SWD 排针 **DIO (PA13)**| SWD 双向数据 | - | 核心保留引脚，固件已锁死不占用 |
| | **SWCLK** | 蓝板 SWD 排针 **CLK (PA14)**| SWD 时钟 | - | 核心保留引脚，固件已锁死不占用 |
| | **GND** | 蓝板 SWD 排针 **GND** | 调试地 | - | 调试器与系统共地 |

---

## 三、 实物极易踩坑的“针序避坑指南”

1. **DHT11 模块针序混淆**：
   - 市场上散件 DHT11 小板通常有 3 针，但不同厂家针序并不一致（常见有 `[S, +, -]` 与 `[+, S, -]` 两种）。
   - **接线前务必仔细看清小板正反面的印刷丝印**：
     - 标有 `+` 或 `VCC` 的引脚接 3.3V；
     - 标有 `-` 或 `GND` 的引脚接公共地；
     - 标有 `S`、`OUT` 或 `DAT` 的引脚接单片机 **PB9**。
2. **0.96 寸 OLED 显示屏针序**：
   - 常见 4 针 I2C OLED 有两种线序：
     - 版本 A：`GND, VDD, SCK, SDA`（最常见）
     - 版本 B：`VCC, GND, SCL, SDA`
   - **绝不能仅凭插针位置盲插，务必对准屏幕顶部的文字丝印**！插反 VCC 与 GND 会立即烧毁屏幕驱动 IC。
3. **MG90S 舵机三线颜色**：
   - 绝大多数舵机出厂线序为：**棕色/黑色（GND）、红色（5V 动力）、黄色/橙色（PWM 信号，接 PB8）**。
4. **EC11 旋转编码器 (带 VCC, GND, A, B, C)**：
   - 您的 5 脚模块丝印为 `VCC, GND, A, B, C` 时：
     - `A` 接 **PA6**，`B` 接 **PA7**；
     - `VCC` 接 3.3V，`GND` 接 GND；
     - **`C` 脚就是旋钮下按按键 (Click / SW)**，请使用一根杜邦线将 **`C` 接到 STM32 的 PB12**。按下旋钮即可在手动调速模式与自动温控模式之间即时切换。
5. **I2C 双从机共用总线**：
   - 0.96" OLED（从机地址 `0x3C`）与 PAJ7620 手势识别模块（从机地址 `0x73`）在物理上为并联结构。
   - 将 OLED 的 SCL 和 PAJ7620 的 SCL 插在面包板同一行，再引一根杜邦线连到 STM32 的 **PB6**。
   - 将两者的 SDA 插在面包板同一行，再引一根杜邦线连到 STM32 的 **PB7**。
   - 若模块本身未内置上拉电阻，建议在 SCL 和 SDA 线上分别接一颗 4.7kΩ 电阻上拉到 3.3V 逻辑轨。

---

## 四、 STM32F103C8T6 核心板引脚速查示意图

核心板直立插在面包板中央（Micro-USB 接口朝上/朝北）：

```
                  ┌─────────[ Micro-USB ]─────────┐
      (VBAT) [  ] │                               │ [  ] (PB12 - 严格留空悬空)
     (PC13)  [  ] │                               │ [  ] (PB13) ──> KEY1 独立按键 1
             [  ] │                               │ [  ] (PB14) ──> KEY2 独立按键 2
             [  ] │                               │ [  ] (PB15) ──> BUZZER 蜂鸣器
     (PA0)   [  ] │                               │ [  ] (PA8)
  TB_PWMA ───┘    │                               │ [  ] (PA9)  ──> USB-TTL 串口 RXD
     (PA1)   [  ] │                               │ [  ] (PA10) ──> USB-TTL 串口 TXD
  TB_AIN1 ───┘    │                               │ [  ] (PA11)
     (PA2)   [  ] │                               │ [  ] (PA12)
 VOICE_TX ───┘    │                               │ [  ] (PA15)
     (PA3)   [  ] │                               │ [  ] (PB3)
 VOICE_RX ───┘    │                               │ [  ] (PB4)
     (PA4)   [  ] │                               │ [  ] (PB5)
 GEST_INT ───┘    │                               │ [  ] (PB6)  ──> I2C1_SCL (OLED & PAJ7620)
     (PA5)   [  ] │                               │ [  ] (PB7)  ──> I2C1_SDA (OLED & PAJ7620)
  TB_AIN2 ───┘    │                               │ [  ] (PB8)  ──> SERVO_PWM (MG90S 舵机)
     (PA6)   [  ] │                               │ [  ] (PB9)  ──> DHT11_DATA (温湿度)
    ENC_A ───┘    │                               │ [  ] (5V)   ──> 外部 5V 稳压电源输入
     (PA7)   [  ] │                               │ [  ] (GND)  ──> 面包板公共地
    ENC_B ───┘    │                               │ [  ] (3V3)  ──> 面包板 3.3V 逻辑轨
     (PB0)   [  ] │                               │
  TB_STBY ───┘    │  (NRST)  (3V3)  (GND)  (GND)  │
                  └────[ ]────[ ]────[ ]────[ ]───┘
```

---

## 五、 接线完成后的上电自检流程

1. **万用表通断与阻抗档核验（未通电时）**：
   - 测量面包板 +5V 动力轨与 GND 之间，确认无蜂鸣短路现象。
   - 测量面包板 +3.3V 逻辑轨与 GND 之间，确认无短路现象。
   - 测量 TB6612 的 VM 与 VCC 之间，确认两者未在面包板上发生短接。
2. **首次通电核验**：
   - 接入 5V 稳压电源，观察电源指示灯是否正常点亮，手触各模块芯片（STM32、TB6612、PAJ7620）表面，确认无异常发烫。
3. **通知开始烧录**：
   - 当确认物理线路连接牢固、各模块极性无误后，即可在对话中通知工程师执行固件烧录。
