Lucian-ming/smart-fans/hardware/fabrication/RevB_5V_Prototype_Notes.md

# RevB 单5V直插改版：打样范围与装配约束

状态：本版已完成整板生成及14项独立检查，作为少量裸板首轮打样资料交付，不构成完整模块装配或量产认证。旧12V版文件继续禁用，不得混用。

## 本次用户确认的数据
- 电源改为母板单5V输入，取消XL1509降压；不得输入12V。
- TB6612两排中心距按用户普通尺粗测15.00mm；左排从上到下PWMA/AIN2/AIN1/STBY/BIN1/BIN2/PWMB/GND；右排VM/VCC/GND/AO1/AO2/BO2/BO1/GND。
- 编码器上2针、下3针组距按用户粗测21.00mm；上排左VCC右GND，下排左A、中C（GND）、右B。模块不提供独立按压信号，PB12悬空。
- ASR开发板30×28mm，两排中心距25.40mm由用户确认；UART1与MCU连接，3V3输出不并联母板电源。
- 这些是用户实测/确认，不是厂商公差图。试装允许对排针轻微成形，但不能反插、错排或强压损伤焊点。

## 布局安装约定（不得当成已核实的模块尺寸）
- ASR两座中心Y44，30×28mm名义板体范围X63.5～93.5、Y30～58。
- OLED针排中心(78.5,26.5)，要求屏体向负Y；母板顶视从左到右SDA/SCL/VCC/GND，GND为pin1。实物需先按丝印核序，禁止凭屏幕正倒直接插装上电。实际针排到后板边须小于26.5mm减板边余量，到前板边须小于3.5mm减装配余量；这些是安装条件，不是厂家图已验证值。不满足则本版不适配，须改板或调整安装。
- ASR三跳帽位于X29，首针Y50.8/59/67.2，避免被编码器板体遮挡；独立6×8mm操作区按已知几何检查。未知模块实体高度与边界仍需试装。

## 上电与下载
- 输入端为5V接线端子，有保险丝与PMOS反接保护；2A为设计目标，未作温升、堵转电流或短路分断认证。
- MCU连接USB前断开JP_USB。仍应避免另一侧未供电时通过GPIO反向供电；优先在母板保持供电时调试，或将核心板拔下单独下载。
- ASR连接Type-C烧录前拔掉JP_ASR、JP_ASR_TX、JP_ASR_RX三只跳帽，隔离供电与UART。
- 喇叭为BTL差分输出；任一端都不得接GND。
- 电机额定电压与堵转电流仍未实测。首次上电先不接电机、舵机，以限流电源检查电源轨和信号，再逐路接入负载；不把几何DRC等同负载安全认证。
- 本次不改固件：编码器不提供SW，固件应停用该输入或维持确定的上拉状态；MG90S为连续旋转型号，旧位置舵机角度控制不能当作限角扫风验证，未实现限位/反馈前不要直接运行自动扫风。

## 验证边界
实际结果见[最终验收报告](<D:/smart_fans/hardware/fabrication/RevB_5V_Validation_Report.md>)，引脚数量和检查结论均取自本次新板。尚无KiCad原生ERC/DRC结果，独立几何与连通检查不能冒称原生检查。

此次交付优先PCB打样，不重发旧外壳作为匹配新布局的机械文件。OLED方向、模块板体与跳帽可达性应按本次最终布局说明试装；完整整机装配、打印件、MG90S连续旋转限角控制、固件功能均不在PCB制造检查的覆盖范围。
