Lucian-ming/smart-fans/mechanical/drawings/assembly_spec.md

# 智能风扇整机装配与 3D 打印加工规范 (Assembly & Fabrication Spec)

> 适用零件：  
> • `P01A_Base_Bottom_Chassis.stl` (底座下壳体)  
> • `P01B_Front_Control_Panel.stl` (前置倾斜控制面板)  
> • `P01C_Top_Servo_Cover.stl` (顶部舵机安装盖)  
> • `P02_Servo_Pivot_Arm.stl` (舵机摆头摇臂连杆)  
> • `P03_Fan_Bracket_12025.stl` (12025 机箱风扇安装支架)  
> • `P04_Bottom_Plate.stl` (底板检修盖 / 硅胶脚垫板)  
> • `P01_Base_Enclosure.stl` (整件单体版底座，备用)  
> 存放路径：`mechanical/stl/print/`  
> 加工渠道：**嘉立创三维猴 / 淘宝 3D 打印** 或 自备 3D 打印机 (Bambu Studio / Cura / PrusaSlicer)  
> 推荐材料：**白色/黑色 8000 高韧性光敏树脂** 或 **PETG / PLA+**

---

## 一、3D 打印拆件与切片参数表 (100% 单一流形实体，0 装配体告警)

所有 STL 模型均经过连续闭合流形 (Watertight 2-Manifold) 拓扑检查，**独立组件数 (Connected Components) 均为 1**，切片软件可直接平放排版切片，杜绝了多实体/装配体识别导致的拆分乱象：

| 零件编号 | 文件名 | 推荐材质 | 打印摆放方向 | 预估单重 | 功能与装配说明 |
| :--- | :--- | :--- | :---: | :---: | :--- |
| **P-01A** | `P01A_Base_Bottom_Chassis.stl` | 8000 树脂 / PETG | 底面朝下平放 | ~38 g | 底座下壳体，110×110×28mm，收纳 PCB、扬声器与走线，后置 DC 孔 |
| **P-01B** | `P01B_Front_Control_Panel.stl` | 8000 树脂 / PLA+ | 正面朝上平放 | ~14 g | 前置 25° 倾斜操作面板，含 OLED 视口、手势透镜孔、3 键孔 (8mm 间距)、EC11 孔与咪头孔 |
| **P-01C** | `P01C_Top_Servo_Cover.stl` | 8000 树脂 / PETG | 底面朝下平放 | ~16 g | 顶部封盖，集成 MG90S 舵机安装仓与舵机线过线槽 |
| **P-02**  | `P02_Servo_Pivot_Arm.stl` | 8000 树脂 / PETG | 侧卧平放 | ~10 g | 舵机旋转摇臂，下接 MG90S 舵盘，上连风扇俯仰铰链叉耳 |
| **P-03**  | `P03_Fan_Bracket_12025.stl` | 8000 树脂 / PETG | 大平面朝下平放 | ~20 g | 12025 机箱风扇安装骨架 (105×105mm 标准孔距，通风开孔) |
| **P-04**  | `P04_Bottom_Plate.stl` | 8000 树脂 / PLA  | 平放 | ~10 g | 底座密封底板，含 4 个 φ8.5mm 硅胶防滑脚垫定位沉槽 |
| **合计**  | **6 件分体套件** | — | — | **~108 g** | **三维猴计费约 36~42 元，严格锁定在 200 元预算红线内** |

---

## 二、整机模块化装配流程 (Step-by-Step Assembly)

```
[步骤 1: PCB 主板固定]
        │
        ▼ 焊接测试好的主板置入 P-01A 底座下壳，4 颗 M3×6 螺丝锁固在支撑柱上
[步骤 2: 前操作面板总成 P-01B 组装]
        │
        ▼ 0.96 OLED 卡入沉槽，PAJ7620 镜头对准手势圆孔，EC11 轴与按键穿出面板
[步骤 3: 侧边扬声器卡入]
        │
        ▼ 8Ω 2W 迷你腔体扬声器卡入底座侧导音槽，接线插于 SPK1
[步骤 4: 顶部舵机安装 P-01C 与摇臂 P-02]
        │
        ▼ MG90S 嵌入 P-01C 顶盖方仓，通过 2 颗 M2 自攻螺钉紧固；
        ▼ 单片机上电输出居中脉冲后，将 P-02 摇臂垂直压装于舵盘并锁螺丝
[步骤 5: 底座上中下合体]
        │
        ▼ 将 P-01B 前面板与 P-01C 顶盖合拢扣合在 P-01A 主壳体上
[步骤 6: 12025 机箱风扇固定至 P-03 支架]
        │
        ▼ 4 套 M3×30mm 长螺钉穿过风扇四角锁死在 P-03 支架上，风扇线顺立柱插入 FAN1
[步骤 7: 俯仰铰链锁紧]
        │
        ▼ 用 1 颗 M3×25mm 螺栓穿过 P-03 与 P-02 铰链叉耳，拧入防松螺母调节俯仰阻尼
[步骤 8: 封底板与防滑脚垫]
        │
        ▼ 4 颗 M3×8 螺钉装上 P-04 底板，四角贴上 φ8mm 硅胶脚垫，整机装配完成！
```
