Lucian-ming/smart-fans/artifacts/asr_max7219_wiring.png

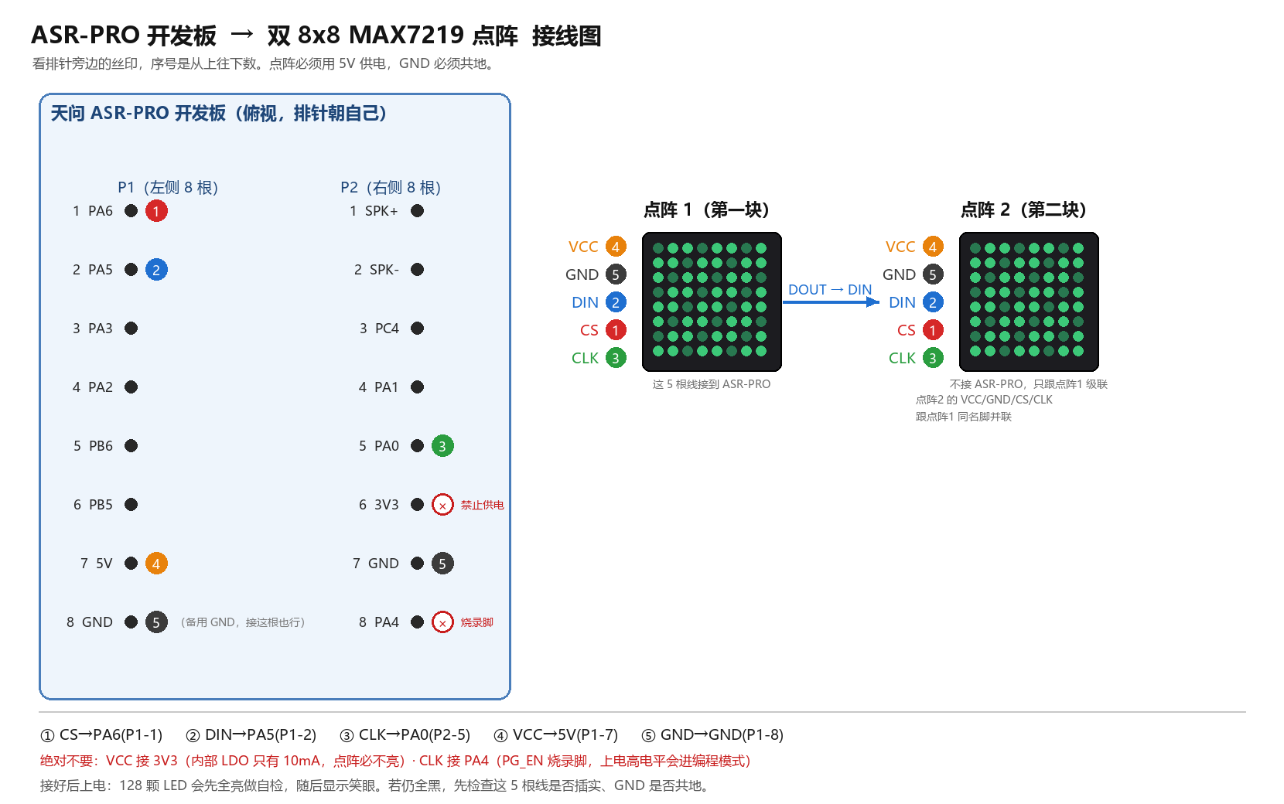
artifacts/asr_max7219_wiring.png
