Lucian-ming/smart-fans/artifacts/simulation_review/RevB_Repaired_Board_Bringup_Plan.md

# RevB 修复后上电验收计划（当前冻结板禁止投板/上电）

本计划仅用于今后获得明确放行的新修订板。它不是已经执行的实测记录，也不解除[当前禁止投板通知](<D:/下载/RevB_5V_Prototype_20261104_1856/00_暂停投板_待审核仿真.md>)。

## 开始条件

- 新板、BOM、原理图、Gerber必须绑定同一修订；原生DRC/ERC和网络一致性问题已经逐项处理，不能沿用旧14项摘要。
- 稳压器型号、电容稳定性与输入范围明确；电机/舵机工作电压及启动、堵转电流有资料或受控测试依据。
- 使用可显示电压电流的可调限流直流电源、万用表；测纹波/启动瞬态需示波器和短接地弹簧。没有仪器时不能把软件仿真当作此表已通过。

## 分阶段记录

| 阶段 | 条件/操作 | 必须记录的结果 | 不通过的处理 |
|---|---|---|---|
| 未上电检查 | 不装模块，不接电机/舵机/USB；核极性、焊锡桥、保险型号和供电跳帽 | 输入和各电源对地电阻、元件朝向、连接器针序；电容充电导致阻值变化须区分 | 明显短路、极性或针序不符则停止，不以反复送电定位 |
| 空载稳压 | 仅对已修复板供5.0V，限流从较低值开始；初始100mA仅为故障能量限制，不是功能额定 | 输入电流、保护后5V、3.3V、稳压器输出波形；应与准确器件数据手册容差一致 | 若进入限流、异常发热或输出振荡，立即断电；不随意调大限流掩盖故障 |
| MCU与逻辑 | 逐个装MCU、传感器、OLED、ASR，电机舵机仍断开；按跳帽规则处理USB | 每次电流增量、3.3V及5V最小电压、复位情况；I2C总线实际30%–70%上升时间及低电平 | 任一步异常停止，先排除供电和接口，不直接归咎固件 |
| 语音负载 | 使用正确阻抗喇叭，BTL两端均不得接地；正常音量阶跃 | ASR电源脚处电压和纹波、总电流峰值、是否复位 | 未达到模块供电要求不继续加电机负载 |
| 电机独立 | 已确定额定电压/电流，先脱离整机控制做受控启动测试，再接已校验H桥 | 启动峰值、稳态电流、VM/VCC、H桥温升；短时峰值与连续额定分别对照 | 不把3.2A脉冲绝对额定当连续能力；无安全限流/测量条件不做堵转实验 |
| 舵机独立 | 确认是360°连续旋转型号，机构不限制行程；先单独验证停止脉宽 | 停止、正反转、启动电流和5V最低值 | 不运行旧0–90°定位扫风算法；未加位置反馈不能声称可靠限角 |
| 组合负载 | 前述单项合格后逐步组合语音、电机、舵机；观察接口节点而非仅适配器端 | 稳态/瞬态最小电压、总回路压降、各功率器件/连接器温升 | 任一器件工作范围失守或异常发热，重新设计供电/保护，不只增大保险 |
| USB/断电顺序 | 只测试文档允许的供电组合；未证明的单侧供电不尝试 | 各跳帽状态、母板/MCU/ASR供电顺序、未供电电源轨是否被抬升 | 未证明Ioff隔离前不得宣布任意热插拔安全 |

## 关键判据边界

- TB6612实际VM应满足其工作范围；本项目5V方案以≥4.5V工况下的额定条件审查，不能仅看电源适配器铭牌。
- I2C标准模式上升时间限值1000ns、快速模式300ns，测量定义为30%到70%；同时核查引脚灌电流和模块实际并联上拉。
- 3A总保险不是电机精确限流器。支路保护需与H桥、电机和线束协调。
- 热验收必须注明环境温度、持续时间、负载和测温方法，不用“手摸不烫”替代结温/温升边界。
- 若实物尺寸、模块方向或引脚与设计约定不符，先停止插装；不带电弯针试错。

## 结果登记模板

每项记录：板修订/哈希、日期、操作者、仪器、接线图或照片、输入设置、负载、原始波形、实测数值、判据来源、PASS/FAIL/未测。当前所有实物项目均为**未测**。
