Lucian-ming/smart-fans/artifacts/report_pack/figs/schematic_revB4.pdf

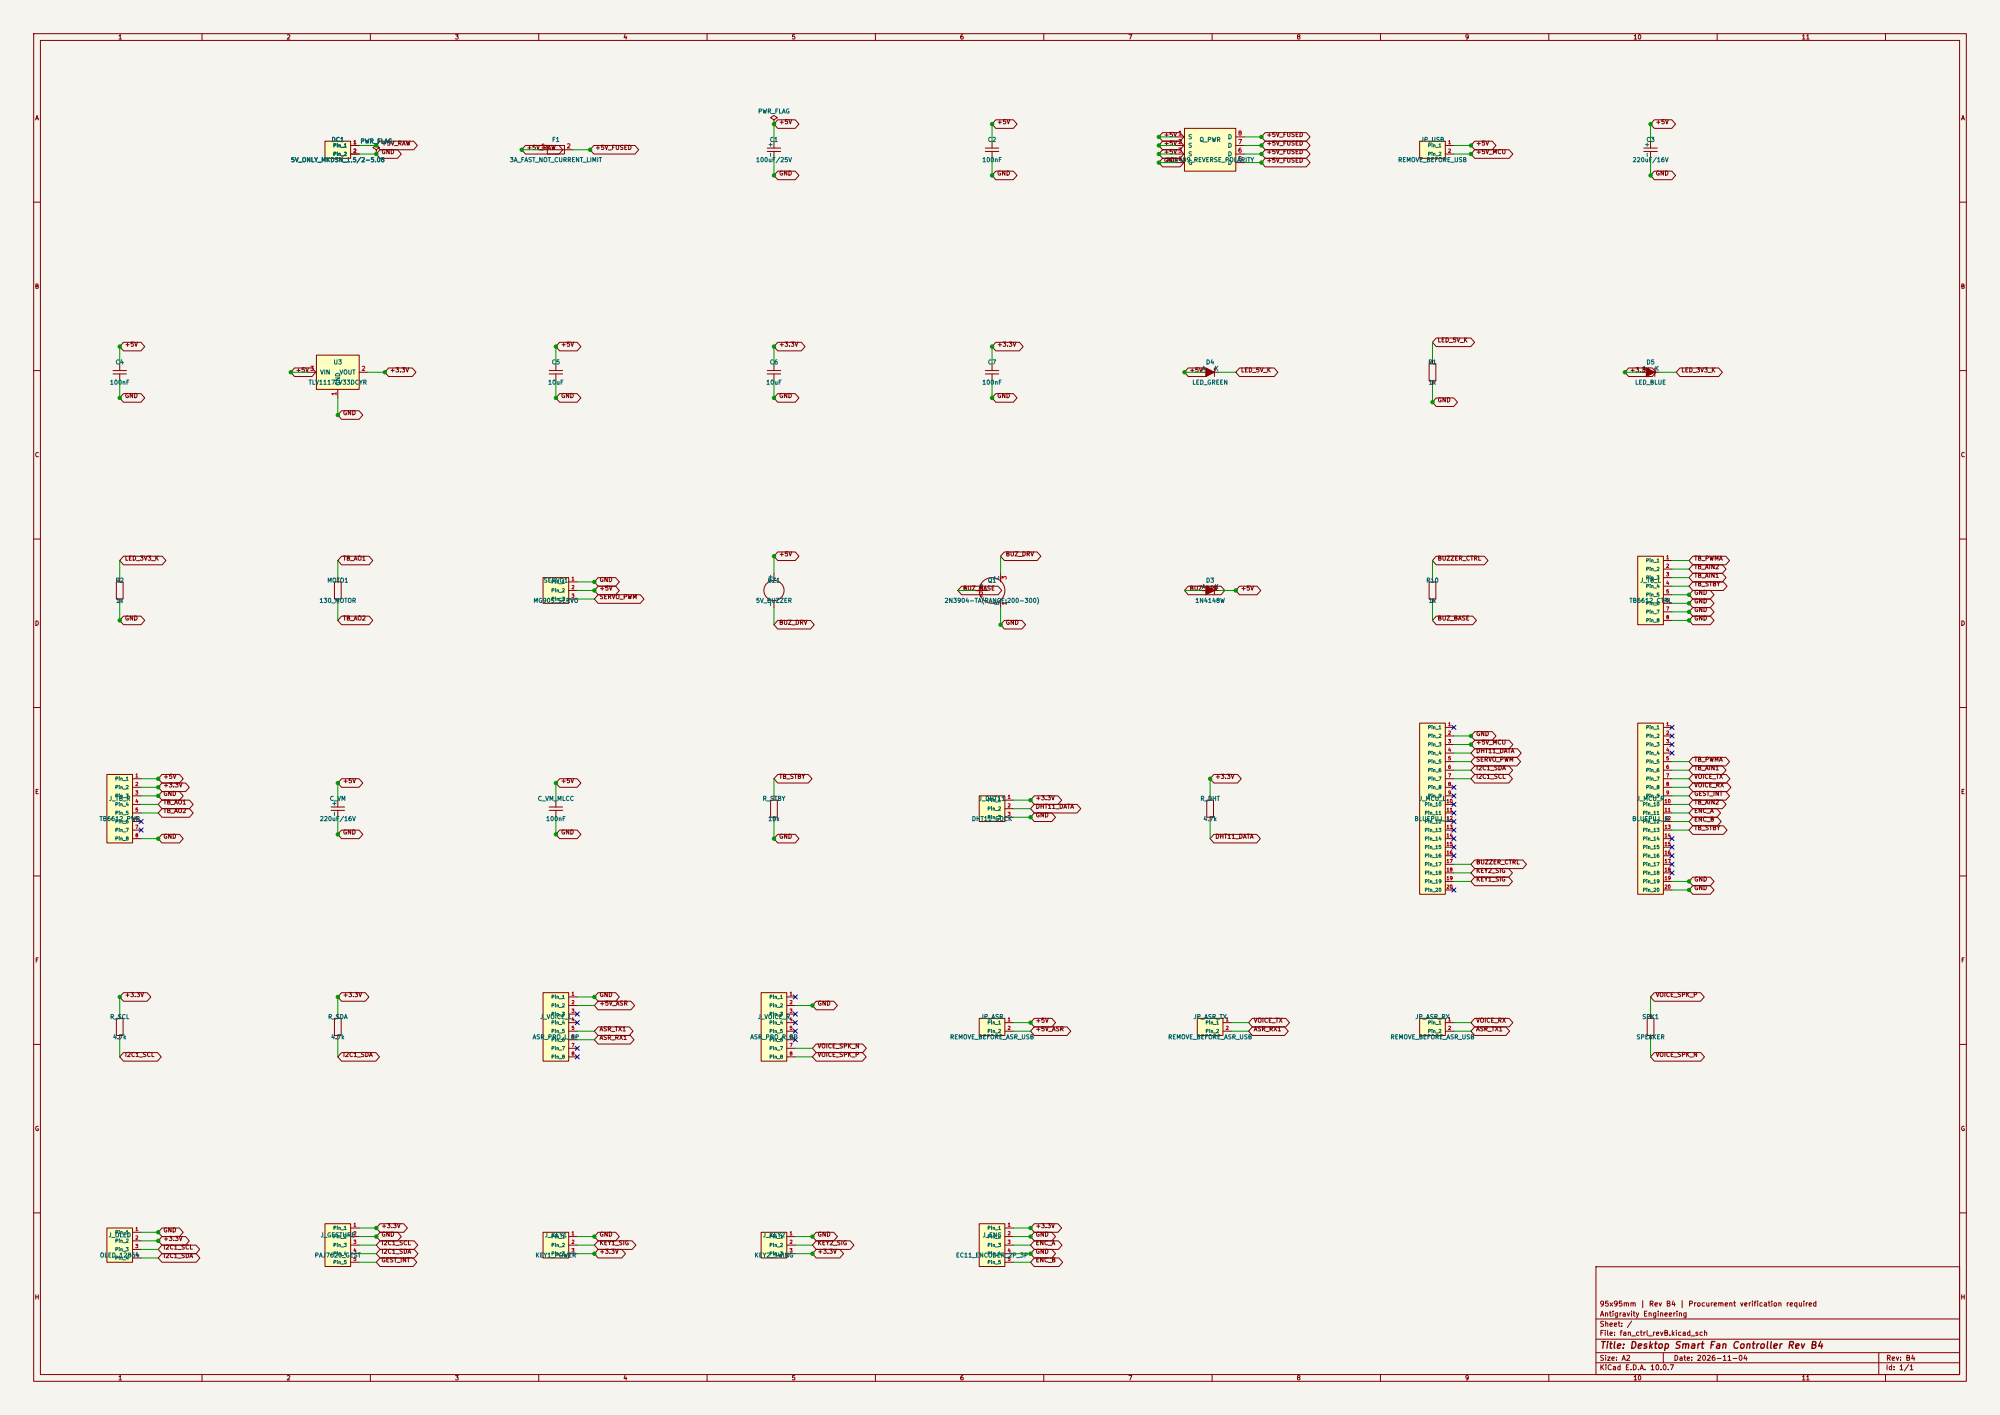
[picture p72: page 1]

95x95mm | Rev B4 | Procurement verification required
Antigravity Engineering
Sheet: /
File: fan_ctrl_revB.kicad_sch
Title: Desktop Smart Fan Controller Rev B4

Size: A2 | Rev: B4
KiCad E.D.A. 10.0.7 | Id: 1/1
