Lucian-ming/smart-fans/docs/hardware/sources/Lelon-RZW-C134665.pdf

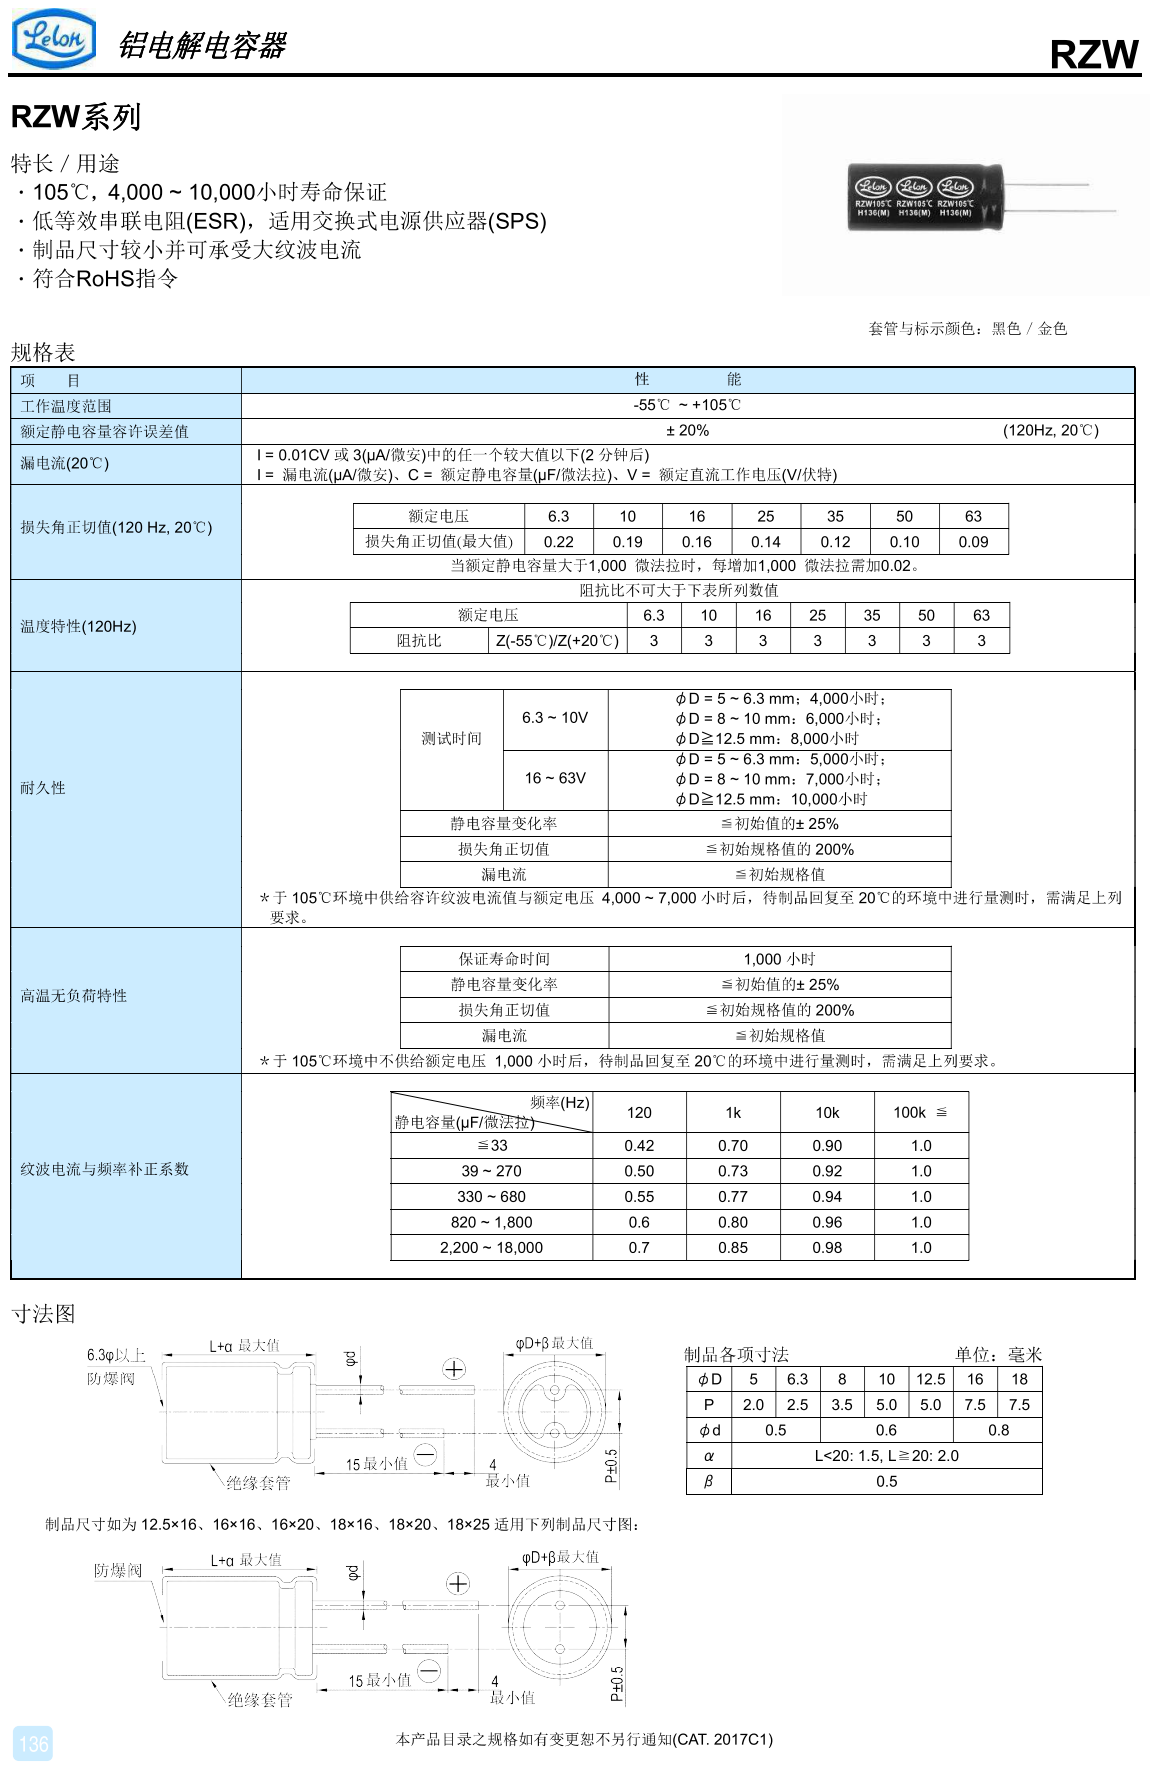
[picture p73: page 1]

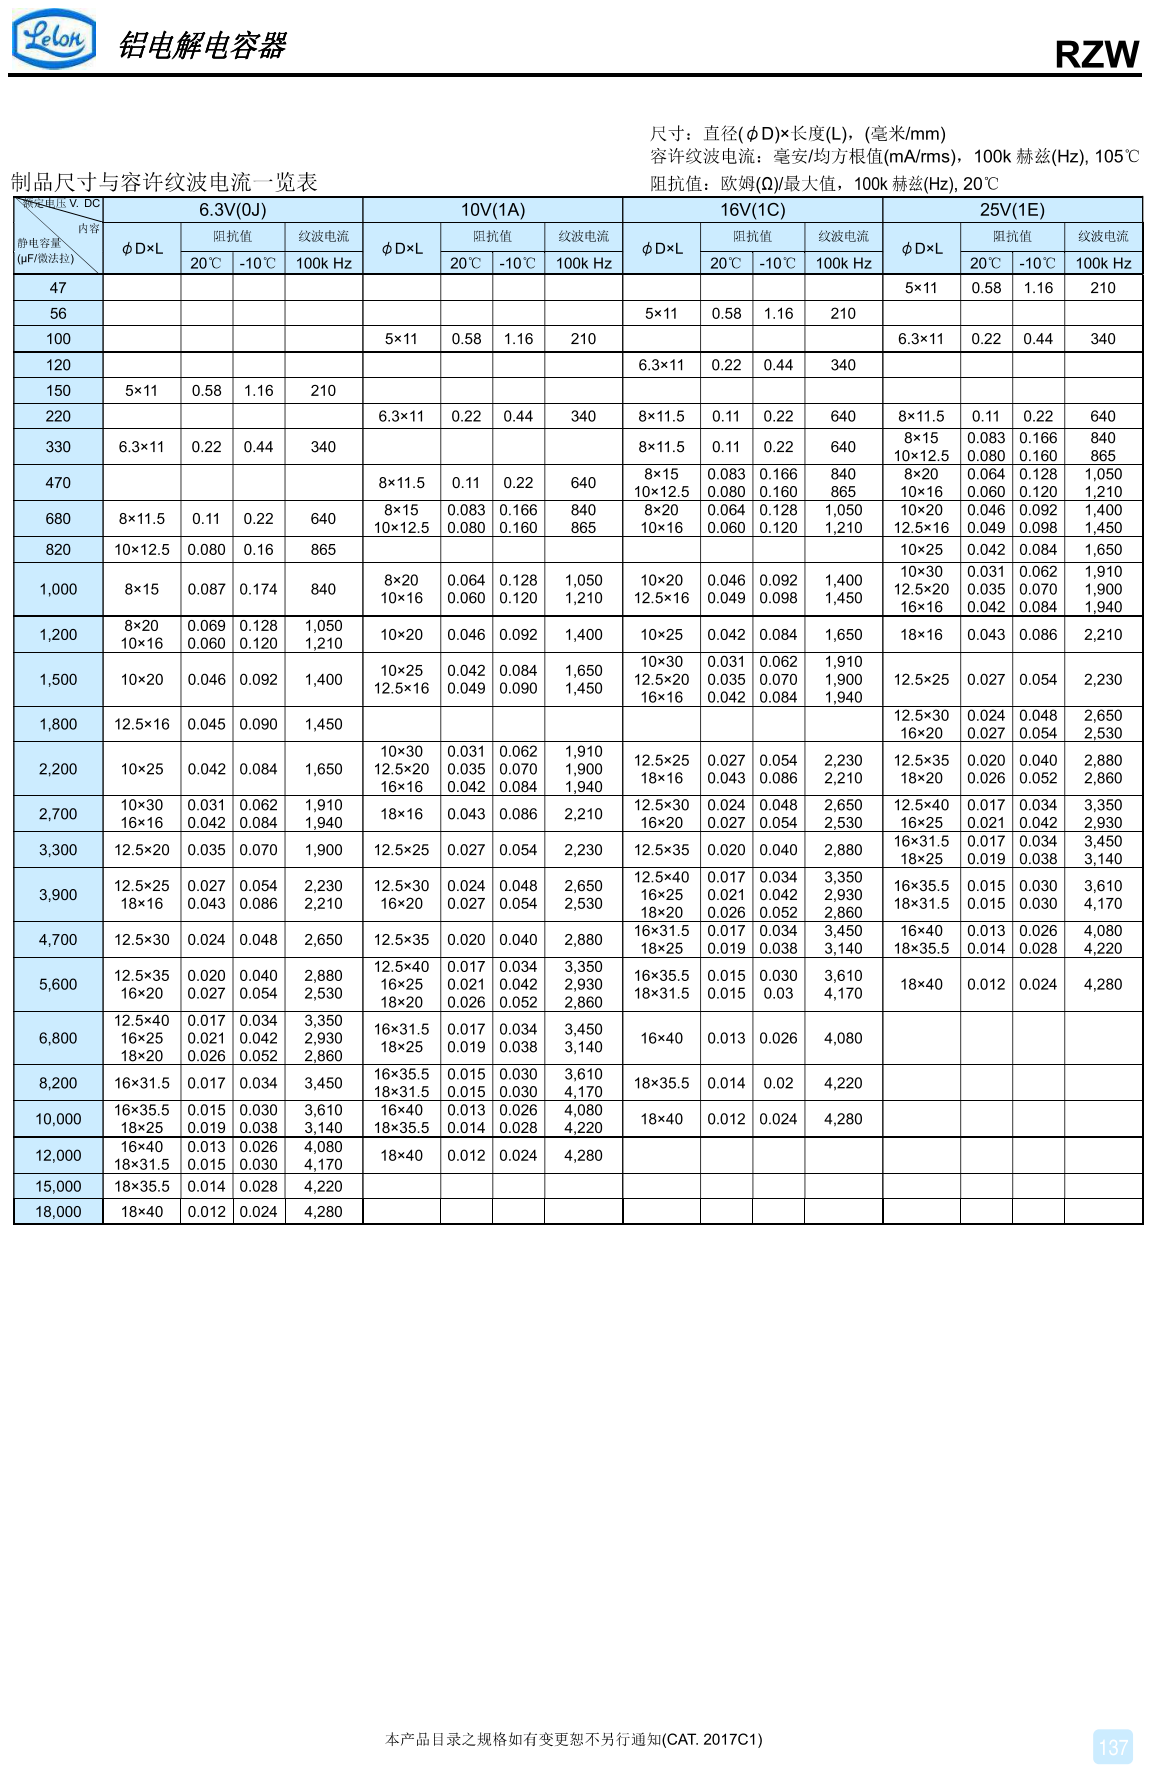
[picture p74: page 2]

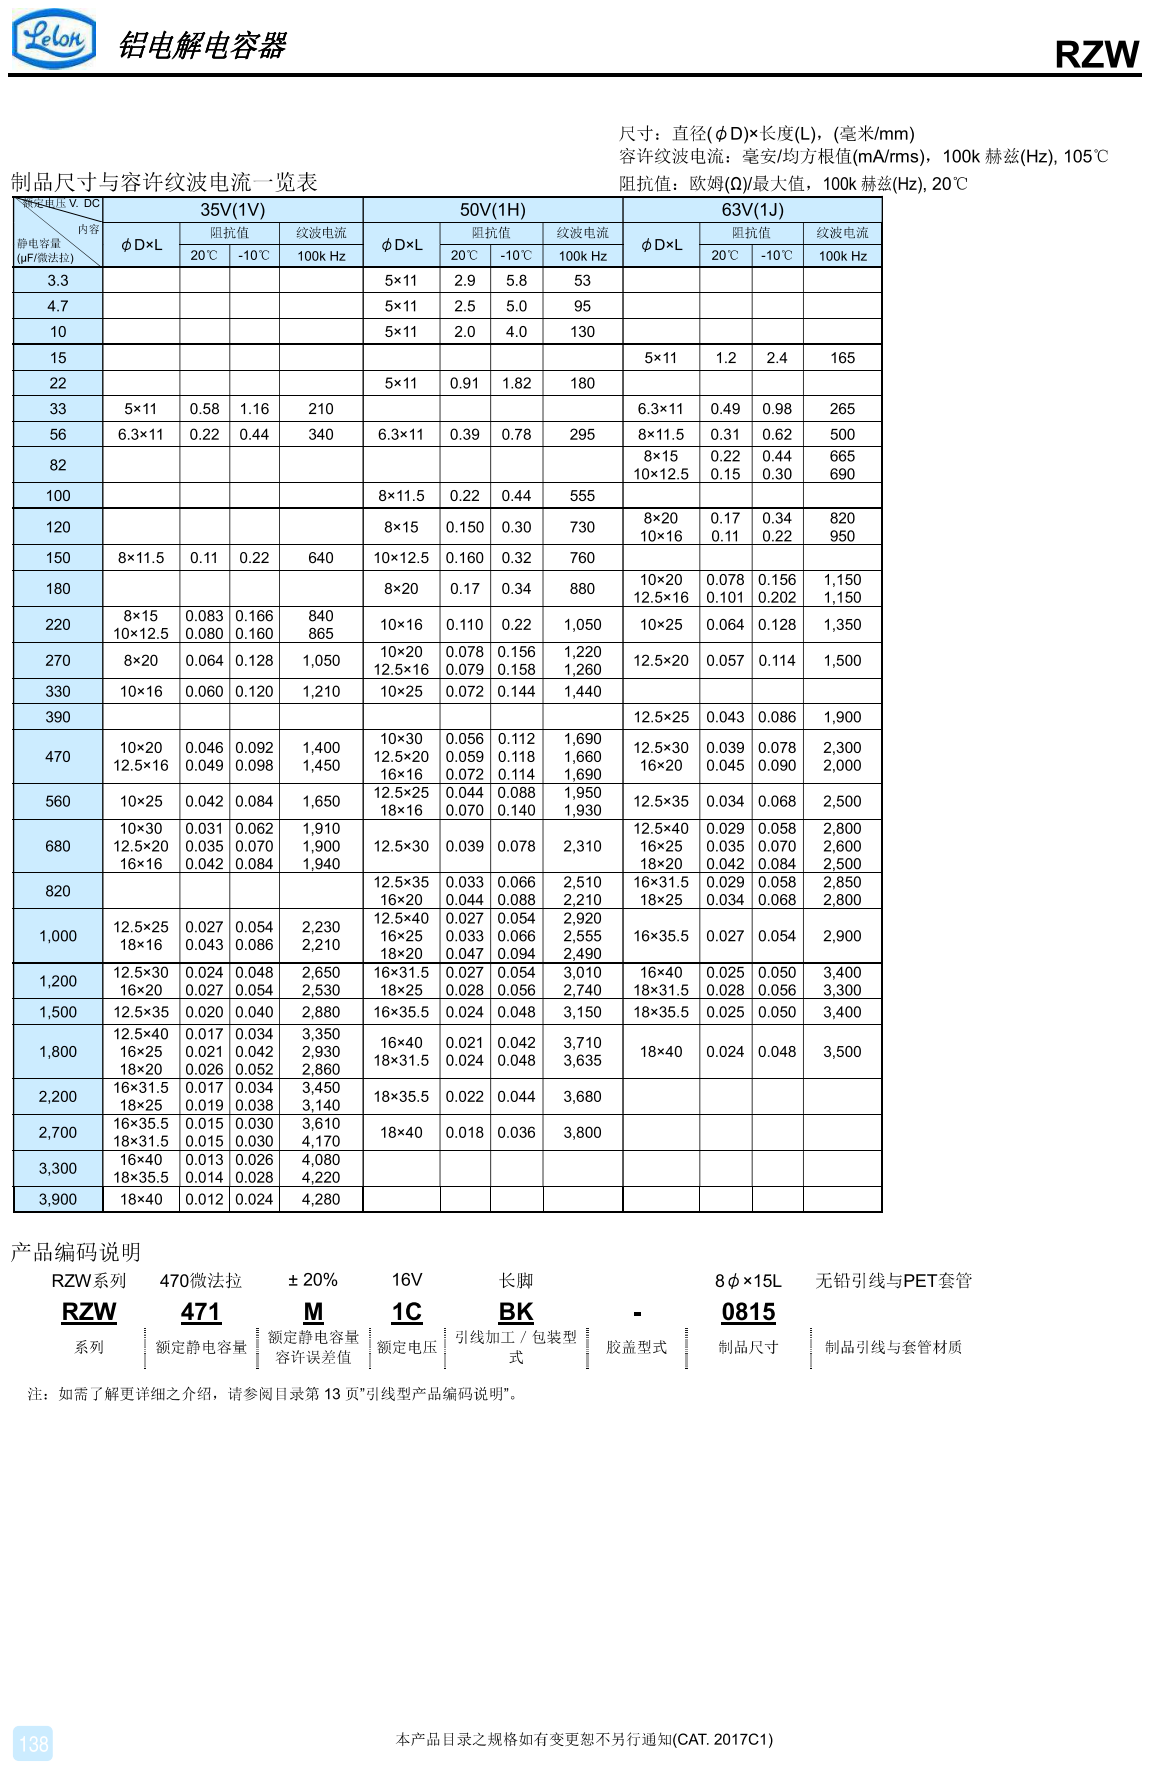
[picture p75: page 3]
