Lucian-ming/smart-fans/artifacts/procurement_review_20261104/female_3P.pdf

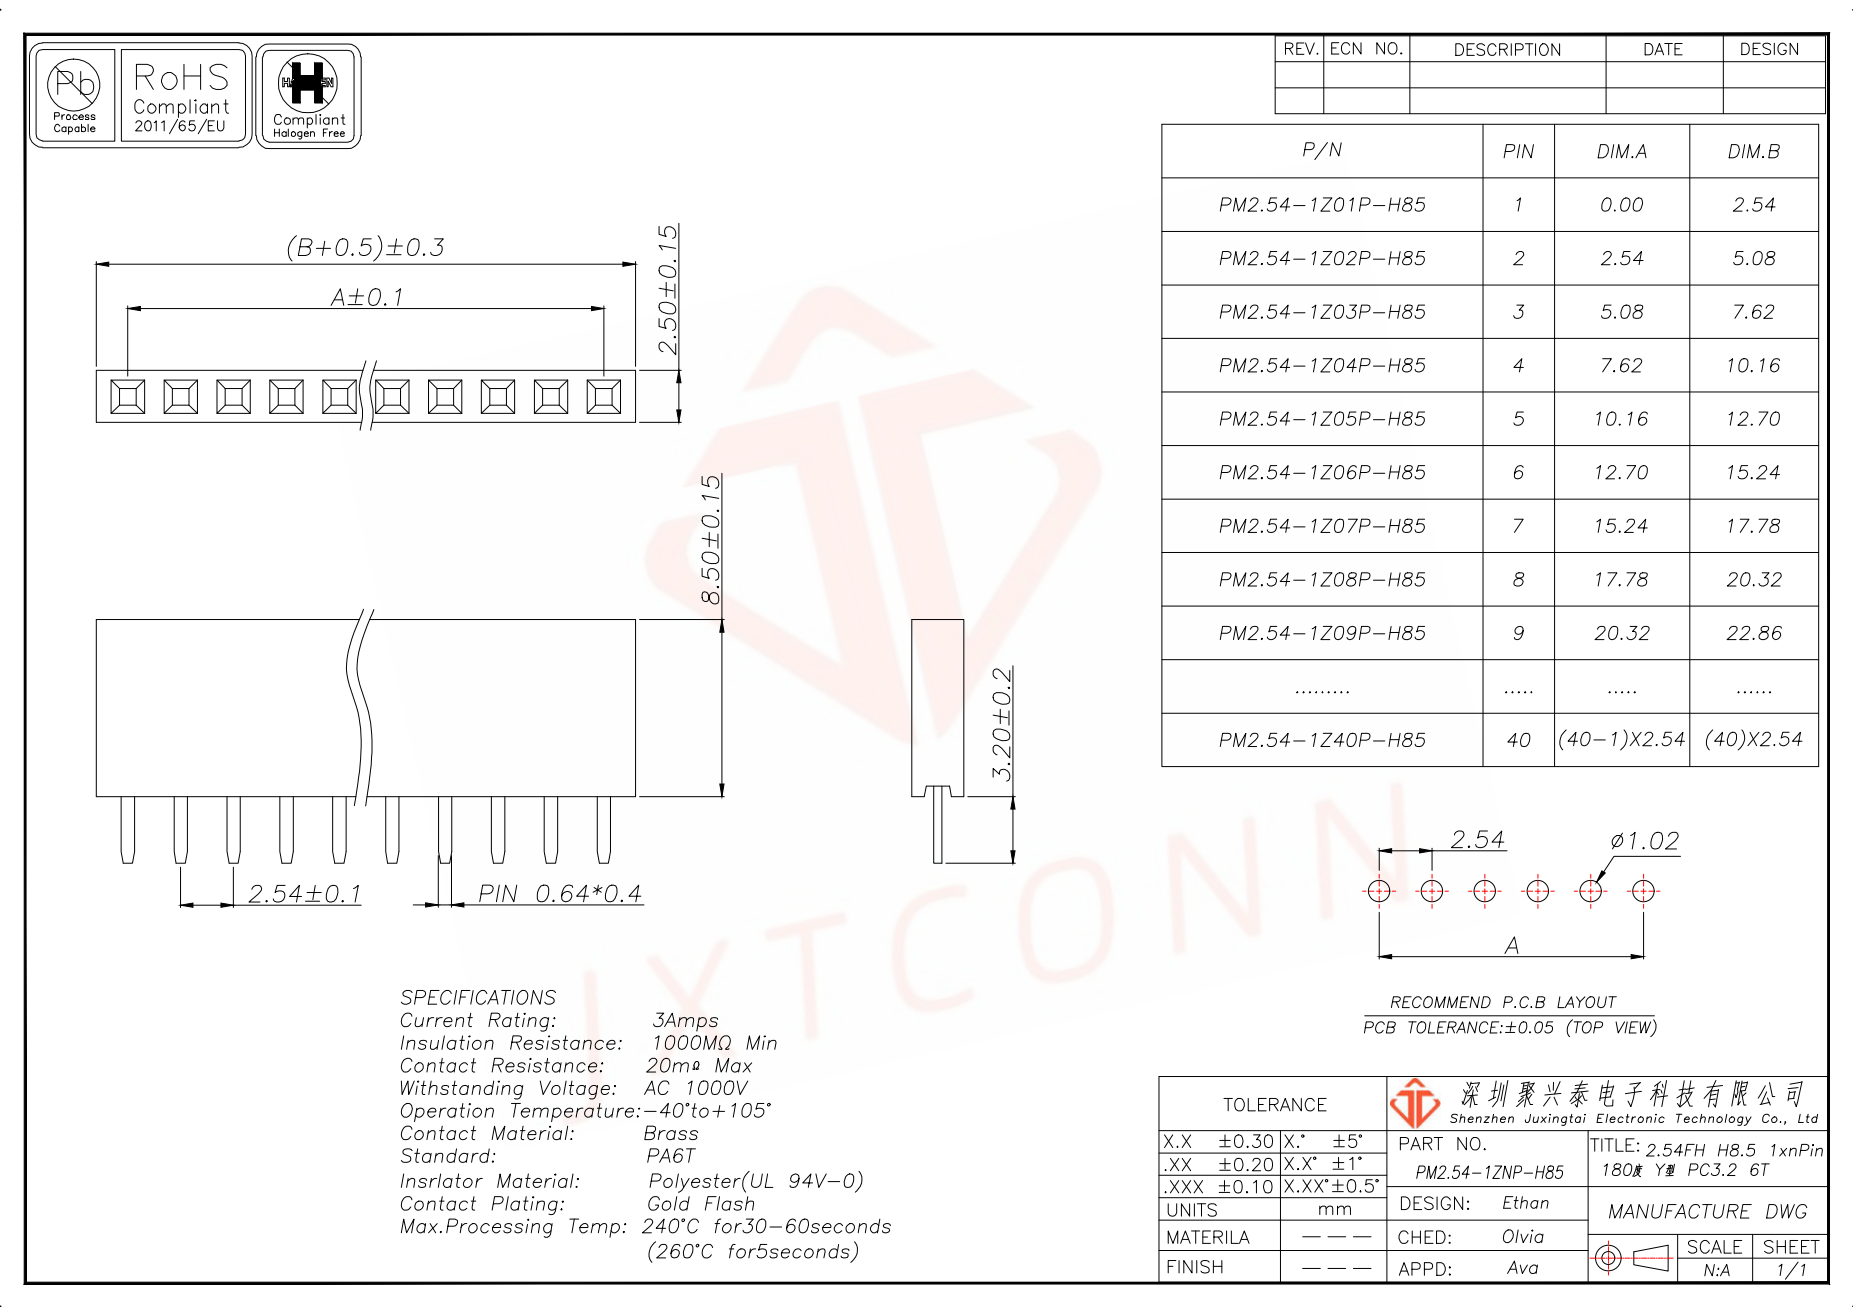
[picture p76: page 1]
