Lucian-ming/smart-fans/artifacts/procurement_review_20261104/mcu_20P.pdf

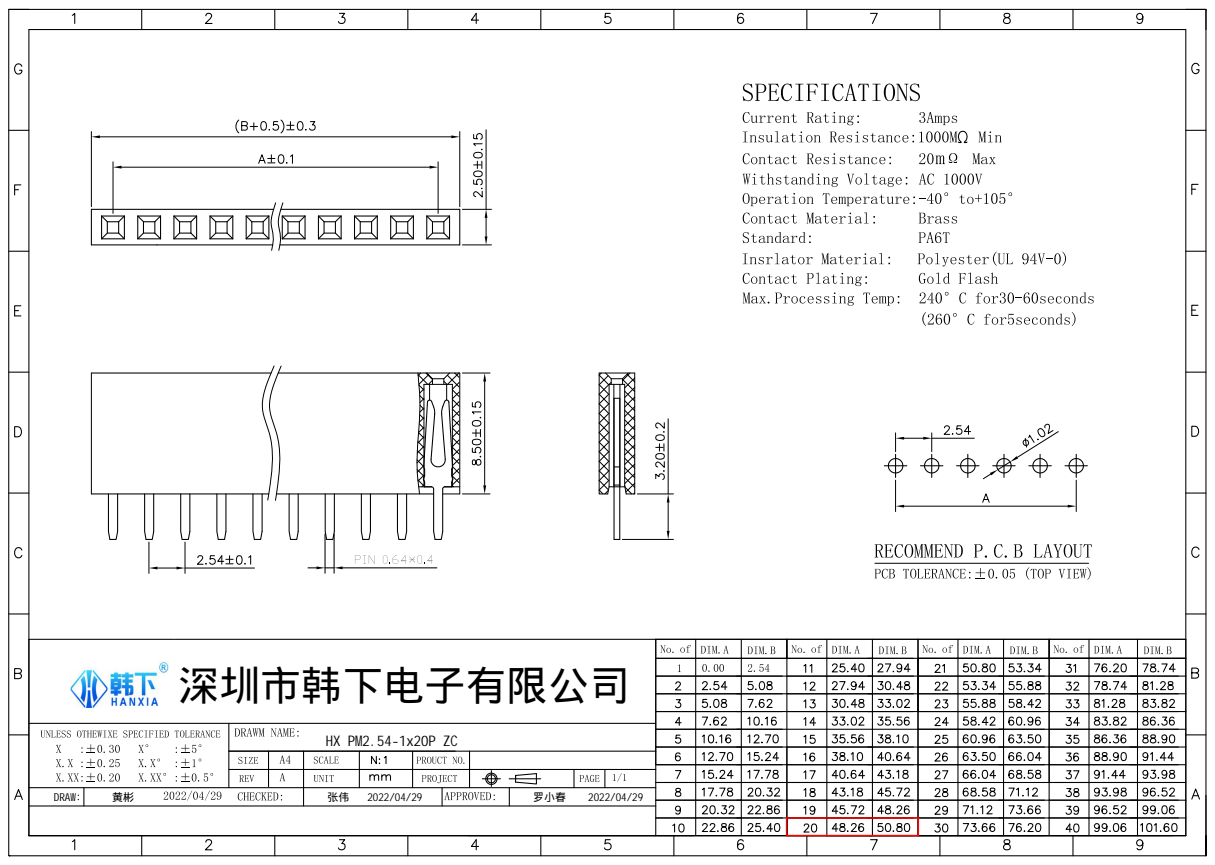
[picture p77: page 1]
DRAW; 罗小春

深圳市韩下电子 有限公司
