Lucian-ming/smart-fans/hardware/ltspice/buzzer_flyback.asc

CPAR2: cap; 35p
D_CLAMP1: diode; 1N4148W
LBUZ1: ind; 5m
LBUZ2: ind; 5m
Q1: npn; S8050
Q2: npn; S8050
RB1: res; 1k
RB2: res; 1k
RBUZ1: res; 100
RBUZ2: res; 100
RPD1: res; 10k
RPD2: res; 10k
VCC: voltage; 5
VPB14: voltage; PULSE(0 3.3 0 10n 10n 50u 100u)
Named nets: 5V, 0, PB14, BASE1, N_BUZ1, COLL_PROT, BASE2, N_BUZ2, COLL_UNPROT
Smart Fan RevA - Buzzer Driver & Flyback Clamp (S8050 + 1N4148W)
Circuit 1: PROTECTED (1N4148W clamps coil turn-off)
Circuit 2: UNPROTECTED (only 35pF parasitic)
Shared PB14 pulse: 0->3.3V, 50us ON per 100us period
.tran 0.1u 120u 0 10n
.model S8050 NPN(IS=1e-14 BF=150 VAF=50 IKF=0.3 ISE=1e-12 NE=1.5 BR=4 CJC=10p CJE=25p TF=400p TR=50n)
.model 1N4148W D(IS=2.52n RS=0.568 N=1.752 CJO=4p TT=4n BV=100)
