Lucian-ming/smart-fans/(list of files, drawings)

Other design files:
artifacts/eda_gateway_research/easyeda__easyeda-api-skill__package.json
artifacts/eda_gateway_research/easyeda__easyeda-api-skill_meta.json
artifacts/eda_gateway_research/easyeda__easyeda-api-skill_tree.json
artifacts/eda_gateway_research/easyeda__eext-run-api-gateway__extension.json
artifacts/eda_gateway_research/easyeda__eext-run-api-gateway__package.json
artifacts/eda_gateway_research/easyeda__eext-run-api-gateway_meta.json
artifacts/eda_gateway_research/easyeda__eext-run-api-gateway_tree.json
artifacts/pcb_release_footprint_metrics.json
hardware/fabrication/validation/pcb_prototype_delivery_manifest.json
hardware/fabrication/validation/pcb_prototype_release_review.json
tools/eda_gateway/easyeda-api-skill/package-lock.json
tools/eda_gateway/easyeda-api-skill/package.json
