Lucian-ming/smart-fans/artifacts/native_pcb_review/candidate_precision_001/fan_ctrl_revB.kicad_pcb

## KiCad design artifacts/native_pcb_review/candidate_precision_001/fan_ctrl_revB.kicad_pcb (2026-11-11)

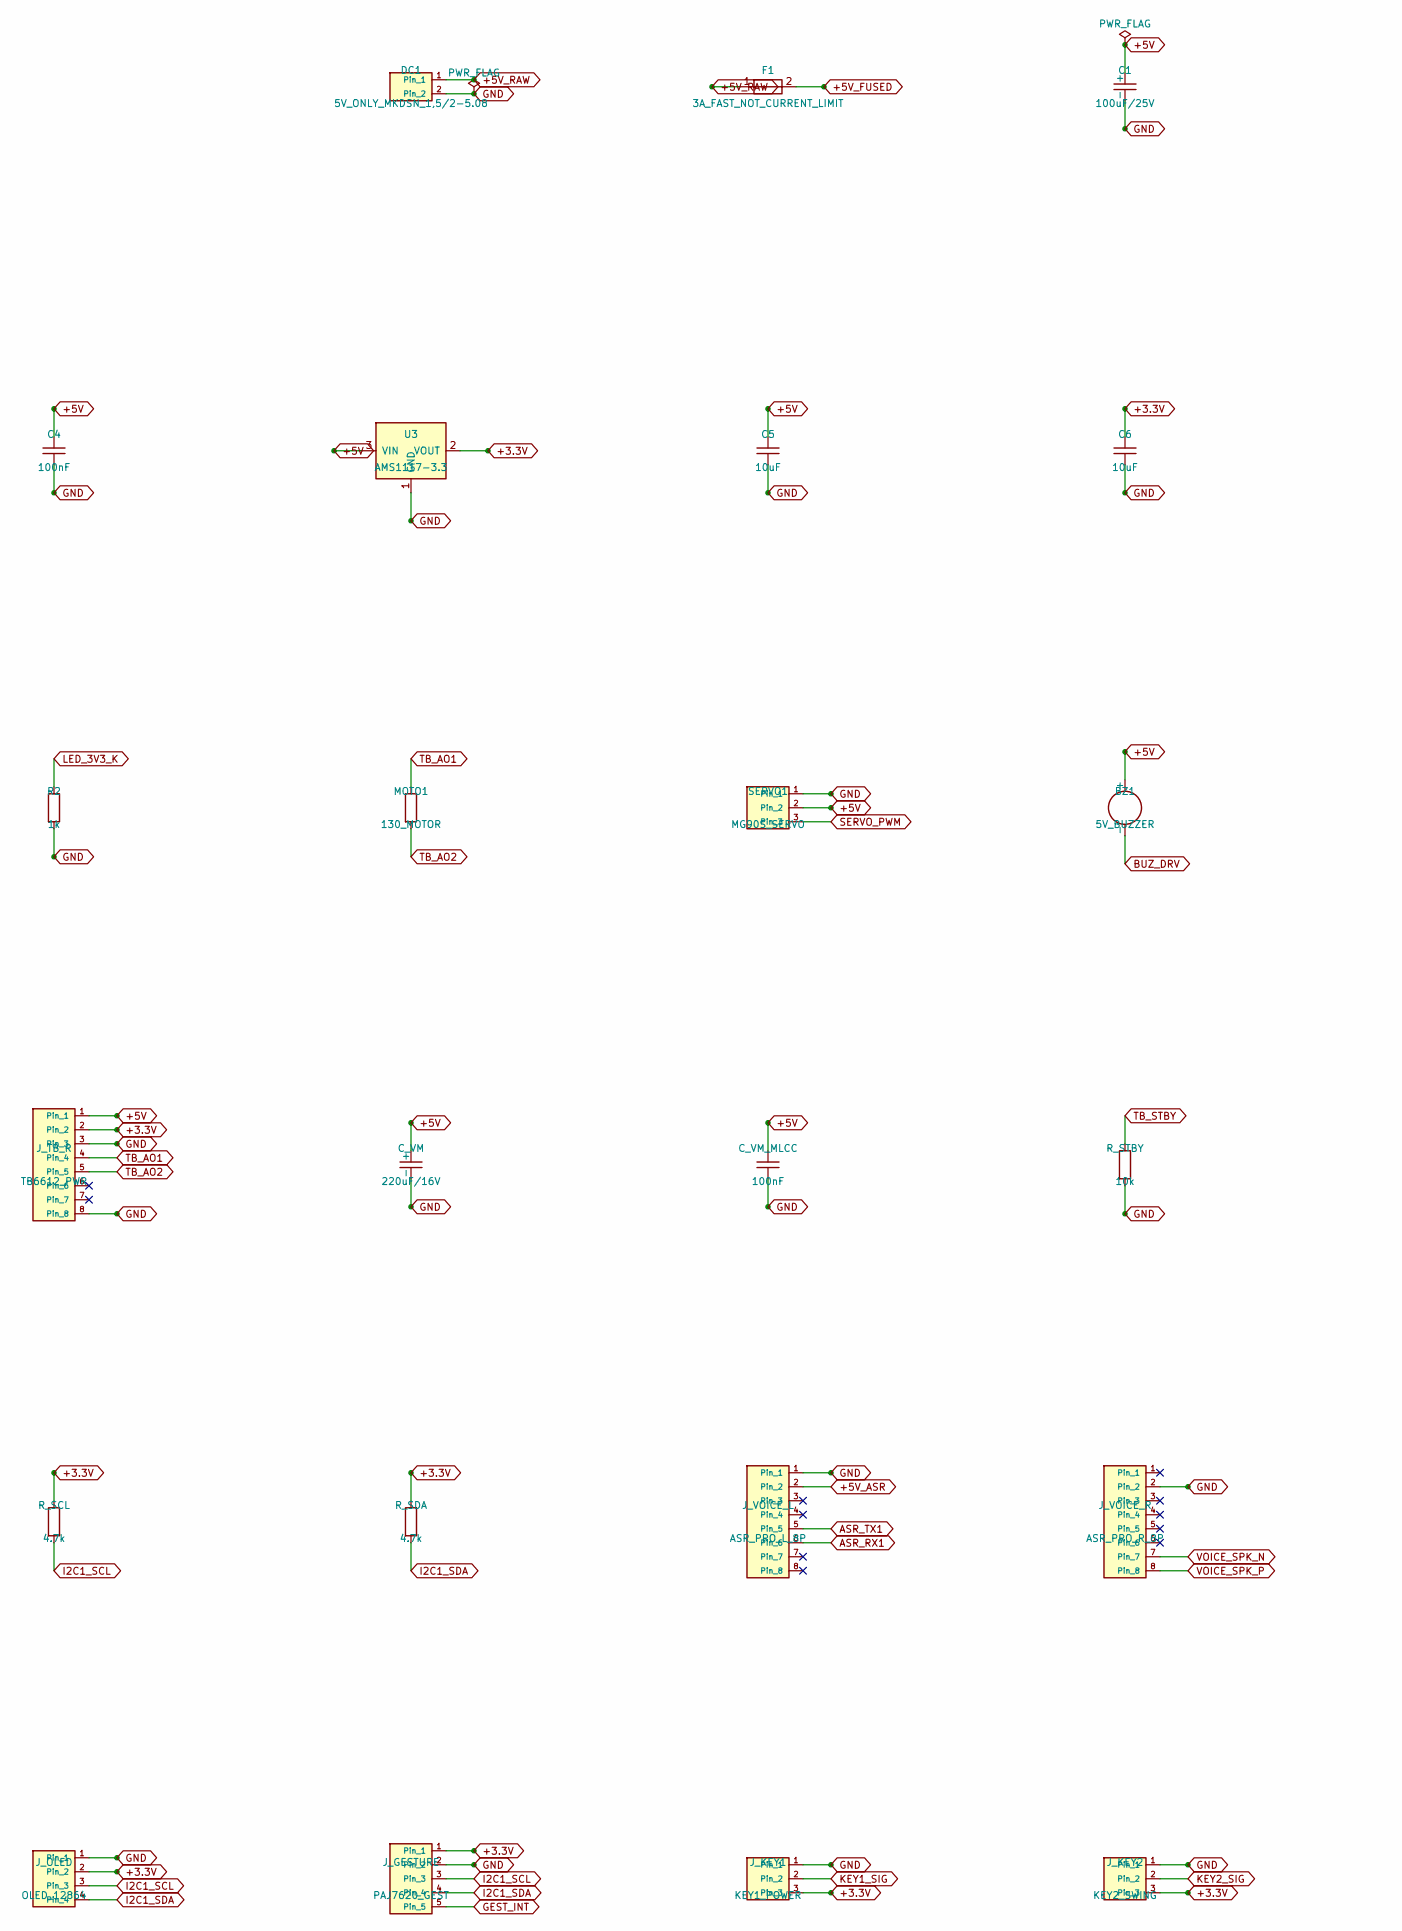
[picture p78: schematic fan_ctrl_revB.kicad_sch, Desktop Smart Fan Controller Rev B4, part in row 1, column 1]

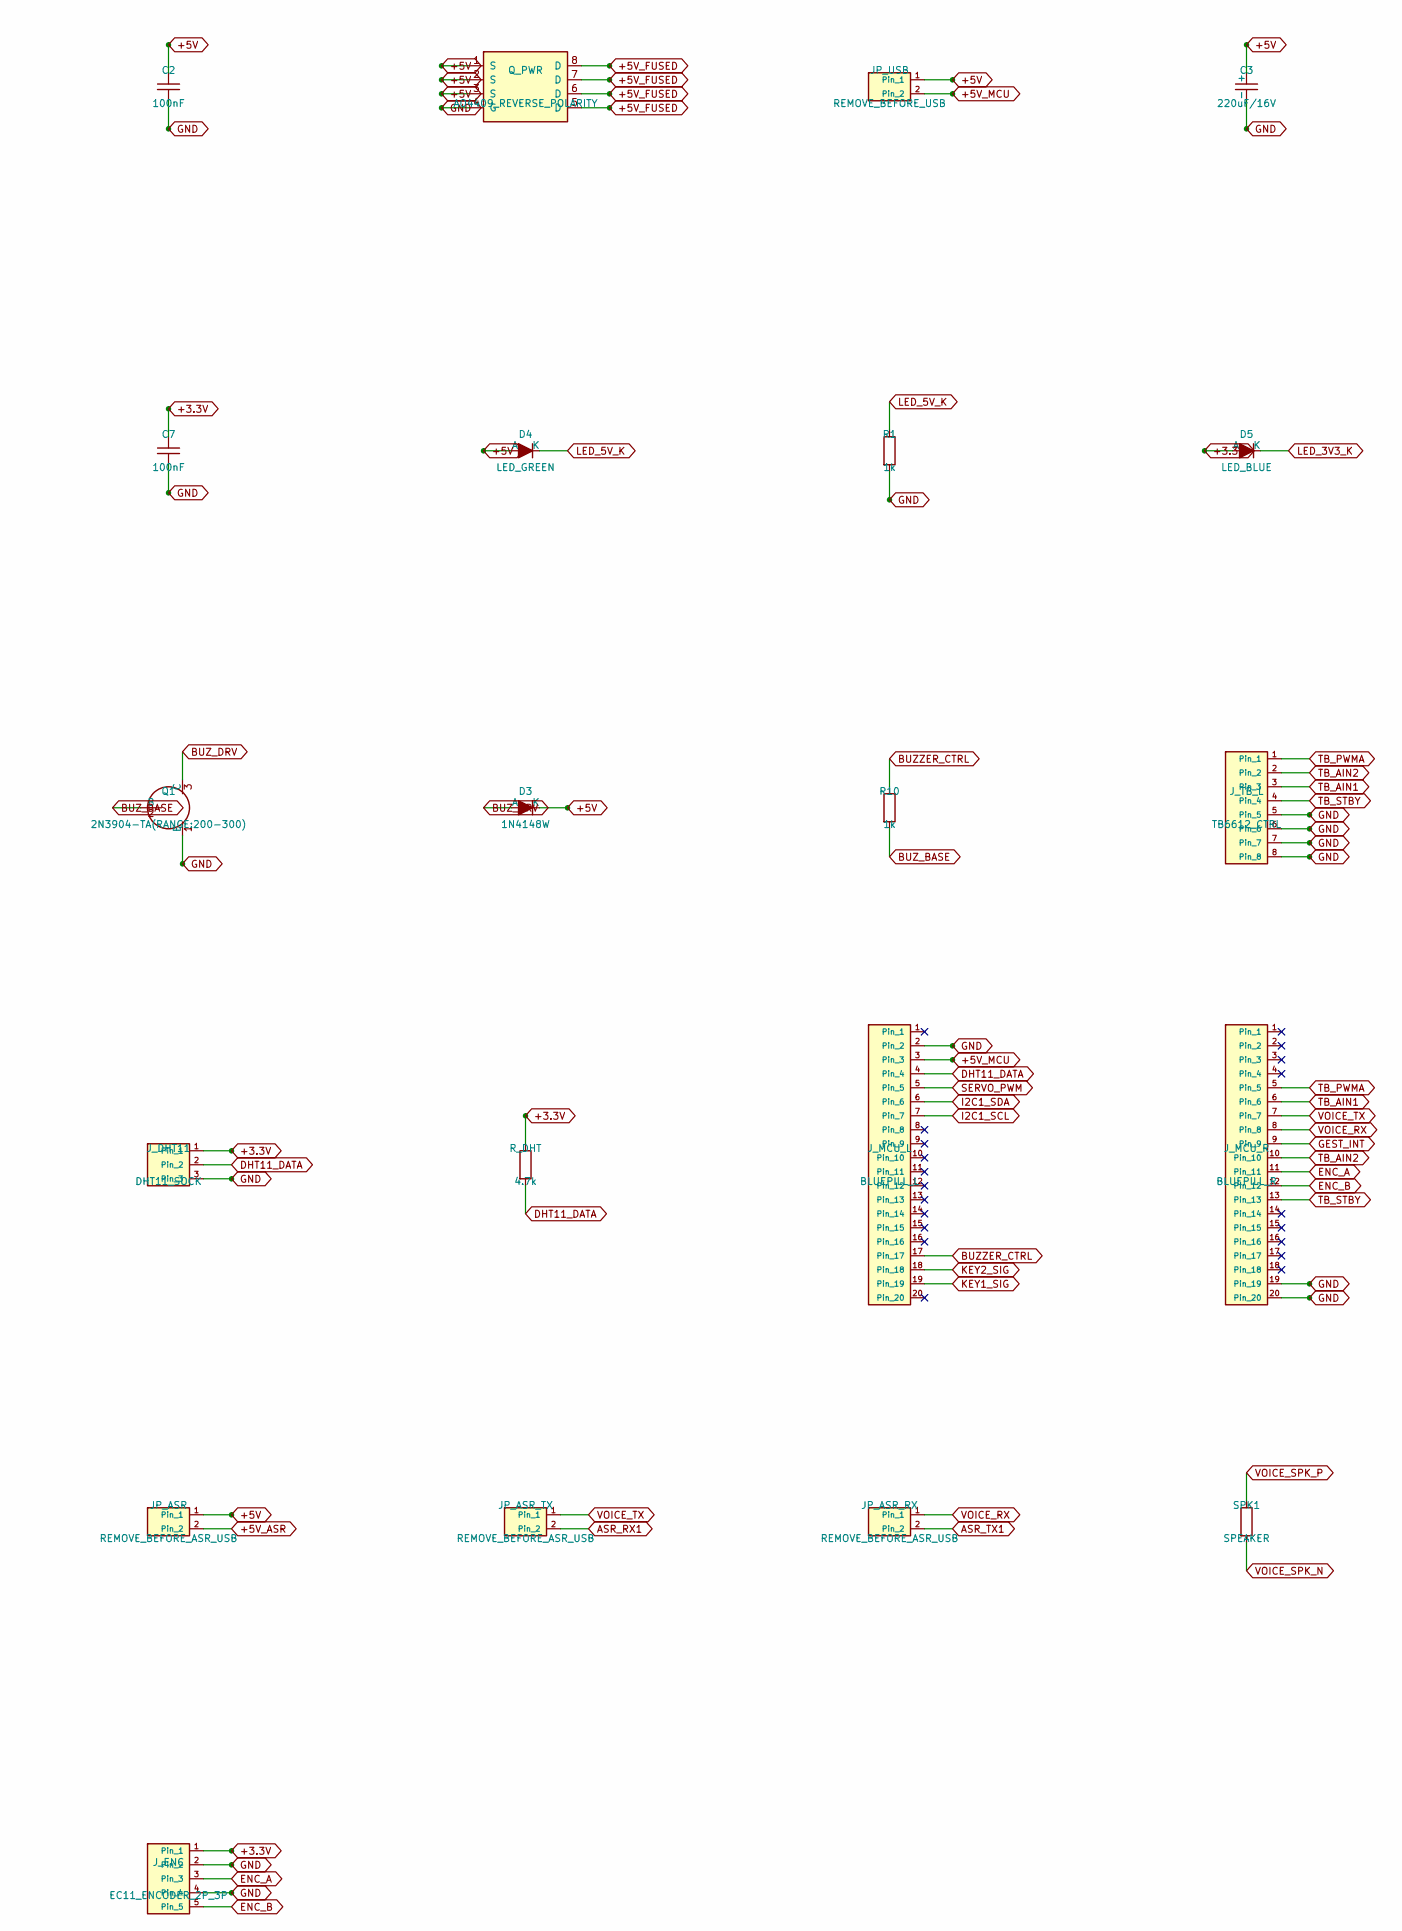
[picture p79: schematic fan_ctrl_revB.kicad_sch, Desktop Smart Fan Controller Rev B4, part in row 1, column 2]

Parts:
BZ1: 5V_BUZZER; Board_BZ1; LCSC C96093
C1: 100uF/25V; Board_C1; LCSC C134665
C2: 100nF; Board_C2; LCSC C49678
C3: 220uF/16V; Board_C3; LCSC C338177
C4: 100nF; Board_C4; LCSC C49678
C5: 10uF; Board_C5; LCSC C15849
C6: 10uF; Board_C6; LCSC C15849
C7: 100nF; Board_C7; LCSC C49678
C_VM: 220uF/16V; Board_C_VM; LCSC C338177
C_VM_MLCC: 100nF; Board_C_VM_MLCC; LCSC C49678
D3: 1N4148W; Board_D3; LCSC C81598
D4: LED_GREEN; Board_D4; LCSC C2292
D5: LED_BLUE; Board_D5; LCSC C2293
DC1: 5V_ONLY_MKDSN_1,5/2-5.08; Board_DC1
F1: 3A_FAST_NOT_CURRENT_LIMIT; Board_F1
JP_ASR: REMOVE_BEFORE_ASR_USB; Board_JP_ASR
JP_ASR_RX: REMOVE_BEFORE_ASR_USB; Board_JP_ASR_RX
JP_ASR_TX: REMOVE_BEFORE_ASR_USB; Board_JP_ASR_TX
JP_USB: REMOVE_BEFORE_USB; Board_JP_USB
J_DHT11: DHT11_SOCK; Board_J_DHT11; LCSC C2718487
J_ENC: EC11_ENCODER_2P_3P; Board_J_ENC
J_GESTURE: PAJ7620_GEST; Board_J_GESTURE; LCSC C50950
J_KEY1: KEY1_POWER; Board_J_KEY1; LCSC C2718487
J_KEY2: KEY2_SWING; Board_J_KEY2; LCSC C2718487
J_MCU_L: BLUEPILL_L; Board_J_MCU_L; LCSC C50984
J_MCU_R: BLUEPILL_R; Board_J_MCU_R; LCSC C50984
J_OLED: OLED_12864; Board_J_OLED; LCSC C2718488
J_TB_L: TB6612_CTRL; Board_J_TB_L; LCSC C27438
J_TB_R: TB6612_PWR; Board_J_TB_R; LCSC C27438
J_VOICE_L: ASR_PRO_L_8P; Board_J_VOICE_L
J_VOICE_R: ASR_PRO_R_8P; Board_J_VOICE_R
MOTO1: 130_MOTOR; Board_MOTO1; LCSC C5258883
Q1: 2N3904-TA(RANGE:200-300); Board_Q1; LCSC C2081
Q_PWR: AO4409_REVERSE_POLARITY; Board_Q_PWR
R1: 1k; Board_R1; LCSC C17513
R2: 1k; Board_R2; LCSC C17513
R10: 1k; Board_R10; LCSC C17513
R_DHT: 4.7k; Board_R_DHT; LCSC C17673
R_SCL: 4.7k; Board_R_SCL; LCSC C17673
R_SDA: 4.7k; Board_R_SDA; LCSC C17673
R_STBY: 10k; Board_R_STBY; LCSC C17414
SERVO1: MG90S_SERVO; Board_SERVO1; LCSC C2718487
SPK1: SPEAKER; Board_SPK1; LCSC C5258883
U3: AMS1117-3.3; Board_U3; LCSC C6186

Connections:
+3.3V: C6.1, C7.1, D5.2 (A), J_DHT11.1, J_ENC.1, J_GESTURE.1, J_KEY1.3, J_KEY2.3, J_OLED.2, J_TB_R.2, R_DHT.1, R_SCL.1, R_SDA.1, U3.2 (VOUT)
+5V: BZ1.1 (+), C1.1 (+), C2.1, C3.1 (+), C4.1, C5.1, C_VM.1 (+), C_VM_MLCC.1, D3.1 (K), D4.2 (A), JP_ASR.1, JP_USB.1, J_TB_R.1, Q_PWR.1 (S), Q_PWR.2 (S), Q_PWR.3 (S), SERVO1.2, U3.3 (VIN)
+5V_ASR: JP_ASR.2, J_VOICE_L.2
+5V_FUSED: F1.2, Q_PWR.5 (D), Q_PWR.6 (D), Q_PWR.7 (D), Q_PWR.8 (D)
+5V_MCU: JP_USB.2, J_MCU_L.3
+5V_RAW: DC1.1, F1.1
ASR_RX1: JP_ASR_TX.2, J_VOICE_L.6
ASR_TX1: JP_ASR_RX.2, J_VOICE_L.5
BUZZER_CTRL: J_MCU_L.17, R10.1
BUZ_BASE: Q1.2 (B), R10.2
BUZ_DRV: BZ1.2 (-), D3.2 (A), Q1.3 (C)
DHT11_DATA: J_DHT11.2, J_MCU_L.4, R_DHT.2
ENC_A: J_ENC.3, J_MCU_R.11
ENC_B: J_ENC.5, J_MCU_R.12
GEST_INT: J_GESTURE.5, J_MCU_R.9
GND: C1.2 (-), C2.2, C3.2 (-), C4.2, C5.2, C6.2, C7.2, C_VM.2 (-), C_VM_MLCC.2, DC1.2, J_DHT11.3, J_ENC.2, J_ENC.4, J_GESTURE.2, J_KEY1.1, J_KEY2.1, J_MCU_L.2, J_MCU_R.19, J_MCU_R.20, J_OLED.1, J_TB_L.5, J_TB_L.6, J_TB_L.7, J_TB_L.8, J_TB_R.3, J_TB_R.8, J_VOICE_L.1, J_VOICE_R.2, Q1.1 (E), Q_PWR.4 (G), R1.2, R2.2, R_STBY.2, SERVO1.1, U3.1 (GND); also elsewhere on the board
I2C1_SCL: J_GESTURE.3, J_MCU_L.7, J_OLED.3, R_SCL.2
I2C1_SDA: J_GESTURE.4, J_MCU_L.6, J_OLED.4, R_SDA.2
KEY1_SIG: J_KEY1.2, J_MCU_L.19
KEY2_SIG: J_KEY2.2, J_MCU_L.18
LED_3V3_K: D5.1 (K), R2.1
LED_5V_K: D4.1 (K), R1.1
SERVO_PWM: J_MCU_L.5, SERVO1.3
TB_AIN1: J_MCU_R.6, J_TB_L.3
TB_AIN2: J_MCU_R.10, J_TB_L.2
TB_AO1: J_TB_R.4, MOTO1.1
TB_AO2: J_TB_R.5, MOTO1.2
TB_PWMA: J_MCU_R.5, J_TB_L.1
TB_STBY: J_MCU_R.13, J_TB_L.4, R_STBY.1
VOICE_RX: JP_ASR_RX.1, J_MCU_R.8
VOICE_SPK_N: J_VOICE_R.7, SPK1.2
VOICE_SPK_P: J_VOICE_R.8, SPK1.1
VOICE_TX: JP_ASR_TX.1, J_MCU_R.7

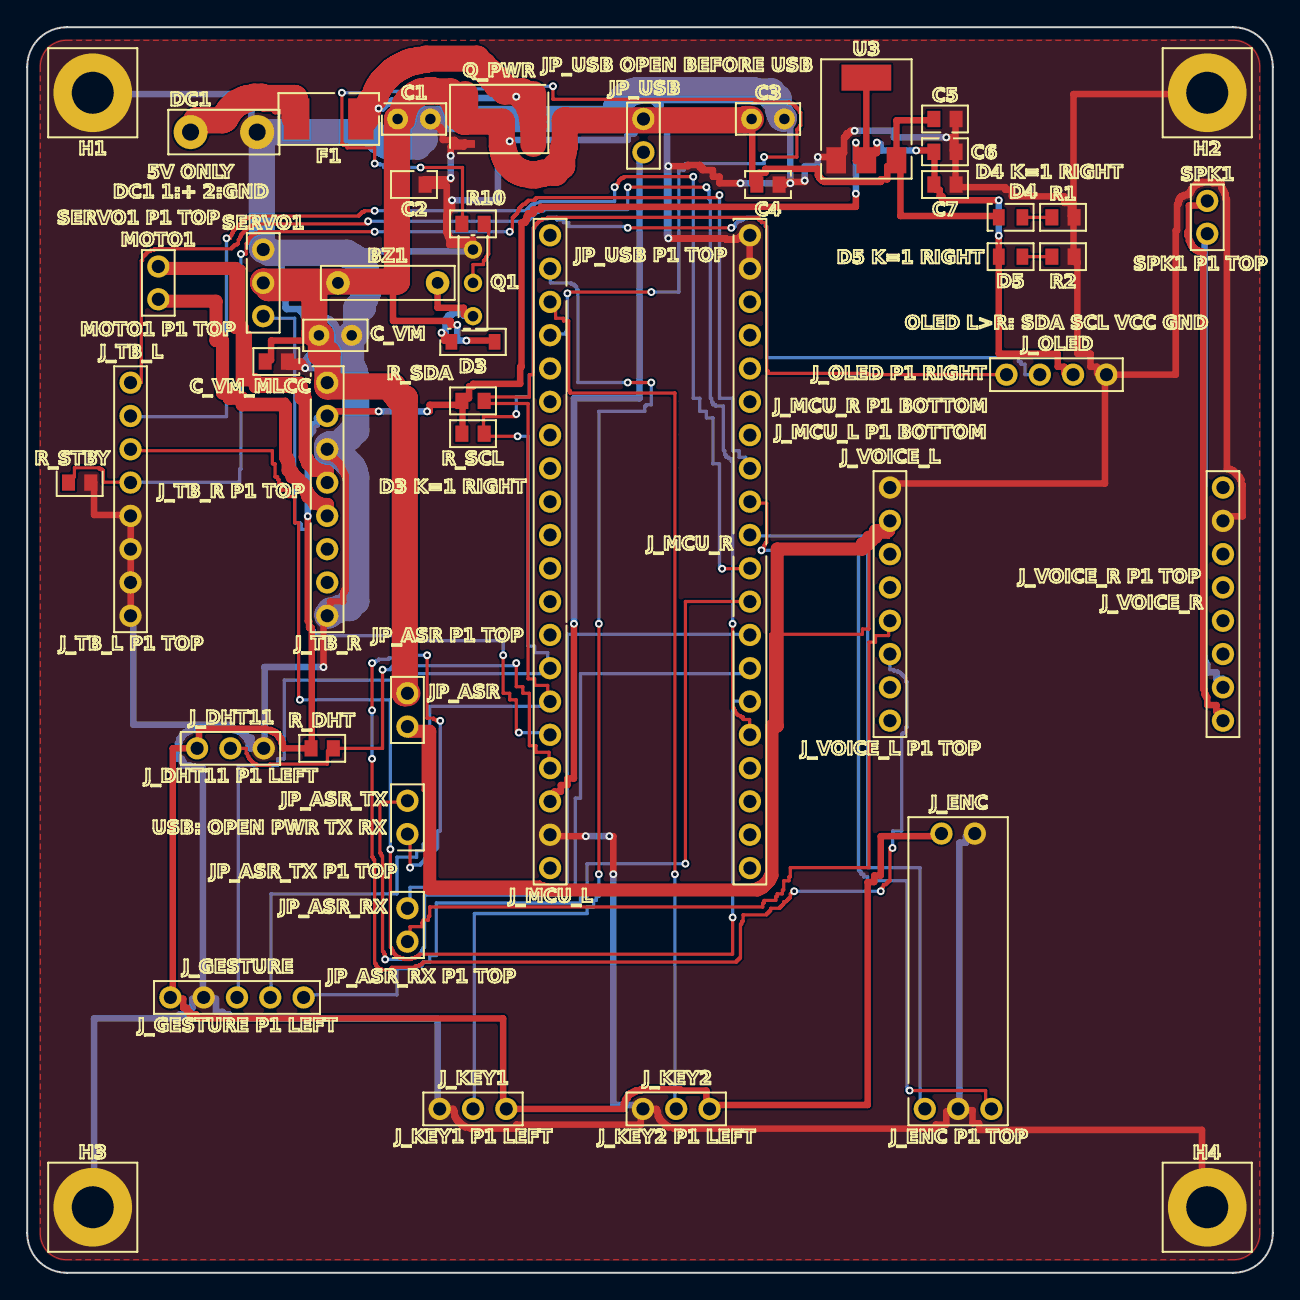
[picture p80: board fan_ctrl_revB.kicad_pcb from above]

Board: 2 copper layers, 95.0 x 95.0 mm, 48 parts (0 on the bottom side), 33 nets.

Other parts of the board:
H1: MountingHole_M3; Board_H1
H2: MountingHole_M3; Board_H2
H3: MountingHole_M3; Board_H3
H4: MountingHole_M3; Board_H4

Their connections:
GND: H1.1, H2.1, H3.1, H4.1; also elsewhere on the board
