Lucian-ming/smart-fans/references/01_bishe_voice_fan/firmware/Voice_Fan/Voice_Fan.ioc

Mcu.UserName=STM32F103C8Tx
PA0-WKUP.GPIO_Label=KEY1
PA0-WKUP.Signal=GPIO_Input
PA1.GPIO_Label=KEY2
PA1.Signal=GPIO_Input
PA13.Signal=SYS_JTMS-SWDIO
PA14.Signal=SYS_JTCK-SWCLK
PA2.GPIO_Label=KEY3
PA2.Signal=GPIO_Input
PA4.Signal=ADCx_IN4
PA5.Signal=ADCx_IN5
PA8.Signal=S_TIM1_CH1
PA9.Signal=S_TIM1_CH2
PB1.Signal=S_TIM3_CH4
PB10.Signal=USART3_TX
PB11.Signal=USART3_RX
PB12.GPIO_Label=LED1
PB12.Signal=GPIO_Output
PB13.GPIO_Label=LED2
PB13.Signal=GPIO_Output
PB6.Signal=USART1_TX
PB7.Signal=USART1_RX
PB8.Signal=I2C1_SCL
PB9.Signal=I2C1_SDA
PC13-TAMPER-RTC.GPIO_Label=TEST_LED
PC13-TAMPER-RTC.Signal=GPIO_Output
PC14-OSC32_IN.Signal=RCC_OSC32_IN
PC15-OSC32_OUT.Signal=RCC_OSC32_OUT
PD0-OSC_IN.Signal=RCC_OSC_IN
PD1-OSC_OUT.Signal=RCC_OSC_OUT
