Lucian-ming/smart-fans/references/01_bishe_voice_fan/firmware/Voice_Fan/Core/Inc/main.h

#define TEST_LED_Pin GPIO_PIN_13
#define TEST_LED_GPIO_Port GPIOC
#define KEY1_Pin GPIO_PIN_0
#define KEY1_GPIO_Port GPIOA
#define KEY2_Pin GPIO_PIN_1
#define KEY2_GPIO_Port GPIOA
#define KEY3_Pin GPIO_PIN_2
#define KEY3_GPIO_Port GPIOA
#define LED1_Pin GPIO_PIN_12
#define LED1_GPIO_Port GPIOB
#define LED2_Pin GPIO_PIN_13
#define LED2_GPIO_Port GPIOB
