Lucian-ming/smart-fans/references/01_bishe_voice_fan/firmware/Voice_Fan/MDK-ARM/APP/OLED/oled.h

#ifndef __oled_H__
#define __oled_H__

#include "system.h"

#define Start_Line 2   //0.96寸OLED为0,1.3寸为2
#define OLED_Maxline 144
#define OLED_MaxRow 64

void WriteCmd(void);
void OLED_WR_CMD(uint8_t cmd);
void OLED_WR_DATA(uint8_t data);
void OLED_Init(void);
void OLED_Clear(void);
void OLED_Display_On(void);
void OLED_Display_Off(void);
void OLED_Set_Pos(uint8_t x, uint8_t y);
void OLED_On(void);
void OLED_ShowNum(uint8_t x,uint8_t y,unsigned int num,uint8_t len,uint8_t size2);
void OLED_ShowChar(uint8_t x,uint8_t y,char chr,uint8_t Char_Size);
void OLED_ShowString(uint8_t x,uint8_t y,uint8_t *chr,uint8_t Char_Size);
void OLED_ShowCHinese(uint8_t x,uint8_t y,uint8_t no);

void One_Page(void);//首页显示湖南工业

#endif
