Lucian-ming/smart-fans/references/01_bishe_voice_fan/firmware/Voice_Fan/MDK-ARM/APP/NTC/NTC2Fen.c

#include "NTC2Fen.h"
#define  SIZE 166

static const int b[SIZE] = {
		-40, -39, -38, -37, -36, -35, -34, -33, -32, -31,
		-30, -29, -28, -27, -26, -25, -24, -23, -22, -21,
		-20, -19, -18, -17, -16, -15, -14, -13, -12, -11,
		-10, -9, -8, -7, -6, -5, -4, -3, -2, -1,
		0, 1, 2, 3, 4, 5, 6, 7, 8, 9,
		10, 11, 12, 13, 14, 15, 16, 17, 18, 19,
		20, 21, 22, 23, 24, 25, 26, 27, 28, 29,
		30, 31, 32, 33, 34, 35, 36, 37, 38, 39,
		40, 41, 42, 43, 44, 45, 46, 47, 48, 49,
		50, 51, 52, 53, 54, 55, 56, 57, 58, 59,
		60, 61, 62, 63, 64, 65, 66, 67, 68, 69,
		70, 71, 72, 73, 74, 75, 76, 77, 78, 79,
		80, 81, 82, 83, 84, 85, 86, 87, 88, 89,
		90, 91, 92, 93, 94, 95, 96, 97, 98, 99,
		100, 101, 102, 103, 104, 105, 106, 107, 108, 109,
		110, 111, 112, 113, 114, 115, 116, 117, 118, 119,           
		120, 121, 122, 123, 124, 125 };//定义温度数组
static const float a[SIZE] = {
		3.1851 , 3.1794 , 3.1731 , 3.1663 , 3.1589 , 3.1510 , 3.1425 , 3.1335 , 3.1238 , 3.1135 , 
		3.1027 , 3.0912 , 3.0792 , 3.0665 , 3.0532 , 3.0394 , 3.0249 , 3.0098 , 2.9942 , 2.9780 , 
		2.9613 , 2.9443 , 2.9269 , 2.9088 , 2.8902 , 2.8710 , 2.8512 , 2.8309 , 2.8099 , 2.7883 , 
		2.7662 , 2.7434 , 2.7199 , 2.6959 , 2.6712 , 2.6459 , 2.6200 , 2.5934 , 2.5662 , 2.5384 , 
		2.5100 , 2.4802 , 2.4498 , 2.4189 , 2.3874 , 2.3554 , 2.3229 , 2.2898 , 2.2564 , 2.2225 , 
		2.1882 , 2.1536 , 2.1186 , 2.0833 , 2.0478 , 2.0120 , 1.9760 , 1.9399 , 1.9037 , 1.8674 , 
		1.8311 , 1.7947 , 1.7584 , 1.7222 , 1.6860 , 1.6500 , 1.6142 , 1.5785 , 1.5431 , 1.5080 , 
		1.4732 , 1.4387 , 1.4046 , 1.3708 , 1.3375 , 1.3045 , 1.2721 , 1.2400 , 1.2085 , 1.1775 , 
		1.1470 , 1.1170 , 1.0875 , 1.0586 , 1.0302 , 1.0025 , 0.9752 , 0.9486 , 0.9225 , 0.8970 , 
		0.8721 , 0.8478 , 0.8240 , 0.8008 , 0.7782 , 0.7561 , 0.7346 , 0.7136 , 0.6932 , 0.6734 , 
		0.6540 , 0.6352 , 0.6169 , 0.5991 , 0.5818 , 0.5650 , 0.5487 , 0.5328 , 0.5174 , 0.5025 , 
		0.4880 , 0.4739 , 0.4602 , 0.4470 , 0.4341 , 0.4216 , 0.4095 , 0.3978 , 0.3864 , 0.3754 , 
		0.3647 , 0.3544 , 0.3443 , 0.3346 , 0.3252 , 0.3160 , 0.3073 , 0.2988 , 0.2905 , 0.2825 , 
		0.2748 , 0.2672 , 0.2599 , 0.2528 , 0.2459 , 0.2392 , 0.2327 , 0.2264 , 0.2203 , 0.2143 , 
		0.2085 , 0.2031 , 0.1978 , 0.1926 , 0.1876 , 0.1826 , 0.1778 , 0.1731 , 0.1685 , 0.1640 , 
		0.1596 , 0.1554 , 0.1512 , 0.1472 , 0.1433 , 0.1394 , 0.1357 , 0.1321 , 0.1286 , 0.1252 , 
		0.1219 , 0.1187 , 0.1155 , 0.1125 , 0.1096 , 0.1067 , };//定义AD值数组

int tempDetect(float n)
{
	int s=0,m=0,e=SIZE;

	if(n < 0.1067f)
	  return 125;
	else if(n > 3.1851f)
	  return -40;
	else 
	{
		while(s < e)//二分法进行查找
		{
			m = ((s+e)>>1);
			if(n < a[m])
				s = m+1;
			else 
				e = m;
		}
		return b[s];
	}
}
