Lucian-ming/smart-fans/tools/export_kicad_project.py

"""
Script: export_kicad_project.py
Generates a 100% clean, collision-free KiCad 8.x PCB project for Smart Fan.
- Removes colliding straight line tracks
- Removes bogus filled_polygon that shorts pads to GND
- Standard KiCad 8.x format fully compatible with EasyEDA Pro and KiCad 8
- Ready for 1-click Auto-Routing in EasyEDA Pro or direct Gerber export
"""
import os

PCB_DIR = "D:/smart_fans/hardware/kicad"
os.makedirs(PCB_DIR, exist_ok=True)

def generate_pcb():
    lines = [
        '(kicad_pcb',
        '	(version 20240108)',
        '	(generator "antigravity")',
        '	(generator_version "8.0")',
        '	(general',
        '		(thickness 1.6)',
        '		(legacy_teardrops no)',
        '	)',
        '	(paper "A4")',
        '	(title_block',
        '		(title "Smart Fan Controller Mainboard")',
        '		(date "2026-11-03")',
        '		(rev "revA_clean")',
        '		(company "Smart Fan Project")',
        '		(comment 1 "STM32F103 BluePill + 12025 PWM Fan + MG90S + ASR-PRO + PAJ7620 + OLED")',
        '		(comment 2 "Budget <= 200 CNY | JLC Free Coupon 100x100mm Compatible")',
        '	)',
        '	(layers',
        '		(0 "F.Cu" signal)',
        '		(31 "B.Cu" signal)',
        '		(32 "B.Adhes" user "B.Adhesive")',
        '		(33 "F.Adhes" user "F.Adhesive")',
        '		(34 "B.Paste" user)',
        '		(35 "F.Paste" user)',
        '		(36 "B.SilkS" user "B.Silkscreen")',
        '		(37 "F.SilkS" user "F.Silkscreen")',
        '		(38 "B.Mask" user)',
        '		(39 "F.Mask" user)',
        '		(40 "Dwgs.User" user "User.Drawings")',
        '		(41 "Cmts.User" user "User.Comments")',
        '		(42 "Eco1.User" user "User.Eco1")',
        '		(43 "Eco2.User" user "User.Eco2")',
        '		(44 "Edge.Cuts" user)',
        '		(45 "Margin" user)',
        '		(46 "B.CrtYd" user "B.Courtyard")',
        '		(47 "F.CrtYd" user "F.Courtyard")',
        '		(48 "B.Fab" user)',
        '		(49 "F.Fab" user)',
        '	)',
        '	(setup',
        '		(pad_to_mask_clearance 0.05)',
        '		(allow_soldermask_bridges_in_footprints no)',
        '		(pcbplotparams',
        '			(layerselection 0x00010fc_ffffffff)',
        '			(disableapertmacros no)',
        '			(usegerberextensions yes)',
        '			(usegerberattributes yes)',
        '			(usegerberadvancedattributes yes)',
        '			(creategerberjobfile yes)',
        '			(outputdirectory "fabrication/gerber/")',
        '		)',
        '	)',
        '	(net 0 "")',
        '	(net 1 "GND")',
        '	(net 2 "+12V_RAW")',
        '	(net 3 "+5V")',
        '	(net 4 "+3.3V")',
        '	(net 5 "FAN_PWM")',
        '	(net 6 "FAN_TACH")',
        '	(net 7 "TEMP_DATA")',
        '	(net 8 "SERVO_PWM")',
        '	(net 9 "I2C1_SCL")',
        '	(net 10 "I2C1_SDA")',
        '	(net 11 "GESTURE_INT")',
        '	(net 12 "ENC_A")',
        '	(net 13 "ENC_B")',
        '	(net 14 "ENC_SW")',
        '	(net 15 "BTN_MODE")',
        '	(net 16 "BTN_SWING")',
        '	(net 17 "BTN_AUX")',
        '	(net 18 "BUZZER_CTRL")',
        '	(net 19 "VOICE_TX")',
        '	(net 20 "VOICE_RX")',
        '	(net 21 "DEBUG_TX")',
        '	(net 22 "DEBUG_RX")',
        '	(net 23 "XL1509_SW")',
        '	(net 24 "BUZ_DRV")',
        '	(net 25 "FAN_PWM_DRV")',
        '',
        '	(gr_rect (start 100 100) (end 185 185)',
        '		(stroke (width 0.15) (type solid)) (fill none) (layer "Edge.Cuts")',
        '		(uuid "a1b2c3d4-0001-0001-0001-000000000001"))',
        '',
        '	(gr_text "Smart Fan Controller RevA" (at 142.5 103.5) (layer "F.SilkS")',
        '		(effects (font (size 1.2 1.2) (thickness 0.2))) (uuid "a1b2c3d4-0002-0001-0001-000000000002"))',
        '	(gr_text "Size: 85x85mm | Budget <= 200 CNY" (at 142.5 106) (layer "F.SilkS")',
        '		(effects (font (size 0.9 0.9) (thickness 0.15))) (uuid "a1b2c3d4-0002-0001-0001-000000000003"))',
        '	(gr_text "Designed for JLC Free Coupon" (at 142.5 108.5) (layer "F.SilkS")',
        '		(effects (font (size 0.8 0.8) (thickness 0.12))) (uuid "a1b2c3d4-0002-0001-0001-000000000004"))',
        '',
        '	(footprint "MountingHole:MountingHole_3.2mm_M3"',
        '		(layer "F.Cu") (uuid "b1000000-0001-0000-0000-000000000001") (at 105 105)',
        '		(fp_text reference "H1" (at 0 -2.5) (layer "F.SilkS") (effects (font (size 0.8 0.8) (thickness 0.15))))',
        '		(pad "1" thru_hole circle (at 0 0) (size 5.5 5.5) (drill 3.2) (layers "*.Cu" "*.Mask") (net 1 "GND"))',
        '		(fp_circle (center 0 0) (end 3.2 0) (stroke (width 0.15) (type solid)) (layer "F.SilkS"))',
        '	)',
        '	(footprint "MountingHole:MountingHole_3.2mm_M3"',
        '		(layer "F.Cu") (uuid "b1000000-0001-0000-0000-000000000002") (at 180 105)',
        '		(fp_text reference "H2" (at 0 -2.5) (layer "F.SilkS") (effects (font (size 0.8 0.8) (thickness 0.15))))',
        '		(pad "1" thru_hole circle (at 0 0) (size 5.5 5.5) (drill 3.2) (layers "*.Cu" "*.Mask") (net 1 "GND"))',
        '		(fp_circle (center 0 0) (end 3.2 0) (stroke (width 0.15) (type solid)) (layer "F.SilkS"))',
        '	)',
        '	(footprint "MountingHole:MountingHole_3.2mm_M3"',
        '		(layer "F.Cu") (uuid "b1000000-0001-0000-0000-000000000003") (at 105 180)',
        '		(fp_text reference "H3" (at 0 -2.5) (layer "F.SilkS") (effects (font (size 0.8 0.8) (thickness 0.15))))',
        '		(pad "1" thru_hole circle (at 0 0) (size 5.5 5.5) (drill 3.2) (layers "*.Cu" "*.Mask") (net 1 "GND"))',
        '		(fp_circle (center 0 0) (end 3.2 0) (stroke (width 0.15) (type solid)) (layer "F.SilkS"))',
        '	)',
        '	(footprint "MountingHole:MountingHole_3.2mm_M3"',
        '		(layer "F.Cu") (uuid "b1000000-0001-0000-0000-000000000004") (at 180 180)',
        '		(fp_text reference "H4" (at 0 -2.5) (layer "F.SilkS") (effects (font (size 0.8 0.8) (thickness 0.15))))',
        '		(pad "1" thru_hole circle (at 0 0) (size 5.5 5.5) (drill 3.2) (layers "*.Cu" "*.Mask") (net 1 "GND"))',
        '		(fp_circle (center 0 0) (end 3.2 0) (stroke (width 0.15) (type solid)) (layer "F.SilkS"))',
        '	)',
        '',
        '	(footprint "Connector_BarrelJack:BarrelJack_Horizontal"',
        '		(layer "F.Cu") (uuid "c1000000-0001-0000-0000-000000000005") (at 118 104)',
        '		(fp_text reference "DC1" (at 0 -3.5) (layer "F.SilkS") (effects (font (size 0.8 0.8) (thickness 0.15))))',
        '		(fp_text value "DC-005_12V" (at 0 3.5) (layer "F.SilkS") (effects (font (size 0.8 0.8) (thickness 0.15))))',
        '		(pad "1" thru_hole rect (at 0 0) (size 2.8 2.0) (drill 1.2) (layers "*.Cu" "*.Mask") (net 2 "+12V_RAW"))',
        '		(pad "2" thru_hole circle (at 0 4.7) (size 2.5 2.0) (drill 1.2) (layers "*.Cu" "*.Mask") (net 1 "GND"))',
        '		(pad "3" thru_hole circle (at 4.7 0) (size 2.5 2.0) (drill 1.2) (layers "*.Cu" "*.Mask") (net 1 "GND"))',
        '	)',
        '',
        '	(footprint "Diode_SMD:D_SMA"',
        '		(layer "F.Cu") (uuid "c1000000-0001-0000-0000-000000000006") (at 130 104)',
        '		(fp_text reference "D2" (at 0 -2.2) (layer "F.SilkS") (effects (font (size 0.8 0.8) (thickness 0.15))))',
        '		(pad "1" smd rect (at -2.0 0) (size 1.5 1.5) (layers "F.Cu" "F.Paste" "F.Mask") (net 2 "+12V_RAW"))',
        '		(pad "2" smd rect (at 2.0 0) (size 1.5 1.5) (layers "F.Cu" "F.Paste" "F.Mask") (net 2 "+12V_RAW"))',
        '	)',
        '',
        '	(footprint "Capacitor_THT:CP_Radial_D8.0mm_P3.50mm"',
        '		(layer "F.Cu") (uuid "c1000000-0001-0000-0000-000000000007") (at 122 112)',
        '		(fp_text reference "C1" (at 0 -4.5) (layer "F.SilkS") (effects (font (size 0.8 0.8) (thickness 0.15))))',
        '		(pad "1" thru_hole rect (at -1.75 0) (size 2.0 2.0) (drill 1.0) (layers "*.Cu" "*.Mask") (net 2 "+12V_RAW"))',
        '		(pad "2" thru_hole circle (at 1.75 0) (size 2.0 2.0) (drill 1.0) (layers "*.Cu" "*.Mask") (net 1 "GND"))',
        '	)',
        '	(footprint "Capacitor_SMD:C_0805_2012Metric"',
        '		(layer "F.Cu") (uuid "c1000000-0001-0000-0000-000000000008") (at 122 118)',
        '		(fp_text reference "C2" (at 0 -1.8) (layer "F.SilkS") (effects (font (size 0.8 0.8) (thickness 0.15))))',
        '		(pad "1" smd roundrect (at -0.95 0) (size 1.0 1.3) (layers "F.Cu" "F.Paste" "F.Mask") (net 2 "+12V_RAW"))',
        '		(pad "2" smd roundrect (at 0.95 0) (size 1.0 1.3) (layers "F.Cu" "F.Paste" "F.Mask") (net 1 "GND"))',
        '	)',
        '',
        '	(footprint "Package_SO:SOIC-8_3.9x4.9mm_P1.27mm"',
        '		(layer "F.Cu") (uuid "c1000000-0001-0000-0000-000000000009") (at 114 126)',
        '		(fp_text reference "U2" (at 0 -3.2) (layer "F.SilkS") (effects (font (size 0.9 0.9) (thickness 0.15))))',
        '		(fp_text value "XL1509-5.0" (at 0 3.2) (layer "F.SilkS") (effects (font (size 0.8 0.8) (thickness 0.15))))',
        '		(pad "1" smd rect (at -2.6 -1.905) (size 1.2 0.6) (layers "F.Cu" "F.Paste" "F.Mask") (net 2 "+12V_RAW"))',
        '		(pad "2" smd rect (at -2.6 -0.635) (size 1.2 0.6) (layers "F.Cu" "F.Paste" "F.Mask") (net 23 "XL1509_SW"))',
        '		(pad "3" smd rect (at -2.6 0.635) (size 1.2 0.6) (layers "F.Cu" "F.Paste" "F.Mask") (net 3 "+5V"))',
        '		(pad "4" smd rect (at -2.6 1.905) (size 1.2 0.6) (layers "F.Cu" "F.Paste" "F.Mask") (net 1 "GND"))',
        '		(pad "5" smd rect (at 2.6 1.905) (size 1.2 0.6) (layers "F.Cu" "F.Paste" "F.Mask") (net 1 "GND"))',
        '		(pad "6" smd rect (at 2.6 0.635) (size 1.2 0.6) (layers "F.Cu" "F.Paste" "F.Mask") (net 1 "GND"))',
        '		(pad "7" smd rect (at 2.6 -0.635) (size 1.2 0.6) (layers "F.Cu" "F.Paste" "F.Mask") (net 1 "GND"))',
        '		(pad "8" smd rect (at 2.6 -1.905) (size 1.2 0.6) (layers "F.Cu" "F.Paste" "F.Mask") (net 1 "GND"))',
        '	)',
        '',
        '	(footprint "Diode_SMD:D_SMA"',
        '		(layer "F.Cu") (uuid "c1000000-0001-0000-0000-000000000010") (at 108 126)',
        '		(fp_text reference "D1" (at 0 -2.2) (layer "F.SilkS") (effects (font (size 0.8 0.8) (thickness 0.15))))',
        '		(pad "1" smd rect (at 0 -2.0) (size 1.5 1.5) (layers "F.Cu" "F.Paste" "F.Mask") (net 23 "XL1509_SW"))',
        '		(pad "2" smd rect (at 0 2.0) (size 1.5 1.5) (layers "F.Cu" "F.Paste" "F.Mask") (net 1 "GND"))',
        '	)',
        '',
        '	(footprint "Inductor_SMD:L_CD75"',
        '		(layer "F.Cu") (uuid "c1000000-0001-0000-0000-000000000011") (at 114 136)',
        '		(fp_text reference "L1" (at 0 -4.5) (layer "F.SilkS") (effects (font (size 0.9 0.9) (thickness 0.15))))',
        '		(fp_text value "47uH_CD75" (at 0 4.5) (layer "F.SilkS") (effects (font (size 0.8 0.8) (thickness 0.15))))',
        '		(pad "1" smd rect (at -2.8 0) (size 2.5 3.0) (layers "F.Cu" "F.Paste" "F.Mask") (net 23 "XL1509_SW"))',
        '		(pad "2" smd rect (at 2.8 0) (size 2.5 3.0) (layers "F.Cu" "F.Paste" "F.Mask") (net 3 "+5V"))',
        '	)',
        '',
        '	(footprint "Capacitor_THT:CP_Radial_D8.0mm_P3.50mm"',
        '		(layer "F.Cu") (uuid "c1000000-0001-0000-0000-000000000012") (at 108 144)',
        '		(fp_text reference "C3" (at 0 -4.5) (layer "F.SilkS") (effects (font (size 0.8 0.8) (thickness 0.15))))',
        '		(pad "1" thru_hole rect (at -1.75 0) (size 2.0 2.0) (drill 1.0) (layers "*.Cu" "*.Mask") (net 3 "+5V"))',
        '		(pad "2" thru_hole circle (at 1.75 0) (size 2.0 2.0) (drill 1.0) (layers "*.Cu" "*.Mask") (net 1 "GND"))',
        '	)',
        '	(footprint "Capacitor_SMD:C_0805_2012Metric"',
        '		(layer "F.Cu") (uuid "c1000000-0001-0000-0000-000000000013") (at 118 144)',
        '		(fp_text reference "C4" (at 0 -1.8) (layer "F.SilkS") (effects (font (size 0.8 0.8) (thickness 0.15))))',
        '		(pad "1" smd roundrect (at -0.95 0) (size 1.0 1.3) (layers "F.Cu" "F.Paste" "F.Mask") (net 3 "+5V"))',
        '		(pad "2" smd roundrect (at 0.95 0) (size 1.0 1.3) (layers "F.Cu" "F.Paste" "F.Mask") (net 1 "GND"))',
        '	)',
        '',
        '	(footprint "Package_TO_SOT_SMD:SOT-223-3_TabPin2"',
        '		(layer "F.Cu") (uuid "c1000000-0001-0000-0000-000000000014") (at 112 154)',
        '		(fp_text reference "U3" (at 0 -3.8) (layer "F.SilkS") (effects (font (size 0.9 0.9) (thickness 0.15))))',
        '		(pad "1" smd rect (at -2.3 -2.8) (size 1.0 1.8) (layers "F.Cu" "F.Paste" "F.Mask") (net 1 "GND"))',
        '		(pad "2" smd rect (at 0 -2.8) (size 1.0 1.8) (layers "F.Cu" "F.Paste" "F.Mask") (net 4 "+3.3V"))',
        '		(pad "3" smd rect (at 2.3 -2.8) (size 1.0 1.8) (layers "F.Cu" "F.Paste" "F.Mask") (net 3 "+5V"))',
        '		(pad "4" smd rect (at 0 2.8) (size 3.3 1.8) (layers "F.Cu" "F.Paste" "F.Mask") (net 4 "+3.3V"))',
        '	)',
        '	(footprint "Capacitor_SMD:C_0805_2012Metric"',
        '		(layer "F.Cu") (uuid "c1000000-0001-0000-0000-000000000015") (at 118 152)',
        '		(fp_text reference "C5" (at 0 -1.8) (layer "F.SilkS") (effects (font (size 0.8 0.8) (thickness 0.15))))',
        '		(pad "1" smd roundrect (at -0.95 0) (size 1.0 1.3) (layers "F.Cu" "F.Paste" "F.Mask") (net 3 "+5V"))',
        '		(pad "2" smd roundrect (at 0.95 0) (size 1.0 1.3) (layers "F.Cu" "F.Paste" "F.Mask") (net 1 "GND"))',
        '	)',
        '	(footprint "Capacitor_SMD:C_0805_2012Metric"',
        '		(layer "F.Cu") (uuid "c1000000-0001-0000-0000-000000000016") (at 118 156)',
        '		(fp_text reference "C6" (at 0 -1.8) (layer "F.SilkS") (effects (font (size 0.8 0.8) (thickness 0.15))))',
        '		(pad "1" smd roundrect (at -0.95 0) (size 1.0 1.3) (layers "F.Cu" "F.Paste" "F.Mask") (net 4 "+3.3V"))',
        '		(pad "2" smd roundrect (at 0.95 0) (size 1.0 1.3) (layers "F.Cu" "F.Paste" "F.Mask") (net 1 "GND"))',
        '	)',
        '	(footprint "LED_SMD:LED_0805_2012Metric"',
        '		(layer "F.Cu") (uuid "c1000000-0001-0000-0000-000000000017") (at 126 136)',
        '		(fp_text reference "D4" (at 0 -1.8) (layer "F.SilkS") (effects (font (size 0.8 0.8) (thickness 0.15))))',
        '		(pad "1" smd rect (at -1.0 0) (size 1.0 1.2) (layers "F.Cu" "F.Paste" "F.Mask") (net 3 "+5V"))',
        '		(pad "2" smd rect (at 1.0 0) (size 1.0 1.2) (layers "F.Cu" "F.Paste" "F.Mask") (net 1 "GND"))',
        '	)',
        '	(footprint "LED_SMD:LED_0805_2012Metric"',
        '		(layer "F.Cu") (uuid "c1000000-0001-0000-0000-000000000018") (at 126 154)',
        '		(fp_text reference "D5" (at 0 -1.8) (layer "F.SilkS") (effects (font (size 0.8 0.8) (thickness 0.15))))',
        '		(pad "1" smd rect (at -1.0 0) (size 1.0 1.2) (layers "F.Cu" "F.Paste" "F.Mask") (net 4 "+3.3V"))',
        '		(pad "2" smd rect (at 1.0 0) (size 1.0 1.2) (layers "F.Cu" "F.Paste" "F.Mask") (net 1 "GND"))',
        '	)',
        '',
        '	(footprint "Connector_PinHeader_2.54mm:PinHeader_1x03_P2.54mm_Vertical"',
        '		(layer "F.Cu") (uuid "c1000000-0001-0000-0000-000000000019") (at 105 156)',
        '		(fp_text reference "SENS1" (at 0 -2.5) (layer "F.SilkS") (effects (font (size 0.8 0.8) (thickness 0.15))))',
        '		(fp_text value "DS18B20" (at 0 8.0) (layer "F.SilkS") (effects (font (size 0.8 0.8) (thickness 0.15))))',
        '		(pad "1" thru_hole rect (at 0 0) (size 1.8 1.8) (drill 1.0) (layers "*.Cu" "*.Mask") (net 1 "GND"))',
        '		(pad "2" thru_hole circle (at 0 2.54) (size 1.8 1.8) (drill 1.0) (layers "*.Cu" "*.Mask") (net 7 "TEMP_DATA"))',
        '		(pad "3" thru_hole circle (at 0 5.08) (size 1.8 1.8) (drill 1.0) (layers "*.Cu" "*.Mask") (net 4 "+3.3V"))',
        '	)',
        '',
        '	(footprint "Buzzer_Beeper:Buzzer_12x9.5RM7.6"',
        '		(layer "F.Cu") (uuid "c1000000-0001-0000-0000-000000000020") (at 108 172)',
        '		(fp_text reference "BZ1" (at 0 -4.5) (layer "F.SilkS") (effects (font (size 0.8 0.8) (thickness 0.15))))',
        '		(pad "1" thru_hole rect (at 0 -3.8) (size 2.0 2.0) (drill 1.0) (layers "*.Cu" "*.Mask") (net 3 "+5V"))',
        '		(pad "2" thru_hole circle (at 0 3.8) (size 2.0 2.0) (drill 1.0) (layers "*.Cu" "*.Mask") (net 24 "BUZ_DRV"))',
        '	)',
        '	(footprint "Package_TO_SOT_THT:TO-92_Inline"',
        '		(layer "F.Cu") (uuid "c1000000-0001-0000-0000-000000000021") (at 116 172)',
        '		(fp_text reference "Q1" (at 0 -2.5) (layer "F.SilkS") (effects (font (size 0.8 0.8) (thickness 0.15))))',
        '		(pad "1" thru_hole rect (at -1.27 0) (size 1.0 1.4) (drill 0.65) (layers "*.Cu" "*.Mask") (net 18 "BUZZER_CTRL"))',
        '		(pad "2" thru_hole oval (at 0 0) (size 1.0 1.4) (drill 0.65) (layers "*.Cu" "*.Mask") (net 1 "GND"))',
        '		(pad "3" thru_hole oval (at 1.27 0) (size 1.0 1.4) (drill 0.65) (layers "*.Cu" "*.Mask") (net 24 "BUZ_DRV"))',
        '	)',
        '	(footprint "Diode_SMD:D_SOD-123"',
        '		(layer "F.Cu") (uuid "c1000000-0001-0000-0000-000000000022") (at 116 176)',
        '		(fp_text reference "D3" (at 0 -1.8) (layer "F.SilkS") (effects (font (size 0.8 0.8) (thickness 0.15))))',
        '		(pad "1" smd rect (at -1.65 0) (size 0.9 1.2) (layers "F.Cu" "F.Paste" "F.Mask") (net 3 "+5V"))',
        '		(pad "2" smd rect (at 1.65 0) (size 0.9 1.2) (layers "F.Cu" "F.Paste" "F.Mask") (net 24 "BUZ_DRV"))',
        '	)',
        '',
        '	(footprint "Connector_Molex:Molex_KK-254_AE-6410-04A_1x04_P2.54mm_Vertical"',
        '		(layer "F.Cu") (uuid "c1000000-0001-0000-0000-000000000023") (at 174 112)',
        '		(fp_text reference "FAN1" (at 0 -3.0) (layer "F.SilkS") (effects (font (size 0.9 0.9) (thickness 0.15))))',
        '		(fp_text value "12025_PWM_FAN" (at 0 11.5) (layer "F.SilkS") (effects (font (size 0.8 0.8) (thickness 0.15))))',
        '		(pad "1" thru_hole rect (at 0 0) (size 2.0 2.0) (drill 1.1) (layers "*.Cu" "*.Mask") (net 1 "GND"))',
        '		(pad "2" thru_hole circle (at 0 2.54) (size 2.0 2.0) (drill 1.1) (layers "*.Cu" "*.Mask") (net 2 "+12V_RAW"))',
        '		(pad "3" thru_hole circle (at 0 5.08) (size 2.0 2.0) (drill 1.1) (layers "*.Cu" "*.Mask") (net 6 "FAN_TACH"))',
        '		(pad "4" thru_hole circle (at 0 7.62) (size 2.0 2.0) (drill 1.1) (layers "*.Cu" "*.Mask") (net 25 "FAN_PWM_DRV"))',
        '	)',
        '	(footprint "Package_TO_SOT_SMD:SOT-23"',
        '		(layer "F.Cu") (uuid "c1000000-0001-0000-0000-000000000024") (at 166 114)',
        '		(fp_text reference "Q2" (at 0 -2.5) (layer "F.SilkS") (effects (font (size 0.8 0.8) (thickness 0.15))))',
        '		(fp_text value "AO3400A" (at 0 2.5) (layer "F.SilkS") (effects (font (size 0.8 0.8) (thickness 0.15))))',
        '		(pad "1" smd rect (at -0.95 -1.0) (size 0.8 0.9) (layers "F.Cu" "F.Paste" "F.Mask") (net 5 "FAN_PWM"))',
        '		(pad "2" smd rect (at 0.95 -1.0) (size 0.8 0.9) (layers "F.Cu" "F.Paste" "F.Mask") (net 1 "GND"))',
        '		(pad "3" smd rect (at 0 1.0) (size 0.8 0.9) (layers "F.Cu" "F.Paste" "F.Mask") (net 25 "FAN_PWM_DRV"))',
        '	)',
        '',
        '	(footprint "Connector_PinHeader_2.54mm:PinHeader_1x03_P2.54mm_Vertical"',
        '		(layer "F.Cu") (uuid "c1000000-0001-0000-0000-000000000025") (at 174 126)',
        '		(fp_text reference "SERVO1" (at 0 -2.5) (layer "F.SilkS") (effects (font (size 0.8 0.8) (thickness 0.15))))',
        '		(pad "1" thru_hole rect (at 0 0) (size 1.8 1.8) (drill 1.0) (layers "*.Cu" "*.Mask") (net 1 "GND"))',
        '		(pad "2" thru_hole circle (at 0 2.54) (size 1.8 1.8) (drill 1.0) (layers "*.Cu" "*.Mask") (net 3 "+5V"))',
        '		(pad "3" thru_hole circle (at 0 5.08) (size 1.8 1.8) (drill 1.0) (layers "*.Cu" "*.Mask") (net 8 "SERVO_PWM"))',
        '	)',
        '',
        '	(footprint "Connector_PinSocket_2.54mm:PinSocket_1x04_P2.54mm_Vertical"',
        '		(layer "F.Cu") (uuid "c1000000-0001-0000-0000-000000000026") (at 162 136)',
        '		(fp_text reference "J3_VOICE" (at 0 -2.5) (layer "F.SilkS") (effects (font (size 0.8 0.8) (thickness 0.15))))',
        '		(pad "1" thru_hole rect (at 0 0) (size 1.8 1.8) (drill 1.0) (layers "*.Cu" "*.Mask") (net 3 "+5V"))',
        '		(pad "2" thru_hole circle (at 0 2.54) (size 1.8 1.8) (drill 1.0) (layers "*.Cu" "*.Mask") (net 1 "GND"))',
        '		(pad "3" thru_hole circle (at 0 5.08) (size 1.8 1.8) (drill 1.0) (layers "*.Cu" "*.Mask") (net 20 "VOICE_RX"))',
        '		(pad "4" thru_hole circle (at 0 7.62) (size 1.8 1.8) (drill 1.0) (layers "*.Cu" "*.Mask") (net 19 "VOICE_TX"))',
        '	)',
        '	(footprint "Connector_PinSocket_2.54mm:PinSocket_1x08_P2.54mm_Vertical"',
        '		(layer "F.Cu") (uuid "c1000000-0001-0000-0000-000000000027") (at 174 136)',
        '		(fp_text reference "J4_VOICE" (at 0 -2.5) (layer "F.SilkS") (effects (font (size 0.8 0.8) (thickness 0.15))))',
        '		(pad "1" thru_hole rect (at 0 0) (size 1.8 1.8) (drill 1.0) (layers "*.Cu" "*.Mask") (net 1 "GND"))',
        '		(pad "2" thru_hole circle (at 0 2.54) (size 1.8 1.8) (drill 1.0) (layers "*.Cu" "*.Mask") (net 0 ""))',
        '		(pad "3" thru_hole circle (at 0 5.08) (size 1.8 1.8) (drill 1.0) (layers "*.Cu" "*.Mask") (net 0 ""))',
        '		(pad "4" thru_hole circle (at 0 7.62) (size 1.8 1.8) (drill 1.0) (layers "*.Cu" "*.Mask") (net 0 ""))',
        '		(pad "5" thru_hole circle (at 0 10.16) (size 1.8 1.8) (drill 1.0) (layers "*.Cu" "*.Mask") (net 0 ""))',
        '		(pad "6" thru_hole circle (at 0 12.70) (size 1.8 1.8) (drill 1.0) (layers "*.Cu" "*.Mask") (net 0 ""))',
        '		(pad "7" thru_hole circle (at 0 15.24) (size 1.8 1.8) (drill 1.0) (layers "*.Cu" "*.Mask") (net 0 ""))',
        '		(pad "8" thru_hole circle (at 0 17.78) (size 1.8 1.8) (drill 1.0) (layers "*.Cu" "*.Mask") (net 3 "+5V"))',
        '	)',
        '',
        '	(footprint "Connector_PinHeader_2.54mm:PinHeader_1x02_P2.54mm_Vertical"',
        '		(layer "F.Cu") (uuid "c1000000-0001-0000-0000-000000000028") (at 158 158)',
        '		(fp_text reference "SPK1" (at 0 -2.5) (layer "F.SilkS") (effects (font (size 0.8 0.8) (thickness 0.15))))',
        '		(pad "1" thru_hole rect (at 0 0) (size 1.8 1.8) (drill 1.0) (layers "*.Cu" "*.Mask") (net 0 ""))',
        '		(pad "2" thru_hole circle (at 0 2.54) (size 1.8 1.8) (drill 1.0) (layers "*.Cu" "*.Mask") (net 0 ""))',
        '	)',
        '	(footprint "Connector_PinHeader_2.54mm:PinHeader_1x02_P2.54mm_Vertical"',
        '		(layer "F.Cu") (uuid "c1000000-0001-0000-0000-000000000029") (at 164 158)',
        '		(fp_text reference "MIC1" (at 0 -2.5) (layer "F.SilkS") (effects (font (size 0.8 0.8) (thickness 0.15))))',
        '		(pad "1" thru_hole rect (at 0 0) (size 1.8 1.8) (drill 1.0) (layers "*.Cu" "*.Mask") (net 0 ""))',
        '		(pad "2" thru_hole circle (at 0 2.54) (size 1.8 1.8) (drill 1.0) (layers "*.Cu" "*.Mask") (net 0 ""))',
        '	)',
        '',
        '	(footprint "Connector_PinSocket_2.54mm:PinSocket_1x20_P2.54mm_Vertical"',
        '		(layer "F.Cu") (uuid "c1000000-0001-0000-0000-000000000030") (at 134.38 116)',
        '		(fp_text reference "J1_MCU_L" (at -2 24 90) (layer "F.SilkS") (effects (font (size 1 1) (thickness 0.15))))',
        '		(fp_text value "BluePill_Left" (at 0 -2.5) (layer "F.SilkS") (effects (font (size 0.8 0.8) (thickness 0.15))))'
    ]

    j1_pinout = [
        (1, 0, "VBAT"), (2, 0, "PC13"), (3, 0, "PC14"), (4, 0, "PC15"),
        (5, 5, "FAN_PWM"), (6, 0, "PA1"), (7, 7, "TEMP_DATA"), (8, 19, "VOICE_TX"),
        (9, 20, "VOICE_RX"), (10, 11, "GESTURE_INT"), (11, 12, "ENC_A"), (12, 0, "PA6"),
        (13, 13, "ENC_B"), (14, 17, "BTN_AUX"), (15, 4, "+3.3V"), (16, 0, "NRST"),
        (17, 0, "PB11"), (18, 0, "PB10"), (19, 1, "GND"), (20, 1, "GND")
    ]
    for pidx, nid, nname in j1_pinout:
        yoff = (pidx - 1) * 2.54
        pshape = "rect" if pidx == 1 else "circle"
        nstr = f'(net {nid} "{nname}")' if nid > 0 else ''
        lines.append(f'		(pad "{pidx}" thru_hole {pshape} (at 0 {yoff:.2f}) (size 1.8 1.8) (drill 1.0) (layers "*.Cu" "*.Mask") {nstr})')
    lines.append('	)')

    lines.append('	(footprint "Connector_PinSocket_2.54mm:PinSocket_1x20_P2.54mm_Vertical"')
    lines.append('		(layer "F.Cu") (uuid "c1000000-0001-0000-0000-000000000031") (at 149.62 116)')
    lines.append('		(fp_text reference "J2_MCU_R" (at 2 24 90) (layer "F.SilkS") (effects (font (size 1 1) (thickness 0.15))))')
    lines.append('		(fp_text value "BluePill_Right" (at 0 -2.5) (layer "F.SilkS") (effects (font (size 0.8 0.8) (thickness 0.15))))')
    j2_pinout = [
        (1, 4, "+3.3V"), (2, 1, "GND"), (3, 3, "+5V"), (4, 0, "PB9"),
        (5, 8, "SERVO_PWM"), (6, 10, "I2C1_SDA"), (7, 9, "I2C1_SCL"), (8, 0, "PB5"),
        (9, 0, "PB4"), (10, 0, "PB3"), (11, 0, "PA15"), (12, 0, "PA12"),
        (13, 0, "PA11"), (14, 22, "DEBUG_RX"), (15, 21, "DEBUG_TX"), (16, 6, "FAN_TACH"),
        (17, 16, "BTN_SWING"), (18, 18, "BUZZER_CTRL"), (19, 15, "BTN_MODE"), (20, 14, "ENC_SW")
    ]
    for pidx, nid, nname in j2_pinout:
        yoff = (pidx - 1) * 2.54
        pshape = "rect" if pidx == 1 else "circle"
        nstr = f'(net {nid} "{nname}")' if nid > 0 else ''
        lines.append(f'		(pad "{pidx}" thru_hole {pshape} (at 0 {yoff:.2f}) (size 1.8 1.8) (drill 1.0) (layers "*.Cu" "*.Mask") {nstr})')
    lines.append('	)')

    # Front Panel UI Components (Y = 177)
    # J5 (OLED)
    lines.extend([
        '	(footprint "Connector_PinSocket_2.54mm:PinSocket_1x04_P2.54mm_Vertical"',
        '		(layer "F.Cu") (uuid "c1000000-0001-0000-0000-000000000032") (at 120 177)',
        '		(fp_text reference "J5_OLED" (at 3.8 -2.5) (layer "F.SilkS") (effects (font (size 0.9 0.9) (thickness 0.15))))',
        '		(pad "1" thru_hole rect (at 0 0) (size 1.8 1.8) (drill 1.0) (layers "*.Cu" "*.Mask") (net 1 "GND"))',
        '		(pad "2" thru_hole circle (at 2.54 0) (size 1.8 1.8) (drill 1.0) (layers "*.Cu" "*.Mask") (net 4 "+3.3V"))',
        '		(pad "3" thru_hole circle (at 5.08 0) (size 1.8 1.8) (drill 1.0) (layers "*.Cu" "*.Mask") (net 9 "I2C1_SCL"))',
        '		(pad "4" thru_hole circle (at 7.62 0) (size 1.8 1.8) (drill 1.0) (layers "*.Cu" "*.Mask") (net 10 "I2C1_SDA"))',
        '	)',
        '	(footprint "Connector_PinSocket_2.54mm:PinSocket_1x05_P2.54mm_Vertical"',
        '		(layer "F.Cu") (uuid "c1000000-0001-0000-0000-000000000033") (at 132 177)',
        '		(fp_text reference "J6_GESTURE" (at 5 -2.5) (layer "F.SilkS") (effects (font (size 0.9 0.9) (thickness 0.15))))',
        '		(pad "1" thru_hole rect (at 0 0) (size 1.8 1.8) (drill 1.0) (layers "*.Cu" "*.Mask") (net 4 "+3.3V"))',
        '		(pad "2" thru_hole circle (at 2.54 0) (size 1.8 1.8) (drill 1.0) (layers "*.Cu" "*.Mask") (net 1 "GND"))',
        '		(pad "3" thru_hole circle (at 5.08 0) (size 1.8 1.8) (drill 1.0) (layers "*.Cu" "*.Mask") (net 9 "I2C1_SCL"))',
        '		(pad "4" thru_hole circle (at 7.62 0) (size 1.8 1.8) (drill 1.0) (layers "*.Cu" "*.Mask") (net 10 "I2C1_SDA"))',
        '		(pad "5" thru_hole circle (at 10.16 0) (size 1.8 1.8) (drill 1.0) (layers "*.Cu" "*.Mask") (net 11 "GESTURE_INT"))',
        '	)',
        '	(footprint "Button_Switch_THT:SW_PUSH_6mm"',
        '		(layer "F.Cu") (uuid "c1000000-0001-0000-0000-000000000034") (at 146 177 90)',
        '		(fp_text reference "KEY1" (at 0 -3.8 90) (layer "F.SilkS") (effects (font (size 0.8 0.8) (thickness 0.15))))',
        '		(fp_text value "MODE" (at 0 3.8 90) (layer "F.SilkS") (effects (font (size 0.7 0.7) (thickness 0.12))))',
        '		(pad "1" thru_hole circle (at -3.25 -2.25 90) (size 1.5 1.5) (drill 1.0) (layers "*.Cu" "*.Mask") (net 15 "BTN_MODE"))',
        '		(pad "2" thru_hole circle (at 3.25 -2.25 90) (size 1.5 1.5) (drill 1.0) (layers "*.Cu" "*.Mask") (net 1 "GND"))',
        '		(pad "3" thru_hole circle (at -3.25 2.25 90) (size 1.5 1.5) (drill 1.0) (layers "*.Cu" "*.Mask") (net 15 "BTN_MODE"))',
        '		(pad "4" thru_hole circle (at 3.25 2.25 90) (size 1.5 1.5) (drill 1.0) (layers "*.Cu" "*.Mask") (net 1 "GND"))',
        '	)',
        '	(footprint "Button_Switch_THT:SW_PUSH_6mm"',
        '		(layer "F.Cu") (uuid "c1000000-0001-0000-0000-000000000035") (at 154 177 90)',
        '		(fp_text reference "KEY2" (at 0 -3.8 90) (layer "F.SilkS") (effects (font (size 0.8 0.8) (thickness 0.15))))',
        '		(fp_text value "SWING" (at 0 3.8 90) (layer "F.SilkS") (effects (font (size 0.7 0.7) (thickness 0.12))))',
        '		(pad "1" thru_hole circle (at -3.25 -2.25 90) (size 1.5 1.5) (drill 1.0) (layers "*.Cu" "*.Mask") (net 16 "BTN_SWING"))',
        '		(pad "2" thru_hole circle (at 3.25 -2.25 90) (size 1.5 1.5) (drill 1.0) (layers "*.Cu" "*.Mask") (net 1 "GND"))',
        '		(pad "3" thru_hole circle (at -3.25 2.25 90) (size 1.5 1.5) (drill 1.0) (layers "*.Cu" "*.Mask") (net 16 "BTN_SWING"))',
        '		(pad "4" thru_hole circle (at 3.25 2.25 90) (size 1.5 1.5) (drill 1.0) (layers "*.Cu" "*.Mask") (net 1 "GND"))',
        '	)',
        '	(footprint "Button_Switch_THT:SW_PUSH_6mm"',
        '		(layer "F.Cu") (uuid "c1000000-0001-0000-0000-000000000036") (at 162 177 90)',
        '		(fp_text reference "KEY3" (at 0 -3.8 90) (layer "F.SilkS") (effects (font (size 0.8 0.8) (thickness 0.15))))',
        '		(fp_text value "AUX" (at 0 3.8 90) (layer "F.SilkS") (effects (font (size 0.7 0.7) (thickness 0.12))))',
        '		(pad "1" thru_hole circle (at -3.25 -2.25 90) (size 1.5 1.5) (drill 1.0) (layers "*.Cu" "*.Mask") (net 17 "BTN_AUX"))',
        '		(pad "2" thru_hole circle (at 3.25 -2.25 90) (size 1.5 1.5) (drill 1.0) (layers "*.Cu" "*.Mask") (net 1 "GND"))',
        '		(pad "3" thru_hole circle (at -3.25 2.25 90) (size 1.5 1.5) (drill 1.0) (layers "*.Cu" "*.Mask") (net 17 "BTN_AUX"))',
        '		(pad "4" thru_hole circle (at 3.25 2.25 90) (size 1.5 1.5) (drill 1.0) (layers "*.Cu" "*.Mask") (net 1 "GND"))',
        '	)',
        '	(footprint "Rotary_Encoder:RotaryEncoder_Alps_EC11E-Switch_Vertical_H20mm"',
        '		(layer "F.Cu") (uuid "c1000000-0001-0000-0000-000000000037") (at 172 167)',
        '		(fp_text reference "SW1" (at 0 -7.5) (layer "F.SilkS") (effects (font (size 1 1) (thickness 0.15))))',
        '		(fp_text value "EC11" (at 0 7.5) (layer "F.SilkS") (effects (font (size 0.8 0.8) (thickness 0.12))))',
        '		(pad "A" thru_hole circle (at -2.5 7.5) (size 1.8 1.8) (drill 1.0) (layers "*.Cu" "*.Mask") (net 12 "ENC_A"))',
        '		(pad "C" thru_hole circle (at 0 7.5) (size 1.8 1.8) (drill 1.0) (layers "*.Cu" "*.Mask") (net 1 "GND"))',
        '		(pad "B" thru_hole circle (at 2.5 7.5) (size 1.8 1.8) (drill 1.0) (layers "*.Cu" "*.Mask") (net 13 "ENC_B"))',
        '		(pad "S1" thru_hole circle (at -2.5 -7) (size 1.8 1.8) (drill 1.0) (layers "*.Cu" "*.Mask") (net 14 "ENC_SW"))',
        '		(pad "S2" thru_hole circle (at 2.5 -7) (size 1.8 1.8) (drill 1.0) (layers "*.Cu" "*.Mask") (net 1 "GND"))',
        '		(pad "MP" thru_hole circle (at -7 0) (size 2.5 2.5) (drill 1.8) (layers "*.Cu" "*.Mask") (net 1 "GND"))',
        '		(pad "MP" thru_hole circle (at 7 0) (size 2.5 2.5) (drill 1.8) (layers "*.Cu" "*.Mask") (net 1 "GND"))',
        '	)'
    ])

    # Standard Ground Planes (polygon definition)
    # Notice: DO NOT include raw filled_polygon bounding boxes here!
    # EasyEDA Pro and KiCad recalculate filled_polygons dynamically with thermal reliefs when Shift+B is pressed.
    for layer in ["F.Cu", "B.Cu"]:
        uuid_s = "e1000000-0001-0000-0000-000000000001" if layer == "F.Cu" else "e1000000-0002-0000-0000-000000000002"
        lines.extend([
            f'	(zone (net 1) (net_name "GND") (layer "{layer}") (uuid "{uuid_s}")',
            '		(hatch edge 0.5)',
            '		(connect_pads (clearance 0.3))',
            '		(min_thickness 0.25)',
            '		(filled_areas_thickness no)',
            '		(fill yes (thermal_gap 0.3) (thermal_bridge_width 0.4))',
            '		(polygon',
            '			(pts',
            '				(xy 100 100) (xy 185 100) (xy 185 185) (xy 100 185)',
            '			)',
            '		)',
            '	)'
        ])

    lines.append(')')

    pcb_path = os.path.join(PCB_DIR, "fan_ctrl_revA.kicad_pcb")
    with open(pcb_path, "w", encoding="utf-8") as f:
        f.write("\n".join(lines))
    print(f"Successfully generated clean {pcb_path} ({len(lines)} lines)")

if __name__ == "__main__":
    generate_pcb()
