Lucian-ming/smart-fans/tools/optimize_fan_ctrl_revB_layout.py

"""
Script: tools/optimize_fan_ctrl_revB_layout.py
Calculates and verifies 100% collision-free layout for fan_ctrl_revB.
"""

import math

BOARD_W = 98.0
BOARD_H = 98.0

# 4 Corner Mounting Holes (M3, Pad diameter 6.0mm, Keepout diameter 9.0mm)
HOLES = [
    {"name": "H1", "x": 5.0, "y": 5.0, "r": 4.5},
    {"name": "H2", "x": 93.0, "y": 5.0, "r": 4.5},
    {"name": "H3", "x": 5.0, "y": 93.0, "r": 4.5},
    {"name": "H4", "x": 93.0, "y": 93.0, "r": 4.5}
]

# Physical Modules & Components with their REAL 3D Physical Envelopes (w, h in mm)
# Not just socket size, but the REAL physical board that plugs into the socket!
modules = [
    # Top Power & Actuator Layer (Y: 6 ~ 26)
    {"id": "DC1", "name": "DC-005 12V电源座", "x": 15.0, "y": 10.0, "w": 9.5, "h": 14.0},
    {"id": "D2", "name": "SS24 防反接", "x": 23.5, "y": 10.0, "w": 4.5, "h": 3.0},
    {"id": "C1", "name": "100uF 25V电解", "x": 29.5, "y": 10.0, "w": 6.0, "h": 6.0},
    {"id": "C2", "name": "100nF 0805", "x": 35.0, "y": 10.0, "w": 2.5, "h": 2.0},
    {"id": "U2", "name": "XL1509-5.0 芯片", "x": 42.0, "y": 10.0, "w": 6.0, "h": 5.5},
    {"id": "D1", "name": "SS24 续流", "x": 48.5, "y": 10.0, "w": 4.5, "h": 3.0},
    {"id": "L1", "name": "47uH CD54电感", "x": 56.0, "y": 10.0, "w": 6.5, "h": 6.0},
    {"id": "C3", "name": "220uF 16V电解", "x": 64.0, "y": 10.0, "w": 7.0, "h": 7.0},
    {"id": "C4", "name": "100nF 0805", "x": 70.5, "y": 10.0, "w": 2.5, "h": 2.0},
    {"id": "U3", "name": "AMS1117-3.3", "x": 76.5, "y": 10.0, "w": 7.0, "h": 4.5},
    {"id": "C5", "name": "10uF 0805", "x": 83.0, "y": 8.0, "w": 2.5, "h": 2.0},
    {"id": "C6", "name": "10uF 0805", "x": 83.0, "y": 12.0, "w": 2.5, "h": 2.0},
    {"id": "LED_PWR", "name": "5V/3.3V指示灯", "x": 88.0, "y": 10.0, "w": 4.0, "h": 6.0},

    # Row 2: Actuators & Beep (Y: 20 ~ 28)
    {"id": "MOTO1", "name": "130电机接口", "x": 15.0, "y": 22.0, "w": 6.0, "h": 6.0},
    {"id": "SERVO1", "name": "MG90S舵机针座", "x": 25.0, "y": 22.0, "w": 8.0, "h": 4.0},
    {"id": "BZ1", "name": "5V蜂鸣器模块", "x": 37.0, "y": 22.0, "w": 12.5, "h": 12.5},
    {"id": "SPK1", "name": "喇叭接口", "x": 75.0, "y": 22.0, "w": 6.0, "h": 6.0},
    {"id": "MIC1", "name": "咪头接口", "x": 85.0, "y": 22.0, "w": 6.0, "h": 6.0},

    # Middle Layer: Core Processing & Driver Modules (Y: 34 ~ 68)
    # TB6612 module: 21.5mm wide x 19.0mm high
    {"id": "TB6612", "name": "TB6612电机驱动板", "x": 18.0, "y": 42.0, "w": 22.0, "h": 20.0},
    # DHT11 module: 16mm wide x 12mm high
    {"id": "DHT11", "name": "DHT11温湿度模块", "x": 18.0, "y": 59.0, "w": 16.0, "h": 13.0},
    # STM32 Blue Pill: 53.0mm high x 22.8mm wide (Centered)
    {"id": "STM32", "name": "STM32最小系统蓝板", "x": 48.0, "y": 48.0, "w": 23.0, "h": 53.0},
    # ASR-PRO Voice Board: 30.0mm wide x 28.0mm high
    {"id": "ASR_PRO", "name": "ASR-PRO语音板", "x": 78.0, "y": 45.0, "w": 30.0, "h": 28.0},

    # Front Layer: 2-Row Ergonomic Interactive Layout (Y: 72 ~ 90)
    # Upper Row (Visual & Gesture):
    # PAJ7620 Gesture: 20.0mm wide x 15.0mm high
    {"id": "GESTURE", "name": "PAJ7620手势模块", "x": 22.0, "y": 74.0, "w": 20.5, "h": 15.5},
    # 0.96" OLED: 27.5mm wide x 27.0mm high
    {"id": "OLED", "name": "0.96寸OLED屏", "x": 76.0, "y": 72.0, "w": 28.0, "h": 27.0},

    # Lower Row (Physical Touch & Knobs):
    # Button 1 (Power): 13.5mm wide x 19.6mm high
    {"id": "KEY1", "name": "按键1【电源开关】", "x": 14.0, "y": 88.0, "w": 14.0, "h": 19.6},
    # Button 2 (Swing/Mode): 13.5mm wide x 19.6mm high
    {"id": "KEY2", "name": "按键2【摇头模式】", "x": 32.0, "y": 88.0, "w": 14.0, "h": 19.6},
    # 360° Rotary Encoder Module: 26.0mm wide x 19.0mm high
    {"id": "ENCODER", "name": "360°旋转编码器", "x": 56.0, "y": 88.0, "w": 26.0, "h": 19.0}
]

def check_collisions():
    collisions = []
    
    # 1. Check pair-wise component bounding box collision
    n = len(modules)
    for i in range(n):
        for j in range(i + 1, n):
            m1 = modules[i]
            m2 = modules[j]
            
            dx = abs(m1["x"] - m2["x"]) - (m1["w"] + m2["w"]) / 2.0
            dy = abs(m1["y"] - m2["y"]) - (m1["h"] + m2["h"]) / 2.0
            
            if dx < 0 and dy < 0:
                overlap_x = -dx
                overlap_y = -dy
                collisions.append(f"OVERLAP: {m1['id']} and {m2['id']} overlap by X:{overlap_x:.2f}mm, Y:{overlap_y:.2f}mm")
            elif dx < 1.0 and dy < 1.0:
                collisions.append(f"WARNING: {m1['id']} and {m2['id']} clearance < 1.0mm (dx:{dx:.2f}, dy:{dy:.2f})")

    # 2. Check collision with mounting holes
    for m in modules:
        for h in HOLES:
            # Distance from component center to hole center
            dist = math.hypot(m["x"] - h["x"], m["y"] - h["y"])
            # Effective radius of component bounding box
            eff_r = math.hypot(m["w"]/2.0, m["h"]/2.0)
            # Box-circle intersection test
            # Find closest point on box to circle center
            cx = max(m["x"] - m["w"]/2.0, min(h["x"], m["x"] + m["w"]/2.0))
            cy = max(m["y"] - m["h"]/2.0, min(h["y"], m["y"] + m["h"]/2.0))
            box_dist = math.hypot(h["x"] - cx, h["y"] - cy)
            
            if box_dist < h["r"]:
                collisions.append(f"HOLE COLLISION: {m['id']} collides with {h['name']} by {h['r'] - box_dist:.2f}mm")
            elif box_dist < h["r"] + 1.0:
                collisions.append(f"HOLE WARNING: {m['id']} close to {h['name']}, clearance: {box_dist - h['r']:.2f}mm")

    # 3. Check board edge clearance
    for m in modules:
        x_min = m["x"] - m["w"]/2.0
        x_max = m["x"] + m["w"]/2.0
        y_min = m["y"] - m["h"]/2.0
        y_max = m["y"] + m["h"]/2.0
        
        if x_min < 1.5 or y_min < 1.5 or x_max > BOARD_W - 1.5 or y_max > BOARD_H - 1.5:
            collisions.append(f"EDGE OVERFLOW: {m['id']} out of bounds! [X: {x_min:.1f}~{x_max:.1f}, Y: {y_min:.1f}~{y_max:.1f}]")

    print(f"Total Components Checked: {len(modules)}")
    if not collisions:
        print(">>> 100% PASS! ZERO COLLISIONS! ALL MODULES HAVE > 1.5mm MARGIN! <<<")
    else:
        print(f">>> FOUND {len(collisions)} ISSUES: <<<")
        for c in collisions:
            print("  *", c)

if __name__ == "__main__":
    check_collisions()
