Lucian-ming/smart-fans/(commit log)

2026-11-03 chore: 初始化智能风扇项目骨架
    - 文档：需求、架构、引脚表、功耗预算、路线图、装配/打印/日志规范
    - 固件：STM32F103C8T6 骨架（72MHz 时钟、UART1 日志、GPIO、pins.h）
    - 硬件：KiCad 工程约定、数据手册与生产文件目录
    - 机械：CAD/STEP/STL/打印配置目录
    - 参考：references/ 分类存放语音、手势、OLED 等参考例程
    - 支持温度自动控制、语音、手势、按键/旋钮与 OLED 显示
2026-11-11 feat: 提交智能风扇项目全部源码、文档与设计交付物
    - 固件: STM32F103 主控、驱动层、风扇状态机、HAL 配置与 CMake 构建
    - 硬件: 原理图/PCB、BOM、Gerber、引脚映射、电源预算等设计文档
    - 机械: 外壳设计、STL/STEP 打印件与概念方案
    - 文档: 路线图、需求、架构、评审记录与交付报告包
    - 工具链与参考例程, 以及归档的历史版本(RevA)
    .gitignore 排除超出 GitHub 单文件 100MB 上限的第三方安装包
    (天问Block IDE、KiCad 安装程序) 与固件构建产物。
    [BOM_44项.csv, BOM_LCSC_1Click_Order.csv, BOM_LCSC_1Click_Order.xlsx, BOM_SmartFan_RevA.csv, BOM_SmartFan_RevA.xlsx, BOM_SmartFan_RevB.xlsx, BOM_毕设-智能语音风扇.xlsx, Base_CONCEPT.stl]
2026-11-11 fix: 将 AbenFan 参考仓库作为普通文件纳入版本管理
    原先 references/02_aben_fan_pro/firmware/AbenFan 内含独立 .git 目录，
    被 git 记录成未声明 .gitmodules 的 gitlink，推送后内容不会真正上传。
    移除内嵌 .git 后按普通目录提交，与 references/ 下其他参考例程保持一致。
    [default_16MB.csv, default_8MB.csv, minimal.csv]
